Able-Digital-Logic/UnintendedAntennaClub3/Hardware/RFVD_SENSOR_BOARD_Rev6/docs/CRITIQUE_STATUS.md

# Critique status: every P0 and P1 finding (updated 2026-10-04, checkpoint 5 and the placement sign-off)

> Designators in this dated record predate ECO-003 (2026-10-07). Look up the current ones in [`REFERENCE_MAP_ECO-003.md`](REFERENCE_MAP_ECO-003.md).

The critique of 2026-10-03 (19 lenses, every finding independently verified) produced 8 P0 items (critical or high, must be fixed before fab) and 32 P1 items (medium). The goal's first done-criterion: each is **fixed** or **documented** (with a reason and an owner). This table is the single place to check that.

Status words:
- **Done**: fixed and landed on the master, with the checkpoint named.
- **Built**: fixed in a gated scratch package, waiting to land with the named checkpoint.
- **Planned**: assigned to a later package with a defined fix.
- **Documented**: the finding needs no board change, or the decision and its reason are recorded.
- **Lead**: needs a lead action, listed in `LEAD_GUI_STEPS.md` or in the summary.

## P0 (critical / high)

| ID | Finding | Status | Where |
|---|---|---|---|
| P0-1 | JLC BOM/CPL and the DNP flags | **Done** (cp1) | DNP fields cleared; C100/R109 back in the BOM; BOM and CPL regenerated by every `make_outputs.py` run, with JLC rotation corrections |
| P0-2 | Every part in stock for 2 boards | **Done** (cp4a sourcing + cp4b2 consolidation; live check 2026-10-04) + **Lead** (L1 and J8 ordering route) | 100 lines / 309 parts, each with MPN and LCSC. Live stock for 2 boards: 95 lines from JLC assembly stock. J8, OPA2320, AD7380 and the 47R arrays come from LCSC's warehouse via a JLC parts pre-order (5,567 / 1,485 / 78 / 14,550). **L1 XGL4020-472MEC: JLC 1, LCSC 0, not at Mouser**, so only the Global Sourcing route (lead decision 2026-10-04) covers board 2. Evidence: `04_parts/snapshots/jlc_stock_cp5_2026-10-04.json`, `LAYOUT_STATUS.md` cp5 |
| P0-3 | Battery deep-discharge protection | **Done** (docs and firmware) | Mandatory pack spec in J2's Function field and `07_manufacturing/REV_A_PURCHASE_LIST.md`; firmware cut-offs in `05_firmware/FIRMWARE_CONTRACT.md` §5 |
| P0-4 | Overlapping EXP_FAULT_N drills | **Done** (cp1) | |
| P0-5 | Side-aware courtyard exemptions and neck caps | **Done** (rules, cp3; exposed copper, cp4a-cp5) | `dru_sideaware.py` split + `v11_neck_len_*` + `tools/necks.py`. The 115 width + 61 neck errors exposed at cp3 are fixed: DRC 0 errors and 0 neck chains at cp5 |
| P0-6 | EXP_VHP OVLO overlapped VSYS | **Done** (cp2a) | R409 64.9k: trip 9.43–10.28 V, above VSYS 8.77 V (PWM) / 9.05 V (PFM, disabled by firmware) |
| P0-7 | Finish routing; SD skew | **Documented / Lead** (cp5); SD skew **Done** (cp2b) | 524 / 566 routed. The 42 open links have 0 blocked: each has a legal path and a hand-off via in `ROUTING_FINISH_GUIDE.md` §0, for the lead's push-and-shove pass (the footprints are locked) |
| P0-8 | Version control and one master | **Documented / Lead** | Branch `rev-a-layout`, commit `3d8a2bd` (m17). The handoff folder is the master. Each further commit or a remote/push needs the user's OK |

## P1 (medium)

| ID | Finding | Status | Where |
|---|---|---|---|
| P1-1 | Firmware contract rev 2 | **Done** | `05_firmware/FIRMWARE_CONTRACT.md` rev 2; §7 backlight rewritten for the kept CCRs with a VSYS duty cap (2026-10-04). Unused pins: `FIRMWARE_NOTES.md` §2 |
| P1-2 | Return GND vias (R17) | **Done** (cp4a-cp5: failures 45 → 7) + **Documented** | The 7 left are at the dense U8 west row, where no legal GND via site exists (LAYOUT_STATUS cp5) |
| P1-3 | BQ25798 hot loop and GND | **Done** (cp4a, option A / D19) | Hot-loop GND vias at U301; the SYS / PMID 0.1 uF caps sit at the ends of the pin column (`PLACEMENT_DATASHEET_CHECK.md`) |
| P1-4 | Unfused PACK+ run | **Done** (cp4b1, D18) | F1 on its Bourns Style 2 land at J2 ((163.05, 126.80) r90 B); PACK_RAW is a 1.0 mm B-only run with no via. The Style 2 footprint has no 3D model yet |
| P1-5 | BQ29209 Kelvin sense | **Done** (cp2a) | R315 at J2.1; `v10_pack_raw_kelvin` rule; PACK_RAW back in Power_Battery |
| P1-6 | Power copper on In3; VSYS/VBUS necks | **Done** (rules, cp3; copper, cp4a-cp5) | In3 power width rules in v11; battery trunks 0.8 mm on In3; neck chains 46 → 0 |
| P1-7 | Foreign copper under J10; SWD route | **Done** (cp4b4) | The U403 cluster moved to F beside U701 (DRU side-guard patch d9); its nets and SWD left the J10 courtyard: the 32 `items_not_allowed` errors went to 0 |
| P1-8 | MR-kill jumpers short GPIOs | **Done** (cp2b, S-13) | JP401/JP402 and their copper removed; R402/R407 kept |
| P1-9 | Silkscreen labels, board ID, minimums | **Done** (cp1 + cp2b) + **Lead** (GUI row 3) | cp2b: B silk `${ISSUE_DATE}` and a 6 × 4 mm S/N box; all 7 visible texts 1.0 / 0.15. Footprint silk lines stay 0.12 mm (library parity; see P2) |
| P1-10 | Panel, fab spec, fab script | **Done** (2026-10-04) | `tools/make_panel.py`, `tools/make_fab_outputs.py`, `docs/MANUFACTURING_EMC_SPEC.md`, `docs/fab_notes.txt`. JLC panelises only rectangles and round boards, so we supply our own panel. D27: the 72 × 90 mm 1-up frame, because JLC counts the PCBA minimum per panel and the plan is 2 populated boards. Panel DRC 0 new; CPL cross-check 0 mismatches |
| P1-11 | CPL rotations | **Done** (tools) + order-time check | `tools/jlc_rotations.csv` applied by `make_outputs.py` (33 parts corrected); check pin 1 / polarity in JLC's preview with "confirm parts placement" |
| P1-12 | Solder mask 0; J10 pin-in-paste | **Done** (J10 board copy, cp2b; mask 0, cp3) + **Lead** (GUI row 4 mirrors J10 into the library) | |
| P1-13 | Stackup and fab flags | **Done** (fab note on User.Drawings, cp2b; order remarks in `MANUFACTURING_EMC_SPEC.md` §6) + **Lead** (GUI rows 1–2) | |
| P1-14 | Sign-off sentinel | **Done** | H1 assertion sentinel; drcsum flags TRUNCATED at 199 |
| P1-15 | EXP_SYNC class and frequency | **Done** (frequency: FIRMWARE_NOTES §1, R434; class HighSpeed_Clock, cp3; J11-end fix, cp4a) + **Lead** (route: `ROUTING_FINISH_GUIDE.md` §0) | |
| P1-16 | Missing and stale rule areas | **Done** (cp3) | K6, K8, K21, K11 shift, K19a/b, K19c removed |
| P1-17 | AFE shield can | **Documented** (no can on Rev A) + **Done** (D16 GND ring, cp4a) | 1.0 mm F.Cu band under a mask-open strip, 19 fence vias, FL1 on the east wall. The south wall stays open over 5.6 mm (accepted, LAYOUT_STATUS cp5) |
| P1-18 | J1 input limit on record | **Done** (J1 Function field) | The calibration-plan IDs (FW-19b soak, FW-CAL-11 overload) belong to the team's calibration plan, which is not in this repository |
| P1-19 | Edge stitching | **Done** (cp4a) | 31 edge-stitching vias |
| P1-20 | FMC series resistors by pin side | **Done** (cp2b) | RN203 south row, RN201 D0/D1, R213 100R on D/C |
| P1-21 | PSRAM double termination | **Done** (cp2b, S-17) | RN60; SI re-run passes |
| P1-22 | ADC3 re-map, ROM-boot SPI1 | **Done** (cp2a) | R601 10k on PA4; EXP_ANA_MON on PC0 |
| P1-23 | LMR43620 FB detect margin | **Done** (cp2a) | 23.2k/10k |
| P1-24 | Locks before shove routing | **Done** (footprints, cp5) + **Lead** (tracks and vias) | All 341 footprints locked (cp5). Lock the tracks and vias after the hand routing |
| P1-25 | C106/C24 courtyard overlap | **Done** (cp2a) | |
| P1-26 | EXP interrupts without pull-ups | **Done** (cp2b) | R441/R442 10k (Basic) to +3V3_EXP |
| P1-27 | ESD array NC pins block flow-through | **Done** (cp2b), MISO leg documented | 14 NC pins tied, 10 lines straight on B. MISO TVS → R423 0.6 mm and IO0 In3 crossing remain (S-21 optional) |
| P1-28 | Display back-power and C68 | **Done** (cp2a, S-11/S-12) | Firmware sequencing in the contract §7 |
| P1-29 | VSYS divider → BQ ADC; VBAT_RTC | **Done** (cp2a, S-5) + **Lead** (VBAT_RTC route: `ROUTING_FINISH_GUIDE.md` §0) | |
| P1-30 | Runtime target | **Documented** (D26) | The bay limits the pack to 53 × 56 × 9.0 mm, about 27 cm³. A 2S Li-ion pack that size holds roughly 8–12 Wh, so the ≥ 16 Wh option of D26 does not fit. At the 0.96–1.79 W RECORD budget, about 8–9 Wh gives about 5–9 h. **8 h holds only at the low-power end.** Set the formal target after the per-rail measurement on unit 1 (firmware contract: RECORD at 400 MHz VOS1). |
| P1-31 | Display SPI option documented with wrong pins | **Done** (docs, 2026-10-04) | ROUTING_FINISH_GUIDE and LAYOUT_STATUS: SPI marked rejected (D13), correct pins recorded |
| P1-32 | Open routing-guide decisions | **Done** | TP9 deleted (S-10), EXP_ANA_MON on PC0 (S-5), C908 deleted (S-9); pre-defined sizes and the LCD stub rule are in cp3 |

## P2 (low)

The P2 items are polish. Those that come free with the work above are taken there: mask 0, rule housekeeping, silk line width. The rest are listed in the critique synthesis, §2 "P2". Not done, by choice: footprint silk lines stay at the KiCad library's 0.12 mm (JLC's minimum is 0.15 mm). Widening them on the board would break library parity for about 300 footprints. Reference designators are hidden, polarity marks are also on the fab layers, and the CPL is checked in JLC's preview.
