Able-Digital-Logic/UnintendedAntennaClub3/Hardware/RFVD_SENSOR_BOARD_Rev6/docs/DATASHEET_CHECKS.md

# Datasheet checks, Rev A

This file records that every IC and active part on the board has been checked against its manufacturer datasheet. Each row names:
- the document and revision;
- the page, figure or table used;
- what was compared;
- the result.

## How the checks were done
- **Critique, 2026-10-03.** One reviewer per schematic sheet checked each part against the datasheet:
  - every pin against the datasheet pin table;
  - the footprint against the recommended land pattern;
  - every value against the datasheet equations and the application circuit;
  - every rating against the worst case on this board.

  Two more reviews covered the whole board: a pin-map review of U401 against ST's pin database, DS12110 and the IBIS model, and a power-tree review of every rail. Every finding was then re-checked by an independent verifier.
- **Checkpoint 2, 2026-10-04.** Every value the simplifications changed was re-derived from the same datasheet (section 3).
- **Remaining parts.** Connectors J1401/J1101, inductor L1101, fuses F1401/F801, the B3U switches, the RN arrays and the ferrites were checked separately (section 4).
- **What the data is compared against.** Pins and nets come from `kicad-cli sch export netlist`. Pads come from the board file.

"Pass" means the item matches the datasheet. Findings carry their critique ID and say where they went (fixed in a checkpoint, firmware contract, lead decision).

The basis is checkpoint 2b (landed 2026-10-04, board sha256 `f539f0317c`). Rows that changed in 2b say so, and section 5 checks the parts 2b added.

## 1. Summary

| Sheet | Parts checked | Wrong pin maps | Wrong land patterns | Rating problems |
|---|---|---|---|---|
| RF input and detector | U701, U702, FL701, D701, D702, J702, J701 | 0 | 0 | J702 input limit (lead decision D17) |
| Battery and power | U1301, U201, L1301, FB1301 | 0 | 0 | 0 |
| Analog acquisition | U502, U501, U503, D1001 | 0 | 0 | 0 |
| External ADC | U1001 | 0 | 0 | REFIO contention, removed by S-26 |
| STM32H743 controller | U401, Y401, Y402 | 0 | 0 | 0 |
| SD and capture memory | J601, U602, D4–D10 | 0 | 0 | 0 |
| Screen and controls | J801, J802, U801, Q802–Q803, D801–D804, RN801–RN803 | 0 | 0 | 0 |
| Battery, charger and USB-C | U1101–U1102, Q1402–Q1401, D1101, F1401, L1101, J1401, J1101 | 0 | 0 | see section 4 |
| Expansion mezzanine | J1201, U1501–U1201, D1201–D1204 | 0 | 0 | U1502 OVLO, fixed in checkpoint 1 |
| Temperature monitor | U302, U301, U702@pre-ECO003 | 0 | 0 | 0 |
| Programming and service | J901, SW801–SW1101 | 0 | 0 | B3U minimum current (S-16) |

Placement against each datasheet's layout guide is checked separately, on the board itself: `docs/PLACEMENT_DATASHEET_CHECK.md` (generated by `tools/dsgap.py`). It found 269 budgets, 264 within budget and 5 over with measured reasons.

No pin-map error was found on any part. All functional defects found against the datasheets are listed in section 2 with their fix.

## 2. Per-sheet records

### RF input and detector
| Ref | Part | Datasheet | Checked | Result |
|---|---|---|---|---|
| U702 | ADL5511ACPZ-R7 | ADI ADL5511 Rev D: Table 3 p.8 (pins), CP-16-22 p.27 (package), Fig. 49 and Table 5 (decoupling); Rev E Table 3 p.8 (ENBL ramp) | Pins 1–16 + EP: FLT3=1, RFIN=2, FLT1=3, ENBL=4, COMM=5, NC 6/7/8/12/13 open, EREF=9, VENV=10, VRMS=11, FLT4=14, VPOS=15, FLT2=16, EP=GND. RFIN AC-coupled on both paths (C708; C707 behind R701). FLT1 (C703) returns to GND; FLT2/3/4 (C705/C706/C710) return to VPOS. VPOS has 100 pF + 100 nF + 1 µF. VPOS = 4.99 V (LT3045, R203 49.9k) is inside 4.75–5.25 V. | Pass |
| U701 | TLV809EA46DBZR | TI TLV809E §5 (DBZ pinout), §7.5 (VIT-, delay, VOH) | DBZ pinout 1 GND, 2 RESET, 3 VDD matches symbol and SOT-23-3. Push-pull output, 200 ms delay, VIT- 4.63 V. VOH ≥ 0.8·VDD meets ENBL ≥ 3.6 V and ENBL ≤ VPOS. | Pass. U701 stays: ADL5511 Rev E Table 3 p.8 needs a < 20 ms ramp if ENBL is tied to VPOS, and the LT3045 rail takes about 55 ms (S-1 rejected). |
| D701, D702 | PESD5V0H1BSF | Nexperia PESD5V0H1BSF §12, Fig. 14 | Land 0.20 × 0.28 mm at 0.4 mm pitch, 0.256 mm paste | Pass |
| FL701 | NFM18PC104R1C3D | Murata NFM18PC | 16 V / 2 A rating against +5V_RF (about 25 mA) | Pass |
| J702, J701 | U.FL-R-SMT-1(80) | Hirose U.FL | Footprint and signal/ground pads | Pass |
| R703, R704 | 0402 attenuator | — | 50 mW each at +20 dBm CAL input, against a 100 mW rating | Pass |

**Findings**
- RF-01: the input limit is set by R706/R702 dissipation, at about 29.5 Vpk CW. The ADL5511 RFIN absolute maximum is reached at about 38.9 Vpk. **Lead decision D17:** the input limit is 22 Vpk CW at 128 MHz with no 40 Vpk soak, labelled model-derived until bench test X10.
- AIMD/CAL silkscreen labels were added in checkpoint 1.

### Battery and power
| Ref | Part | Datasheet | Checked | Result |
|---|---|---|---|---|
| U1301 | LMR43620MB5RPER | TI SNVSBY5B Rev B: Table 6-1 (pins), RPE0009B land p.51, Eq. 5 and Eq. 9, Table 9-1 | **Pins:** match Table 6-1.<br>**Footprint:** TI_RPE0009B matches the p.51 land (pin-1 L-pad, GND bar offset 0.55 mm, pin centres ±0.9 mm).<br>**Feedback (checkpoint 2a, P1-23 / D24):** R1301/R1302 = 23.2k/10k → 3.320 V. RFBT‖RFBB = 6.99 kΩ, mid-window of the 5–10 kΩ detection window; the old 33.2k/14.3k sat at its 10 kΩ edge. CFF C41 22 pF puts the zero at 312 kHz, which satisfies Eq. 9.<br>**Supporting parts:** CBOOT 100 nF 25 V. CVCC 1 µF. EN tied to VIN and PGOOD open are both allowed by Table 6-1.<br>**Timing and capacitors:** fSYNC 833 kHz is inside 0.2–2.5 MHz, with no spread spectrum on MB5. tON at 8.4 V is about 474 ns, against a 75 ns minimum. Input 2 × 10 µF + 100 nF, against a 4.7 µF minimum. Output 2 × 22 µF. | Pass |
| L1301 | XGL4020-472MEC | Coilcraft Doc 1529-1 | 4.7 µH. Ripple 0.38–0.51 A is 19–26 % of 2 A, above the 10 % floor. Isat 3.0 A (the old note said 4.8 A; corrected). | Pass. JLC does not stock it; bought by Global Sourcing (lead decision 2026-10-04). |
| U201 | LT3045EMSE#PBF | ADI LT3045 Rev B: Pin Functions, p.18 | **Pins:** match the MSE-12 Pin Functions table.<br>**Output and limit:** 100 µA × 49.9k = 4.99 V. ILIM 1k sets 150 mA.<br>**PGFB tied to IN:** allowed.<br>**Capacitors:** output ≥ 10 µF low-ESR. Input meets the 4.7 µF minimum. R201 1 Ω falls in the p.18 0.1–0.5 Ω stabiliser range. The SET capacitor C510 is film, which avoids the piezo effect described on p.18.<br>**Load:** about 25 mA on +5V_A, about 0.1 W dissipation. | Pass |
| FB1301 | BLM18AG601SN1D | Murata BLM18AG | 500 mA, DCR 0.38/0.48 Ω, against the +3V3_A load of about 20 mA | Pass (section 4 repeats it with loads) |

**Findings**
- PWR-01: fitted C1315/R1307 were missing from the JLC BOM. Fixed in checkpoint 1.
- L1301 and U1301 stock: Global Sourcing (lead decision).
- C27 VSYS polymer deleted: S-8, checkpoint 2a.
- Stale sheet notes are still open on the 2a candidate: Power says "1 MHz forced PWM", "L1301 saturation 4.8 A at 20%" and "charger is external". They are fixed in the notes package after 2b (section 6).

### Analog acquisition
| Ref | Part | Datasheet | Checked | Result |
|---|---|---|---|---|
| U502, U501 | OPA2320AIDGKR | TI SBOS513F: p.5 (DGK pinout), §7.3.2 (input current), §7.3.7 (Ro 90 Ω), §7.3.8 (cap load) | **Pins:** 1–8 match DGK on a VSSOP-8 footprint.<br>**Stability:** macro-model (20 MHz GBW, Ro 90 Ω) with the real loads gives 61–67° phase margin. The same model gives 9–17° for a bare 1 nF, matching §7.3.8.<br>**Input current with +3V3_A off:** < 1 mA through 4.52k, against the 10 mA absolute maximum.<br>**Checkpoint 2a (S-27):** U3B drives EREF_BUF; U3A is a follower on EREF_FILT (both +IN on R506 22.6k / C506 10 nF, a 704 Hz pole). The input stays inside the rail-to-rail common-mode range. | Pass |
| U503 | REF5030IDR | TI SBOS410O (Oct 2025): Fig. 5-1, §8.3.6, §8.4.1, §9.4.1.1 | **Pins:** DNC 1/8 and NC 7 open, TEMP open, TRIM/NR to the 1 µF film C510.<br>**Input:** VIN 5 V ≥ VOUT + 0.2 V; C509 1 µF + C508 100 nF.<br>**Output:** C511 4.7 µF via R508 1 Ω (ESR ≤ 1.5 Ω per §8.4.1). The HF capacitors are allowed by §9.4.1.1.<br>**Limit:** VREF+ 3.0 V ≤ VDDA 3.3 V. | Pass. Original kept, bought by Global Sourcing. |
| D1001 | PMEG6030EP | Nexperia PMEG6030EP (Nov 2017), Table 7 | K on +3V3_A, A on +3V0_REF. VF ≤ 330 mV at 0.1 A, so VREF+ − VDDA stays at or below about 0.3 V. | Pass |
| Filter | R501/R502/R503/R504, C501/C503/C502 and VENV chain | — | Unity-gain Sallen-Key, 2.26k/2.26k with 510 pF/470 pF, then 1.33k/1.33k with 1.2 nF/470 pF: f0 143.8 kHz Q 0.521 and 159.3 kHz Q 0.799. −3 dB at 99.4 kHz, −36.0 dB at 416.7 kHz, 0.84 % overshoot. | Pass. C501 stays at 510 pF (lead decision). |
| ADC pins | R507/R505 33 Ω, C507/C505 2.2 nF C0G | STM32 DS12110 | PC4 = ADC12_INP4, PA6 = ADC12_INP3, so ADC1/ADC2 can convert simultaneously. τ = 72.6 ns; all four RC branches identical (S-3, checkpoint 2a). | Pass |

### External ADC
| Ref | Part | Datasheet | Checked | Result |
|---|---|---|---|---|
| U1001 | AD7380BCPZ-RL7 | ADI AD7380/AD7381 Rev A (11/2019): Fig. 8 / Table 7 p.9 (pins), CP-16-45 p.31 (package), Table 7 / Fig. 31 (decoupling), Table 3 (common-mode), Tables 4 and 12 (timing) | **Pins:** 1 GND, 2 VLOGIC, 3 REGCAP, 4 VCC, 5 AINB-, 6 AINB+, 7 AINA-, 8 AINA+, 9 REFCAP, 10 GND, 11 REFIO, 12 CS, 13 SDOA, 14 SDOB/ALERT (open), 15 SDI, 16 SCLK, EP 17 = GND.<br>**Footprint:** custom TQFN-16, counter-clockwise from pin 1. 0.5 mm pitch, 0.25 mm pads, 1.23 mm EP land (EP 1.10 nom / 1.20 max), about 66 % paste.<br>**Decoupling:** REFIO 1 µF, REFCAP 0.1 µF, REGCAP 1 µF; VCC and VLOGIC 1 µF each.<br>**Inputs:** common mode about 0.55 V on channel A and 1.1–2.1 V on channel B, inside 0.2 V to VREF − 0.2 V.<br>**Timing:** 1-wire mode with CRC, 40–44 SCLK at 40 MHz = 1.0–1.1 µs inside the 1.2 µs frame. | Pass |

**Findings**
- EXTADC-01: REFIO contention. The internal 2.5 V buffer fought the REF5030 through 33 Ω until firmware set REFSEL. **Removed by S-26 (lead decision D5), checkpoint 2a:**
  - the AD7380 uses its internal reference: R107 and TP20 deleted, R1006 = 100 Ω;
  - firmware REFSEL = 0 (FIRMWARE_CONTRACT §3);
  - the VENV range becomes ≤ 2.5 V, which still covers 14 Vpk at J702.
- R105 deleted (S-4); firmware sets IOSWP = 1 for the swapped SPI4 pins.
- R1007 placement at SDOA: P2 EXTADC-03, a routing package.

### STM32H743 controller
| Ref | Part | Datasheet | Checked | Result |
|---|---|---|---|---|
| U401 | STM32H743VIT6 | ST DS12110 Rev 10/11: Fig. 5 (LQFP100), Table 9 note 8, Table 23 note 4, Table 25 (VCAP), Fig. 15 (decoupling), Fig. 23 (NRST), Fig. 42 (VDDA/VREF+), Table 42 (HSE bypass), Table 45 (LSE), AF tables; ST pin database XML; IBIS | **Pins:** all 100 match. LQFP100 has no VDDLDO/VDD33USB/PDR_ON pins (tied internally).<br>**Decoupling and reset:** five VDD pins with 100 nF + bulk. VCAP 2 × 2.2 µF. VDDA and VREF+ each 100 nF + 1 µF. NRST 100 nF at 0.92 mm. BOOT0 10k at 0.10 mm.<br>**Peripherals:** every peripheral pin has its alternate function: FMC, SPI4 (IOSWP), SDMMC1, QUADSPI BK1, OTG_FS, I2C1/I2C2.<br>**Timer:** TIM1 at 240 MHz / 288 gives 833.33 kHz for both CS and BUCK_SYNC. | Pass |
| Y401 | ASE-12.000MHZ-LC-T | Abracon ASE | Pad map 1 OE (tied to +3V3_D), 2 GND, 3 OUT, 4 VDD matches the land. Bypass drive to PH0 through 33 Ω; 4–50 MHz allowed by Table 42. | Pass |
| Y402 | SC-16S 32.768 kHz 7 pF | SII SC-16S | CL 7 pF, R706 ≤ 90 kΩ, C0 1.2 pF. gm_crit = 1.03 µA/V needs LSEDRV = 10 (1.7 µA/V, Table 45); set in FIRMWARE_CONTRACT §1. Pads match; no foreign B.Cu copper under it. | Pass |

**Findings**
- PE15/PH1 MR-kill jumpers short GPIOs to GND: S-13, deletes JP401/JP402 **(done in checkpoint 2b)**.
- Firmware assumptions were collected into FIRMWARE_CONTRACT rev 2: clock tree, LSEDRV, IOSWP, REFSEL, USB sequencing.
- EXTI3 clash between RECORD_N and LID_INT: removed by S-24, LID_INT deleted **(done in checkpoint 2b)**.
- EXP_ANA_MON moved from PA4 to PC0, with a PA4 10k pull-up R403 (S-5 / P1-22, checkpoint 2a).

### SD and capture memory
| Ref | Part | Datasheet | Checked | Result |
|---|---|---|---|---|
| J601 | DM3AT-SF-PEJM5 | Hirose DM3AT drawing, item 5 | Pinout and card detect (normally open; DET_B to SD_CD_N with a 10k pull-up, DET_A to GND) | Pass |
| U602 | APS6404L-3SQR-SN | AP Memory APS6404L Rev 2.7 (Jan 2024): §4 (pins), §8 (CE#), §9.3 (drive), §16.4 (decoupling) | **Pins:** 1 CE#, 2 SIO1, 3 SIO2, 4 VSS, 5 SIO0, 6 SCLK, 7 SIO3, 8 VDD.<br>**CE#:** pull-up R604 meets §8.<br>**Decoupling:** 1 µF + 100 nF.<br>**QUADSPI BK1:** PB2/PB6/PD11/PD12/PE2/PD13. | Pass |
| D4–D10 | PESD5V0U1UL | Nexperia PESD5V0U1UA_UB_UL | Pin 1 cathode on SOD-882 pad 1; 5 V VRWM; 2 pF typ / 2.6 pF max | Pass **(2b: S-19 may replace them)** |

**Findings**
- U602 sourcing: the LCSC page showed "Not available now" on 2026-10-03. It goes in the sourcing package.
- PSRAM double series resistors: S-17 **(done in checkpoint 2b)**.
- SD front end: S-19 / D7 **(done in checkpoint 2b)**.
- SD card power switch: deferred to Rev B (D8).

### Screen and controls
| Ref | Part | Datasheet | Checked | Result |
|---|---|---|---|---|
| J801 | XF2M-4015-1A + NHD-2.4-240320AF-CSXP-CTP | NHD spec Rev 4 (04/23/2026): p.4 (pins), p.5 (interface select), p.6 (8080 wiring); Omron XF2M | **Panel pins:** 1 GND; 7/8 VDD/VDDI on +3V3_UI; 10–13 CSX/DCX/WRX/RDX; DB0–DB7 to GND and LCD_D0–D7 on DB8–DB15 (pins 22–29); 30 RESX; IM2..0 = 0/0/1 (8-bit 8080-II); 34–37 LED-K; 38 LED-A; 40 TE.<br>**Land:** A = 19.5 mm, pads 0.25 × 1.1 mm, hold-downs 21.1/24.5 mm. | Pass |
| J802 | 84953-6 (CTP) | NHD CTP table | VDD, VSS, SCL, SDA, /INT, /RESET; 4.7k I2C pull-ups as NHD requires; separate I2C2 bus (an unpowered FT5426 would clamp I2C1) | Pass |
| U801 | TPS2553DDBVR | TI SLVSDL7 | DBV pinout: IN1, GND2, EN3 active-high, FAULT4, ILIM5, OUT6. ILIM 66.5k → 355/397/445 mA. | Pass |
| Q802–Q803 | AO3401A / 2N7002 / AO3400A | AOS, onsemi | SOT-23 G/S/D mapping | Pass. Q803 stays (S-15 not taken, D1001 fallback). |
| D801–D804 | NSI45020AT1G | onsemi NSI45020/D Rev 7 | SOD-123 polarity: pad 1 = cathode to LCD_BL_SW | Pass. Kept (S-15 not taken, D1001 fallback). Thermal check against SC-10 is in section 4. |
| RN801–RN803 | 4D02WGJ0470TCE | UniOhm 4D02 | see section 4 | — |

**Findings**
- LED-01: CS/WR/RD pull-ups back-powered the switched +3V3_UI. Fixed by S-11 (checkpoint 2a): R50 and R203@pre-ECO003 deleted, RDX tied to +3V3_UI, R204/C204@pre-ECO003 deleted. UI-off pin states are in FIRMWARE_CONTRACT §7.
- C68 47 µF deleted: S-12, checkpoint 2a.
- TP_RST pull-down R214 added: SC-05, checkpoint 2a.
- RN stub lengths (RN801/RN803 group pins from different LQFP sides): RN regroup **(done in checkpoint 2b)**.

### Battery, charger and USB-C
| Ref | Part | Datasheet | Checked | Result |
|---|---|---|---|---|
| U1101 | BQ25798RQMR | TI SLUSDV2C (Jun 2026): Table 5-1, §6.3, Table 7-1, §7.3.9.5.1, eq. (1), §8.2.2.2, Fig. 7-15 | **Pins:** VAC1/VAC2 to VBUS and ACDRV1/2 to GND (no ACFETs). QON to SW1101. CE held low (R1111). STAT 10k to REGN. INT 10k to +3V3_D. BATP via 100 Ω (Fig. 7-15).<br>**Capacitors:** BTST 47 nF. REGN 4.7 µF. VBUS 2 × 10 µF + 0.1 µF. PMID 3 × 10 µF + 0.1 µF. SYS 5 × 10 µF + 0.1 µF. BAT 2 × 10 µF. All meet §6.3.<br>**Configuration:** PROG 6.04k selects 2S at 1.5 MHz. TS 5.23k/30.1k. ILIM_HIZ 1.408 V gives a 510 mA clamp (440–581 mA over REGN tolerance). L1101 1 µH per §8.2.2.2.<br>**Footprint:** identical to KiCad RQM0029A. | Pass |
| U1401 | BQ29209DRBR | TI SLUSA52C: DRB pinout, Fig. 9 | **Pins:** 1 VC2, 2 VC1, 3 VC1_CB, 4 CD, 5 GND, 6 CB_EN, 7 VDD, 8 OUT, PAD.<br>**Values:** match Fig. 9 (160 Ω, 261 Ω, 100 Ω, 100 Ω, 0.1 µF, 0.1 µF, 0.33 µF → 3 s delay).<br>**CB_EN:** active low; R1408 470k against 0.2 µA.<br>**Land:** EP 1.65 × 2.4 matches DRB0008B. | Pass |
| U1402 | TPS70933DBVR | TI SBVS186H p.3 | IN1/GND2/EN3/NC4/OUT5. EN may float (300 nA pull-up). C1410 4.7 µF meets the 1.5 µF effective minimum. | Pass |
| U1102 | TPD4E05U06DQAR | TI SLVSBO7O (Aug 2024), Table 4-2 | DQA pinout | Pass |
| D1101 | TPD1E10B06DYAR | TI SLLSEB1G | VBUS TVS at the first VBUS via (checkpoint 1) | Pass |
| Q1402 | AO3400A | AOS AO3400A | Ship FET with source on BAT, so the body diode blocks pack-to-system leakage. Vgs about 5 V, against ±12 V. | Pass |
| Q1401 | AO3401A | AOS AO3401A | Reverse-polarity FET orientation correct. Vgs −8.4 V, against ±12 V. | Pass |
| Q1403 | 2N7002 | onsemi | SOT-23 G/S/D | Pass |
| CC | Rd 5.23k 1 % | USB Type-C spec | Inside the 5.1k ± 10 % Rd window | Pass |

**Findings**
- CHG-01: unfused PACK+ on In3. Checkpoint 1 regrouped F1401/Q1401 (placement B2). P1-4 / D18 moves F1401 to J1401.1, which shortens the unfused run; still open.
- CHG-02: cell 2 reads high while charging. It is part of the battery-sense routing package.
- Battery protection: a 2S pack with an integrated per-cell PCM is mandatory (D701 / P0-3).
- Firmware: VAC_OVP, ship mode, SFET_PRESENT and BC1.2 sequencing are in FIRMWARE_CONTRACT §5–6.
- D3/R19 charge LED deleted: S-7, checkpoint 2a.
- VBUS_DET network deleted: S-6, checkpoint 2a.
- C1101 DNP flag set: checkpoint 1.

### Expansion mezzanine
| Ref | Part | Datasheet | Checked | Result |
|---|---|---|---|---|
| J1201 | LSHM-120-02.5-L-DV-A-N-K-TR | Samtec LSHM spec + footprint print | Symbol-to-footprint map; footprint identical to KiCad's stock part | Pass |
| U1501 | TPS2553DDBVR | TI SLVSDL7 | ILIM R1503 45.3k → 524/577/638 mA | Pass |
| U1502 | TPS259631DDAR | TI SLVSET8A: Eq. 4, Eq. 5, OVLO | ILIM R1513 1.50k → 0.613 A (Eq. 5). dV/dt C1508 47 nF → 0.89 V/ms (Eq. 4). OVLO: R1512 64.9k, above VSYS in PFM. | Pass after checkpoint 1 (P0-6) |
| U1201 | TCA9517ADGKR | TI SCPS245E | Pinout; EN has an internal pull-up | Pass **(2b: S-20 ties EN to VCCB)** |
| D1201–D1204 | TPD4E05U06DQAR | TI SLVSBO7O | DQA pinout. NC pads tie to the line net for flow-through (P1-27). | Pass **(2b: P1-27 / S-21)** |

**Findings**
- EXP-01: the OVLO sat inside the VSYS range. Fixed in checkpoint 1 (R1512 73.2k → 64.9k).
- MR-kill jumpers: S-13 **(done in checkpoint 2b)**.
- EXP_SYNC moves to 2.400 MHz (D21, FIRMWARE_NOTES §1).
- EXP_INT pull-ups: P1-26 **(done in checkpoint 2b)**.
- R405@pre-ECO003/R406@pre-ECO003 source select merged into copper: S-14, checkpoint 2a.
- Resistor arrays: S-22 **(partly done in checkpoint 2b)**: RN1201 replaces R428/R429/R430/R432. The CS0/CS1/RST and 100k arrays would need new vias at the ESD entry, so they were left out (EMC first).

### Temperature monitor
| Ref | Part | Datasheet | Checked | Result |
|---|---|---|---|---|
| U302 | TMP117AIDRVR | TI SNOSD82D: Fig. 5-1 p.4, §8.2.1, §9–10.1 p.35–36 | Pins; EP unsoldered (no paste, no net) per §9/10.1; ALERT may float; ADD0 = GND → 0x48; pull-up 4.7k > 2k minimum | Pass |
| U301 | SHT40-AD1B-R702 | Sensirion SHT4x v6.5: Fig. 17 (land), Fig. 18 p.16 (pins), §5.3 | Land 0.5 × 0.3 mm pads, 1.4 mm span, 0.8 mm pitch. Address 0x44. Pull-up > 390 Ω. | Pass |
| U702@pre-ECO003 | OPT3004DNPR | TI SBOS929A: Fig. 6-1 p.3, Table 6-1; DNP0006A | Land 0.5 × 0.25 mm pads, 1.9 mm span, EP 0.65 × 1.35 mm. ADDR = VDD → 0x45. | Pass **(2b: S-24 removes LID_INT)** **Removed at checkpoint 4b2 (BOM study DIS-1):** the lid-light wake became a button/USB wake in firmware; FIRMWARE_CONTRACT §11. |

**Findings**
- The I2C addresses do not collide: 0x44, 0x45, 0x48, plus BQ25798 at 0x6B.
- SHT40 heater: allowed only in SERVICE mode (FIRMWARE_CONTRACT).
- Copper under the SHT40: clear In3 only (D28), a routing package.

### Programming and service
| Ref | Part | Datasheet | Checked | Result |
|---|---|---|---|---|
| J901 | TC2030-NL pads (DNP) | Tag-Connect TC2030-CTX | 1 VCC, 2 SWDIO, 3 NRST, 4 SWCLK, 5 GND, 6 SWO; maps 1:1 onto the ARM Cortex-10 / STDC14 cables. Footprint is the stock KiCad part (2 × 3 pads at 1.27 mm, 3 NPTH 0.99 mm). | Pass |
| SW3, SW4 | B3U-1000P | Omron B3U; DS12110 Fig. 23; AN2606 Rev 61 Table 113 | NRST 100 nF + 10k pull-up. BOOT0 = 3.0 V when pressed, against VIH min 1.16 V. The DFU path uses HSI48 with CRS, so it does not depend on Y401. | Pass **(2b: S-16 removes SW4 and R801@pre-ECO003)** |

**Findings**
- SVC-01: SWD under J1101. Routing package P1-7.
- SWO dropped: S-18 **(done in checkpoint 2b)**.
- The programming cable is TC2030-CTX for ST-Link, not TC2030-IDC.

## 3. Values changed in checkpoint 2a, re-derived from the datasheets

| Item | Old → new | Datasheet basis |
|---|---|---|
| U1301 feedback R1301/R1302 (P1-23, D24) | 33.2k/14.3k → 23.2k/10k | SNVSBY5B Eq. 5: 1.00 V × (1 + 23.2/10) = 3.320 V. RFBT‖RFBB = 6.99 kΩ inside 5–10 kΩ. CFF 22 pF → zero at 312 kHz (Eq. 9). |
| AD7380 reference (S-26, D5) | REF5030 via R107 33 Ω → internal 2.5 V | AD7380 Rev A Table 7: REFIO 1 µF (C1006) kept. REFSEL = 0 in firmware. VENV full scale 2.5 V. |
| EREF chain (S-27, D6) | 4th-order Sallen-Key → one pole | R506 22.6k, C506 10 nF C0G: 1/(2π·22.6k·10n) = 704 Hz. U3B unity-gain driver; U3A follower on the same node (SBOS513F common-mode range includes it). |
| ADC RC (S-3) | R507/R505 → 33 Ω; C507/C505 → 2.2 nF C0G | τ = 72.6 ns, the same as the AD7380 branches. The 2.2 nF is about 147× the 15 pF sampling capacitor. |
| R803 (S-25) | 66.5k 1 % → 100k 0.1 % | U801 display-branch current limit, SLVSDL7 §9.5.1 Eq. 1 (valid for 15k–232k): I<sub>OS</sub> 234 / 266 / 303 mA min / nom / max. The +3V3_UI load is logic only: panel and touch I<sub>DD</sub> ≤ 38 mA, because the backlight runs from VSYS. |
| U1502 OVLO R1512 (P0-6) | 73.2k → 64.9k | SLVSET8A Eq. 2: V<sub>OV</sub> = 1.20 V × 534.9k / 64.9k = 9.89 V nominal. Worst case 9.43–10.28 V, with V<sub>OVLO(R)</sub> 1.17–1.22 V, 1 % resistors and ±0.1 µA pin leakage; release 8.70–9.53 V. The trip sits above the 8.77 V PWM VSYS maximum (SLUSDV2C) and the 9.05 V PFM level; firmware sets PFM_FWD_DIS. |

**Independent verification of checkpoint 2a (2026-10-04).** A separate reviewer re-ran the netlist, ERC, DRC and copper-island checks and read each datasheet again:

| Change | Datasheet evidence | Result |
|---|---|---|
| AD7380 internal reference | Rev A Table 7 (p.9) and Fig. 31 (p.17): REFIO 1 µF to GND for both reference modes; REFCAP 0.1 µF; REGCAP, VCC and VLOGIC 1 µF each | ADC_REFIO is only U1001.11 + C1006 1 µF 25 V X7R. Pass. |
| R1006 100R on AINB− | Table 5 (p.8): input absolute maximum is V<sub>REF</sub> + 0.3 V = 2.8 V. U501 can reach about 3.29 V, so the current is 4.9 mA (it was 14.8 mA with 33R, against a ±10 mA limit). p.15 asks for matched source impedance. | Pass. The 100R / 33R mismatch leaves about 70 ppm of the sampling kick after 4.6 τ at 833 kS/s (about 2 LSB, deterministic). The CAL_IN bench gate covers it. |
| EREF one pole (U502) | OPA2320 SBOS513 §7.3.7–7.3.8 (pp.18–19): about 90 Ω open-loop output resistance; 10–20 Ω isolation recommended above 1 nF | U3B drives 16.5 Ω (33R ‖ 33R) into 4.4 nF. About 50° phase margin (estimate). No floating input, no shared outputs. Pass. |
| Buck FB 23.2k/10k | LMR43620 SNVSBY5B §9.2.2.2.1 Eq. 5: 5 kΩ < RFBT ‖ RFBB ≤ 10 kΩ | 3.32 V (3.24–3.40 V); 6.99 kΩ, mid-window. The old 9.995 kΩ sat at the limit. Pass. |
| C27 removed | LT3045 Rev B p.18: ≥ 4.7 µF at IN; 0.1–0.5 Ω series resistance stabilises the input | C202 10 µF (about 5 µF effective at 8.4–9.1 V) behind R201 1 Ω. Pass. C202 → 25 V part goes to the sourcing package. |
| Top-cell Kelvin sense | BQ29209 SLUSA52C Fig. 9 (p.13), §11.1 (p.15) | R1404 taps J1401.1 ahead of F1401/Q1401; pack current leaves the same pad at the opposite corner. Pass. The net-class slip found here (PACK_RAW in Default) was fixed before landing. |
| Display straps and RDX | NHD-2.4-240320AF p.5 (8080-II: IM0 = 1, IM1 = IM2 = 0), p.3 pin list; ST7789V p.34 "if not used, fix at VDDI" | J801.31 to +3V3_UI, J801.32/33 to GND, J801.13 RDX to +3V3_UI, DB8–15 = LCD_D0–7. Pass. |
| Touch reset R214 | FT5x26 §3.5: reset held low before power-on | 100k pull-down 1.85 mm from J802.6, with a GND via in its pad. Pass. |

## 4. Parts checked outside the critique

Separate check, 2026-10-04. Datasheets, text extracts and calculations are in the session work folder `rw/dscheck/` (`calcs.py` reproduces every number). Molex, ADI and onsemi block scripted downloads, so those values were read in a browser and transcribed (`browser_viewed_extracts.txt`). **Every pin map passes.**

| Ref | Part | Datasheet | Checked | Result |
|---|---|---|---|---|
| J1101 | HRO TYPE-C-31-M-12 | HRO drawing 2020-12-08 rev A (LCSC C165948) | Pin table vs netlist (GND, VBUS, SBU NC, shell, D+/D− joined across rows, CC1/CC2 each with 5.23k Rd); land; position against the board edge; 5 A / 20 V rating | Pins pass. Land: low deviations (the stock footprint follows HRO's 2018 sheet; inner-tail margin 0.025 mm). **Board edge: MEDIUM.** HRO puts the PCB edge 5.79 mm from the locating-hole line and the receptacle face 6.28 mm from it (0.49 mm overhang). Here the edge is 6.75 mm away, so the board sticks out about 0.47 mm past the receptacle face, and the plug overmould can hit it before full mating. Fix: section 7. |
| J1401 | Molex 2053380004 (Pico-Lock 2.0) | 2053380000-SD rev B; 2053410000-PS | Pin 1 at the triangle (PS p.11) = PACK_RAW, 2 BATT_MID, 3 GND, 4 NTC; land exact (1.1 × 1.45 pads, 2.0 pitch; nails 1.35 × 2.9); 3.0 A/pin at #26 AWG (PS p.4) against a 1.8–2.4 A schematic upper bound | Pass. **Note 4 "no pattern under the housing": medium → resolved.** 19 vias, 9 B tracks and the GND pour sit under the housing, and pads 2 and 3 each hold a via. All vias are IPC-4761 type VII (resin-filled and copper-capped), which is the datasheet-safe option, and the tracks are masked. Specify #22 AWG or heavier pack wire (pack spec). |
| L1101 | Coilcraft XAL4020-102MEC | Doc 806-1/806-4 (02/25/26); TI SLUSDV2C §8.2.2.2 | 1.0 µH, DCR 14.6 mΩ max, Isat 8.7 A (30 % drop), Irms 6.7 A; land exact (0.98 × 3.4 at 2.37 mm); boost peak 1.91 / 2.91 / 4.21 A at 0.51 / 2 / 3.3 A input limit (TI Eq. 4) | Pass (≥ 2.1× to Isat). Low: no start-lead mark (same for L1301). Coilcraft wants the high-dv/dt node (SW802, pad 2) on the marked lead, so add an assembly note. |
| F1401 | Bourns MF-MSMF150/24X | MF-MSMF pp.2, 5, 7, 10 | 24 V / 20 A fault; hold 1.50 A (1.13 A at 50 °C, 1.00 A at 60 °C), trip 3.00 A; land | Ratings pass for the 8.4 V pack. Hold: the charge current (1 A) holds to 60 °C. The realistic discharge (≤ 1.79 W RECORD + ≤ 2.14 W shield + ≤ 0.6 W backlight ≈ 0.75 A at 6 V) holds at 50 °C. **Land: MEDIUM.** The pads are 1.125 × 3.4 mm, while Bourns Style 2 wants 1.68 × 2.95 mm (the gap is fine). Fix: section 7. If the bench pack current exceeds about 1 A, use MF-MSMF200/16X (same body, hold 2.0 A). |
| F801 | BHFUSE BSMD0603-020-16V | Revision 2022 pp.1, 4, 6 | Hold 0.20 A (0.12 A at 60 °C), trip 0.50 A, 16 V, 0.55–3.5 Ω; backlight 72–88 mA | Pass to 70 °C. Low: land 0.875 × 0.95 / 0.70 gap vs 1.00 × 1.00 / 0.80. Datasheet field is "None": notes package. |
| SW801–SW1101 | Omron B3U-1000P | A162-E1-07 pp.1–2 | Two-terminal NO; land at the tolerance limit (0.9 × 1.7 vs 0.8 × 1.7 ± 0.1); rated 1–50 mA, minimum applicable load 10 µA | Pass. Low: every switch runs between 16 µA and 0.44 mA, below the 1 mA rating floor but above the 10 µA minimum load. Accepted. Optional: R44/R49 3.3k with 330 nF. |
| RN801–RN803 | UniOhm 4D02WGJ0470TCE | JLC-01-015 ed.1 pp.4–5 | Element k between pins k and 9−k; terminal widths 0.40/0.30, pitch 0.50, body 2.0 × 1.0 | Pass (pins; the land is unconfirmable because UniOhm publishes none, and it matches the ROHM MNR04 basis) |
| FB1301, FB801 | Murata BLM18AG601SN1D | JENF243A-0003AC-01 p.2 | 500 mA, DCR ≤ 0.38 Ω; +3V3_A load about 14 mA, backlight ≤ 88 mA | Pass (36× and 5.7× margin) |
| D801–D804 | onsemi NSI45020AT1G | NSI45020A/D Rev 7 (p.3 thermal table, Figs 2–6 p.4) | Worst case 6.02 V × 22 mA = 132.5 mW per device; θJA 600 / 360 / 270 °C/W at 100 / 300 / 500 mm²; headroom at low VSYS | **MEDIUM.** The device has bare pads only (no pour), which is below the smallest characterised copper, so Tj cannot be confirmed at 100 % duty. ≤ 125 °C needs θJA ≤ 642 °C/W; otherwise the duty cap is 642 / θJA. Fix: section 7. Low VSYS: at 5.0 V worst case the current reaches about 73 % (dims about a quarter); it regulates from about 5.5 V. Datasheet field → NSI45020A/D (notes package). |

## 5. New parts in checkpoint 2b (landed 2026-10-04, board sha256 `f539f0317c`)

| Ref | Part | Datasheet | Checked | Result |
|---|---|---|---|---|
| U601 | ST EMIF06-MSD02N16 (LCSC C5267594) | ST EMIF06-MSD02N16 Rev 1 | Pinout Fig. 1 = Fig. 9/11 (top view), pin-1 index Table 3; the EasyEDA/LCSC footprint numbering and orientation match. Land Fig. 13 p.7 (ST gives no lands for end tabs 9/18, which are omitted); stencil §5.1 / Fig. 17 p.9. Ratings Tables 1/2 p.2: ESD 2 kV contact on the MCU side, 8 kV elsewhere; −30…+85 °C; 36–54 Ω series; C<sub>line</sub> ≤ 20 pF. Internal 90k pull-ups incl. WP/CD (p.5). Height 0.55 mm max against K9 ≤ 0.55 mm. | Pass. **Correction to the critique:** RDATA_VCC goes to VCC (+3V3_SD) per Fig. 2/9, not to SD_D3; RDAT3_GND is NC. No 3D model (render only). JLC stock 1,719 (DB 2026-09-29), Extended. Firmware: SDMMC1 at medium speed (FIRMWARE_NOTES §3). |
| RN601 | UNI-ROYAL 4D02WGJ0470TCE (C55183) | JLC-01-015 p.4 | Element k between pins k and 9−k; IO0 1/8, IO3 2/7, IO1 3/6, element 4 NC; height 0.45 ± 0.10 | Pass. Same BOM line as RN801–RN803. SI re-run (`tl_model.py`): 24 cases pass, settling 15–25 % faster than the old two-resistor chain. |
| RN1201 | UNI-ROYAL 4D02WGJ0331TCE (C43557) | JLC-01-015 §3.1 p.4, §3.2 p.5, §3.3 | Pairing, dimensions, ratings | Pass. JLC stock 29,273. |
| R1210, R1205 | UNI-ROYAL 0402WGF1002TCE (C25744, JLC Basic) | UNI-ROYAL V.3 pp.4–6 | 1/16 W, 50 V, ±100 ppm | Pass |
| R807, R808 | YAGEO RC0402FR-071KL (C106235) | YAGEO RC_L V.12 pp.4–6 | Height 0.35 mm (K9), 1/16 W, 50 V | Pass. Existing 1k line. A press gives 3.3 V × 1k / 11k ≈ 0.30 V at the pin (V<sub>IL</sub> 0.3 × VDD per the critique's DS12110 check). |
| R804 | YAGEO RC0402FR-07100RL (C106232) | YAGEO RC_L | Generic thick film | Pass. Existing 100R line. |
| U1201 EN tie (S-20) | TI TCA9517A | SCPS245E §5.3 p.5, §5.5 p.7, §7.3.2 p.12, §9 p.16, §5.6 note 1 | EN high ≥ 0.7 × VCCB; current specified with EN = VCCB; internal pull-up; outputs off until VCCB > 2.5 V; EN changes only while the bus is idle | Pass. Firmware rule in FIRMWARE_NOTES §4. |
| D1201–D1204 NC ties (P1-27) | TI TPD4E05U06 | SLVSBO7O Table 4-2, Fig. 4-3 p.4 | NC pins not connected internally and meant for straight-through routing | Pass. All 14 NC pins tied. |

Not built: the CAT4104 (S-15; see above and section 7). No TPD6E05U06 (S-21 stays optional: P1-27 achieved flow-through on 10 lines).

## 6. Stale schematic notes (open)
The datasheet values are right, but several sheet text notes still describe older values. Counts are from the 2a candidate:
- Power: "1 MHz forced PWM", "L1301 saturation 4.8 A at 20%" (the datasheet gives 3.0 A), "charger is external".
- Expansion: the U1502 note still says 1.54k / 22 nF. The fitted parts are R1513 1.50k and C1508 47 nF.
- RF input: the function notes and interface table say +5V_A where the net is +5V_RF.
- Every sheet: the programming note names the TC2030-IDC cable; the right one is TC2030-CTX. The SWO and LID_INT mentions go away with S-18 / S-24.

They are fixed by one Konnect text-edit package after 2b lands. Its gates: ERC 0 and an unchanged netlist.

## 7. Findings of the separate check (section 4) and where they go

| Finding | Severity | Fix | Where |
|---|---|---|---|
| **J1101 sits 0.96 mm too far inboard.** The board edge is 0.47 mm proud of the receptacle face, so the plug overmould can hit the PCB before full mating (latch). | Medium | Move J1101 0.96 mm west to (121.19, 127.46), which `query.py free` confirms as a legal pose; the receptacle then overhangs the notch floor by 0.46 mm, as HRO draws it. Deepening the notch instead is not possible: U1201, C1202, R1502, SWCLK, EXP_TMR1 and five vias sit within 1.6 mm of the edge. Re-draw the J1101 pad connections, and move SWD out from under J1101 at the same time (P1-7). Verify with a real plug in the enclosure. | Checkpoint 4, area R702 (J1101/SWD) **DONE checkpoint 4b3:** J1101 at (121.19, 127.46), every pad re-drawn, K12 keep-outs moved with it. |
| **D801–D804 junction temperature unconfirmed.** Bare pads; worst case 132.5 mW each at VSYS 8.77 V. | Medium | A copper island is not possible: In3 is the band's only signal layer, and the band is full. **Firmware duty cap from VSYS** (BQ25798 ADC): P = (VSYS − 2.75 V) × 22 mA; duty_max = min(1, 85 °C / (θJA × P)) for Ta ≤ 40 °C and Tj ≤ 125 °C. Use θJA = 1200 °C/W until measured, which gives 53 % at 8.77 V, 69 % at 7.4 V and 85 % at 6.5 V. Bench: lead temperature at full duty and VSYS max; Tj ≈ T_lead + 26 °C (196 °C/W × 0.1325 W). | `05_firmware/FIRMWARE_CONTRACT.md` §7; bench list |
| **F1401 land 0.555 mm short** of Bourns Style 2 (1.68 × 2.95 mm pads, 3.1 mm gap). | Medium | A project footprint with the Style 2 land (Konnect `create_footprint`), swapped onto F1401. Do it in the same package as P1-4 / D18, which moves F1401 into the J1401.1 pocket. If the bench pack current exceeds about 1 A at 50 °C, use MF-MSMF200/16X. | Placement pass **DONE checkpoint 4b1:** footprint Fuse_Bourns_MF-MSMF_Style2_4532Metric (1.68 × 2.95 at ±2.39). F1401 moved to B (163.05, 126.80) r90. PACK_RAW is a B-only 1.0 mm, via-free 12.8 mm run (was about 28 mm on In3). The 3D model is still to add. |
| J1401: vias in pads 2/3 and copper under the housing | Medium → resolved | All vias are IPC-4761 type VII (resin-filled and capped), and the tracks are masked | Fab note (already on User.Drawings) |
| L1101 / L1301 start-lead orientation | Low | Assembly note: the start lead (dot) goes to the high-dv/dt node (L1101 pad 2 = SW802; L1301 to U1301 SW) | Fab spec / CPL check |
| Pack harness wire gauge | Low | #22 AWG or heavier in the pack spec | `07_manufacturing/REV_A_PURCHASE_LIST.md` |
| F801 Datasheet field "None"; D801–D804 Datasheet field points to NSI45020/D, not NSI45020A/D | Low | Field edits | Notes package (2c) |
| B3U switch currents (16 µA – 0.44 mA) below the 1 mA rating floor, above the 10 µA minimum load | Low | Accepted. Optional R44/R49 3.3k with 330 nF. | Documented |
