Able-Digital-Logic/UnintendedAntennaClub3/Hardware/RFVD_SENSOR_BOARD_Rev6/docs/PLACEMENT_DATASHEET_CHECK.md

# Placement against the datasheet layout guides

Generated by `tools/dsgap.py` from the board and `docs/sensitivity.json` (each rule quotes its datasheet section and page). Gap = pad-edge distance from the part to the nearest pin of its IC on a shared net, measured on the board. Budgets marked "EMC practice" in a source are our tightening of the datasheet's "close to the pin".

- **269 parts measured, 264 within budget, 5 over** (5 justified in `tools/placeaudit_keep.json`, **0 unjustified**).
- 73 rules belong to parts removed in the BOM simplification (not on the board).

## J1101 TYPE-C-31-M-12 (connector drawing only (no layout guidance))

- No electrical layout guidance in the connector drawing; ESD/filters per TPD1E10B06 7.4.1 p.11 and TPD4E05U06 7.4.1 p.16 (at the connector). *(-)*

| Part | Role | Side / IC side | Nearest pin | Gap mm | Budget mm | Verdict |
|---|---|---|---|---|---|---|
| U1102 | esd_protection (TPD4E05U06 D+/D-/CC1/CC2) | B / F | J1101.A6 | 3.96 | 3.0 (high) | KEEP: TPD4E05U06 USB ESD on B.Cu, 3.69 mm from J1101.A5: J1101's shell region allows no foreign copper (P1-7, rule v11_j10_shell_no_foreign_F and the K12_J10 keep-outs), so U1102 sits at its edge, next to D1101, with flow-through routing (TI 7.4.1) |
| D1101 | esd_protection (TPD1E10B06 VBUS) | B / F | J1101.A4 | 1.19 | 3.0 (high) | OK |
| C1103 | filter_cap (VBUS 1 uF hot-plug) | F / F | J1101.A9 | 2.90 | 5.0 (medium) | OK |
| R1109 | divider_resistor (VBUS_DET top) | B / F | U401.7 | 15.84 | 25.0 (low) | OK (no shared net with U401.7) |
| R1113 | pull_down_resistor (CC Rd 5.1 k) | B / F | J1101.B5 | 0.56 | 10.0 (low) | OK |
| R1112 | pull_down_resistor (CC Rd 5.1 k) | B / F | J1101.A5 | 0.00 | 10.0 (low) | OK |

## J1201 LSHM-120-02.5-L-DV-A-N-K-TR (Samtec LSHM spec (mechanical only))

- No electrical guidance; TVS arrays at the connector per TPD4E05U06 7.4.1 p.16; series/injection resistors after the TVS are EMC practice (rulebook R33/R36). *(-)*

| Part | Role | Side / IC side | Nearest pin | Gap mm | Budget mm | Verdict |
|---|---|---|---|---|---|---|
| R1209 | series_isolation_resistor (330R/1k injection limit) | B / B | J1201.14 | 4.67 | 5.0 (medium) | OK |
| C1503 | decoupling_cap (+3V3_EXP 100 nF at J1201) | B / B | J1201.3 | 1.92 | 3.0 (medium) | OK |
| D1201 | esd_protection (TPD4E05U06) | B / B | J1201.13 | 0.86 | 3.0 (high) | OK |
| D1202 | esd_protection (TPD4E05U06) | B / B | J1201.27 | 0.81 | 3.0 (high) | OK |
| D1206 | esd_protection (TPD4E05U06) | B / B | J1201.28 | 0.81 | 3.0 (high) | OK |
| D1203 | esd_protection (TPD4E05U06) | B / B | J1201.33 | 0.78 | 3.0 (high) | OK |
| D1205 | esd_protection (TPD4E05U06) | B / B | J1201.14 | 0.78 | 3.0 (high) | OK |
| D1204 | esd_protection (TPD4E05U06) | B / B | J1201.34 | 0.78 | 3.0 (high) | OK |
| R1214 | series_isolation_resistor (330R/1k injection limit) | B / B | J1201.15 | 2.64 | 5.0 (medium) | OK |
| R1218 | series_isolation_resistor (330R/1k injection limit) | B / B | J1201.31 | 2.64 | 5.0 (medium) | OK |
| R1204 | series_isolation_resistor (330R/1k injection limit) | B / B | J1201.8 | 2.62 | 5.0 (medium) | OK |
| R1208 | series_isolation_resistor (330R/1k injection limit) | B / B | J1201.13 | 2.58 | 5.0 (medium) | OK |
| R1206 | series_termination_resistor (MISO, shield-driven) | B / B | J1201.9 | 3.58 | 6.0 (medium) | OK |
| C1502 | bulk_cap (+3V3_EXP 10 uF) | F / B | J1201.37 | 10.56 | 15.0 (low) | OK |
| R1504 | bleeder_resistor (+3V3_EXP) | B / B | J1201.3 | 12.41 | 20.0 (low) | OK |
| R1215 | pull resistor (100 k default level) | B / B | J1201.15 | 3.66 | 15.0 (low) | OK |
| R1216 | pull resistor (100 k default level) | B / B | J1201.13 | 3.63 | 15.0 (low) | OK |
| R1221 | pull resistor (100 k default level) | B / B | J1201.31 | 3.63 | 15.0 (low) | OK |
| R1213 | pull resistor (100 k default level) | B / B | J1201.32 | 2.58 | 15.0 (low) | OK |
| R1217 | pull resistor (100 k default level) | B / B | J1201.35 | 2.58 | 15.0 (low) | OK |

## J1401 2053380004 (Molex drawing (mechanical only))

- No electrical guidance; HF shunt caps at the harness entry are EMC practice (rulebook R33: <=5 mm proposed). *(-)*

| Part | Role | Side / IC side | Nearest pin | Gap mm | Budget mm | Verdict |
|---|---|---|---|---|---|---|
| C1403 | filter_cap (VBAT_PACK RF shunt) | B / F | Q1401.2 | 0.00 | 8.0 (medium) | OK |
| R1403 | pull_down_resistor (Q1401 gate) | F / F | Q1401.1 | 0.72 | 10.0 (low) | OK |
| Q1401 | reverse-polarity PFET (AO3401A) | F / B | J1401.1 | 12.30 | 25.0 (low) | OK (no shared net with J1401.1) |
| F1401 | ptc_fuse (pack) | B / B | J1401.1 | 8.39 | 25.0 (low) | OK |

## J601 DM3AT-SF-PEJM5 (Hirose DM3 drawing (mechanical only))

- Mechanical keep-outs only; ESD at the socket per Nexperia 7 p.6; SDMMC routing per AN4938 9.4.1 p.40. *(-)*

| Part | Role | Side / IC side | Nearest pin | Gap mm | Budget mm | Verdict |
|---|---|---|---|---|---|---|
| C601 | decoupling_cap (+3V3_SD 100 nF) | B / F | J601.4 | 0.12 | 3.0 (medium) | OK |
| C602 | bulk_cap (+3V3_SD 47 uF polymer) | B / F | J601.4 | 10.47 | 15.0 (low) | OK |
| R601 | series_isolation_resistor (+3V3_SD 1R) | B / F | J601.4 | 1.69 | 15.0 (low) | OK |

## J801 XF2M-4015-1A (Omron XF2M drawing (mechanical only))

- No electrical guidance; off-board FPC: series R at the source and RF shunts at the connector are EMC practice (rulebook R33/R44). *(-)*

| Part | Role | Side / IC side | Nearest pin | Gap mm | Budget mm | Verdict |
|---|---|---|---|---|---|---|
| C810 | filter_cap (LED_A 100 pF RF shunt) | B / F | J801.38 | 0.00 | 2.0 (high) | OK |
| C801 | filter_cap (47 pF edge-rate) | B / F | J801.10 | 0.61 | 3.0 (medium) | OK |
| C804 | decoupling_cap (panel VDD 100 nF) | B / F | J801.8 | 0.00 | 3.0 (medium) | OK |
| C802 | filter_cap (47 pF edge-rate) | B / F | J801.12 | 0.00 | 3.0 (medium) | OK |
| C809 | decoupling_cap (LED_A 1 uF) | F / F | J801.38 | 1.06 | 5.0 (medium) | OK |
| C803 | decoupling_cap (panel VDD 1 uF) | F / F | J801.7 | 0.56 | 5.0 (medium) | OK |
| D804 | constant_current_regulator (backlight 20 mA) | B / F | J801.37 | 20.38 | 25.0 (low) | OK |
| Q802 | high-side switch (AO3401A) | F / F | J801.38 | 13.42 | 20.0 (low) | OK (no shared net with J801.38) |
| R806 | pull_down_resistor (LCD_RST) | B / F | J801.30 | 8.21 | 15.0 (low) | OK |
| R809 | divider_resistor (Q802 gate) | B / F | Q802.1 | 2.27 | 10.0 (low) | OK |
| Q803 | low-side PWM switch (AO3400A) | F / F | J801.34 | 12.13 | 20.0 (low) | OK (no shared net with J801.34) |
| D803 | constant_current_regulator (backlight 20 mA) | B / F | J801.36 | 16.05 | 25.0 (low) | OK |
| R812 | pull_down_resistor (Q803 gate) | B / F | Q803.1 | 0.72 | 10.0 (low) | OK |
| R810 | pull_up_resistor (Q802 gate) | B / F | Q802.2 | 0.53 | 10.0 (low) | OK |
| F801 | ptc_fuse (backlight) | F / F | Q802.2 | 5.22 | 15.0 (low) | OK |
| R811 | series_termination_resistor (Q803 gate 100R) | B / F | Q803.1 | 0.00 | 10.0 (low) | OK |
| Q801 | level shifter (2N7002) | F / F | Q802.1 | 2.31 | 15.0 (low) | OK (no shared net with Q802.1) |
| FB801 | ferrite_filter (LED anode) | F / F | J801.38 | 2.26 | 15.0 (low) | OK |
| D801 | constant_current_regulator (backlight 20 mA) | B / F | J801.34 | 5.43 | 25.0 (low) | OK |
| D802 | constant_current_regulator (backlight 20 mA) | B / F | J801.35 | 2.68 | 25.0 (low) | OK |

## J802 84953-6 (TE 84953 drawing (mechanical only))

- No electrical guidance; supply decoupling at the connector pin is EMC practice (rulebook R33). *(-)*

| Part | Role | Side / IC side | Nearest pin | Gap mm | Budget mm | Verdict |
|---|---|---|---|---|---|---|
| C811 | decoupling_cap (touch supply 100 nF) | B / F | J802.1 | 0.00 | 3.0 (medium) | OK |
| R814 | pull_up_resistor (touch I2C/INT) | B / F | J802.4 | 0.03 | 15.0 (low) | OK |
| R813 | pull_up_resistor (touch I2C/INT) | B / F | J802.3 | 0.00 | 15.0 (low) | OK |
| R815 | pull_up_resistor (touch I2C/INT) | B / F | J802.5 | 0.00 | 15.0 (low) | OK |

## U701 TLV809EA46DBZR (TI TLV809E SLVSES2J)

- Low-impedance VDD connection; >=0.1 uF ceramic as close to VDD as possible. *(11.1 p.24)*
- Open-drain variants need a pull-up close to the RESET pin (TLV809E is push-pull; it drives U702 ENBL directly). *(11.1 p.24)*

| Part | Role | Side / IC side | Nearest pin | Gap mm | Budget mm | Verdict |
|---|---|---|---|---|---|---|
| C701 | decoupling_cap (supervisor VDD 100 nF) | F / F | U701.3 | 0.55 | 2.0 (high) | OK |

## U801 TPS2553DDBVR (TI TPS2552D/53D SLVSDL7)

- >=0.1 uF ceramic IN-GND as close to the device as possible; electrolytic + 100 nF on OUT when large transients are expected. *(10.2.1.2.4 p.20; 12.1 p.26)*
- RILIM traces as short as possible (current-limit accuracy). *(12.1 p.26)*

| Part | Role | Side / IC side | Nearest pin | Gap mm | Budget mm | Verdict |
|---|---|---|---|---|---|---|
| C805 | decoupling_cap (IN 1 uF) | F / F | U801.1 | 1.36 | 2.0 (high) | OK |
| R803 | setting_resistor (RILIM) | B / F | U801.5 | 0.00 | 2.0 (high) | OK |
| C806 | decoupling_cap (OUT 100 nF) | B / F | U801.6 | 0.00 | 4.0 (medium) | OK |
| R805 | bleeder_resistor (+3V3_UI) | B / F | J801.7 | 24.14 | 30.0 (low) | OK |
| R802 | pull_down_resistor (EN default off) | B / F | U801.3 | 0.00 | 10.0 (low) | OK |
| R801 | pull_up_resistor (FAULT) | F / F | U801.4 | 0.61 | 15.0 (low) | OK |

## U302 TMP117AIDRVR (TI TMP117 SNOSD82D)

- 0.1 uF bypass as close as possible to supply and ground pins. *(9 p.35; 10.1 p.36)*
- Pull-up resistors can be heat sources: keep some distance between them and the sensor; thermal pad unsoldered for best accuracy; isolate from heat sources. *(10.1 p.36-37)*

| Part | Role | Side / IC side | Nearest pin | Gap mm | Budget mm | Verdict |
|---|---|---|---|---|---|---|
| C302 | decoupling_cap (100 nF) | F / F | U302.5 | 0.43 | 3.0 (medium) | OK |
| R301 | pull_up_resistor (I2C 4.7 k, heat source) | B / F | U302.5 | 46.22 | 60.0 (low) | OK |
| R302 | pull_up_resistor (I2C 4.7 k, heat source) | B / F | U302.5 | 39.53 | 60.0 (low) | OK |

## U1001 AD7380BCPZ-RL7 (ADI AD7380/AD7381 Rev A)

- VLOGIC 1 uF, REGCAP 1 uF (1.9 V internal LDO), VCC 1 uF, REFCAP 0.1 uF, REFIO 1 uF (mandatory for internal and external reference); exposed pad must be grounded. *(Table 7 p.9)*
- Decouple VCC and VLOGIC separately (1 uF each); REGCAP 1 uF to GND. *(p.16)*
- Differential RC filter on the analog inputs (typ. R = 33 ohm, C701 = 68 pF, C708 = 330 pF). *(p.16; Fig. 31 p.17)*
- Digital-interface noise couples into conversions: keep the digital lines short or put ~100 ohm in series close to SDOA/SDOB. *(p.16)*

| Part | Role | Side / IC side | Nearest pin | Gap mm | Budget mm | Verdict |
|---|---|---|---|---|---|---|
| C1004 | filter_cap (input RC 2.2 nF C0G, charge bucket) | F / F | U1001.6 | 0.44 | 1.0 (critical) | OK |
| C1005 | filter_cap (input RC 2.2 nF C0G, charge bucket) | F / F | U1001.5 | 0.44 | 1.0 (critical) | OK |
| R1006 | analog_network_resistor (input RC 33R) | F / F | U1001.5 | 1.25 | 2.0 (high) | OK |
| C1006 | decoupling_cap (REFIO 1 uF) | F / F | U1001.11 | 0.54 | 1.5 (critical) | OK |
| C1002 | internal_regulator_cap (REGCAP 1 uF) | F / F | U1001.3 | 0.53 | 1.5 (high) | OK |
| C1003 | decoupling_cap (VLOGIC 1 uF) | F / F | U1001.2 | 1.03 | 2.0 (high) | OK |
| R1002 | analog_network_resistor (input RC 33R) | F / F | U1001.7 | 1.00 | 2.0 (high) | OK |
| C1007 | decoupling_cap (REFCAP 0.1 uF) | F / F | U1001.9 | 0.47 | 1.5 (high) | OK |
| C1001 | decoupling_cap (VCC 1 uF) | F / F | U1001.4 | 0.80 | 2.0 (high) | OK |
| R1007 | series_termination_resistor (SDOA 100R) | B / F | U1001.13 | 0.00 | 3.0 (high) | OK |
| R1001 | zero_ohm_link (VLOGIC 1R) | F / F | U1001.2 | 2.62 | 10.0 (low) | OK |
| D1001 | clamp diode (VREF+ <= VDDA) | F / F | U401.20 | 5.74 | 15.0 (low) | OK |

## U702 ADL5511ACPZ-R7 (ADI ADL5511 Rev E)

- Decouple VPOS with two capacitors (eval: 100 pF 0402 + 0.1 uF 0402) placed as close as possible to the VPOS pin. *(p.19 (Basic Connections, Fig. 49); Table 5 p.24)*
- Exposed pad to thermal and electrical ground; COMM to a low-impedance ground plane. *(Table 3 p.8)*
- RFIN must be externally ac-coupled; nominal 250 ohm input. *(Table 3 p.8)*
- FLT2/FLT3 (and FLT4) capacitors are supply-referenced (return to VPOS); FLT1 capacitor returns to ground. *(Table 3 p.8; p.17; p.19-20)*
- VENV capacitive load must not exceed 10 pF (500 ohm || 10 pF max) for full envelope bandwidth; never dc-couple 50 ohm; EREF may take a capacitor to ground. *(Table 3 p.8; p.17-18)*

| Part | Role | Side / IC side | Nearest pin | Gap mm | Budget mm | Verdict |
|---|---|---|---|---|---|---|
| C709 | decoupling_cap (VPOS 100 nF) | F / F | U702.15 | 2.46 | 2.5 (high) | OK |
| R701 | analog_network_resistor (CAL injection 3.32 k) | F / F | U702.2 | 1.88 | 2.0 (high) | OK |
| C708 | rf_coupling_cap (RFIN ac-coupling 47 pF C0G) | F / F | U702.2 | 1.24 | 1.5 (critical) | OK |
| C704 | decoupling_cap (VPOS 100 pF) | F / F | U702.15 | 0.64 | 1.0 (critical) | OK |
| C703 | filter_cap (FLT1 100 pF to GND) | F / F | U702.3 | 1.36 | 2.0 (high) | OK |
| R705 | analog_network_resistor (DNP J702 option) | F / F | J702.1 | 0.80 | 1.5 (high) | OK |
| R706 | analog_network_resistor (RF series 1.5 k) | F / F | J702.1 | 0.70 | 1.5 (critical) | OK |
| D702 | esd_protection (CAL port first stage) | F / F | J701.1 | 0.69 | 1.5 (high) | OK |
| C706 | filter_cap (FLT2/FLT3 1 nF, VPOS-referenced) | F / F | U702.1 | 1.12 | 2.0 (high) | OK |
| D701 | esd_protection (IC-side secondary on RFIN) | F / F | U702.2 | 0.48 | 1.5 (high) | OK |
| R702 | analog_network_resistor (RF series 1.5 k) | F / F | R706.1 | 0.34 | 1.5 (critical) | OK |
| C702 | decoupling_cap (VPOS 1 uF reservoir) | F / F | U702.15 | 2.74 | 4.0 (medium) | OK |
| R704 | analog_network_resistor (CAL 2x100R termination) | F / F | J701.1 | 4.71 | 6.0 (medium) | OK |
| C705 | filter_cap (FLT2/FLT3 1 nF, VPOS-referenced) | F / F | U702.16 | 0.65 | 2.0 (high) | OK |
| C707 | rf_coupling_cap (CAL DC block 1 nF) | F / F | J701.1 | 5.68 | 8.0 (medium) | OK |
| C710 | filter_cap (FLT4 rms 100 nF, VPOS-referenced) | F / F | U702.14 | 0.65 | 3.0 (medium) | OK |
| R703 | analog_network_resistor (CAL 2x100R termination) | F / F | J701.1 | 2.46 | 6.0 (medium) | OK |

## U502 OPA2320AIDGKR (TI OPAx320 SBOS513F)

- 0.1 uF bypass close to the supply pins; bypass traces designed for minimum inductance (wideband amplifier). *(9 p.28; 10.1 p.28)*
- Place gain/filter components close to the device and to each other; run input traces as far from supply lines as possible. *(Fig. 49 p.28)*
- Inputs are the most EMI-susceptible pins; the internal filter (~580 MHz) does little at 64/128 MHz, so external RC at the input is the protection. *(7.3.6 p.18 (see rulebook R9))*

| Part | Role | Side / IC side | Nearest pin | Gap mm | Budget mm | Verdict |
|---|---|---|---|---|---|---|
| C516 | decoupling_cap (V+ 1 uF reservoir) | F / F | U502.8 | 4.08 | 5.0 (medium) | OK |
| C515 | decoupling_cap (V+ 100 nF) | F / F | U502.8 | 0.43 | 1.5 (high) | OK |
| C506 | filter_cap (SK ground cap at + input, C0G) | F / F | U502.5 | 0.82 | 2.0 (high) | OK |

## U1101 BQ25798RQMR (TI BQ25798 SLUSDV2C)

- Layout order is mandatory (priority list). 1: 0.1 uF 0402/0201 caps on the SAME layer as the IC, on top of the IC, short traces to PMID-GND and SYS-GND; ideally one 10 uF bulk in parallel; remaining bulk must connect with low impedance (same layer wide traces and/or multiple vias). *(8.4.1 p.139, Fig. 8-21 p.140)*
- SW801/SW802 to the inductor may run through multiple vias under the IC to an inner/bottom layer; minimise that copper area (E and H field radiation) and its parasitic capacitance to other traces/planes; BTST caps may be connected with vias on both sides. *(8.4.1 item 2 p.139)*
- REGN cap close to the REGN pin with a short trace, then >=2 vias from its ground to the internal ground plane. *(8.4.1 item 3 p.139)*
- 0.1 uF small cap close to the VBUS pin; the 10 uF VBUS bulk may be placed further away; >=2 ground vias per cap. *(8.4.1 item 4 p.139)*
- BAT capacitors close to BAT and GND. *(8.4.1 item 5 p.139)*
- Via size/count sufficient for each current path. *(8.4.1 item 6 p.139)*
- Route BATP and TS traces away from SW801/SW802. *(8.4.1 item 7 p.139)*
- Values: REGN 4.7 uF 10 V; BTST1/BTST2 47 nF 10 V; BATP 100 ohm series; BAT 2x10 uF; SYS 5x10 uF + 0.1 uF closest; PMID 3x10 uF + 0.1 uF closest; SDRV 1 nF only when no ship FET. *(Table 5-1 p.4-6)*

| Part | Role | Side / IC side | Nearest pin | Gap mm | Budget mm | Verdict |
|---|---|---|---|---|---|---|
| C1113 | decoupling_cap (SYS 0.1 uF) | F / F | U1101.25 | 2.29 | 1.5 (critical) | KEEP: BQ25798 SYS 0.1 uF at the north end of U1101's west pin column (pins 25-29 at x 143.10), on F.Cu with a GND via in the pad and a 0.5 mm feed, as in TI Fig. 8-21. SW801 / SW802 (pins 26 / 28) leave west between C1113 and C1108, so the cap cannot sit beside pin 25. 2.29 mm pad gap; the 0.6 mm courtyard slack left would give 1.69 mm, still over the 1.5 mm, which is EMC practice, not a datasheet number. Known minor deviation: the SYS 10 uF bulk C1114 sits closer (1.88 mm) than this 0.1 uF, against TI Table 5-1 '0.1 uF closest'; optional hand swap in docs/LEAD_GUI_STEPS.md |
| C1108 | decoupling_cap (PMID 0.1 uF) | F / F | U1101.29 | 1.69 | 1.5 (critical) | KEEP: BQ25798 PMID 0.1 uF at the south end of U1101's west pin column, courtyard touching U1101's (closest legal pose), on F.Cu with a GND via in the pad and a 0.5 mm feed, as in TI Fig. 8-21. 1.69 mm pad gap against 1.5 mm EMC practice (datasheet: 'on top of the IC, short traces') |
| C1102 | internal_regulator_cap (REGN 4.7 uF) | F / F | U1101.5 | 1.88 | 2.0 (high) | OK |
| C1112 | bootstrap_cap (BTST 47 nF) | B / F | U1101.26 | 1.93 | 3.0 (high) | OK |
| C1114 | bulk_cap (SYS 10 uF, first) | F / F | U1101.25 | 1.88 | 3.0 (high) | OK |
| C1109 | bulk_cap (PMID 10 uF, first) | F / F | U1101.29 | 1.77 | 3.0 (high) | OK |
| C1107 | bootstrap_cap (BTST 47 nF) | B / F | U1101.28 | 1.68 | 3.0 (high) | OK |
| L1101 | power_inductor (SW801-SW802) | F / F | U1101.26 | 1.21 | 3.0 (high) | OK |
| C1106 | decoupling_cap (VBUS 0.1 uF) | B / F | U1101.2 | 0.00 | 2.0 (high) | OK |
| C1401 | bulk_cap (BAT 10 uF) | F / F | U1101.22 | 0.94 | 3.0 (high) | OK |
| C1111 | bulk_cap (PMID 10 uF) | F / F | U1101.29 | 5.85 | 8.0 (medium) | OK |
| C1402 | bulk_cap (BAT 10 uF) | F / F | U1101.22 | 2.84 | 5.0 (medium) | OK |
| C1404 | filter_cap (BATT_NTC RF shunt at J1401) | B / B | J1401.4 | 0.71 | 3.0 (high) | OK |
| C1115 | bulk_cap (SYS 10 uF) | F / F | U1101.25 | 5.62 | 8.0 (medium) | OK |
| R1401 | series_isolation_resistor (BATP 100 ohm) | B / F | U1101.18 | 2.45 | 5.0 (medium) | OK |
| C1118 | bulk_cap (SYS 10 uF) | F / F | U1101.25 | 3.94 | 8.0 (medium) | OK |
| C1110 | bulk_cap (PMID 10 uF) | F / F | U1101.29 | 2.92 | 8.0 (medium) | OK |
| R1103 | setting_resistor (PROG) | B / F | U1101.20 | 1.95 | 8.0 (low) | OK |
| R1101 | setting_resistor (ILIM_HIZ divider) | B / F | U1101.17 | 1.83 | 8.0 (low) | OK |
| C1117 | bulk_cap (VSYS rail bulk, sits at U1301/U201 feed) | F / F | U1101.25 | 18.70 | 25.0 (low) | OK |
| R1102 | setting_resistor (ILIM_HIZ divider) | B / F | U1101.17 | 1.32 | 8.0 (low) | OK |
| C1116 | bulk_cap (VSYS rail bulk, sits at U1301/U201 feed) | F / F | U1101.25 | 17.14 | 25.0 (low) | OK |
| C1104 | bulk_cap (VBUS 10 uF) | F / F | U1101.9 | 2.05 | 10.0 (low) | OK |
| R1104 | divider_resistor (TS/NTC bias) | B / F | U1101.16 | 1.56 | 10.0 (low) | OK |
| R1106 | divider_resistor (TS/NTC bias) | B / F | U1101.16 | 1.34 | 10.0 (low) | OK |
| C1101 | gate_drive_cap (SDRV 1 nF, DNP) | B / F | U1101.24 | 0.93 | 10.0 (low) | OK |
| R1105 | divider_resistor (TS/NTC bias) | B / F | U1101.16 | 0.78 | 10.0 (low) | OK |
| R1111 | divider_resistor (CE pull-down / OVP divider) | F / F | U1101.13 | 0.47 | 10.0 (low) | OK |
| Q1402 | ship FET (AO3400A) | F / F | U1101.24 | 13.99 | 25.0 (low) | OK |
| R1107 | pull_up_resistor (INT) | B / F | U1101.21 | 18.05 | 30.0 (low) | OK |
| R1108 | pull_up_resistor (STAT) | B / F | U1101.1 | 2.18 | 15.0 (low) | OK |
| C1105 | bulk_cap (VBUS 10 uF at connector) | B / F | J1101.A4 | 7.11 | 20.0 (low) | OK |
| R1110 | divider_resistor (BQ29209 OUT to CE) | F / F | U1401.8 | 1.91 | 15.0 (low) | OK |
| R1402 | zero_ohm_link (DNP Q1402 bypass) | B / F | Q1402.3 | 0.00 | 40.0 (low) | OK |

## U1401 BQ29209DRBR (TI BQ29200/BQ29209 SLUSA52C)

- Input filters to VC1 and VC2 as close to the IC as possible (noise immunity). *(11.1 p.15)*
- VDD input RC filter close to the IC terminal. *(11.1 p.15)*
- If OUT drives a high-current path, keep it away from the sense inputs. *(11.1 p.15)*
- Reference values: 160 ohm/260 ohm/100 ohm with 0.1 uF filters, 0.33 uF CD. *(Fig. 9 p.13)*

| Part | Role | Side / IC side | Nearest pin | Gap mm | Budget mm | Verdict |
|---|---|---|---|---|---|---|
| C1407 | decoupling_cap (VDD RC 0.1 uF) | F / F | U1401.7 | 1.59 | 2.0 (high) | OK |
| C1406 | filter_cap (VC sense filter 0.1 uF) | F / F | U1401.2 | 1.42 | 2.0 (high) | OK |
| C1405 | filter_cap (VC sense filter 0.1 uF) | F / F | U1401.1 | 0.94 | 2.0 (high) | OK |
| R1404 | series_isolation_resistor (VC sense/balance R) | F / F | U1401.1 | 1.61 | 4.0 (medium) | OK |
| R1407 | series_isolation_resistor (VDD RC 100 ohm) | F / F | U1401.7 | 0.86 | 4.0 (medium) | OK |
| R1405 | series_isolation_resistor (VC sense/balance R) | F / F | U1401.2 | 0.44 | 4.0 (medium) | OK |
| C1408 | timing_cap (CD delay 330 nF) | F / F | U1401.4 | 0.97 | 5.0 (medium) | OK |
| R1406 | divider_resistor (VC1_CB balance 100 ohm) | F / F | U1401.3 | 1.42 | 8.0 (low) | OK |
| R1408 | pull_up_resistor (CB_EN 470 k) | F / F | U1401.6 | 1.45 | 15.0 (low) | OK |
| Q1403 | switch (2N7002 CB_EN) | F / F | U1401.6 | 3.43 | 40.0 (low) | OK |

## U1402 TPS70933DBVR (TI TPS709 SBVS186H)

- Input and output capacitors as close as possible to the pins; output-capacitor ground directly to the device GND pin. *(10.1 p.16, Fig. 10-1 p.16)*
- COUT >=1.5 uF effective (Vout >=1.5 V), ESR 0-0.2 ohm; CIN 0.1-2.2 uF optional but recommended. *(8.1.1 p.14)*

| Part | Role | Side / IC side | Nearest pin | Gap mm | Budget mm | Verdict |
|---|---|---|---|---|---|---|
| C1410 | decoupling_cap (LDO COUT 4.7 uF) | F / F | U1402.5 | 0.73 | 2.0 (high) | OK |
| C1409 | decoupling_cap (LDO CIN 1 uF) | F / F | U1402.1 | 2.66 | 4.0 (medium) | OK |

## U501 OPA2320AIDGKR (TI OPAx320 SBOS513F)

- 0.1 uF bypass close to the supply pins; bypass traces designed for minimum inductance (wideband amplifier). *(9 p.28; 10.1 p.28)*
- Place gain/filter components close to the device and to each other; run input traces as far from supply lines as possible. *(Fig. 49 p.28)*
- Inputs are the most EMI-susceptible pins; the internal filter (~580 MHz) does little at 64/128 MHz, so external RC at the input is the protection. *(7.3.6 p.18 (see rulebook R9))*

| Part | Role | Side / IC side | Nearest pin | Gap mm | Budget mm | Verdict |
|---|---|---|---|---|---|---|
| C503 | filter_cap (SK ground cap at + input, C0G) | F / F | U501.3 | 1.48 | 2.0 (high) | OK |
| C513 | decoupling_cap (V+ 100 nF) | F / F | U501.8 | 0.44 | 1.5 (high) | OK |
| R504 | analog_network_resistor (into + input) | F / F | U501.5 | 0.92 | 2.0 (high) | OK |
| C504 | filter_cap (SK ground cap at + input, C0G) | F / F | U501.5 | 0.83 | 2.0 (high) | OK |
| R502 | analog_network_resistor (into + input) | F / F | U501.3 | 0.68 | 2.0 (high) | OK |
| R501 | analog_network_resistor (ADL5511 output into SK junction) | F / F | R502.1 | 0.62 | 2.0 (high) | OK |
| C502 | filter_cap (SK feedback cap) | F / F | U501.7 | 1.59 | 3.0 (medium) | OK |
| C514 | decoupling_cap (V+ 1 uF reservoir) | F / F | U501.8 | 3.03 | 5.0 (medium) | OK |
| R503 | analog_network_resistor (stage-1 out to junction 2) | F / F | U501.1 | 0.94 | 3.0 (medium) | OK |
| C501 | filter_cap (SK feedback cap) | F / F | U501.1 | 0.68 | 3.0 (medium) | OK |

## U1501 TPS2553DDBVR (TI TPS2552D/53D SLVSDL7)

- >=0.1 uF ceramic IN-GND as close to the device as possible. *(10.2.1.2.4 p.20; 12.1 p.26)*
- RILIM traces as short as possible. *(12.1 p.26)*

| Part | Role | Side / IC side | Nearest pin | Gap mm | Budget mm | Verdict |
|---|---|---|---|---|---|---|
| R1503 | setting_resistor (RILIM) | B / B | U1501.5 | 0.43 | 2.0 (high) | OK |
| C1501 | decoupling_cap (IN 100 nF) | B / B | U1501.1 | 0.42 | 2.0 (high) | OK |
| R1502 | pull_down_resistor (EN default off) | B / B | U1501.3 | 0.49 | 10.0 (low) | OK |

## U1502 TPS259631DDAR (TI TPS2596 SLVSET8A)

- >=0.01 uF ceramic between IN and GND, closest to the IN and GND terminals, minimal loop (may be minimised in hot-plug use). *(11.1 p.36)*
- Power path short, sized for >=2x full-load current; GND terminal tied to the plane at the IC. *(11.1 p.36)*
- RILM, CdVdT, EN/UVLO network and OVLO network close to their pins, other end to the device GND by the shortest trace; no coupling to switching signals (current-limit, soft-start and OV response accuracy). *(11.1 p.36)*
- Protection parts (TVS/Schottky) physically close to the pin they protect. *(11.1 p.36; Fig. 63 p.37)*
- Thermal pad to system ground plane. *(Pin Functions p.4)*

| Part | Role | Side / IC side | Nearest pin | Gap mm | Budget mm | Verdict |
|---|---|---|---|---|---|---|
| C1506 | decoupling_cap (IN 100 nF) | B / F | U1502.4 | 0.46 | 2.0 (high) | OK |
| R1513 | setting_resistor (RILM) | B / F | U1502.7 | 0.00 | 2.0 (high) | OK |
| R1509 | divider_resistor (OVLO) | B / F | U1502.8 | 0.36 | 3.0 (high) | OK |
| R1512 | divider_resistor (OVLO) | B / F | U1502.8 | 0.36 | 3.0 (high) | OK |
| C1508 | timing_cap (dVdT 47 nF) | B / F | U1502.2 | 0.00 | 4.0 (medium) | OK |
| C1507 | bulk_cap (EXP_VHP 10 uF at J1201) | F / B | J1201.22 | 7.35 | 15.0 (low) | OK |
| R1511 | pull_down_resistor (EN default off) | B / F | U1502.3 | 0.13 | 10.0 (low) | OK |
| R1510 | bleeder_resistor (EXP_VHP) | B / F | U1502.5 | 1.00 | 20.0 (low) | OK |

## U1201 TCA9517ADGKR (TI TCA9517A SCPS245E)

- No special layout procedures; ~100 nF decoupling as close as possible to VCCA and VCCB. *(9 p.16; 10.1 p.16, Fig. 10-1 p.17)*

| Part | Role | Side / IC side | Nearest pin | Gap mm | Budget mm | Verdict |
|---|---|---|---|---|---|---|
| R1212 | pull_up_resistor (EXP I2C 2.2 k) | B / F | U1201.8 | 27.00 | 15.0 (low) | KEEP: EXP_I2C_SCL 2.2 k pull-up, left at its pre-cp4 spot when the U1201 cluster moved (its twin R1211 sits at U1201). The spot at U1201 is copper-blocked: the SCL / SDA F.Cu pair passes U1201.7 at 0.22 mm pitch with R1211 beside it, so no via fits. Electrically neutral: a 12 mm open-drain stub at <= 400 kHz (rise >= 300 ns). Optional hand clean-up: docs/LEAD_GUI_STEPS.md |
| C1202 | decoupling_cap (VCC 100 nF) | F / F | U1201.1 | 0.81 | 3.0 (medium) | OK |
| C1203 | decoupling_cap (VCC 100 nF) | F / F | U1201.8 | 0.81 | 3.0 (medium) | OK |
| R1211 | pull_up_resistor (EXP I2C 2.2 k) | B / F | U1201.6 | 0.00 | 15.0 (low) | OK |

## U503 REF5030IDR (TI REF50 SBOS410O)

- Supply bypass (1-10 uF for REF50xxI) as close as possible to VIN and GND pins. *(9.3 p.29; 9.4.1.1 p.29)*
- 1 uF noise-filter capacitor between TRIM/NR and ground. *(9.4.1.1 p.29)*
- Output 1-50 uF; series resistor optional; output ESR 1-1.5 ohm recommended; add a high-frequency capacitor in parallel at the output. *(9.4.1.1 p.29-30)*
- Reference layout example. *(Fig. 9-3 p.30)*

| Part | Role | Side / IC side | Nearest pin | Gap mm | Budget mm | Verdict |
|---|---|---|---|---|---|---|
| C508 | decoupling_cap (VIN 100 nF HF) | F / F | U503.2 | 2.10 | 2.0 (high) | KEEP: REF5030 VIN 100 nF: the nearest part to U503 pin 2 (2.10 mm against 2.0 mm, 0.1 mm over); GND pad in the F.Cu GND fill plus a GND via 1.09 mm away (datasheet 9.3: as close as possible) |
| R508 | analog_network_resistor (output ESR 1R) | F / F | U503.6 | 3.13 | 4.0 (medium) | OK |
| C510 | filter_cap (NR 1 uF film) | F / F | U503.5 | 0.09 | 1.5 (high) | OK |
| C509 | decoupling_cap (VIN 1 uF) | F / F | U503.2 | 0.42 | 2.0 (high) | OK |
| C512 | decoupling_cap (VOUT HF 100 nF) | F / F | U503.6 | 0.32 | 2.0 (high) | OK |
| C511 | filter_cap (output 4.7 uF via R508) | F / F | U503.6 | 1.28 | 6.0 (medium) | OK (no shared net with U503.6) |

## U1301 LMR43620MB5RPER (TI LMR43620 SNVSBY5B)

- The input-capacitor/power-ground loop is the most critical feature: traces wide and short, loop area as small as possible. *(9.5.1 p.39-40, Fig. 9-22 p.40)*
- Min 4.7 uF ceramic at VIN (rated >=Vin max, prefer 2x) plus a small-case 100 nF as close as possible to the regulator (EVM: ~0.38 mm away). *(9.2.2.5 p.31-32)*
- Input capacitors as close as possible to VIN and GND terminals. *(9.5.1 p.40)*
- VCC 1 uF close to the VCC pin with short wide traces to VCC and GND; do not load VCC (except PG pull-up). *(9.5.1 p.40; 9.2.2.7 p.32)*
- CBOOT 100 nF >=16 V close to the device, short/wide traces to BOOT and SW. *(9.5.1 p.40; 9.2.2.6 p.32)*
- Feedback divider (RFBT, RFBB, CFF) physically close to FB; FB and GND connections short; VOUT sense may be longer but never near SW. *(9.5.1 p.40)*
- Keep SW copper short and wide but minimal in area (radiated EMI). *(9.5.1 p.40)*
- Solid ground plane on a middle layer; GND pin to planes with vias next to the bypass caps; keep VIN/SW/GND copper on one side of the plane, sensitive routes on the other side. *(9.5.1 p.40; 9.5.1.1 p.40)*
- Electrolytic/tantalum (20-100 uF) in parallel with input ceramics damps long input leads; no snap-back TVS on VIN. *(9.4 p.39)*
- Reference placement: CIN, CINHF, CVCC, CBOOT, L, COUT, RFBT/RFBB/CFF arrangement. *(Fig. 9-23 p.41)*

| Part | Role | Side / IC side | Nearest pin | Gap mm | Budget mm | Verdict |
|---|---|---|---|---|---|---|
| C201 | decoupling_cap (VIN 100 nF 0603) | F / F | U1301.3 | 1.62 | 2.0 (high) | OK |
| R1302 | divider_resistor (RFBB) | F / F | U1301.8 | 2.57 | 3.0 (high) | OK |
| C1307 | filter_cap (SYNC 47 pF) | F / F | U1301.1 | 1.53 | 2.0 (high) | OK |
| C1306 | decoupling_cap (CINHF 100 nF 0402) | F / F | U1301.4 | 0.44 | 1.0 (critical) | OK |
| C41 | filter_cap (CFF 22 pF) | F / F | U1301.8 | 2.43 | 3.0 (high) | OK |
| C37 | decoupling_cap (VCC 1 uF) | F / F | U1301.7 | 0.68 | 1.5 (critical) | OK |
| L1301 | power_inductor (4.7 uH) | F / F | U1301.5 | 2.09 | 3.0 (high) | OK |
| C1305 | bulk_cap (CIN 10 uF, first) | F / F | U1301.4 | 1.98 | 3.0 (high) | OK |
| C35 | bootstrap_cap (CBOOT 100 nF) | F / F | U1301.5 | 0.44 | 1.5 (critical) | OK |
| C1304 | bulk_cap (CIN 10 uF, second) | F / F | U1301.3 | 3.79 | 5.0 (medium) | OK |
| C1302 | bulk_cap (COUT 22 uF) | F / F | L1301.2 | 1.80 | 4.0 (medium) | OK |
| R1301 | divider_resistor (RFBT) | F / F | U1301.8 | 0.44 | 3.0 (high) | OK |
| C1301 | bulk_cap (COUT 22 uF) | F / F | L1301.2 | 1.11 | 4.0 (medium) | OK |
| C1303 | decoupling_cap (+3V3_D HF at buck output) | F / F | L1301.2 | 1.92 | 5.0 (medium) | OK |
| C1314 | decoupling_cap (+3V3_A 100 nF after FB1301) | F / F | FB1301.2 | 0.40 | 5.0 (medium) | OK |
| C1313 | decoupling_cap (+3V3_A 1 uF after FB1301) | F / F | FB1301.2 | 1.50 | 8.0 (low) | OK |
| C1315 | damper (R-C for FB1301 41.5 kHz resonance) | F / F | FB1301.2 | 2.38 | 10.0 (low) | OK (no shared net with FB1301.2) |
| R1307 | damper (R-C for FB1301 41.5 kHz resonance) | F / F | FB1301.2 | 0.56 | 10.0 (low) | OK |
| R1303 | pull_up_resistor (FPWM default) | B / F | U1301.1 | 0.00 | 10.0 (low) | OK |

## U201 LT3045EMSE#PBF (ADI LT3045 Rev B)

- IN needs a bypass capacitor at the IN pin (4.7 uF generally sufficient); stable with >=4.7 uF IN capacitance. *(p.12; p.18)*
- ILIM resistor Kelvin-connected to the LT3045 GND pin. *(p.12)*
- SET resistor ground side Kelvin-connected to the load. *(p.12)*
- OUTS Kelvin-connected directly to the output capacitor and load; tie GND of COUT and CSET directly together (4-terminal connection, Fig. 3). *(p.13; p.16)*
- COUT >=10 uF, ESR <20 mOhm, ESL <2 nH; ~1 MHz loop bandwidth sits near a 10 uF 1206 SRF, so avoid extra ESR/ESL outside the loop. *(p.13; p.16)*
- SET is high impedance: guard ring tied to OUT on both board sides; 100 nA leakage = 0.1 % error; a 10 nF SET bypass suppresses coupled signals. *(p.15-16)*
- Keep GND sides of CIN and COUT reasonably close; demo-board layout recommended. *(p.16)*
- Switching-frequency current flowing near the LT3045 couples magnetically and can cost >30 dB PSRR at 1 MHz; CIN may only be omitted if the switcher output cap is >1 inch away. *(p.18)*
- A ferrite bead or ~0.5 inch PCB trace between switcher output and LT3045 input filters VHF spikes; 0.1-0.5 ohm series R or higher-ESR tantalum damps long input wiring. *(p.18-19)*

| Part | Role | Side / IC side | Nearest pin | Gap mm | Budget mm | Verdict |
|---|---|---|---|---|---|---|
| C204 | filter_cap (CSET 470 nF film) | F / F | U201.8 | 1.18 | 1.5 (critical) | OK |
| C205 | bulk_cap (COUT 22 uF, primary) | F / F | U201.10 | 0.68 | 1.5 (critical) | OK |
| R203 | setting_resistor (RSET 49.9 k) | F / F | U201.8 | 0.57 | 1.5 (critical) | OK |
| C203 | decoupling_cap (IN 100 nF) | F / F | U201.2 | 0.57 | 2.0 (high) | OK |
| C202 | bulk_cap (CIN 10 uF) | F / F | U201.1 | 0.74 | 3.0 (high) | OK |
| C207 | decoupling_cap (+5V_A HF 100 nF) | F / F | U201.12 | 0.73 | 3.0 (medium) | OK |
| R202 | setting_resistor (RILIM 1 k) | F / F | U201.6 | 0.45 | 3.0 (medium) | OK |
| C206 | bulk_cap (extra +5V_A 10 uF) | F / F | U201.12 | 1.89 | 5.0 (medium) | OK |
| R201 | series_isolation_resistor (input 1R) | F / F | U201.4 | 1.40 | 10.0 (low) | OK |

## U301 SHT40-AD1B-R702 (Sensirion SHT4x datasheet v6.4)

- Typical circuit: 100 nF between VDD and GND, SDA/SCL pull-ups (no placement distance given). *(Fig. 1 p.3)*
- No copper under the sensor other than the pin pads; die pad preferably not soldered (heater). *(5.3 p.15-16 (Fig. 17))*

| Part | Role | Side / IC side | Nearest pin | Gap mm | Budget mm | Verdict |
|---|---|---|---|---|---|---|
| C301 | decoupling_cap (100 nF) | B / B | U301.3 | 0.41 | 3.0 (medium) | OK |

## U401 STM32H743VIT6 (ST STM32H743xI DS12110 Rev 5 + ST AN4938 Rev 6 + ST AN2867 Rev 10)

- VDD: one 100 nF per VDD pin + one >=4.7 uF per package; VDDA: 100 nF + 1 uF; VBAT tied to supply: 100 nF; external VREF+: 100 nF + 1 uF on the pin; VCAP1/VCAP2: 2.2 uF low ESR (<100 mOhm), VCAP1 tied to VCAP2. *(AN4938 2.2 p.12)*
- Optional: VDDA through a ferrite bead; VREF+ to VDDA through ~47 ohm. *(AN4938 2.2 p.13)*
- Decoupling caps as close as possible to, or below on the underside of, the pins; wide short trace/via to planes; non-BGA packages: cap on the same side, distance minimised. *(AN4938 7.4 p.32, Fig. 17 p.33, 9.3 p.38-39 (Fig. 21); DS12110 6.1.6 p.97)*
- VCAP: CEXT 2.2 uF +/-20 %, ESR <100 mOhm. *(DS12110 6.3.2 Table 24 p.101)*
- HSE/LSE resonator and load caps as close as possible to the oscillator pins; LSE crystal CL <=7 pF recommended. *(AN4938 4.1 p.21, 4.1.2 p.22, 4.2.2 p.23)*
- 32 kHz oscillator: crystal close to MCU, short tracks, GND guard ring, HF signals away, local ground plane underneath, avoid stray C and leakage. *(AN2867 5.1 p.26-27 (Fig. 10))*
- NRST: internal pull-up + external filter capacitor (reset circuit); BOOT0 pull-down (10 k typical). *(AN4938 Fig. 6 p.17; 5.2 Fig. 14 p.26)*
- Interrupt/handshake lines are EMC-sensitive: short, ground-surrounded, away from noisy traces. *(AN4938 7.5 p.33)*
- SDMMC: 50 ohm +/-10 %, <120 mm, skew <250 ps, <=20 pF line capacitance at 3.3 V, <16 nH, matched within 10 mm, same via count on data lines, pull-ups on CMD/D. *(AN4938 9.4.1 p.40)*
- QUADSPI: 50 ohm, <120 mm, data on one layer, matched +/-10 mm, CLK spaced 3x width, minimum vias, no serpentine on CLK. *(AN4938 9.4.3 p.41-43)*

| Part | Role | Side / IC side | Nearest pin | Gap mm | Budget mm | Verdict |
|---|---|---|---|---|---|---|
| C1505 | filter_cap (EXP_3V3_SNS 100 nF) | B / F | U401.18 | 2.75 | 3.0 (medium) | OK |
| C414 | filter_cap (+5V_A monitor 100 nF) | B / F | U401.16 | 2.11 | 3.0 (medium) | OK |
| C402 | decoupling_cap (oscillator 100 nF) | F / F | Y401.4 | 0.59 | 1.5 (high) | OK |
| C1201 | filter_cap (EXP_ANA_MON 1 nF C0G) | B / F | U401.15 | 1.07 | 2.0 (high) | OK (U401.28 no longer carries its net; nearest pin on it: 15) |
| R402 | series_termination_resistor (OSC_IN 33R) | F / F | Y401.3 | 0.55 | 1.5 (high) | OK |
| C415 | decoupling_cap (VDDA 100 nF) | F / F | U401.21 | 1.50 | 2.5 (high) | OK |
| C422 | timing_cap (LSE load 10 pF C0G) | B / F | U401.8 | 0.93 | 2.0 (critical) | OK |
| C507 | filter_cap (ADC charge reservoir 1.5 nF C0G) | F / F | U401.32 | 0.42 | 1.5 (critical) | OK |
| C505 | filter_cap (ADC charge reservoir 1.5 nF C0G) | F / F | U401.30 | 0.42 | 1.5 (critical) | OK |
| C421 | timing_cap (LSE load 10 pF C0G) | B / F | U401.9 | 0.71 | 2.0 (critical) | OK |
| C404 | filter_cap (NRST 100 nF) | B / F | U401.14 | 0.49 | 2.0 (high) | OK |
| R603 | series_termination_resistor (PSRAM CLK 33R) | B / F | U401.36 | 1.45 | 3.0 (high) | OK |
| C409 | decoupling_cap (VDD 100 nF) | F / F | U401.27 | 0.80 | 2.5 (high) | OK |
| C416 | decoupling_cap (VDDA 1 uF) | F / F | U401.21 | 3.26 | 5.0 (medium) | OK |
| C419 | internal_regulator_cap (VCAP 2.2 uF) | F / F | U401.48 | 0.72 | 2.5 (high) | OK |
| C420 | internal_regulator_cap (VCAP 2.2 uF) | F / F | U401.73 | 0.53 | 2.5 (high) | OK |
| R1222 | analog_network_resistor (EXP_ANA_MON 1 k) | B / F | U401.15 | 2.02 | 4.0 (medium) | OK (U401.28 no longer carries its net; nearest pin on it: 15) |
| C405 | filter_cap (interrupt RF shunt 1 nF) | B / F | U401.22 | 0.00 | 2.0 (high) | OK |
| C408 | decoupling_cap (VDD 100 nF) | F / F | U401.11 | 0.46 | 2.5 (high) | OK |
| C417 | decoupling_cap (VREF+ 100 nF) | F / F | U401.20 | 0.45 | 2.5 (high) | OK |
| C403 | decoupling_cap (VDD 100 nF) | F / F | U401.100 | 0.44 | 2.5 (high) | OK |
| C410 | decoupling_cap (VDD 100 nF) | F / F | U401.50 | 0.44 | 2.5 (high) | OK |
| C411 | decoupling_cap (VDD 100 nF) | F / F | U401.75 | 0.44 | 2.5 (high) | OK |
| C413 | filter_cap (100 pF injection shunt) | B / F | U401.25 | 0.92 | 3.0 (medium) | OK |
| R1004 | series_termination_resistor (SPI4 SCLK 40 MHz) | F / F | U401.42 | 0.90 | 3.0 (high) | OK |
| C1504 | filter_cap (EXP_VHP_SNS 100 nF) | B / F | U401.17 | 0.44 | 3.0 (medium) | OK |
| C401 | decoupling_cap (VBAT 100 nF) | F / F | U401.6 | 0.43 | 3.0 (medium) | OK |
| C406 | filter_cap (100 pF injection shunt) | B / F | U401.24 | 0.36 | 3.0 (medium) | OK |
| R401 | pull_down_resistor (BOOT0 10 k) | B / F | U401.94 | 0.00 | 3.0 (medium) | OK |
| Y402 | crystal (32.768 kHz LSE) | B / F | U401.8 | 0.00 | 3.0 (critical) | OK |
| C807 | filter_cap (button RC 100 nF) | B / F | U401.2 | 1.74 | 5.0 (medium) | OK |
| Y401 | clock_oscillator (12 MHz CMOS, HSE bypass) | F / F | U401.11 | 2.74 | 6.0 (high) | OK (U401.12 no longer carries its net; nearest pin on it: 100,11,27,50,75) |
| C418 | decoupling_cap (VREF+ 1 uF) | F / F | U401.20 | 1.56 | 5.0 (medium) | OK |
| R404 | series_isolation_resistor (BUCK_SYNC 1 k) | B / F | U401.35 | 1.35 | 5.0 (medium) | OK |
| C407 | decoupling_cap (2nd 100 nF at VDD 50) | B / F | U401.50 | 0.09 | 4.0 (medium) | OK |
| R1507 | divider_resistor (EXP_VHP_SNS bottom) | B / F | U401.17 | 0.88 | 5.0 (medium) | OK |
| R1508 | divider_resistor (EXP_3V3_SNS bottom) | B / F | U401.18 | 0.88 | 5.0 (medium) | OK |
| R602 | series_termination_resistor (PSRAM IO 33R, MCU end) | B / F | U401.1 | 0.68 | 5.0 (medium) | OK |
| C808 | filter_cap (button RC 100 nF) | B / F | U401.3 | 0.54 | 5.0 (medium) | OK |
| R406 | series_isolation_resistor (off-board line) | F / F | U401.25 | 0.47 | 5.0 (medium) | OK |
| R405 | series_isolation_resistor (off-board line) | B / F | U401.24 | 0.27 | 5.0 (medium) | OK |
| R408 | series_isolation_resistor (off-board line) | B / F | U401.31 | 0.13 | 5.0 (medium) | OK |
| R1003 | series_termination_resistor (ADC CS/convert) | B / F | U401.41 | 0.00 | 5.0 (medium) | OK |
| R1201 | series_termination_resistor (EXP SPI SCK 33R) | B / F | U401.52 | 0.00 | 6.0 (medium) | OK |
| R507 | analog_network_resistor (47R isolation) | F / F | C507.1 | 8.70 | 15.0 (low) | OK |
| R1505 | divider_resistor (EXP_VHP_SNS top, at rail) | B / F | U401.17 | 43.33 | 50.0 (low) | OK |
| R1506 | divider_resistor (EXP_3V3_SNS top, at rail) | B / F | U401.18 | 43.13 | 50.0 (low) | OK |
| RN803 | series_termination_resistor (FMC 47R x4) | B / F | U401.86 | 0.60 | 8.0 (medium) | OK |
| RN801 | series_termination_resistor (FMC 47R x4) | F / F | U401.62 | 0.55 | 8.0 (medium) | OK |
| RN802 | series_termination_resistor (FMC 47R x4) | B / F | U401.39 | 0.00 | 8.0 (medium) | OK |
| R505 | analog_network_resistor (47R isolation) | F / F | C505.1 | 5.96 | 15.0 (low) | OK |
| R1207 | series_termination_resistor (EXP SPI/timer 33R-100R) | B / F | U401.64 | 0.25 | 10.0 (medium) | OK |
| R1202 | series_termination_resistor (EXP SPI/timer 33R-100R) | B / F | U401.67 | 0.23 | 10.0 (medium) | OK |
| R1220 | series_termination_resistor (EXP SPI/timer 33R-100R) | B / F | U401.93 | 0.13 | 10.0 (medium) | OK |
| R1203 | series_termination_resistor (EXP SPI/timer 33R-100R) | B / F | U401.54 | 0.00 | 10.0 (medium) | OK |
| R409 | divider_resistor (+5V_A monitor 100k/100k) | B / F | U401.16 | 1.85 | 12.0 (low) | OK |
| R407 | divider_resistor (+5V_A monitor 100k/100k) | B / F | U401.16 | 1.80 | 12.0 (low) | OK |
| C412 | bulk_cap (+3V3_D >=4.7 uF per package) | F / F | U401.50 | 1.74 | 15.0 (low) | OK |
| R1005 | pull_up_resistor (EXTADC_CS_N) | B / F | U401.41 | 0.72 | 15.0 (low) | OK |
| R1501 | pull_up_resistor (EXP_FAULT_N) | B / F | U401.87 | 0.48 | 15.0 (low) | OK |
| R1219 | series_termination_resistor (EXP_GATE 1 kHz) | B / F | U401.29 | 0.13 | 15.0 (low) | OK |

## U602 APS6404L-3SQR-SN (AP Memory APS6404L-3SQR Rev 2.7)

- Decoupling required on VDD: low-ESR 1 uF as close to VDD as possible; optional 0.1 uF improves HF transients. *(16.4 p.25)*
- System load capacitance per pin <=15 pF. *(Table 7 p.24)*

| Part | Role | Side / IC side | Nearest pin | Gap mm | Budget mm | Verdict |
|---|---|---|---|---|---|---|
| C604 | decoupling_cap (VDD 1 uF, primary) | F / F | U602.8 | 0.55 | 2.0 (high) | OK |
| C603 | decoupling_cap (VDD 100 nF, optional HF) | F / F | U602.8 | 0.49 | 2.0 (high) | OK |
| R604 | pull_up_resistor (CE# 10 k) | B / F | U602.1 | 0.00 | 15.0 (low) | OK |
