Able-Digital-Logic/UnintendedAntennaClub3/Hardware/RFVD_SENSOR_BOARD_Rev6/docs/REFERENCE_MAP_ECO-003.md

# Reference map: ECO-003 (2026-10-07)

ECO-003 renumbered every designator by sheet: page × 100 + index in reading order (R1301 is the first resistor on page 13).
Documents dated before 2026-10-07 use the old designators. Look them up here.

## Designators by sheet

### Battery and power

| Old | New | Value |
|---|---|---|
| C33 | C201 | 100nF 50V X7R |
| C31 | C202 | 22uF 25V X5R |
| C29 | C203 | 100nF 50V X7R |
| C34 | C204 | 470nF film |
| C36 | C205 | 22uF 25V X5R |
| C38 | C206 | 10uF 16V X7R |
| C40 | C207 | 100nF 50V X7R |
| R902 | R201 | 1R 5% 1/16W |
| R15 | R202 | 1k 1% 1/16W |
| R14 | R203 | 49.9k 0.1% |
| TP10 | TP201 | +5V_A |
| TP13 | TP202 | GND_POWER |
| U7 | U201 | LT3045EMSE#PBF (+5V_A) |

### Temperature monitor

| Old | New | Value |
|---|---|---|
| C701 | C301 | 100nF 50V X7R |
| C71 | C302 | 100nF 50V X7R |
| R54 | R301 | 2.2k 1% 1/16W |
| R53 | R302 | 2.2k 1% 1/16W |
| U701 | U301 | SHT40-AD1B-R2 |
| U11 | U302 | TMP117AIDRVR |

### STM32H743 controller

| Old | New | Value |
|---|---|---|
| C603 | C401 | 100nF 50V X7R |
| C93 | C402 | 100nF 50V X7R |
| C54 | C403 | 100nF 50V X7R |
| C46 | C404 | 100nF 50V X7R |
| C907 | C405 | 1nF 50V C0G |
| C909 | C406 | 100pF 50V C0G |
| C47 | C407 | 100nF 50V X7R |
| C50 | C408 | 100nF 50V X7R |
| C53 | C409 | 100nF 50V X7R |
| C55 | C410 | 100nF 50V X7R |
| C58 | C411 | 100nF 50V X7R |
| C60 | C412 | 10uF 16V X7R |
| C910 | C413 | 100pF 50V C0G |
| C61 | C414 | 100nF 50V X7R |
| C48 | C415 | 100nF 50V X7R |
| C51 | C416 | 1uF 25V X7R |
| C56 | C417 | 100nF 50V X7R |
| C59 | C418 | 1uF 25V X7R |
| C49 | C419 | 2.2uF 16V X5R |
| C52 | C420 | 2.2uF 16V X5R |
| C602 | C421 | 10pF 50V C0G |
| C601 | C422 | 10pF 50V C0G |
| R20 | R401 | 10k 1% 1/16W |
| R26 | R402 | 33R 1% 1/16W |
| R601 | R403 | 10k 1% 1/16W |
| R901 | R404 | 1k 1% 1/16W |
| R904 | R405 | 330R 1% 1/16W |
| R905 | R406 | 330R 1% 1/16W |
| R25 | R407 | 100k 0.1% 1/10W |
| R906 | R408 | 330R 1% 1/16W |
| R24 | R409 | 100k 0.1% 1/10W |
| U8 | U401 | STM32H743VIT6 |
| Y1 | Y401 | 12MHz 3.3V CMOS |
| Y2 | Y402 | 32.768kHz 7pF |

### Analog acquisition

| Old | New | Value |
|---|---|---|
| C11 | C501 | 510pF 50V C0G 1% |
| C18 | C502 | 1.2nF 50V C0G 1% |
| C12 | C503 | 470pF 50V C0G 1% |
| C19 | C504 | 470pF 50V C0G 1% |
| C22 | C505 | 2.2nF 50V C0G |
| C17 | C506 | 10nF 50V C0G |
| C21 | C507 | 2.2nF 50V C0G |
| C902 | C508 | 100nF 50V X7R |
| C23 | C509 | 1uF 25V X7R |
| C24 | C510 | 1uF 25V film |
| C25 | C511 | 4.7uF 25V X7R |
| C26 | C512 | 100nF 50V X7R |
| C13 | C513 | 100nF 50V X7R |
| C14 | C514 | 1uF 25V X7R |
| C15 | C515 | 100nF 50V X7R |
| C20 | C516 | 1uF 25V X7R |
| R4 | R501 | 2.26k 0.1% 1/10W |
| R6 | R502 | 2.26k 0.1% 1/10W |
| R8 | R503 | 1.33k 0.1% 1/10W |
| R10 | R504 | 1.33k 0.1% 1/10W |
| R12 | R505 | 33R 1% 1/10W |
| R3 | R506 | 22.6k 0.1% 1/10W |
| R11 | R507 | 33R 1% 1/10W |
| R13 | R508 | 1R 5% 1/16W |
| TP3 | TP501 | VENV_RAW |
| TP5 | TP502 | VENV_BUF |
| TP2 | TP503 | EREF_RAW |
| TP8 | TP504 | +3V0_REF |
| TP4 | TP505 | GND_ANALOG |
| U4 | U501 | OPA2320 |
| U3 | U502 | OPA2320 |
| U5 | U503 | REF5030IDR |

### SD and capture memory

| Old | New | Value |
|---|---|---|
| C62 | C601 | 100nF 50V X7R |
| C63 | C602 | 47uF 10V POLY |
| C64 | C603 | 100nF 50V X7R |
| C65 | C604 | 1uF 25V X7R |
| J3 | J601 | DM3AT-SF-PEJM5 |
| R907 | R601 | 1R 5% 1/16W |
| R64 | R602 | 33R 1% 1/10W |
| R39 | R603 | 33R 1% 1/10W |
| R40 | R604 | 4.7k 1% 1/10W |
| RN60 | RN601 | 47R x4 |
| U901 | U601 | EMIF06-MSD02N16 |
| U9 | U602 | APS6404L-3SQR-SN |

### RF input and detector

| Old | New | Value |
|---|---|---|
| C1 | C701 | 100nF 50V X7R |
| C5 | C702 | 1uF 25V X7R |
| C4 | C703 | 100pF 50V C0G |
| C3 | C704 | 100pF 50V C0G |
| C6 | C705 | 1nF 50V C0G |
| C8 | C706 | 1nF 50V C0G |
| C300 | C707 | 1nF 50V C0G |
| C2 | C708 | 47pF 100V C0G 1% |
| C901 | C709 | 100nF 50V X7R |
| C7 | C710 | 100nF 50V X7R |
| D1 | D701 | PESD5V0H1BSF |
| D300 | D702 | PESD5V0H1BSF |
| FL1 | FL701 | NFM18PC104R1C3D |
| J300 | J701 | CAL_IN |
| J1 | J702 | AIMD_IN |
| R302 | R701 | 3.32k 0.1% 1/16W |
| R2 | R702 | 1.50k 0.1% 1/16W |
| R300 | R703 | 100R 0.1% 1/10W |
| R301 | R704 | 100R 0.1% 1/10W |
| R903 | R705 | DNP |
| R1 | R706 | 1.50k 0.1% 1/16W |
| TP1 | TP701 | VRMS_DIAG |
| U1 | U701 | TLV809EA46DBZR |
| U2 | U702 | ADL5511ACPZ-R7 |

### Screen and controls

| Old | New | Value |
|---|---|---|
| C203 | C801 | 47pF 50V C0G |
| C202 | C802 | 47pF 50V C0G |
| C200 | C803 | 1uF 25V X7R |
| C201 | C804 | 100nF 50V X7R |
| C66 | C805 | 1uF 25V X7R |
| C69 | C806 | 100nF 50V X7R |
| C67 | C807 | 100nF 50V X7R |
| C70 | C808 | 100nF 50V X7R |
| C206 | C809 | 1uF 25V X7R |
| C207 | C810 | 100pF 50V C0G |
| C205 | C811 | 100nF 50V X7R |
| D201 | D801 | NSI45020A |
| D202 | D802 | NSI45020A |
| D203 | D803 | NSI45020A |
| D204 | D804 | NSI45020A |
| F201 | F801 | 200mA PTC |
| FB201 | FB801 | 600R@100MHz |
| J4 | J801 | XF2M-4015-1A |
| J8 | J802 | 84953-6 |
| Q202 | Q801 | 2N7002 |
| Q201 | Q802 | AO3401A |
| Q203 | Q803 | AO3400A |
| R48 | R801 | 4.7k 1% 1/10W |
| R41 | R802 | 100k 0.1% 1/10W |
| R43 | R803 | 100k 0.1% 1/10W |
| R213 | R804 | 100R 1% 1/16W |
| R205 | R805 | 10k 1% 1/16W |
| R51 | R806 | 100k 0.1% 1/10W |
| R46 | R807 | 1k 1% 1/16W |
| R47 | R808 | 1k 1% 1/16W |
| R210 | R809 | 10k 1% 1/16W |
| R209 | R810 | 100k 1% 1/16W |
| R211 | R811 | 100R 1% 1/16W |
| R52 | R812 | 100k 0.1% 1/10W |
| R45 | R813 | 4.7k 1% 1/10W |
| R42 | R814 | 4.7k 1% 1/10W |
| R208 | R815 | 10k 1% 1/16W |
| RN201 | RN801 | 47R x4 |
| RN202 | RN802 | 47R x4 |
| RN203 | RN803 | 47R x4 |
| SW1 | SW801 | RECORD / STOP |
| SW2 | SW802 | MARK |
| TP902 | TP801 | DISP_GND |
| TP903 | TP802 | DISP_GND |
| TP901 | TP803 | DISP_GND |
| U10 | U801 | TPS2553DDBVR |

### Programming and service

| Old | New | Value |
|---|---|---|
| J6 | J901 | TC2030-NL SWD POGO DNP |
| TP16 | TP901 | GND_SERVICE |

### External ADC

| Old | New | Value |
|---|---|---|
| C105 | C1001 | 1uF 25V X7R |
| C106 | C1002 | 1uF 25V X7R |
| C107 | C1003 | 1uF 25V X7R |
| C101 | C1004 | 2.2nF 50V C0G |
| C102 | C1005 | 2.2nF 50V C0G |
| C103 | C1006 | 1uF 25V X7R |
| C104 | C1007 | 100nF 50V X7R |
| D12 | D1001 | PMEG6030EP |
| R102 | R1001 | 1R 5% 1/16W |
| R101 | R1002 | 33R 1% 1/16W |
| R106 | R1003 | 33R 1% 1/16W |
| R104 | R1004 | 33R 1% 1/16W |
| R108 | R1005 | 10k 1% 1/16W |
| R100 | R1006 | 100R 1% 1/16W |
| R103 | R1007 | 100R 1% 1/16W |
| U13 | U1001 | AD7380BCPZ-RL7 |

### Battery, charger and USB-C

| Old | New | Value |
|---|---|---|
| C321 | C1101 | 1nF |
| C312 | C1102 | 4.7uF 16V X5R |
| C301 | C1103 | 1uF 25V X7R |
| C303 | C1104 | 10uF 16V X7R |
| C304 | C1105 | 10uF 16V X7R |
| C305 | C1106 | 100nF 50V X7R |
| C310 | C1107 | 47nF 25V X7R |
| C309 | C1108 | 100nF 50V X7R |
| C306 | C1109 | 10uF 16V X7R |
| C307 | C1110 | 10uF 16V X7R |
| C308 | C1111 | 10uF 16V X7R |
| C311 | C1112 | 47nF 25V X7R |
| C318 | C1113 | 100nF 50V X7R |
| C313 | C1114 | 10uF 16V X7R |
| C314 | C1115 | 10uF 16V X7R |
| C315 | C1116 | 10uF 16V X7R |
| C316 | C1117 | 10uF 16V X7R |
| C317 | C1118 | 10uF 16V X7R |
| D301 | D1101 | TPD1E10B06DYAR |
| J10 | J1101 | TYPE-C-31-M-12 |
| L301 | L1101 | 1uH |
| R306 | R1101 | 51k 1% 1/16W |
| R307 | R1102 | 20k 1% 1/16W |
| R305 | R1103 | 6.04k 1% 1/16W |
| R308 | R1104 | 5.23k 1% 1/16W |
| R309 | R1105 | 30.1k 1% 1/16W |
| R310 | R1106 | 10k |
| R311 | R1107 | 10k 1% 1/16W |
| R312 | R1108 | 10k 1% 1/16W |
| R303 | R1109 | 100k 1% 1/16W |
| R324 | R1110 | 100k 1% 1/16W |
| R323 | R1111 | 100k 1% 1/16W |
| R320 | R1112 | 5.23k 1% 1/16W |
| R321 | R1113 | 5.23k 1% 1/16W |
| SW5 | SW1101 | B3U-1000P |
| TP305 | TP1101 | POGO_D+ |
| TP306 | TP1102 | POGO_D- |
| TP307 | TP1103 | POGO_GND |
| TP301 | TP1104 | CHG_STAT |
| TP304 | TP1105 | POGO_VBUS |
| U301 | U1101 | BQ25798RQMR |
| U304 | U1102 | TPD4E05U06DQAR |

### Expansion mezzanine

| Old | New | Value |
|---|---|---|
| C412 | C1201 | 1nF 50V C0G |
| C409 | C1202 | 100nF 50V X7R |
| C410 | C1203 | 100nF 50V X7R |
| D401 | D1201 | TPD4E05U06DQAR |
| D402 | D1202 | TPD4E05U06DQAR |
| D403 | D1203 | TPD4E05U06DQAR |
| D406 | D1204 | TPD4E05U06DQAR |
| D404 | D1205 | TPD4E05U06DQAR |
| D405 | D1206 | TPD4E05U06DQAR |
| H5 | H1201 | BSMTSOM250BTR |
| H6 | H1202 | BSMTSOM250BTR |
| J11 | J1201 | LSHM-120-02.5-L-DV-A-N-K-TR |
| R419 | R1201 | 33R 1% 1/16W |
| R420 | R1202 | 33R 1% 1/16W |
| R421 | R1203 | 33R 1% 1/16W |
| R422 | R1204 | 1k 1% 1/16W |
| R442 | R1205 | 10k 1% 1/16W |
| R423 | R1206 | 33R 1% 1/16W |
| R424 | R1207 | 33R 1% 1/16W |
| R425 | R1208 | 330R 1% 1/16W |
| R426 | R1209 | 330R 1% 1/16W |
| R441 | R1210 | 10k 1% 1/16W |
| R418 | R1211 | 2.2k 1% 1/16W |
| R417 | R1212 | 2.2k 1% 1/16W |
| R439 | R1213 | 100k 1% 1/16W |
| R427 | R1214 | 330R 1% 1/16W |
| R437 | R1215 | 100k 1% 1/16W |
| R436 | R1216 | 100k 1% 1/16W |
| R440 | R1217 | 100k 1% 1/16W |
| R431 | R1218 | 330R 1% 1/16W |
| R433 | R1219 | 33R 1% 1/16W |
| R434 | R1220 | 100R 1% 1/16W |
| R438 | R1221 | 100k 1% 1/16W |
| R435 | R1222 | 1k 1% 1/16W |
| RN401 | RN1201 | 330R x4 |
| U403 | U1201 | TCA9517ADGKR |

### 3.3 V supplies

| Old | New | Value |
|---|---|---|
| C39 | C1301 | 22uF 10V X5R |
| C42 | C1302 | 22uF 10V X5R |
| C903 | C1303 | 100nF 50V X7R |
| C28 | C1304 | 10uF 16V X7R |
| C30 | C1305 | 10uF 16V X7R |
| C32 | C1306 | 100nF 50V X7R |
| C900 | C1307 | 47pF 50V C0G |
| C911 | C1308 | 1uF 25V X7R |
| C912 | C1309 | 10uF 16V X7R |
| C913 | C1310 | 100nF 50V X7R |
| C914 | C1311 | 22uF 25V X5R |
| C915 | C1312 | 1uF 25V X7R |
| C44 | C1313 | 1uF 25V X7R |
| C45 | C1314 | 100nF 50V X7R |
| C100 | C1315 | 22uF 10V X5R |
| FB1 | FB1301 | 600R@100MHz 500mA |
| FL2 | FL1301 | NFM18PC104R1C3D |
| L1 | L1301 | 2.2uH |
| R16 | R1301 | 15.4k 1% 1/16W |
| R17 | R1302 | 4.87k 1% 1/16W |
| R900 | R1303 | 100k 1% 1/16W |
| R908 | R1304 | 4.87k 1% 1/16W |
| R909 | R1305 | 100k 1% 1/16W |
| R910 | R1306 | 64.9k 1% 1/16W |
| R109 | R1307 | 1R 5% 1/16W |
| TP11 | TP1301 | +3V3_D |
| TP900 | TP1302 | BUCK_SYNC |
| TP12 | TP1303 | +3V3_A |
| U6 | U1301 | TPS62913RPUR |
| U14 | U1302 | TPS7A4701RGWR |

### Battery pack and protection

| Old | New | Value |
|---|---|---|
| C319 | C1401 | 10uF 16V X7R |
| C320 | C1402 | 10uF 16V X7R |
| C904 | C1403 | 100nF 50V X7R |
| C905 | C1404 | 1nF 50V C0G |
| C322 | C1405 | 100nF 50V X7R |
| C323 | C1406 | 100nF 50V X7R |
| C324 | C1407 | 100nF 50V X7R |
| C325 | C1408 | 330nF 25V X7R |
| C326 | C1409 | 1uF 25V X7R |
| C327 | C1410 | 4.7uF 16V X5R |
| F1 | F1401 | MF-MSMF150/24X-2 |
| J2 | J1401 | 2053380004 |
| Q303 | Q1401 | AO3401A |
| Q301 | Q1402 | AO3400A |
| Q302 | Q1403 | 2N7002 |
| R313 | R1401 | 100R 1% 1/16W |
| R314 | R1402 | 0R |
| R322 | R1403 | 100k 1% 1/16W |
| R315 | R1404 | 160R 1% 1/16W |
| R316 | R1405 | 261R 1% 1/16W |
| R317 | R1406 | 100R 1% 1/16W |
| R318 | R1407 | 100R 1% 1/16W |
| R319 | R1408 | 470k 1% 1/16W |
| TP308 | TP1401 | B_VC1 |
| TP303 | TP1402 | VBAT_PACK |
| TP302 | TP1403 | BAL_OVP |
| U302 | U1401 | BQ29209DRBR |
| U303 | U1402 | TPS70933DBVR |

### Expansion power

| Old | New | Value |
|---|---|---|
| C401 | C1501 | 100nF 50V X7R |
| C402 | C1502 | 10uF 16V X7R |
| C403 | C1503 | 100nF 50V X7R |
| C407 | C1504 | 100nF 50V X7R |
| C408 | C1505 | 100nF 50V X7R |
| C404 | C1506 | 100nF 50V X7R |
| C406 | C1507 | 10uF 16V X7R |
| C405 | C1508 | 47nF 25V X7R |
| R403 | R1501 | 10k 1% 1/16W |
| R402 | R1502 | 100k 1% 1/16W |
| R401 | R1503 | 45.3k 1% 1/16W |
| R404 | R1504 | 2.2k 1% 1/16W |
| R412 | R1505 | 100k 1% 1/16W |
| R414 | R1506 | 100k 1% 1/16W |
| R413 | R1507 | 20k 1% 1/16W |
| R415 | R1508 | 100k 1% 1/16W |
| R408 | R1509 | 470k 1% 1/16W |
| R411 | R1510 | 1.5k 1% 1/10W |
| R407 | R1511 | 100k 1% 1/16W |
| R409 | R1512 | 64.9k 1% 1/16W |
| R410 | R1513 | 1.50k 0.1% 1/16W |
| U401 | U1501 | TPS2553DDBVR |
| U402 | U1502 | TPS259631DDAR |

## Renamed nets (named signals)

Cross-sheet signals now carry the hierarchical name `/Sheet name/SIGNAL`. Rails keep their names.

| Old | New |
|---|---|
| /Battery and power/A3V3_DAMP | /3.3 V supplies/A3V3_DAMP |
| /Battery, charger and USB-C/BAL_OVP | /Battery pack and protection/BAL_OVP |
| /Battery, charger and USB-C/BATP | /Battery pack and protection/BATP |
| /Battery, charger and USB-C/BATT_MID | /Battery pack and protection/BATT_MID |
| /Battery, charger and USB-C/BATT_NTC | /Battery pack and protection/BATT_NTC |
| /Battery, charger and USB-C/B_VC1 | /Battery pack and protection/B_VC1 |
| /Battery, charger and USB-C/B_VC2 | /Battery pack and protection/B_VC2 |
| /Battery, charger and USB-C/B_VCB | /Battery pack and protection/B_VCB |
| /Battery, charger and USB-C/B_VDD | /Battery pack and protection/B_VDD |
| /Battery, charger and USB-C/CHG_BAT | /Battery pack and protection/CHG_BAT |
| /Battery, charger and USB-C/PACK_FUSED | /Battery pack and protection/PACK_FUSED |
| /Battery, charger and USB-C/PACK_RAW | /Battery pack and protection/PACK_RAW |
| /Battery, charger and USB-C/SDRV | /Battery pack and protection/SDRV |
| /Expansion mezzanine/EXP_VHP_OVLO | /Expansion power/EXP_VHP_OVLO |
| ADC_EREF | /Analog acquisition/ADC_EREF |
| ADC_VENV | /Analog acquisition/ADC_VENV |
| BOOT0 | /STM32H743 controller/BOOT0 |
| BUCK_SYNC | /3.3 V supplies/BUCK_SYNC |
| CHG_CE | /Battery, charger and USB-C/CHG_CE |
| CHG_INT_N | /Battery, charger and USB-C/CHG_INT_N |
| EREF_BUF | /Analog acquisition/EREF_BUF |
| EREF_RAW | /Analog acquisition/EREF_RAW |
| EXP_3V3_EN | /Expansion power/EXP_3V3_EN |
| EXP_3V3_SNS | /Expansion power/EXP_3V3_SNS |
| EXP_ANA_MON_MCU | /Expansion mezzanine/EXP_ANA_MON_MCU |
| EXP_CS0_N_MCU | /Expansion mezzanine/EXP_CS0_N_MCU |
| EXP_CS1_N_MCU | /Expansion mezzanine/EXP_CS1_N_MCU |
| EXP_DETECT_N_MCU | /Expansion mezzanine/EXP_DETECT_N_MCU |
| EXP_FAULT_N | /Expansion power/EXP_FAULT_N |
| EXP_GATE_MCU | /Expansion mezzanine/EXP_GATE_MCU |
| EXP_INT0_N_MCU | /Expansion mezzanine/EXP_INT0_N_MCU |
| EXP_INT1_N_MCU | /Expansion mezzanine/EXP_INT1_N_MCU |
| EXP_IO0_MCU | /Expansion mezzanine/EXP_IO0_MCU |
| EXP_IO1_MCU | /Expansion mezzanine/EXP_IO1_MCU |
| EXP_MISO_MCU | /Expansion mezzanine/EXP_MISO_MCU |
| EXP_MOSI_MCU | /Expansion mezzanine/EXP_MOSI_MCU |
| EXP_RST_N_MCU | /Expansion mezzanine/EXP_RST_N_MCU |
| EXP_SCK_MCU | /Expansion mezzanine/EXP_SCK_MCU |
| EXP_SYNC_MCU | /Expansion mezzanine/EXP_SYNC_MCU |
| EXP_TMR0_MCU | /Expansion mezzanine/EXP_TMR0_MCU |
| EXP_TMR1_MCU | /Expansion mezzanine/EXP_TMR1_MCU |
| EXP_TMR_IN_MCU | /Expansion mezzanine/EXP_TMR_IN_MCU |
| EXP_VHP_EN | /Expansion power/EXP_VHP_EN |
| EXP_VHP_SNS | /Expansion power/EXP_VHP_SNS |
| EXTADC_CS_N | /External ADC/EXTADC_CS_N |
| EXTADC_SCLK | /External ADC/EXTADC_SCLK |
| EXTADC_SDI | /External ADC/EXTADC_SDI |
| EXTADC_SDOA | /External ADC/EXTADC_SDOA |
| I2C_SCL | /I2C_SCL |
| I2C_SDA | /I2C_SDA |
| LCD_BL | /STM32H743 controller/LCD_BL |
| LCD_CS_N_MCU | /STM32H743 controller/LCD_CS_N_MCU |
| LCD_D0_MCU | /STM32H743 controller/LCD_D0_MCU |
| LCD_D1_MCU | /STM32H743 controller/LCD_D1_MCU |
| LCD_D2_MCU | /STM32H743 controller/LCD_D2_MCU |
| LCD_D3_MCU | /STM32H743 controller/LCD_D3_MCU |
| LCD_D4_MCU | /STM32H743 controller/LCD_D4_MCU |
| LCD_D5_MCU | /STM32H743 controller/LCD_D5_MCU |
| LCD_D6_MCU | /STM32H743 controller/LCD_D6_MCU |
| LCD_D7_MCU | /STM32H743 controller/LCD_D7_MCU |
| LCD_DC_MCU | /STM32H743 controller/LCD_DC_MCU |
| LCD_RST | /STM32H743 controller/LCD_RST |
| LCD_WR_N_MCU | /STM32H743 controller/LCD_WR_N_MCU |
| MARK_N | /Screen and controls/MARK_N |
| MARK_N_MCU | /STM32H743 controller/MARK_N_MCU |
| NRST | /Programming and service/NRST |
| PSRAM_CLK_MCU | /SD and capture memory/PSRAM_CLK_MCU |
| PSRAM_CS_N | /SD and capture memory/PSRAM_CS_N |
| PSRAM_IO0_MCU | /SD and capture memory/PSRAM_IO0_MCU |
| PSRAM_IO1_MCU | /SD and capture memory/PSRAM_IO1_MCU |
| PSRAM_IO2_MCU | /SD and capture memory/PSRAM_IO2_MCU |
| PSRAM_IO3_MCU | /SD and capture memory/PSRAM_IO3_MCU |
| RECORD_N | /Screen and controls/RECORD_N |
| RECORD_N_MCU | /STM32H743 controller/RECORD_N_MCU |
| SD_CD_N | /SD and capture memory/SD_CD_N |
| SD_CLK_MCU | /SD and capture memory/SD_CLK_MCU |
| SD_CMD_MCU | /SD and capture memory/SD_CMD_MCU |
| SD_D0_MCU | /SD and capture memory/SD_D0_MCU |
| SD_D1_MCU | /SD and capture memory/SD_D1_MCU |
| SD_D2_MCU | /SD and capture memory/SD_D2_MCU |
| SD_D3_MCU | /SD and capture memory/SD_D3_MCU |
| SWCLK | /Programming and service/SWCLK |
| SWDIO | /Programming and service/SWDIO |
| TP_INT | /STM32H743 controller/TP_INT |
| TP_RST | /STM32H743 controller/TP_RST |
| TP_SCL | /STM32H743 controller/TP_SCL |
| TP_SDA | /STM32H743 controller/TP_SDA |
| UI_EN | /STM32H743 controller/UI_EN |
| UI_FAULT_N | /STM32H743 controller/UI_FAULT_N |
| USB_DM | /Battery, charger and USB-C/USB_DM |
| USB_DP | /Battery, charger and USB-C/USB_DP |
| VENV_BUF | /Analog acquisition/VENV_BUF |
| VENV_RAW | /Analog acquisition/VENV_RAW |
