Able-Digital-Logic/UnintendedAntennaClub3/Hardware/RFVD_SENSOR_BOARD_Rev6/docs/WORKPLAN_2026-10-03.md

# Work plan: "modify until perfect" (merged critique + placement revision), 2026-10-03

> Designators in this dated record predate ECO-003 (2026-10-07). Look up the current ones in [`REFERENCE_MAP_ECO-003.md`](REFERENCE_MAP_ECO-003.md).

**Sources**
- Critique workflow wf_4fba49dd-dc3: 19 lenses, 229 agents, every finding adversarially verified.
- Placement revision wf_5310b9f1-82d: 11 modules, a challenge per module, the track analyst and a merged move plan.
- Full texts: session scratch `goal17/critique_synthesis.md` and `goal17/placement_plan.md`.

**Master:** m17 (`f536efcf8e`). Both workflows ran on m16; every board item below was re-applied and re-verified on m17.

**Progress (2026-10-04)**

| Checkpoint | State |
|---|---|
| 1 | Landed. Board `5c22d06d54`. |
| 2a | Landed. Board `c4383fe7ab`. Groups G1b, G2, G3, G4a and the PACK_RAW class fix. See LAYOUT_STATUS. |
| 2b | **Landed.** Board `f539f0317c`, DRC 0 errors. G4a2 (P1-20 FMC regroup, R213) passed. **S-15 (CAT4104) is not possible:** no legal SOIC-8 site near J4 (searched on both sides). D12 therefore takes its fallback: keep the CCRs. D203 stays in K8 as a documented shield-spec exception: a SOD-123, taller than the 0.6 mm K8 limit, so the shield needs a keep-out over it. G4b (S-17, S-19 EMIF06), G5a (S-20, S-22 part, P1-26, P1-27, S-13) and G5b (S-16, S-18, S-24, SC-11) landed with the silkscreen/fab-note and J10 packages. |
| 3 | **Landed.** Board `527e801c62`: rules v11 + stale notes. DRC 278 errors exposed (the checkpoint-4 work list). |
| 4 | Routing. Brief written. |

## Where the board stands (m17 baseline, measured)
| | m17 |
|---|---|
| Routed | 583 / 633 (50 open; feasible.py: 22 legal, 28 blocked) |
| DRC | 3 errors (C106/C24 courtyard, 2x skew_sdmmc), 116 warnings, sign-off PASS |
| ERC | 1 error (U8 VCAP pin_to_pin), 23 warnings (19 KiCad bug #21116 + 4 wire stubs) |
| BOM | JLC BOM missing fitted C100/R109; L1 out of stock; U5/U6 marginal |
| Ratsnest | 4018 mm; excess copper on complete nets 557 mm (recoverable about 363 mm by re-routing) |

## Conflicts between the two reviews, and how they were resolved
| Topic | Critique | Placement | Decision |
|---|---|---|---|
| U1 TLV809 supervisor | S-1: delete U1, tie ENBL to VPOS | Move U1 next to U2 (ENBL on F, no vias) | **Keep U1 and move it.** ADL5511 Rev E Table 3 p.8: "If ENBL is tied directly to VPOS, the maximum supply voltage ramp time must be less than 20 ms". The LT3045 here starts in about 55 ms (CSET 470 nF). Checked in the PDF. S-1 is rejected. |
| C106/C24 courtyard | P1-25: move C106, keep 0603, re-route REGCAP and VLOGIC | B3: C106 changed to 0402 | **P1-25** (no BOM change); verify on m17 |
| F1 / PACK+ | P1-4: F1 at J2.1 (needs S-11/S-14 to free the pocket) | B2: F1 rot 180, Q303 regroup | **B2 now** (verified); P1-4 later if the pocket gets freed |
| R60/R62/R66 PSRAM source R | S-17: RN60 array, delete R61/R63/R65/R67 | B3: R60 changed to 0402 | **S-17** if simplifications are accepted, else B3 |
| R19 / TP9 | S-7 deletes D3+R19; S-10 deletes TP9 | B4 moves them | Follows the S-7 / S-10 decisions |
| R103 (AD7380 SDOA 100R at source) | P2 EXTADC-03 | B3 | One move; rewrite `skew_adc_read` per-net caps |

## Checkpoint 1: needs no decision (built and gated on scratch)
1. **Schematic hygiene (Konnect):**
   - delete the 4 MCU wire stubs;
   - C321 `dnp yes`;
   - clear the custom DNP fields;
   - ERC exclusion for U8 VCAP (C49/C52 2.2 uF, ST AN4938);
   - R409 73.2k → 64.9k (EXP_VHP OVLO above PFM VSYS; P0-6).
2. **Placement B1 + B2 on m17:**
   - Q302-D antenna stub deleted;
   - C4/U1 at U2;
   - R3/C9/TP2 Sallen-Key node;
   - C405 at the U402 dV/dT pin;
   - D301 at the first VBUS via;
   - R323, C39;
   - 5 GND vias in pad;
   - battery regroup Q302/F1/Q303/R322/C904/TP303.
3. **Copper:**
   - EXP_FAULT_N overlapping drills fixed (P0-4);
   - silkscreen labels AIMD/CAL/BAT 2S and the board ID on the board;
   - JLC order-number spot;
   - J6 library mismatch fixed.
4. **Outputs:**
   - JLC BOM regenerated (369 placed parts incl. C100/R109, no ranges, CPL = BOM);
   - EXP_SYNC firmware note.
5. **Gates on scratch:**
   - no net worse;
   - DRC 3 errors / 106 warnings (from 116);
   - ERC 0 errors;
   - sign-off PASS.

## Sourcing and manufacturing (decided 2026-10-04)

**Decisions**
- **Keep the original parts:** U6 LMR43620MB5RPER, U5 REF5030IDR, L1 XGL4020-472MEC 4.7 uH, C9/C11 510 pF.
  - Parts that JLC does not stock (U6, U5, L1, AD7380, OPA2320) are bought by **JLC Global Sourcing** from DigiKey/Mouser.
  - This reverses the stock-substitution answer.
  - Live data: U6's substitute had only 4 in stock at JLC; the originals have 4,495 (U6) and 1,571 (U5) at Mouser; C9/C11 are back to 960 at JLC.
- **Prices are compared per line:** JLC/LCSC, Mouser and DigiKey (`04_parts/tools/sourcing_compare.py`).
- **Generic passives move to JLC Basic parts** where the specification is equal or better (`04_parts/tools/basic_swap.py`).
  - The rule: never at EMC's expense; low impact means take it.

**JLC Standard PCBA facts (jlcpcb.com help, 2026-09-09)**
- Standard PCBA is required: double-sided, 0201.
- Fees:
  - setup $51.12 (double-sided);
  - stencil $16.42;
  - $0.0016 per joint;
  - $1.53 per unique part, basic or extended alike.
- Fewer unique lines saves $1.53 each.
- Minimum 70 x 70 mm with rails, so **the panel (P1-10) is mandatory**.
- Assembling 2 boards out of 5 PCBs is allowed.
- Resin-filled, capped via-in-pad is free on 6-20 layers. Use 0.2 mm drill / 0.45 mm pad to avoid the small-via surcharge.
- US import is DDP, about 35% duty plus the Section 301 surcharge since 2026-07-24; no de-minimis.

## Checkpoint 2: part and schematic decisions (lead answers below)
- **Stock substitutions:** superseded on 2026-10-04 by "keep originals + Global Sourcing" (see above); only the R16/R17 FB-divider fix stays.
- **FB divider** R16/R17 = 23.2k/10k (P1-23).
- **Simplifications**, as chosen, then the board sync of removed or added parts.
- **Mandatory, not optional:**
  - INT pull-ups (P1-26);
  - PA4 pull-up (P1-22);
  - ESD NC ties (P1-27);
  - TP_RST pull-down (SC-05);
  - button series 1k (SC-11);
  - Function-field corrections.

## Checkpoint 3: rules
- P0-5: side-aware courtyard exemptions, which expose about 204 hidden spacing/width errors, plus neck-length caps.
- In3 power width rules.
- hole_to_hole as error.
- Missing rule areas: K6, K8, K11_H6, K21.
- J10 rule.
- Pre-defined track/via sizes.
- skew_sdmmc 17 mm (D20).
- Mask expansion 0.
- Stackup loss tangent and via filling/capping flags.

## Checkpoint 4 onwards: routing (pen.py hand edits, gate after every package)
1. Power necks and widths.
2. Clean-ups.
3. Battery sense.
4. U301 SW nodes.
5. Re-routes forced by the schematic changes.
6. SWD out from under J10.
7. Repairs of the exposed errors.
8. WP1–WP7 for the remaining open links, including SD skew and the USB_DP islands.
9. The west-edge bundle re-route (about −150 mm, SWO/SWCLK from 13/10 vias down to 2).
10. Return vias (R17).
11. Edge fence.

**Final gate:**
- 0 errors and 0 unconnected, or every link legal and guided;
- sign-off PASS;
- track_angle 0.

## Parallel: docs and firmware
- **Firmware contract rev 2 (P1-1):** clock tree, AD7380 REFSEL init, BQ25798 init (PFM_FWD_DIS, SFET_PRESENT, ship), UI power sequencing, EXP sequencing, EXP_SYNC 2.4 MHz.
- **Battery pack spec:** mandatory per-cell PCM (P0-3).
- **J1 input limit:** 22 Vpk CW at 128 MHz (P1-18).
- **Runtime target** (P1-30).
- **Panel / CPL rotation tooling** (P1-10/11).
- **Version control** (P0-8).

## Default answers for the remaining lead decisions (the critique recommendation unless overridden)
- **Mechanical:**
  - D7 Q302 to F and a J2 plug keep-out: yes.
  - D16 AFE GND ring: yes (docs fixed now).
  - D18 F1 at J2.1: later.
  - D19 U301 SW option A.
  - D27 panel rails on the 90 mm edges.
- **Electrical limits and rules:**
  - D17 J1 limit 22 Vpk.
  - D20 skew 17 mm.
  - D21 EXP_SYNC 2.400 MHz.
  - D22 keep R314/C321 as DNP.
  - D24 FB divider 23.2k/10k.
- **Inner planes:**
  - D28 clear In3 only under the SHT40.
  - D29 U.FL In4 stays solid.
- **Fab options:**
  - D30 green mask.
  - D31 local mask 0 on fine-pitch via-in-pad.
