Able-Digital-Logic/UnintendedAntennaClub3/Hardware/RFVD_SENSOR_BOARD_Rev6/tools/jlc_rotations.csv

# JLC CPL rotation corrections by footprint-name regex (re.match; the LAST matching row wins | as in the source tool).
# Source: github.com/matthewlai/JLCKicadTools jlc_kicad_tools/cpl_rotations_db.csv (read 2026-10-04); the same table
# seeds Bouni's kicad-jlcpcb-tools. Arithmetic (cpl_fix_rotations.py): top rot = (rot + corr) % 360; bottom
# rot = (rot - corr) % 360 | then rot = (180 - rot) % 360 (JLC bottom convention since ~July 2022). Community data:
# always confirm pin 1 / polarity in JLC's placement preview before paying.
pattern | rotation | offset_x | offset_y
^R_Array_Convex_ | 90 | 0 | 0
^R_Array_Concave_ | 90 | 0 | 0
^SOT-223 | 180 | 0 | 0
^SOT-23 | -90 | 0 | 0
^SOT-89 | 180 | 0 | 0
^TSOT-23 | 180 | 0 | 0
^SOT-353 | 180 | 0 | 0
^SOT-363 | 180 | 0 | 0
^LQFP- | 270 | 0 | 0
^TQFP- | 270 | 0 | 0
^SOP-4_ | 0 | 0 | 0
^SOP-(?!18_) | 270 | 0 | 0
^TSSOP- | 270 | 0 | 0
^SSOP- | 270 | 0 | 0
^DFN- | 270 | 0 | 0
^SOIC- | 270 | 0 | 0
^SOP-18_ | 0 | 0 | 0
^VSSOP-8_3.0x3.0mm_P0.65mm | 270 | 0 | 0
^VSSOP-8_ | 180 | 0 | 0
^VSSOP-10_ | 270 | 0 | 0
^VSON-8_ | 270 | 0 | 0
^TSOP-6 | 270 | 0 | 0
^UDFN-10 | 270 | 0 | 0
^USON-10 | 270 | 0 | 0
^TDSON-8-1 | 270 | 0 | 0
^CP_EIA- | 180 | 0 | 0
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
