Able-Digital-Logic/UnintendedAntennaClub3/Hardware/RFVD_SENSOR_BOARD_Rev6/docs/reference/Power_USB.png

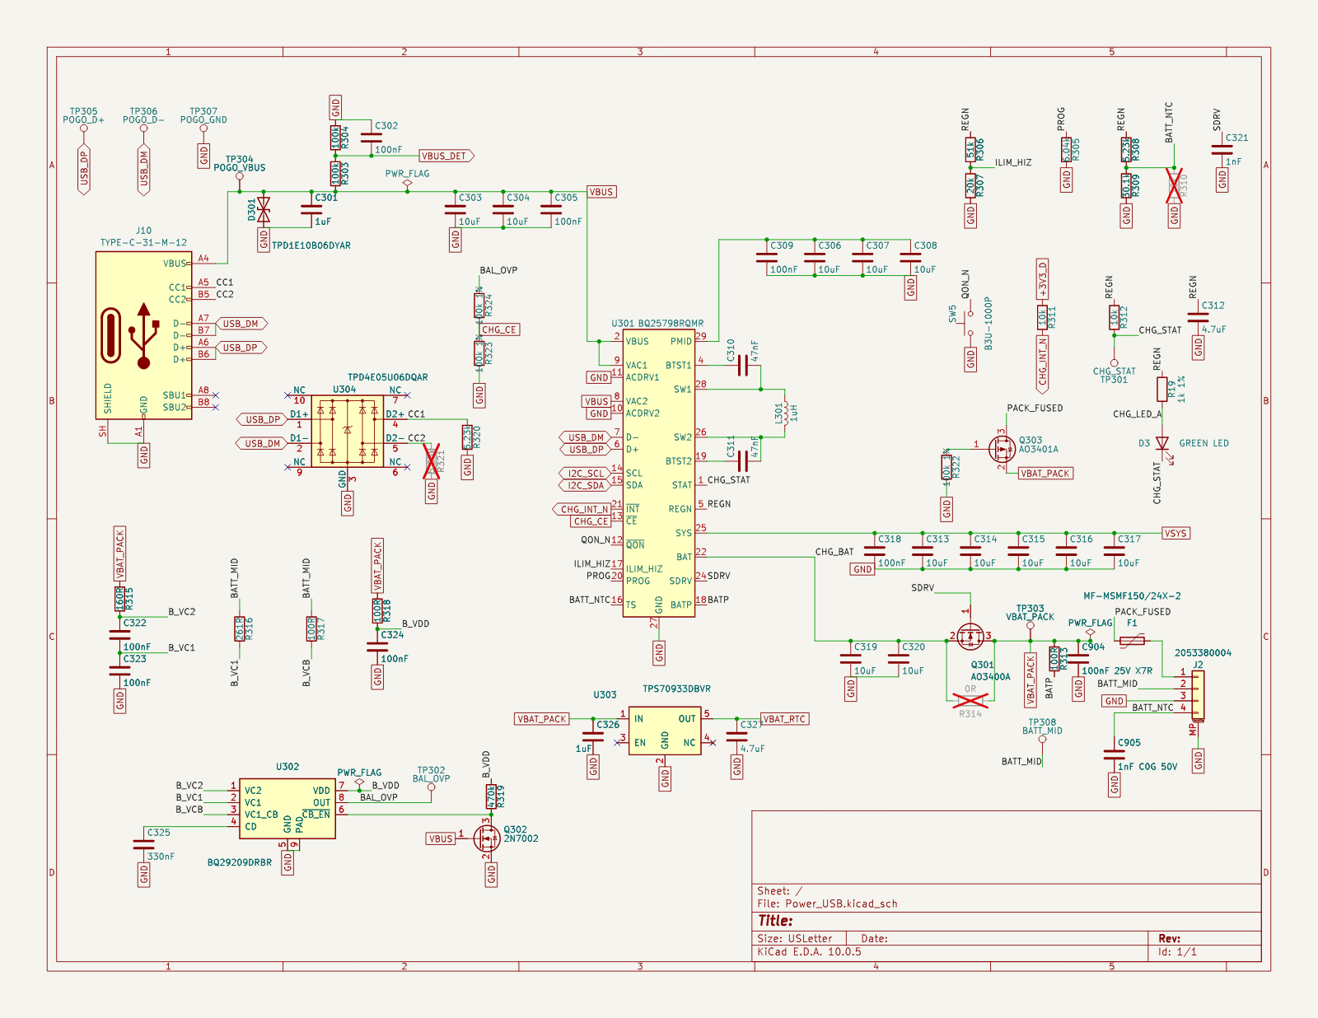
Hardware/RFVD_SENSOR_BOARD_Rev6/docs/reference/Power_USB.png
