Able-Digital-Logic/UnintendedAntennaClub3/Hardware/RFVD_SENSOR_BOARD_Rev6/docs/reference/RF_Input.png

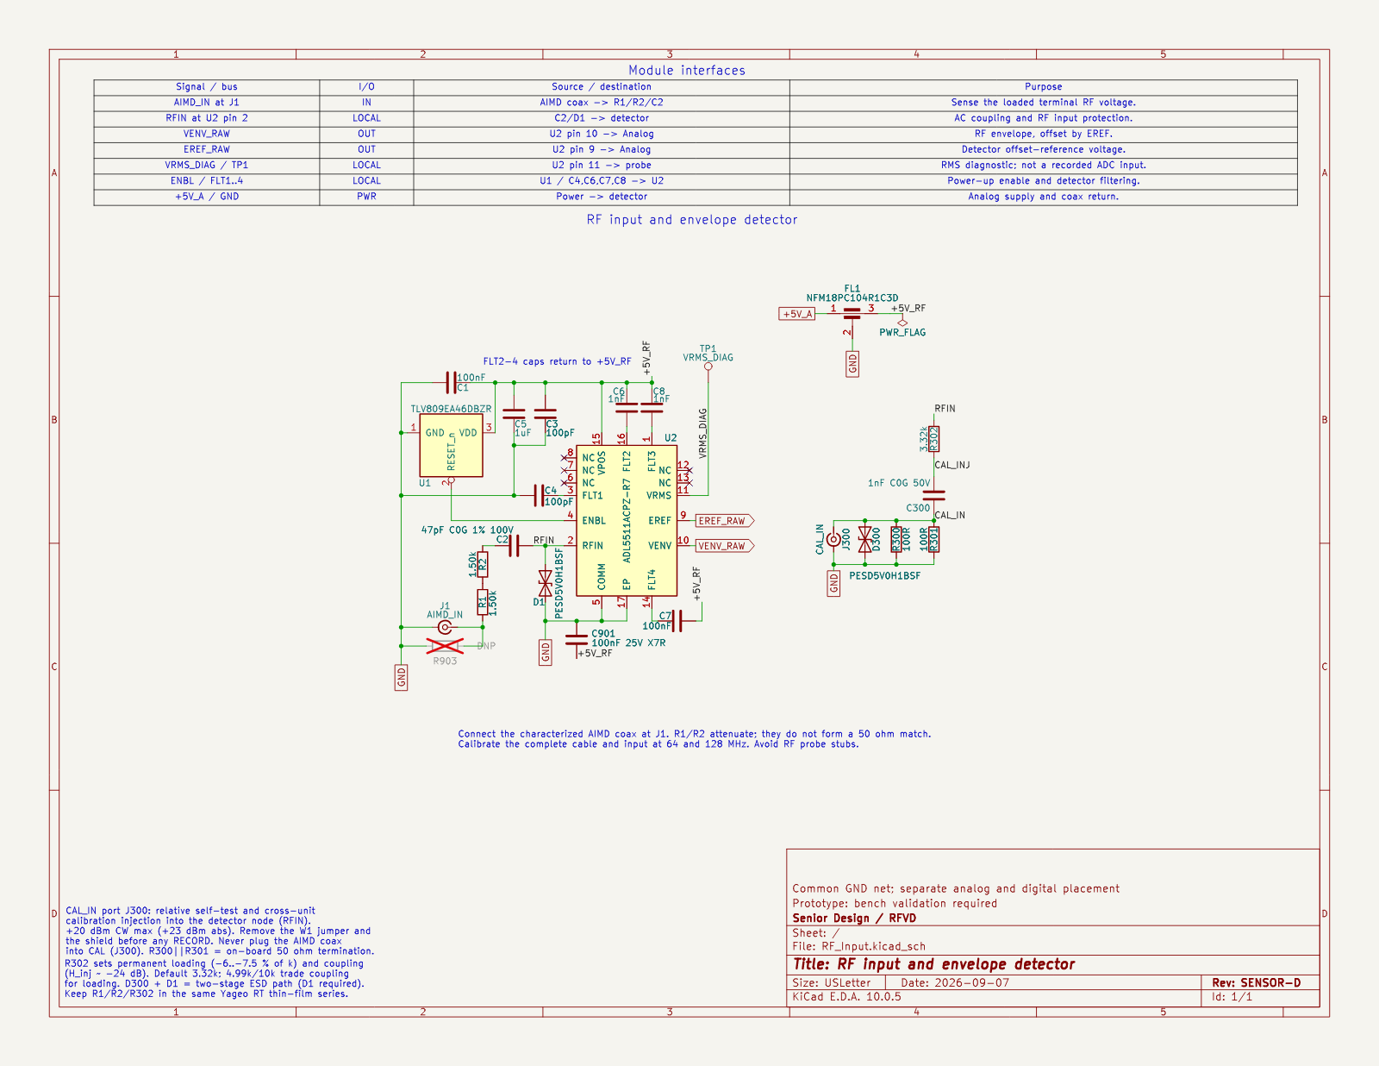
Hardware/RFVD_SENSOR_BOARD_Rev6/docs/reference/RF_Input.png
