Able-Digital-Logic/UnintendedAntennaClub3/Hardware/RFVD_SENSOR_BOARD_Rev6/outputs/RFVD_placement_audit_map.png

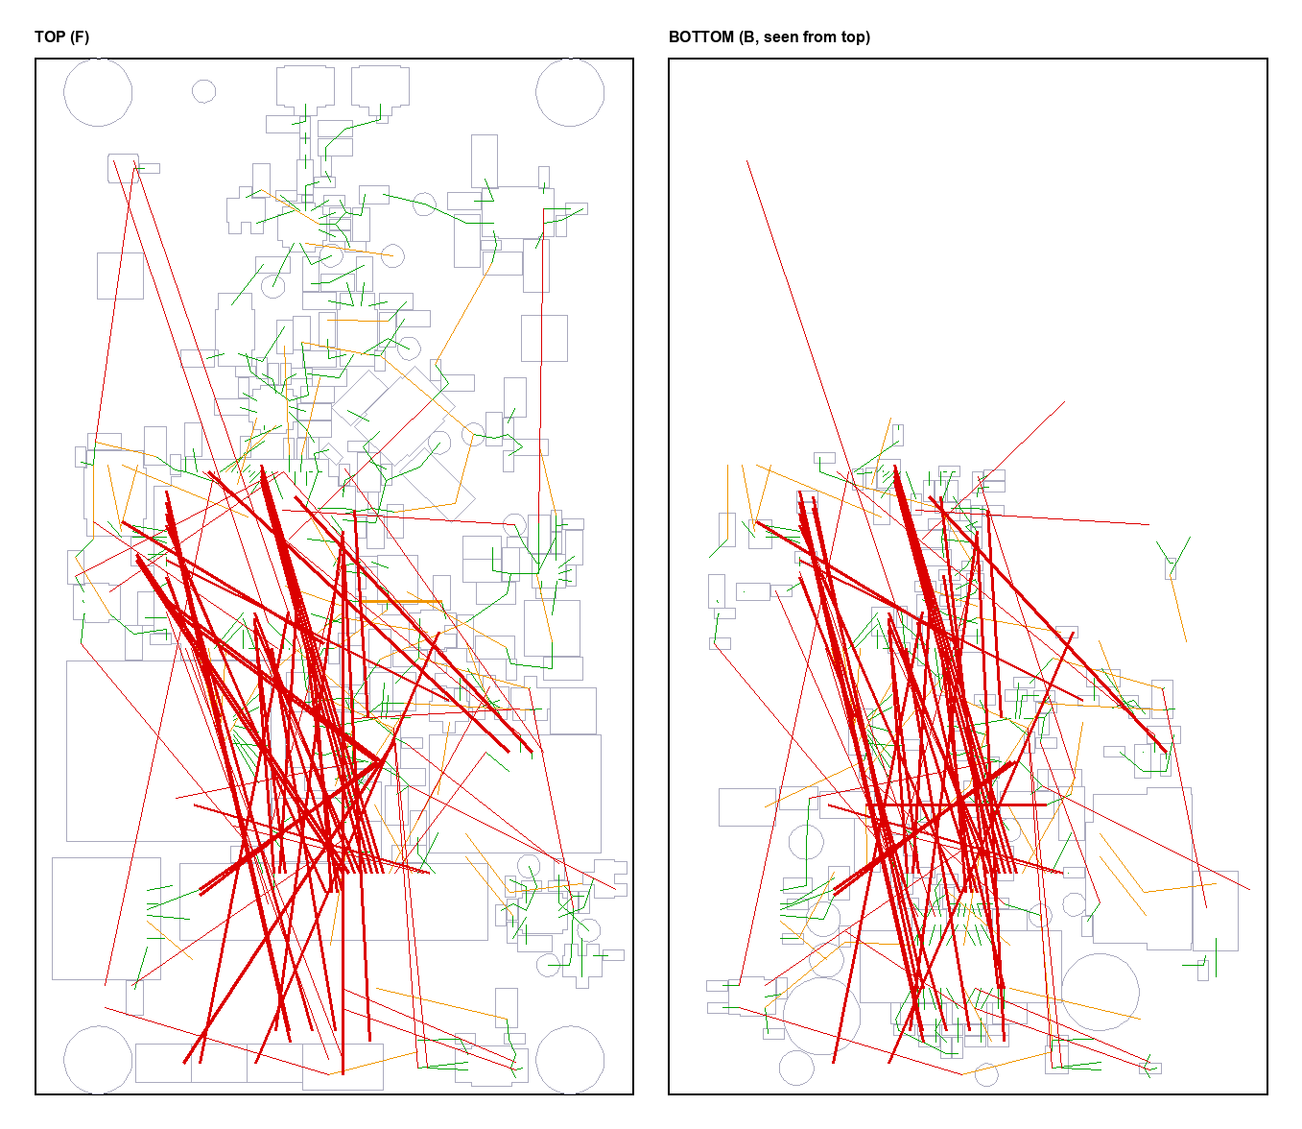
Hardware/RFVD_SENSOR_BOARD_Rev6/outputs/RFVD_placement_audit_map.png
