Able-Digital-Logic/UnintendedAntennaClub3/Hardware/RFVD_SENSOR_BOARD_Rev6/outputs/RFVD_unrouted.png

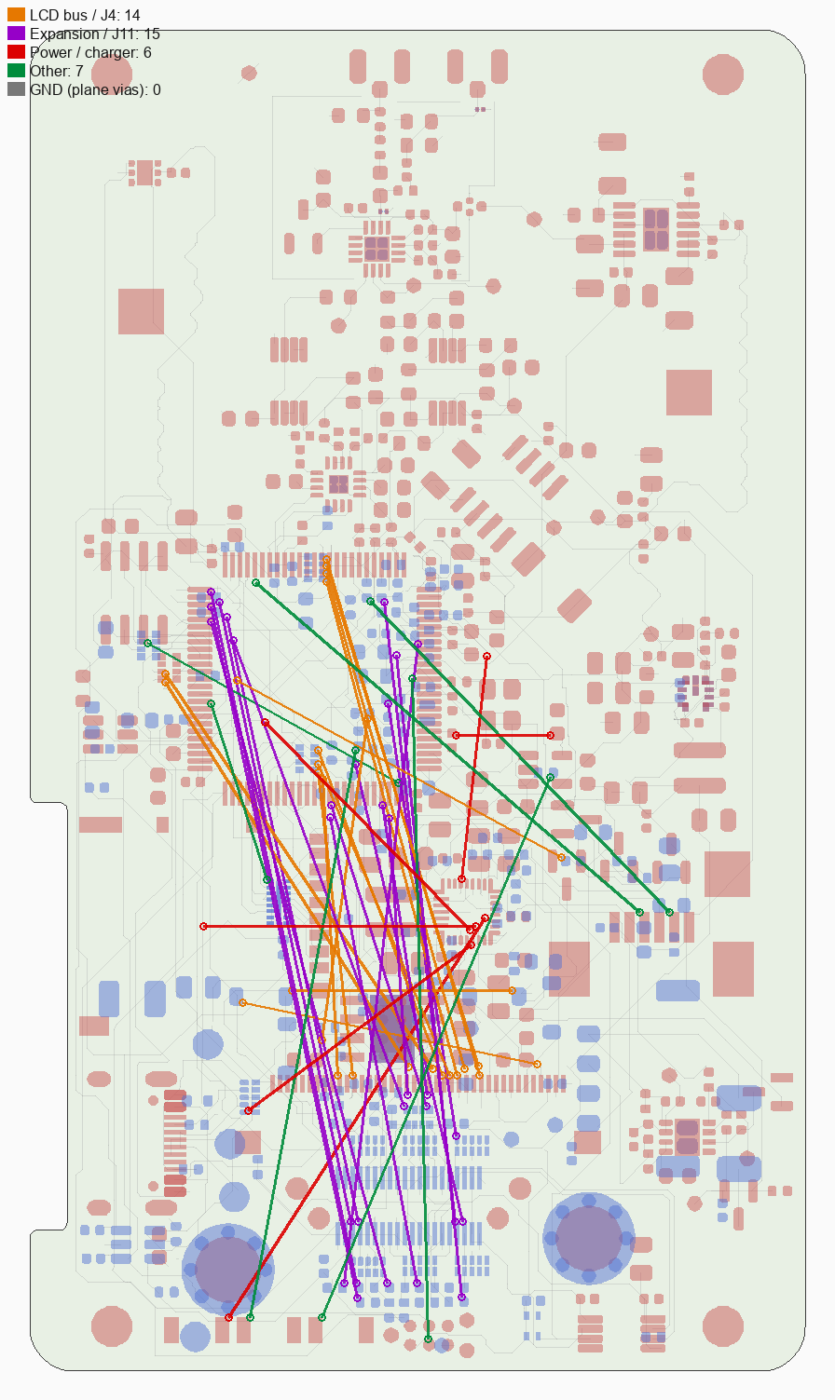
Hardware/RFVD_SENSOR_BOARD_Rev6/outputs/RFVD_unrouted.png
