Able-Digital-Logic/UnintendedAntennaClub3/Hardware/RFVD_SENSOR_BOARD_Rev6/renders/layer_2_In1_Cu.png

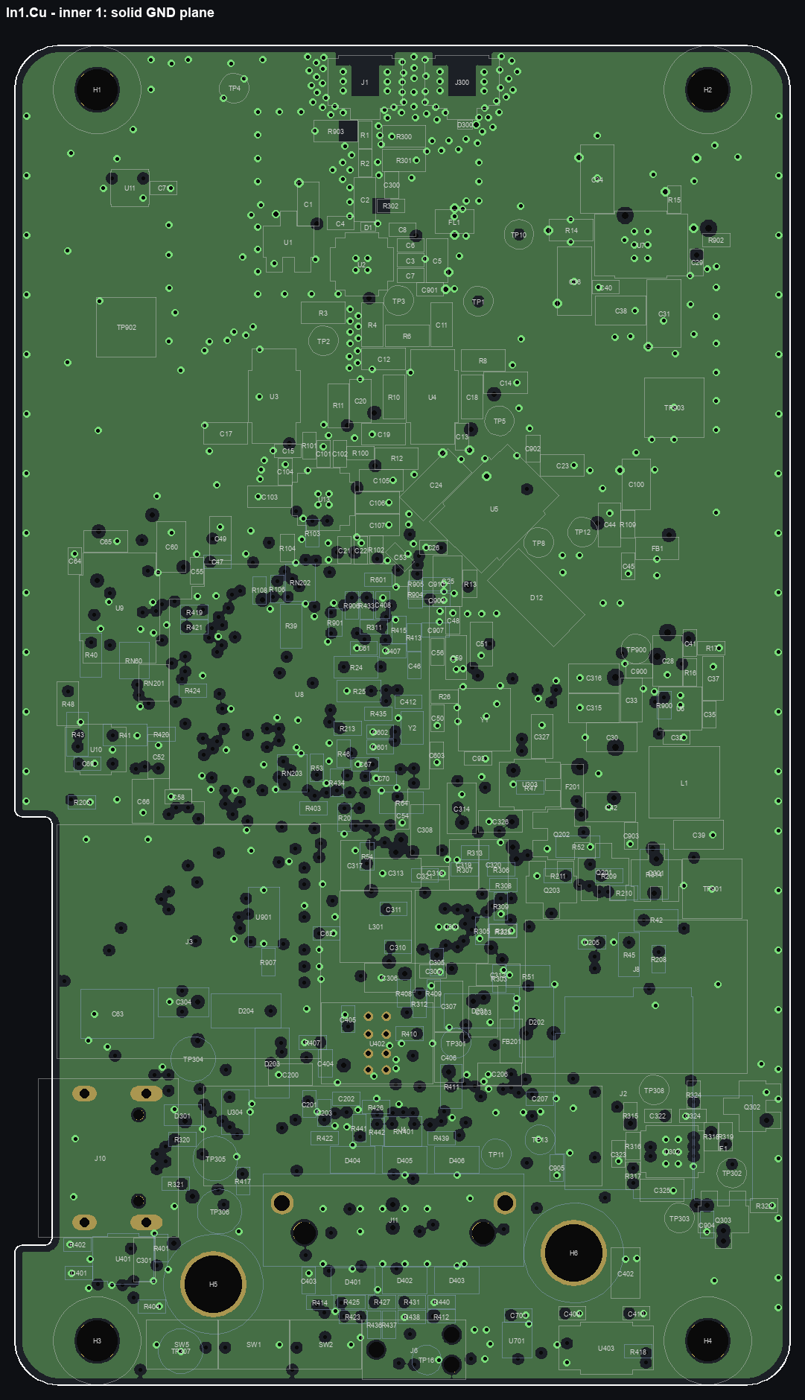
Hardware/RFVD_SENSOR_BOARD_Rev6/renders/layer_2_In1_Cu.png
