Able-Digital-Logic/UnintendedAntennaClub3/Hardware/RFVD_SENSOR_BOARD_Rev6/renders/layer_5_In4_Cu.png

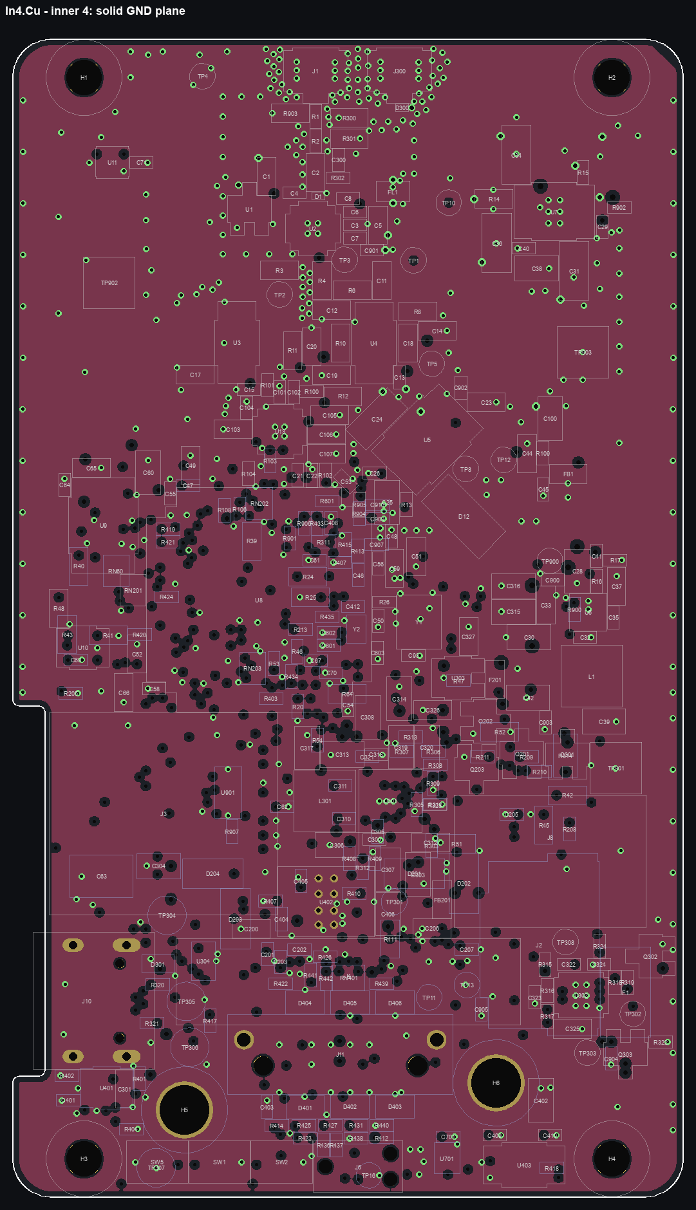
Hardware/RFVD_SENSOR_BOARD_Rev6/renders/layer_5_In4_Cu.png
