Able-Digital-Logic/UnintendedAntennaClub3/Hardware/RFVD_SENSOR_BOARD_Rev6/renders/layer_6_B_Cu.png

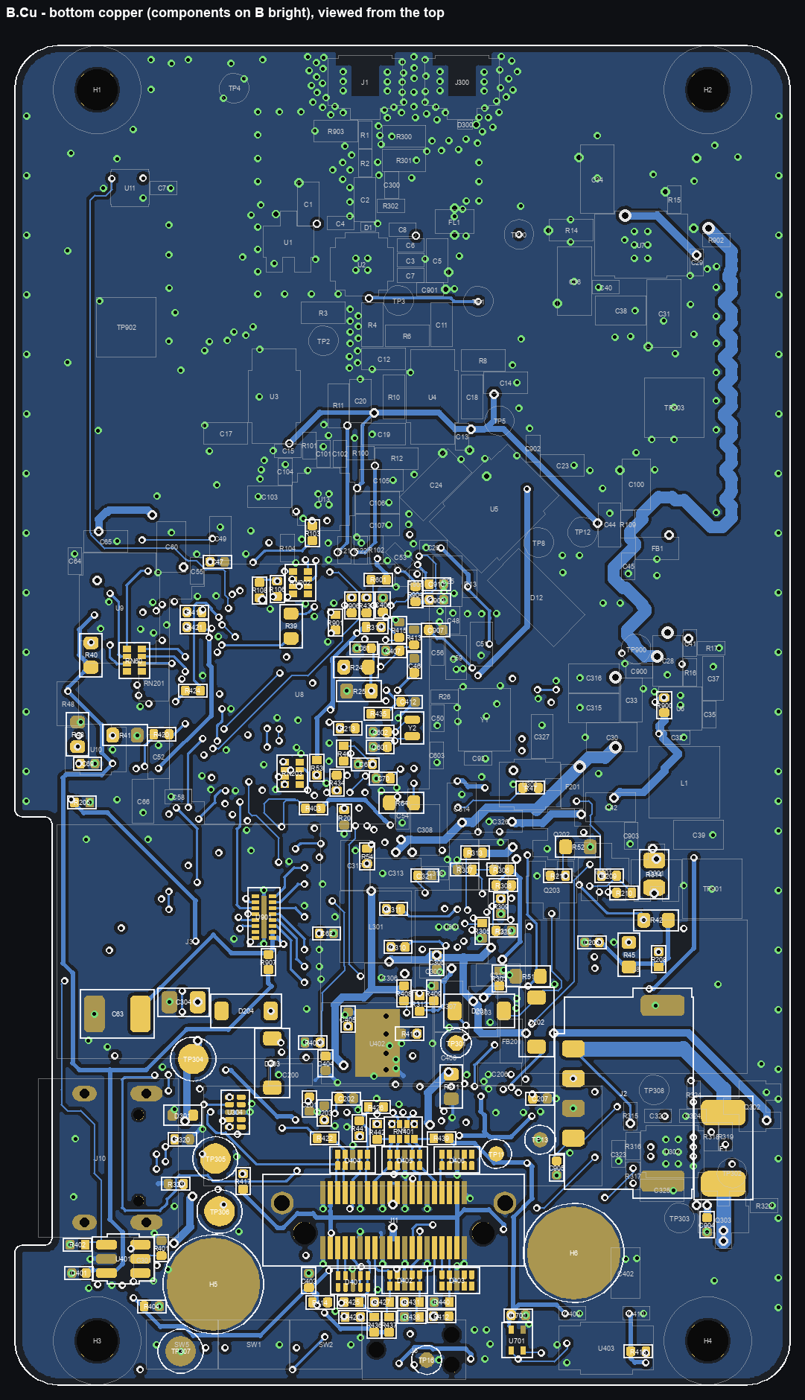
Hardware/RFVD_SENSOR_BOARD_Rev6/renders/layer_6_B_Cu.png
