Able-Digital-Logic/UnintendedAntennaClub3/Hardware/RFVD_SENSOR_BOARD_Rev6/renders/RFVD_3D_bottom.png

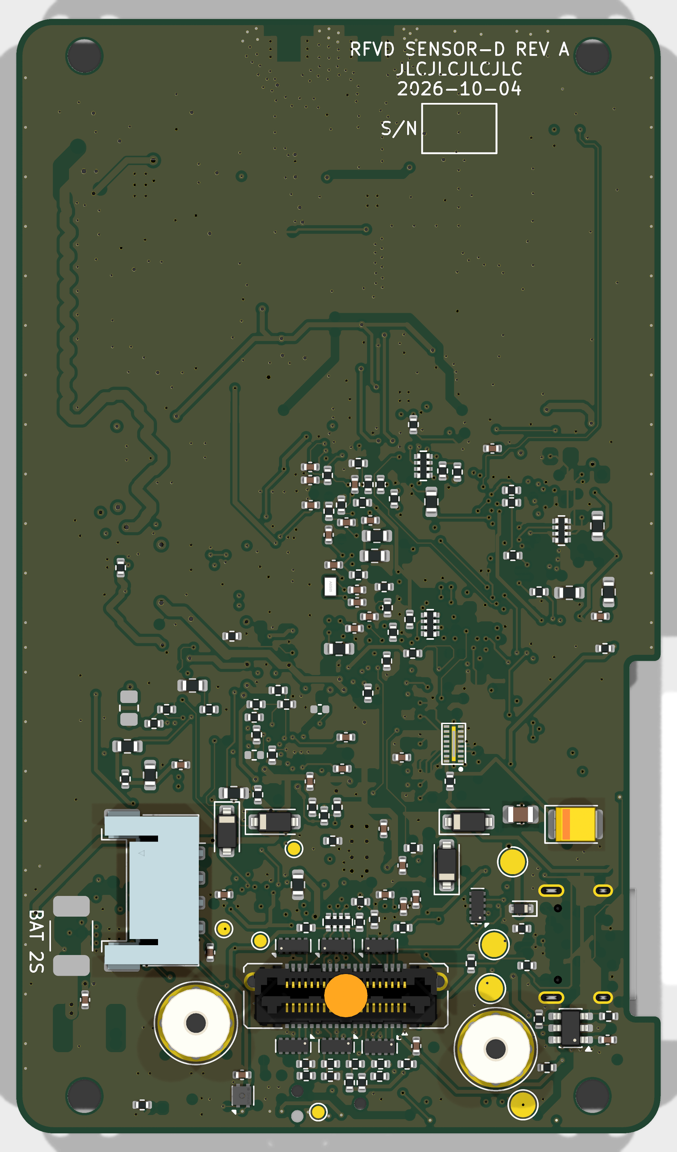
Hardware/RFVD_SENSOR_BOARD_Rev6/renders/RFVD_3D_bottom.png
