Able-Digital-Logic/UnintendedAntennaClub3/Hardware/RFVD_SENSOR_BOARD_Rev6/renders/RFVD_3D_top.png

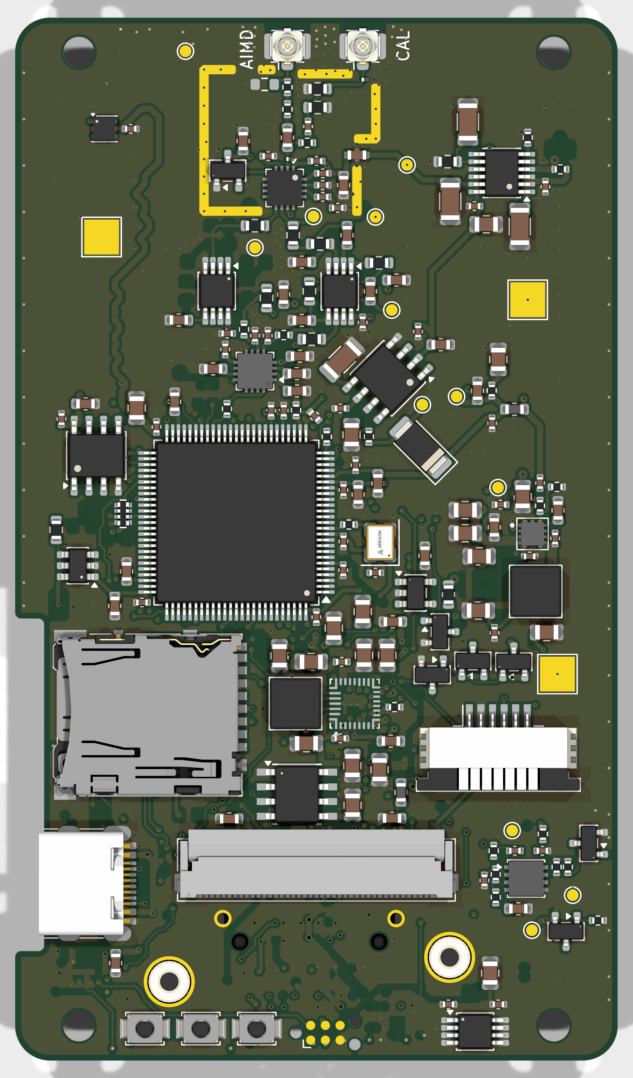
Hardware/RFVD_SENSOR_BOARD_Rev6/renders/RFVD_3D_top.png
