Able-Digital-Logic/UnintendedAntennaClub3/Hardware/RFVD_SENSOR_BOARD_Rev6/docs/changes_part_moves.csv

Ref | Side_project | X_project | Y_project | Rot_project | Side_handoff | X_handoff | Y_handoff | Rot_handoff | Moved_mm | Sensitivity
C200 | F | 133.3686 | 121.8864 | 0.0 | F | 133.9786 | 121.8864 | 0.0 | 0.61 | medium
C201 | B | 134.7736 | 123.4734 | 0.0 | B | 135.2536 | 123.8534 | 90.0 | 0.612 | medium
C203 | B | 136.2536 | 122.9934 | 90.0 | B | 136.195 | 123.996 | 270.0 | 1.004 | medium
C204 | B | 137.8806 | 124.8694 | 270.0 | B | 137.7536 | 124.9034 | 270.0 | 0.131 | medium
C205 | B | 154.2236 | 112.9934 | 0.0 | B | 154.2236 | 112.9934 | 180.0 | 0.0 | medium
C206 | F | 148.2286 | 121.8434 | 180.0 | F | 148.0286 | 121.8434 | 180.0 | 0.2 | medium
C302 | B | 142.3966 | 100.7074 | 270.0 | B | 147.297 | 101.886 | 0.0 | 5.04 | low
C305 | F | 145.4836 | 114.9434 | 0.0 | B | 143.804 | 114.323 | 270.0 | 1.791 | high
C308 | F | 143.0036 | 105.4434 | 90.0 | F | 143.004 | 105.443 | 90.0 | 0.001 | medium
C309 | F | 143.4836 | 114.9434 | 0.0 | F | 143.5586 | 114.9434 | 0.0 | 0.075 | critical
C310 | B | 144.8836 | 113.8434 | 0.0 | B | 141.2 | 113.3 | 180.0 | 3.723 | high
C311 | B | 145.6836 | 110.0814 | 0.0 | B | 140.9 | 110.76 | 180.0 | 4.831 | high
C314 | F | 148.4036 | 111.9934 | 270.0 | F | 145.5 | 104.0 | 90.0 | 8.504 | medium
C318 | F | 143.6836 | 108.9434 | 0.0 | F | 143.6836 | 108.3434 | 0.0 | 0.6 | critical
C319 | F | 145.6086 | 107.4684 | 90.0 | F | 145.6086 | 107.7724 | 90.0 | 0.304 | high
C321 | B | 143.2036 | 110.0814 | 90.0 | B | 143.0 | 108.5 | 0.0 | 1.594 | low
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
TP302 | F | 162.8036 | 128.0434 | 0.0 | F | 163.623 | 128.475 | 0.0 | 0.926 | low
TP304 | B | 127.8396 | 124.0564 | 0.0 | B | 127.446 | 120.823 | 0.0 | 3.257 | low
TP306 | B | 128.8576 | 130.5664 | 0.0 | B | 129.223 | 131.053 | 0.0 | 0.609 | medium
