Able-Digital-Logic/UnintendedAntennaClub3/Hardware/Archive/RFVD_SENSOR_BOARD_Rev1/models/approximate/F1_MF_MSMF110_16_DIMENSIONAL_ENVELOPE.step

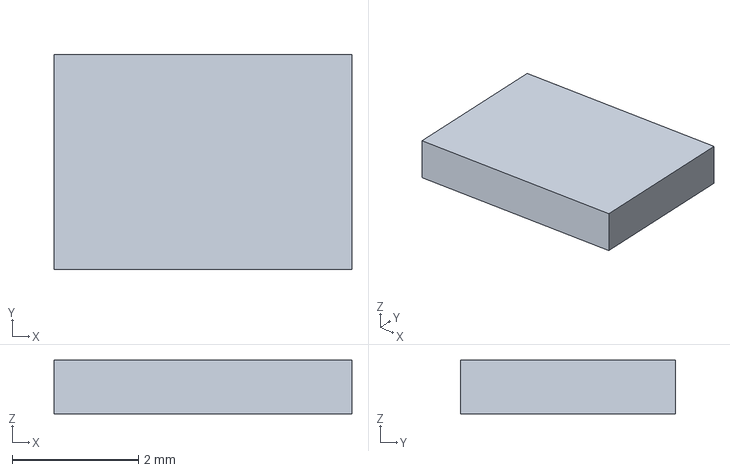
[picture p22: CAD file, 2026-09-06, an earlier design]
Hardware/Archive/RFVD_SENSOR_BOARD_Rev1/models/approximate/F1_MF_MSMF110_16_DIMENSIONAL_ENVELOPE.step
4.73 x 3.41 x 0.85 mm
