Able-Digital-Logic/UnintendedAntennaClub3/Hardware/Archive/RFVD_SENSOR_BOARD_Rev1/models/kicad/BNC_AMPHENOL/031-5539.igs

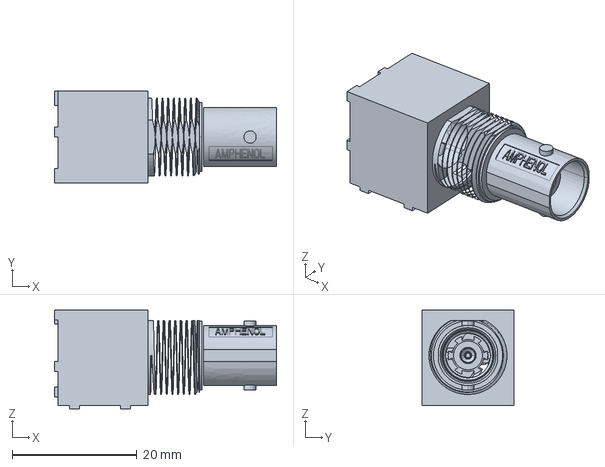
[picture p23: CAD file, 2026-09-06, an earlier design]
Hardware/Archive/RFVD_SENSOR_BOARD_Rev1/models/kicad/BNC_AMPHENOL/031-5539.igs
35.6 x 14.7 x 15.9 mm
