Able-Digital-Logic/UnintendedAntennaClub3/Hardware/RFVD_SENSOR_BOARD_Rev1/models/approximate/U5_RPE0009B_DIMENSIONAL_ENVELOPE.step

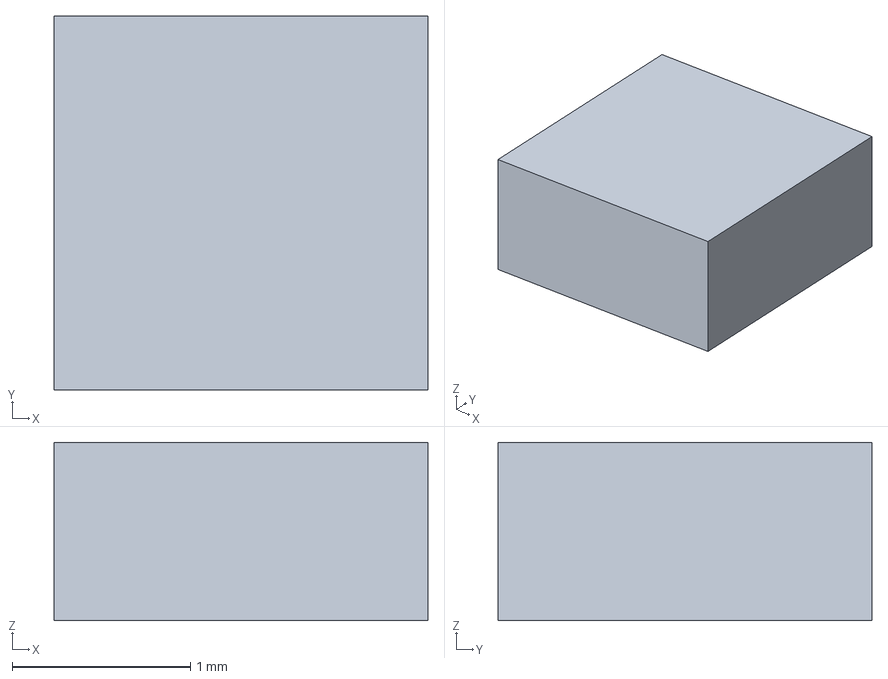
[picture p24: CAD file, 2026-09-06, an earlier design]
Hardware/RFVD_SENSOR_BOARD_Rev1/models/approximate/U5_RPE0009B_DIMENSIONAL_ENVELOPE.step
2.10 x 2.10 x 1.00 mm
