Able-Digital-Logic/UnintendedAntennaClub3/Hardware/Archive/RFVD_SENSOR_BOARD_Rev1/models/approximate/Y1_ASE3225_DIMENSIONAL_ENVELOPE.step

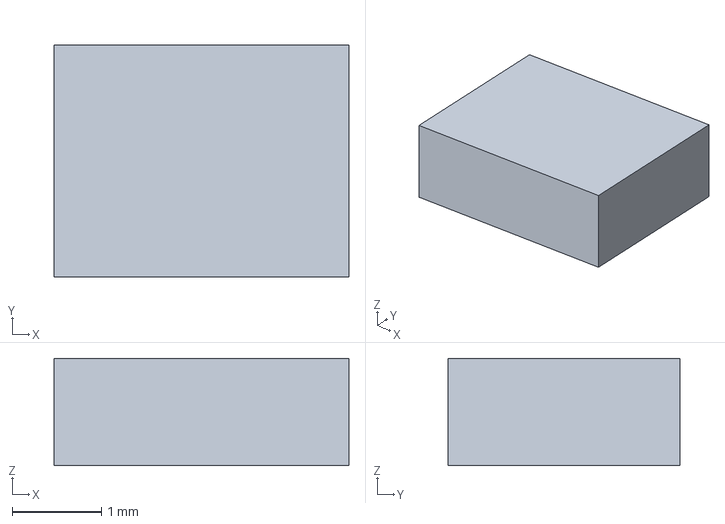
[picture p25: CAD file, 2026-09-06, an earlier design]
Hardware/Archive/RFVD_SENSOR_BOARD_Rev1/models/approximate/Y1_ASE3225_DIMENSIONAL_ENVELOPE.step
3.30 x 2.60 x 1.20 mm
