Able-Digital-Logic/UnintendedAntennaClub3/Hardware/Archive/RFVD_SENSOR_BOARD_Rev1/models/approximate/D1_SOD962_DIMENSIONAL_ENVELOPE.step

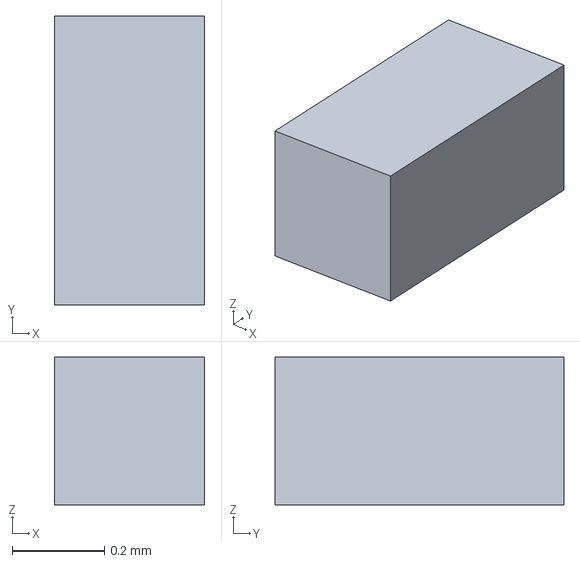
[picture p26: CAD file, 2026-09-06, an earlier design]
Hardware/Archive/RFVD_SENSOR_BOARD_Rev1/models/approximate/D1_SOD962_DIMENSIONAL_ENVELOPE.step
0.325 x 0.625 x 0.32 mm
