Able-Digital-Logic/UnintendedAntennaClub3/Hardware/Archive/RFVD_SENSOR_BOARD_Rev1/models/approximate/J7_031_5539_CONSERVATIVE_ENVELOPE.step

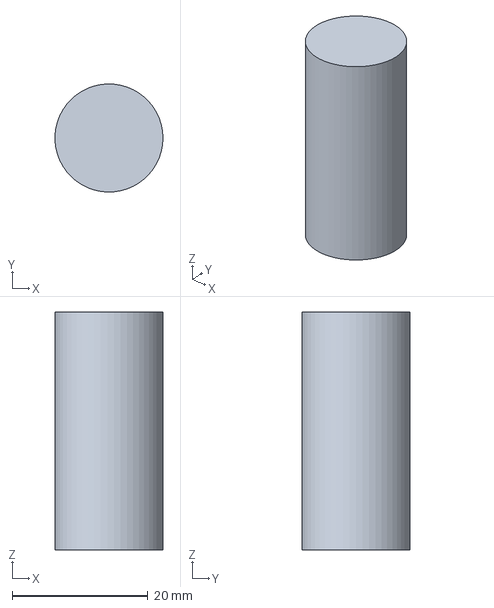
[picture p27: CAD file, 2026-09-06, an earlier design]
Hardware/Archive/RFVD_SENSOR_BOARD_Rev1/models/approximate/J7_031_5539_CONSERVATIVE_ENVELOPE.step
15.9 x 15.9 x 35.0 mm
