Able-Digital-Logic/UnintendedAntennaClub3/Hardware/RFVD_SENSOR_BOARD_Rev6/outputs/RFVD_board_layers.pdf

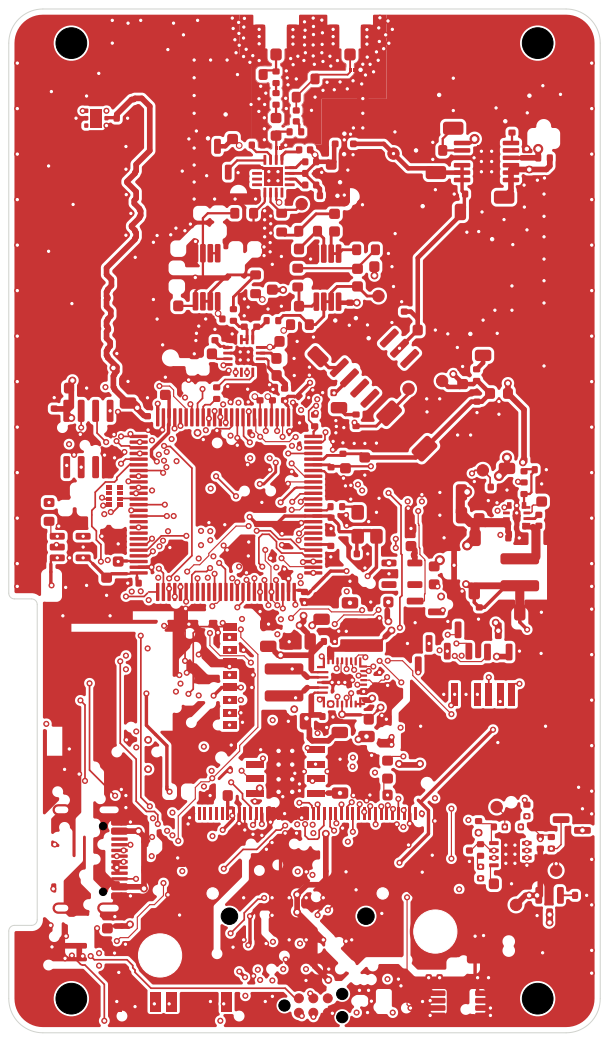
[picture p46: page 1]

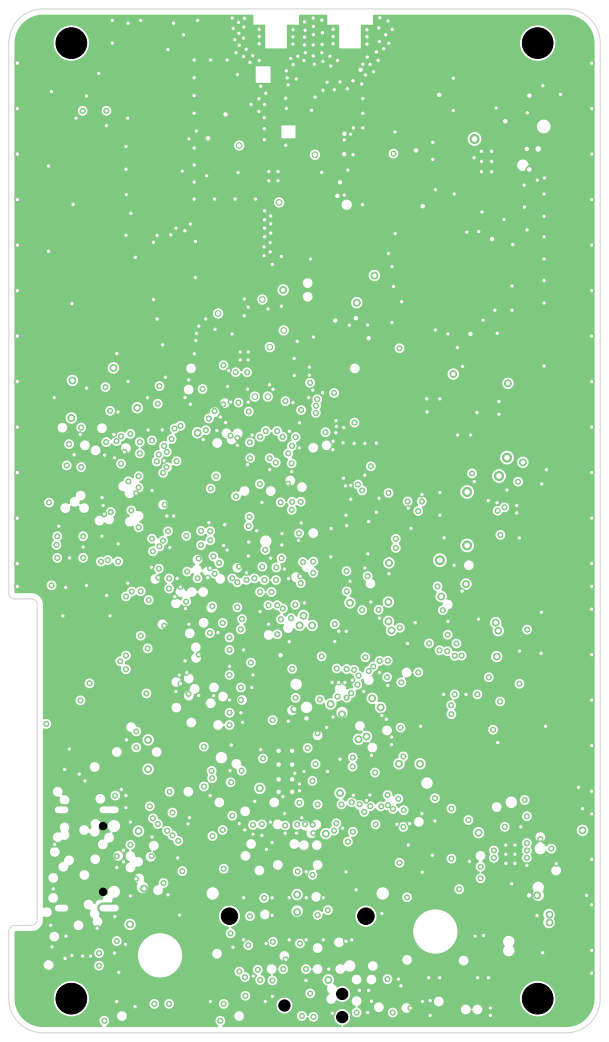
[picture p47: page 2]

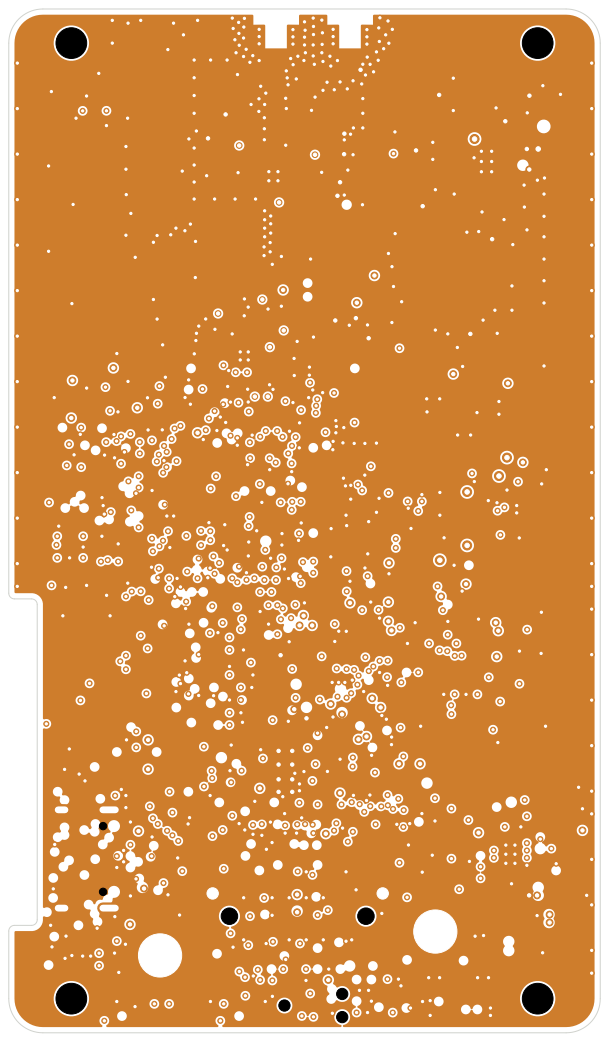
[picture p48: page 3]

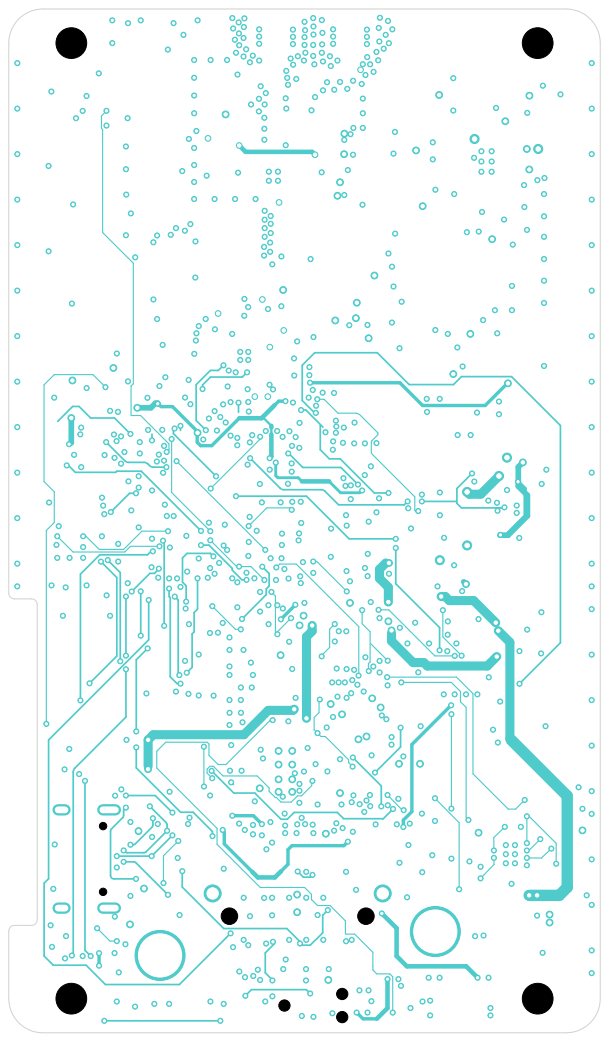
[picture p49: page 4]

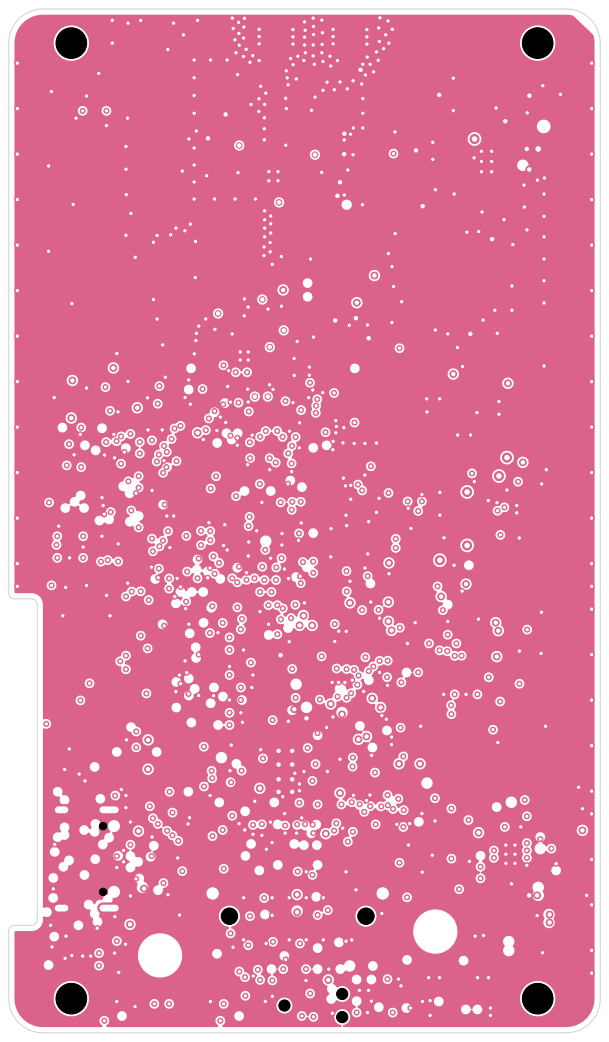
[picture p50: page 5]

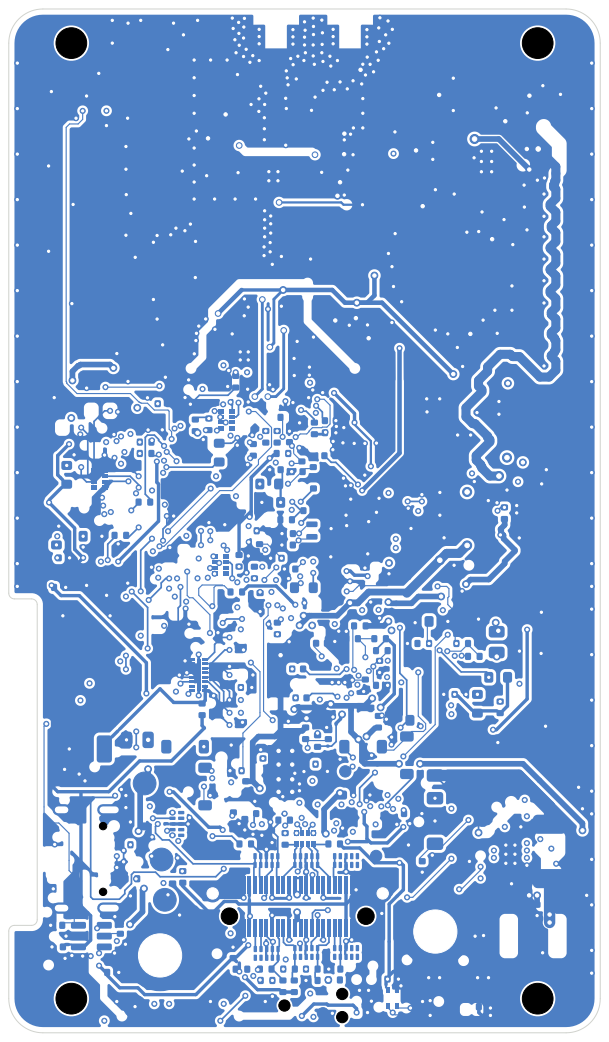
[picture p51: page 6]

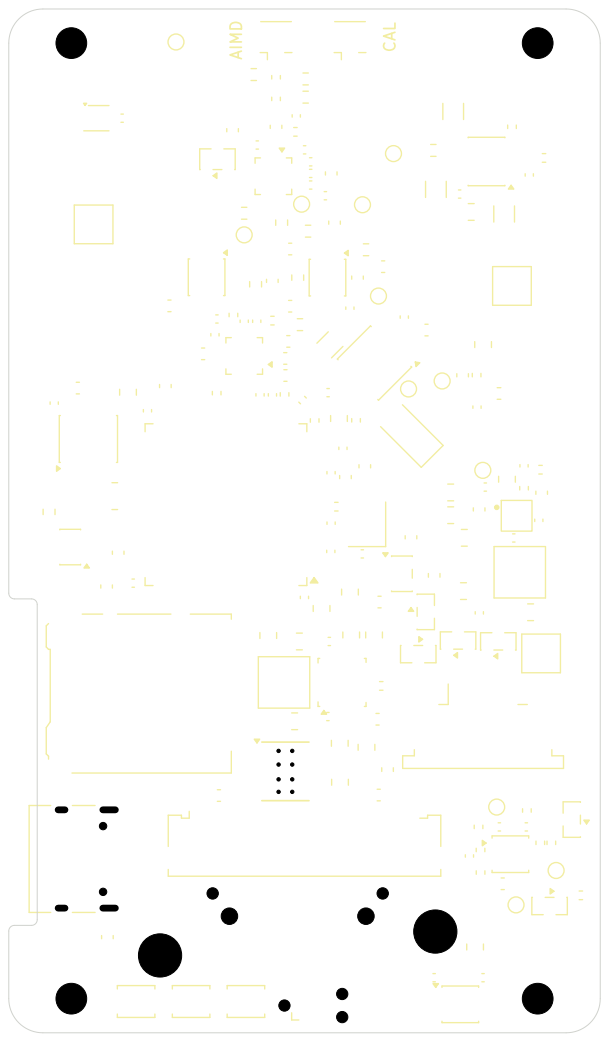
[picture p52: page 7]

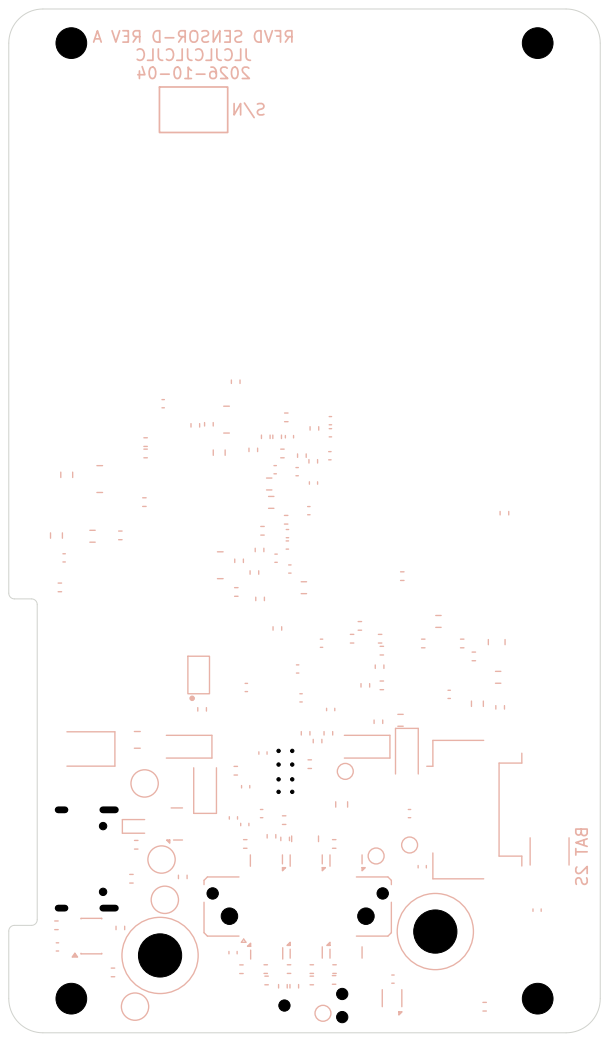
[picture p53: page 8]

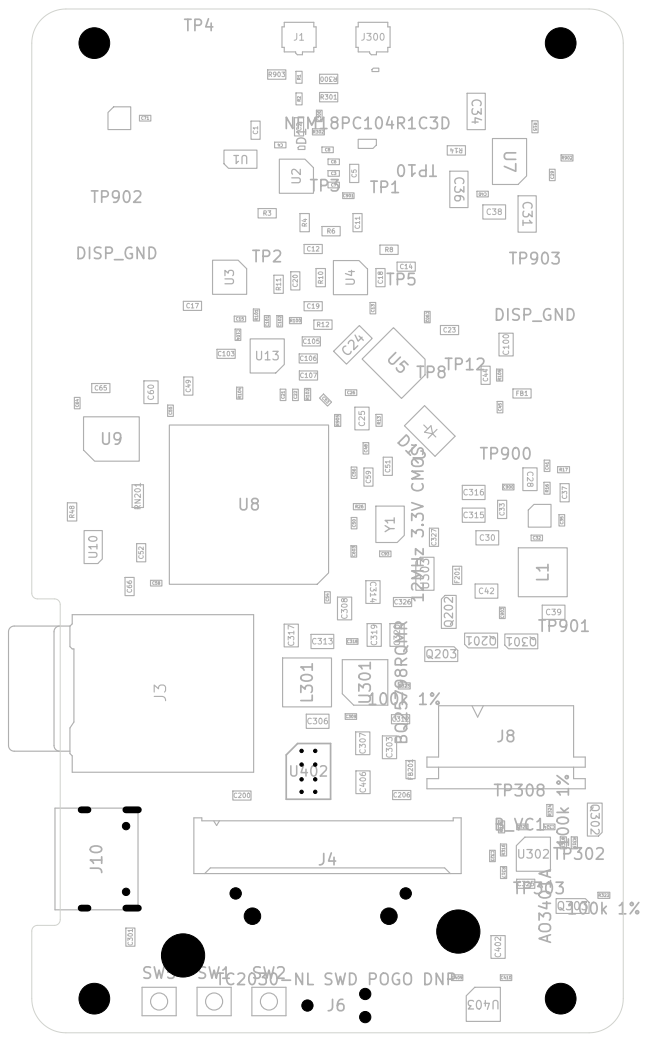
[picture p54: page 9]

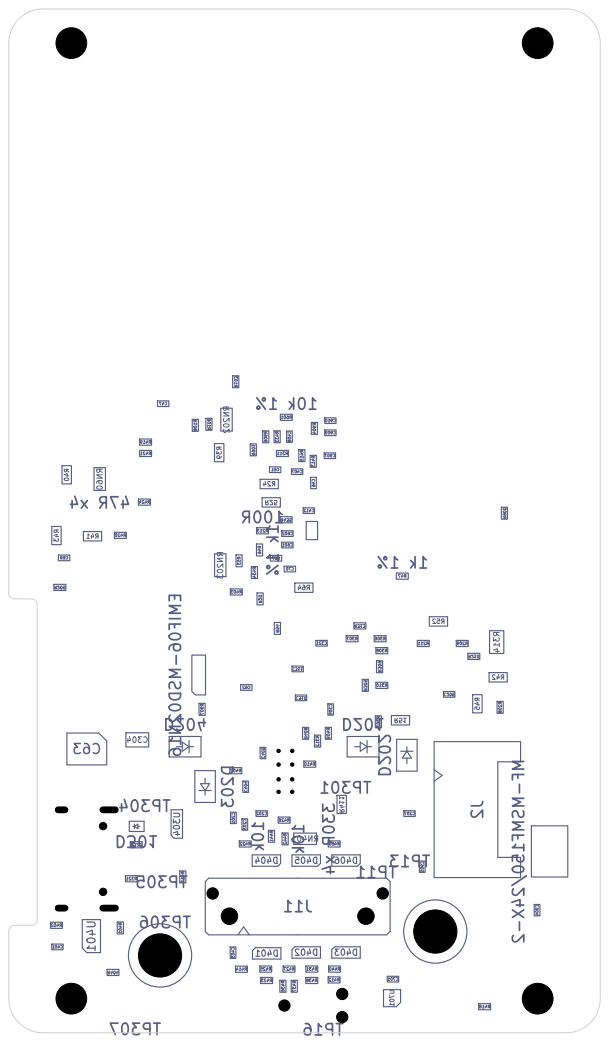
[picture p55: page 10]

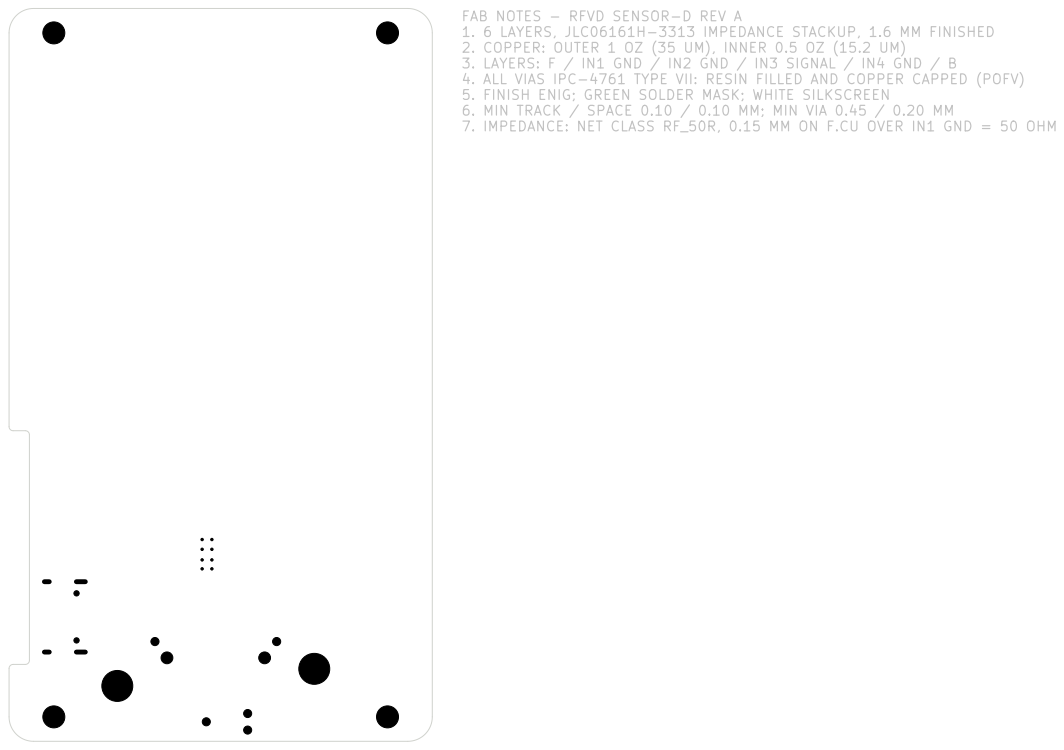
[picture p56: page 11]

FAB NOTES - RFVD SENSOR-D REV A 1. 6 LAYERS, JLC06161H-3313 IMPEDANCE STACKUP, 1.6 MM FINISHED

2. COPPER: OUTER 1 OZ (35 UM), INNER 0.5 OZ (15.2 UM) 3. LAYERS: F / IN1 GND / IN2 GND / IN3 SIGNAL / IN4 GND / B

4. ALL VIAS IPC-4761 TYPE VII: RESIN FILLED AND COPPER CAPPED (POFV) 5. FINISH ENIG; GREEN SOLDER MASK; WHITE SILKSCREEN

6. MIN TRACK / SPACE 0.10 / 0.10 MM; MIN VIA 0.45 / 0.20 MM
7. IMPEDANCE: NET CLASS RF_50R, 0.15 MM ON F.CU OVER IN1 GND = 50 OHM
