Able-Digital-Logic/UnintendedAntennaClub3/Hardware/RFVD_SENSOR_BOARD_Rev6/outputs/RFVD_schematic.pdf

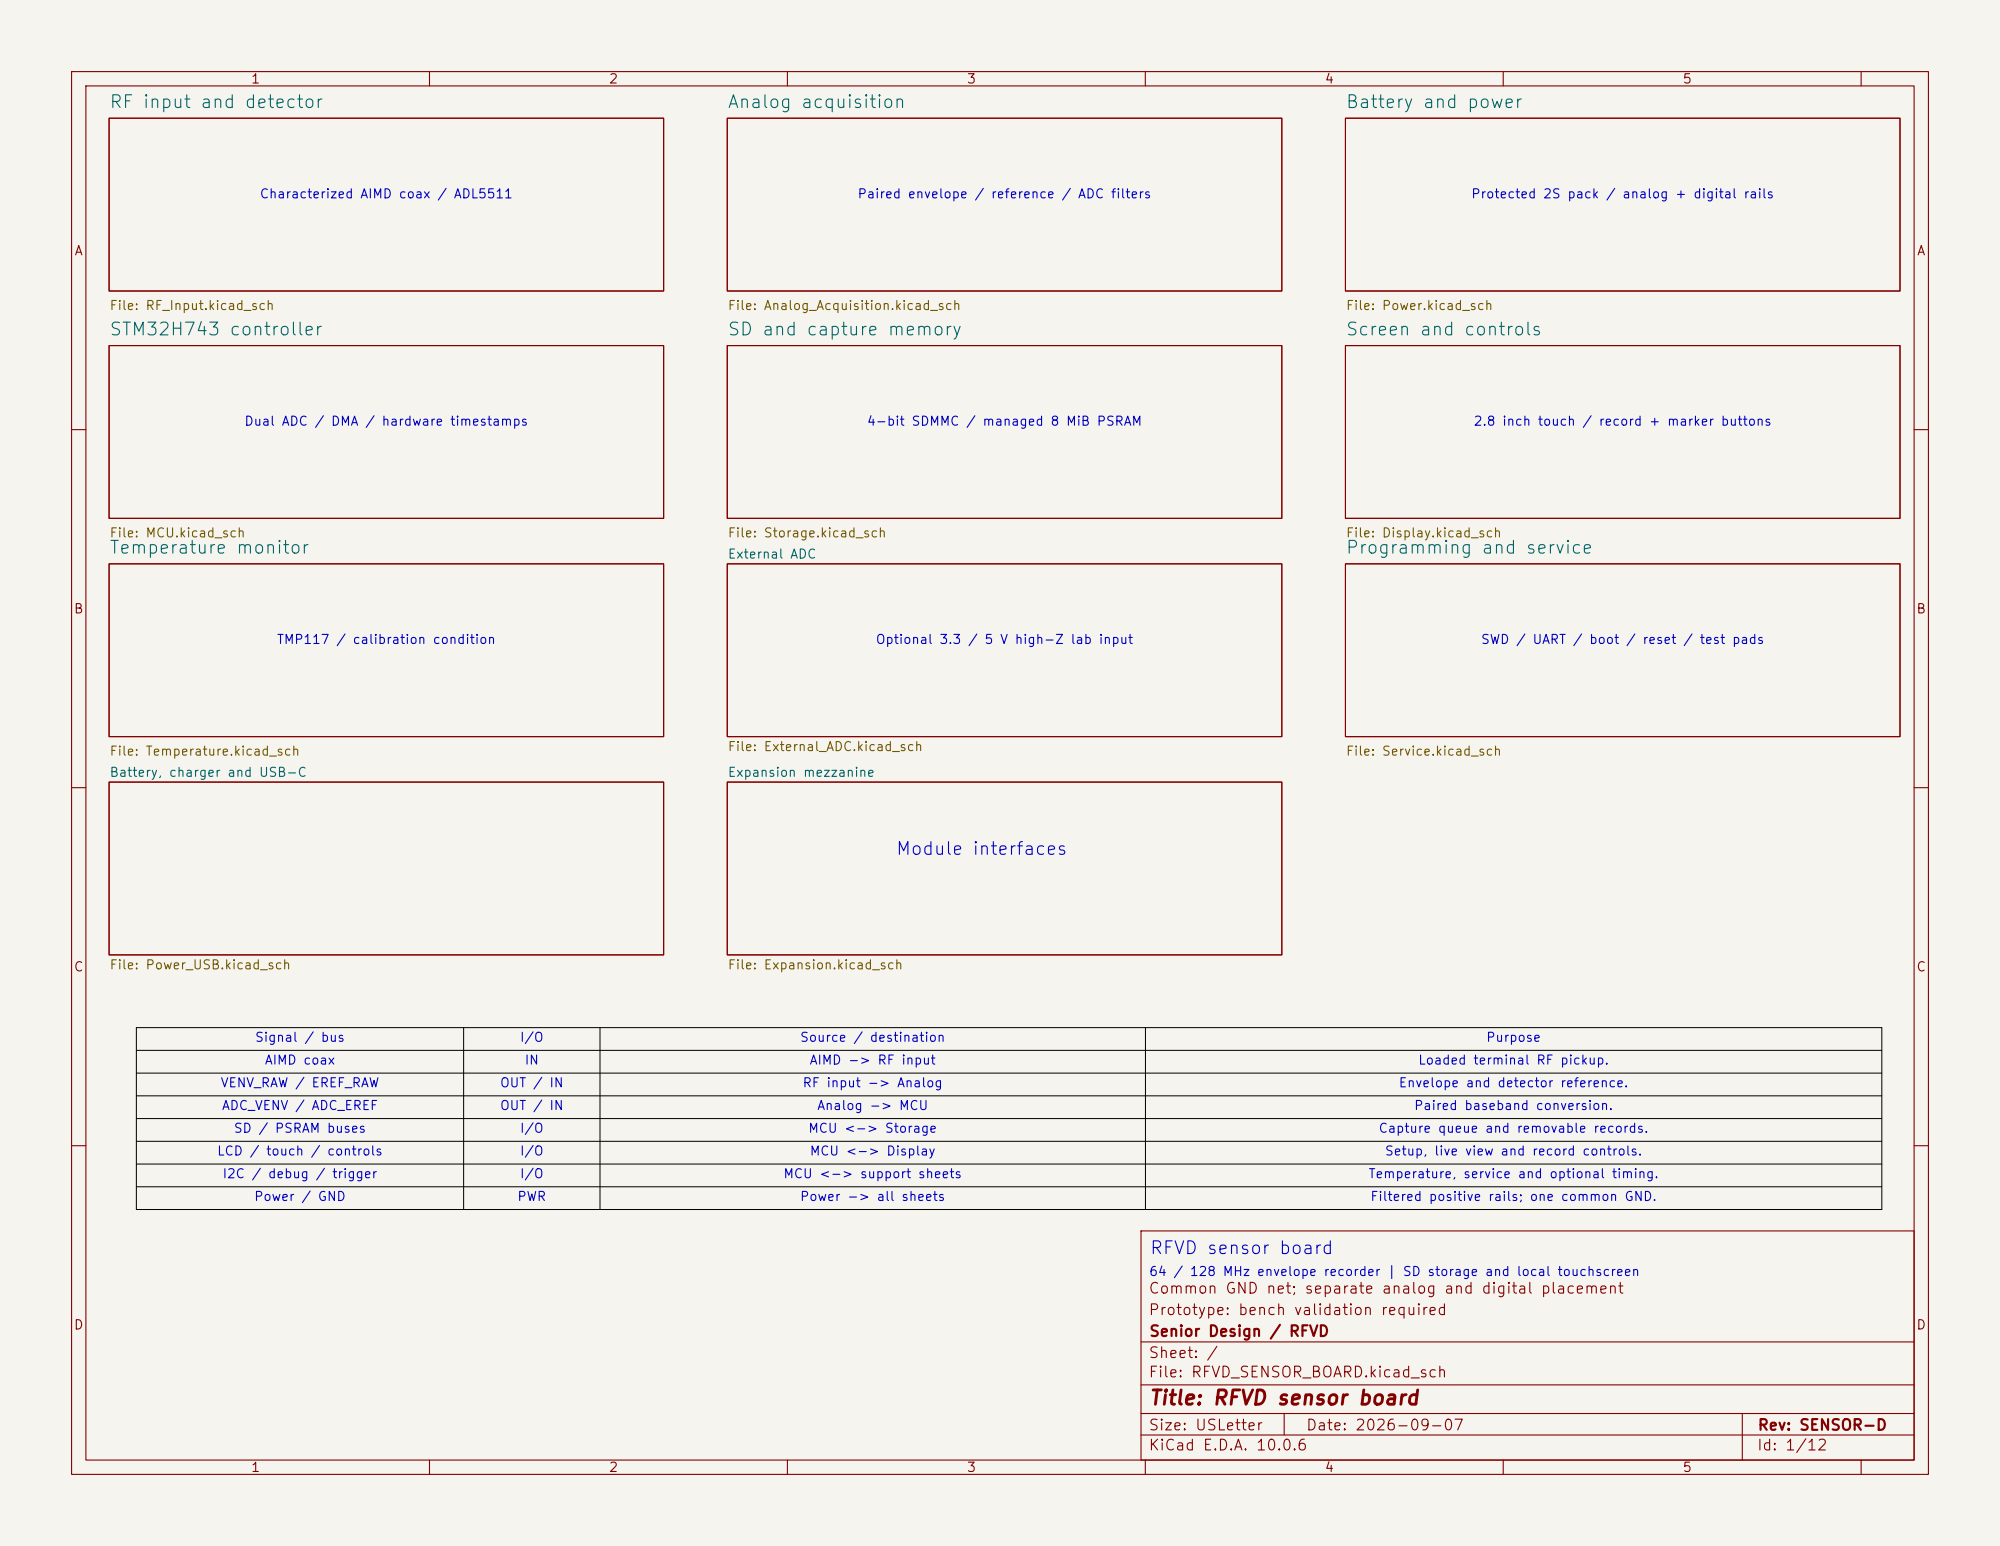
[picture p57: page 1]

Optional 3.3 / 5 V high-Z lab input Paired envelope / reference / ADC filters Module interfaces MCU <-> Display

RF input and detector

File: Service.kicad_sch Analog acquisition
Protected 2S pack / analog + digital rails Purpose SWD / UART / boot / reset / test pads

TMP117 / calibration condition Characterized AIMD coax / ADL5511

File: Analog_Acquisition.kicad_sch
File: External_ADC.kicad_sch SD and capture memory

File: Power.kicad_sch Screen and controls

Dual ADC / DMA / hardware timestamps

4-bit SDMMC / managed 8 MiB PSRAM

2.8 inch touch / record + marker buttons

File: Storage.kicad_sch Temperature monitor

Battery, charger and USB-C

Signal / bus | I/O
I2C / debug / trigger ADC_VENV / ADC_EREF LCD / touch / controls | I/O | MCU <-> Storage | 64 / 128 MHz envelope recorder | SD storage and local touchscreen Paired baseband conversion. Loaded terminal RF pickup.

OUT / IN | RF input -> Analog | Filtered positive rails; one common GND. AIMD -> RF input Source / destination MCU <-> support sheets Envelope and detector reference. Capture queue and removable records. Setup, live view and record controls.
IN

OUT / IN | Power -> all sheets AIMD coax VENV_RAW / EREF_RAW Analog -> MCU

SD / PSRAM buses Power / GND | I/O

I/O | | Temperature, service and optional timing.
PWR

Common GND net; separate analog and digital placement
Prototype: bench validation required
Senior Design / RFVD
Sheet: /
File: RFVD_SENSOR_BOARD.kicad_sch
Title: RFVD sensor board

Size: USLetter | Rev: SENSOR-D
KiCad E.D.A. 10.0.6 | Id: 1/12

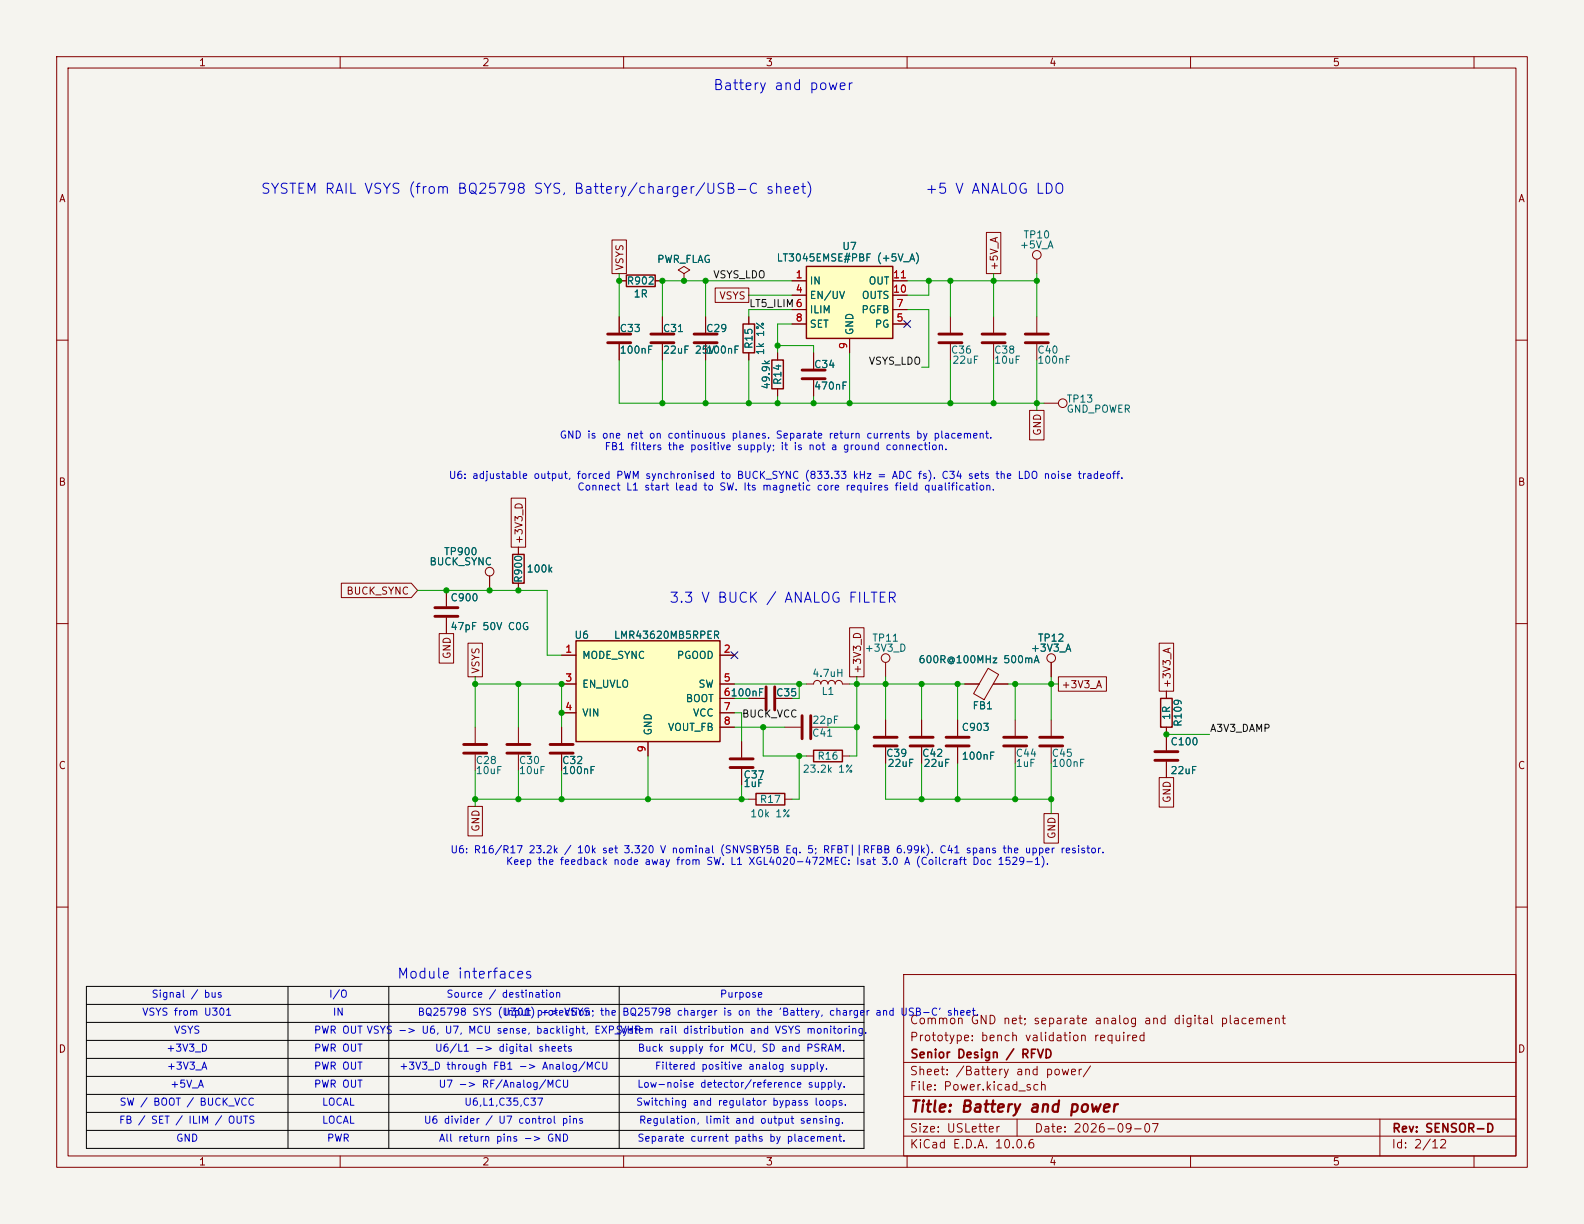
[picture p58: page 2]

Battery and power GND is one net on continuous planes. Separate return currents by placement. FB1 filters the positive supply; it is not a ground connection. U6/L1 -> digital sheets Source / destination U6: adjustable output, forced PWM synchronised to BUCK_SYNC (833.33 kHz = ADC fs). C34 sets the LDO noise tradeoff. Connect L1 start lead to SW. Its magnetic core requires field qualification. Buck supply for MCU, SD and PSRAM. SW / BOOT / BUCK_VCC
VSYS_LDO +3V3_D through FB1 -> Analog/MCU

SYSTEM RAIL VSYS (from BQ25798 SYS, Battery/charger/USB-C sheet)

PWR OUT I/O | Module interfaces | Purpose

PWR OUT Signal / bus +3V3_D IN

Common GND net; separate analog and digital placement
Prototype: bench validation required
Senior Design / RFVD
Sheet: /Battery and power/
File: Power.kicad_sch
Title: Battery and power

Filtered positive analog supply. VSYS

Separate current paths by placement. VSYS -> U6, U7, MCU sense, backlight, EXP_VHP

LOCAL | | Regulation, limit and output sensing. PWR

Switching and regulator bypass loops.

All return pins -> GND

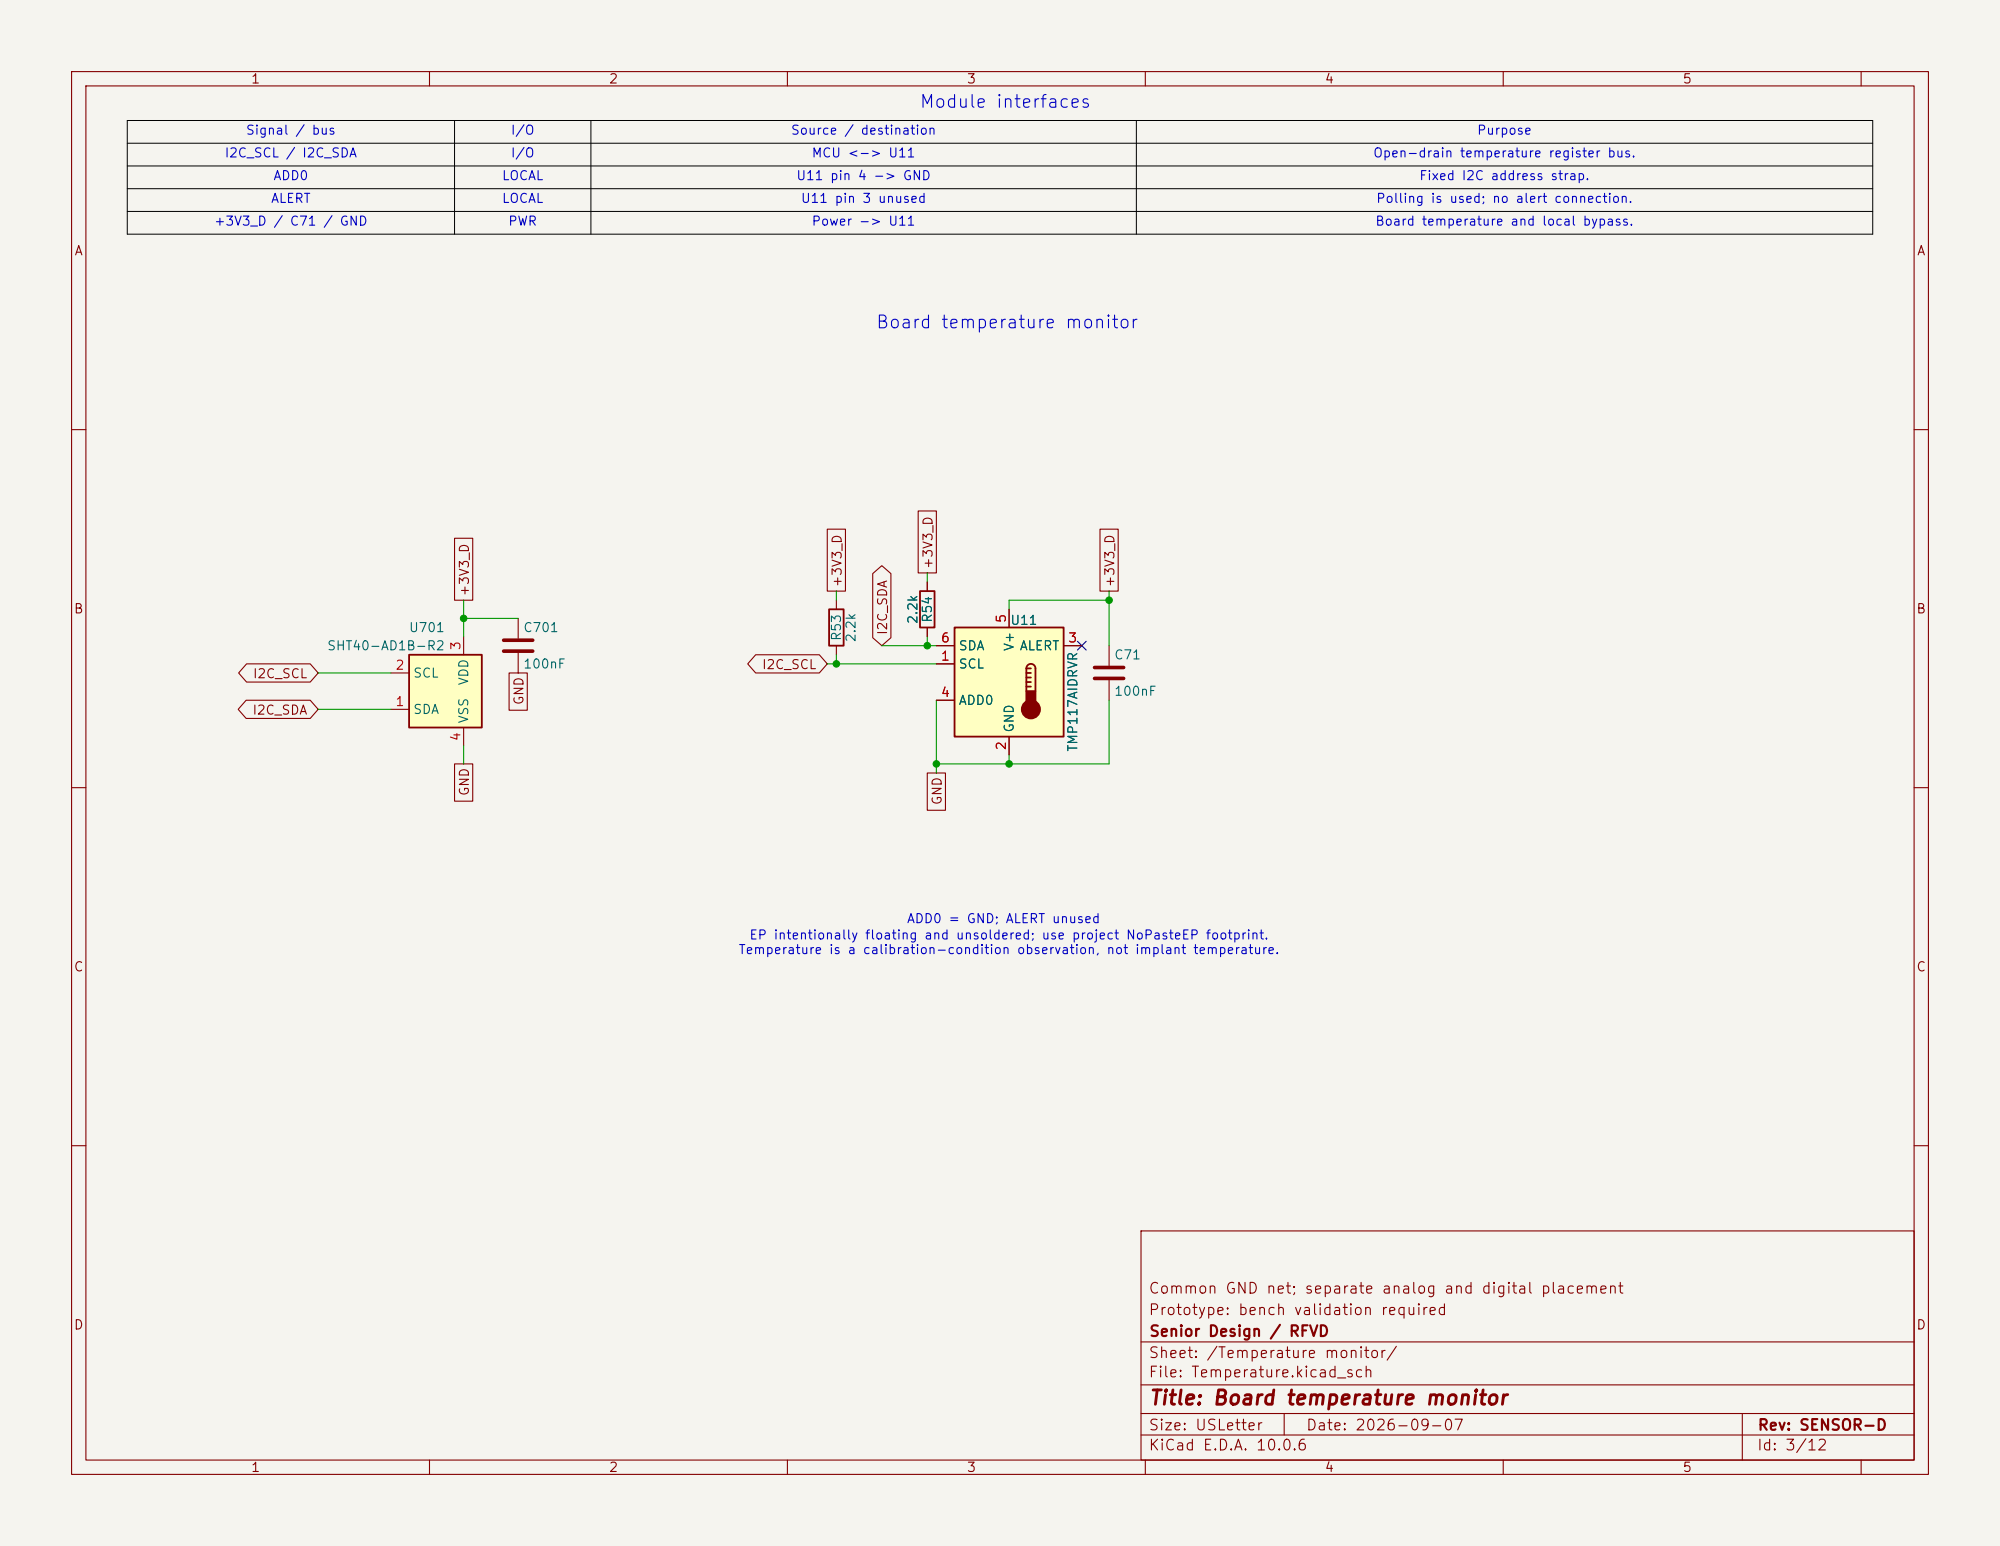
[picture p59: page 3]

I2C_SCL / I2C_SDA | I/O | Source / destination U11 pin 3 unused MCU <-> U11 | Open-drain temperature register bus. Polling is used; no alert connection. Signal / bus

I/O | | Purpose

ALERT | | Power -> U11 U11 pin 4 -> GND | Fixed I2C address strap. Board temperature and local bypass.

LOCAL

Common GND net; separate analog and digital placement SDA 1

Temperature is a calibration-condition observation, not implant temperature. ADD0 = GND; ALERT unused
EP intentionally floating and unsoldered; use project NoPasteEP footprint.

Prototype: bench validation required
Senior Design / RFVD
Sheet: /Temperature monitor/
File: Temperature.kicad_sch
Title: Board temperature monitor

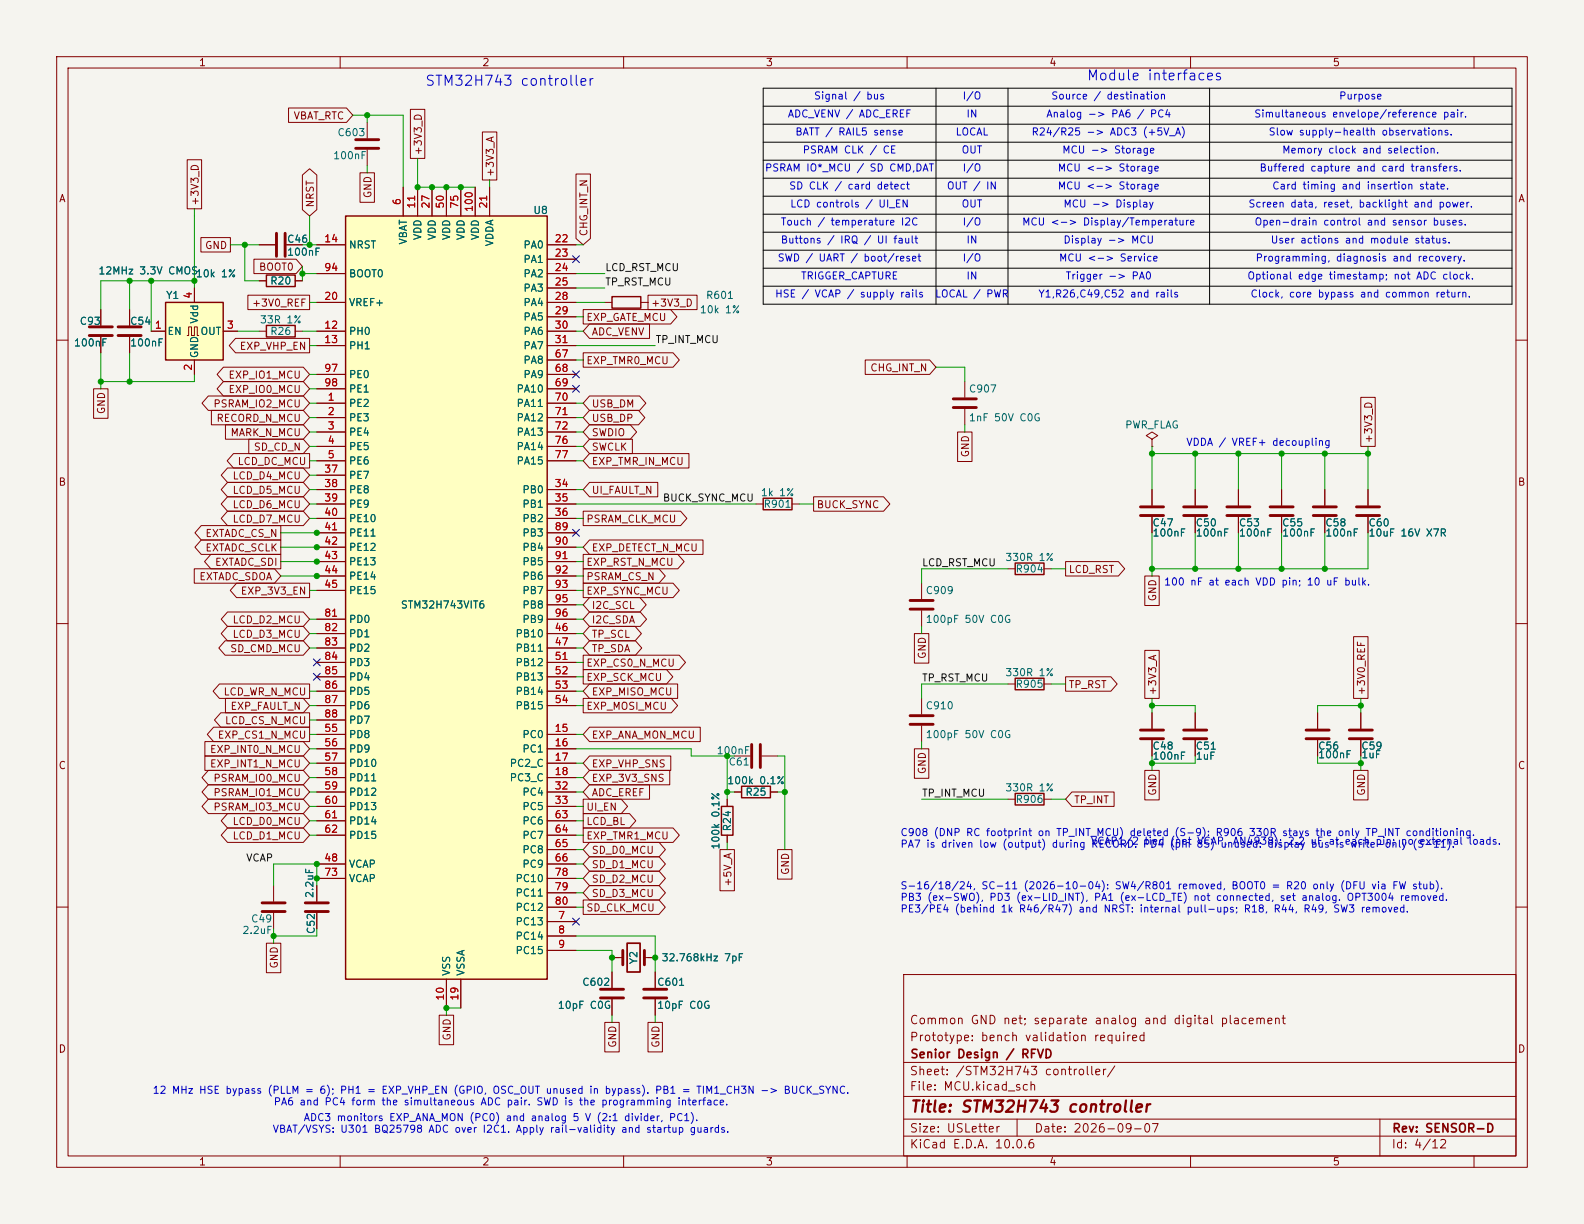
[picture p60: page 4]

Y1,R26,C49,C52 and rails PSRAM CLK / CE BATT / RAIL5 sense MCU <-> Service | Simultaneous envelope/reference pair. Card timing and insertion state. Buffered capture and card transfers. STM32H743 controller

Signal / bus ADC_VENV / ADC_EREF

MCU -> Storage MCU <-> Storage Source / destination100 nF at each VDD pin; 10 uF bulk. MCU <-> Storage OUT

IN | Analog -> PA6 / PC4

LOCAL PSRAM IO*_MCU / SD CMD,DAT I/O | MCU <-> Display/Temperature | Open-drain control and sensor buses. Slow supply-health observations.

R24/R25 -> ADC3 (+5V_A)

OUT | | Memory clock and selection. Clock, core bypass and common return. SWD / UART / boot/reset

SD CLK / card detect | OUT / IN

HSE / VCAP / supply rails | IN | | Screen data, reset, backlight and power. Programming, diagnosis and recovery. Buttons / IRQ / UI fault LCD controls / UI_EN
Touch / temperature I2C | I/O | Display -> MCU MCU -> Display

I/O | Trigger -> PA0 | User actions and module status. Optional edge timestamp; not ADC clock. LOCAL / PWR

TRIGGER_CAPTURE | IN

C908 (DNP RC footprint on TP_INT_MCU) deleted (S-9): R906 330R stays the only TP_INT conditioning. PA7 is driven low (output) during VCAP1/2 RECORD. PD4 (pin 85) unused: display bus is write-only (S-11). tied (net VCAP, AN4938); 2.2 uF at each pin; no external loads. VDDA / VREF+ decoupling

S-16/18/24, SC-11 (2026-10-04): SW4/R801 removed, BOOT0 = R20 only (DFU via FW stub). PB3 (ex-SWO), PD3 (ex-LID_INT), PA1 (ex-LCD_TE) not connected, set analog. OPT3004 removed. PE3/PE4 (behind 1k R46/R47) and NRST: internal pull-ups; R18, R44, R49, SW3 removed.

Prototype: bench validation required
Senior Design / RFVD
Sheet: /STM32H743 controller/
File: MCU.kicad_sch
Title: STM32H743 controller

12 MHz HSE bypass (PLLM = 6); PH1 = EXP_VHP_EN (GPIO, OSC_OUT unused in bypass). PB1 = TIM1_CH3N -> BUCK_SYNC. PA6 and PC4 form the simultaneous ADC pair. SWD is the programming interface.

ADC3 monitors EXP_ANA_MON (PC0) and analog 5 V (2:1 divider, PC1).
VBAT/VSYS: U301 BQ25798 ADC over I2C1. Apply rail-validity and startup guards.

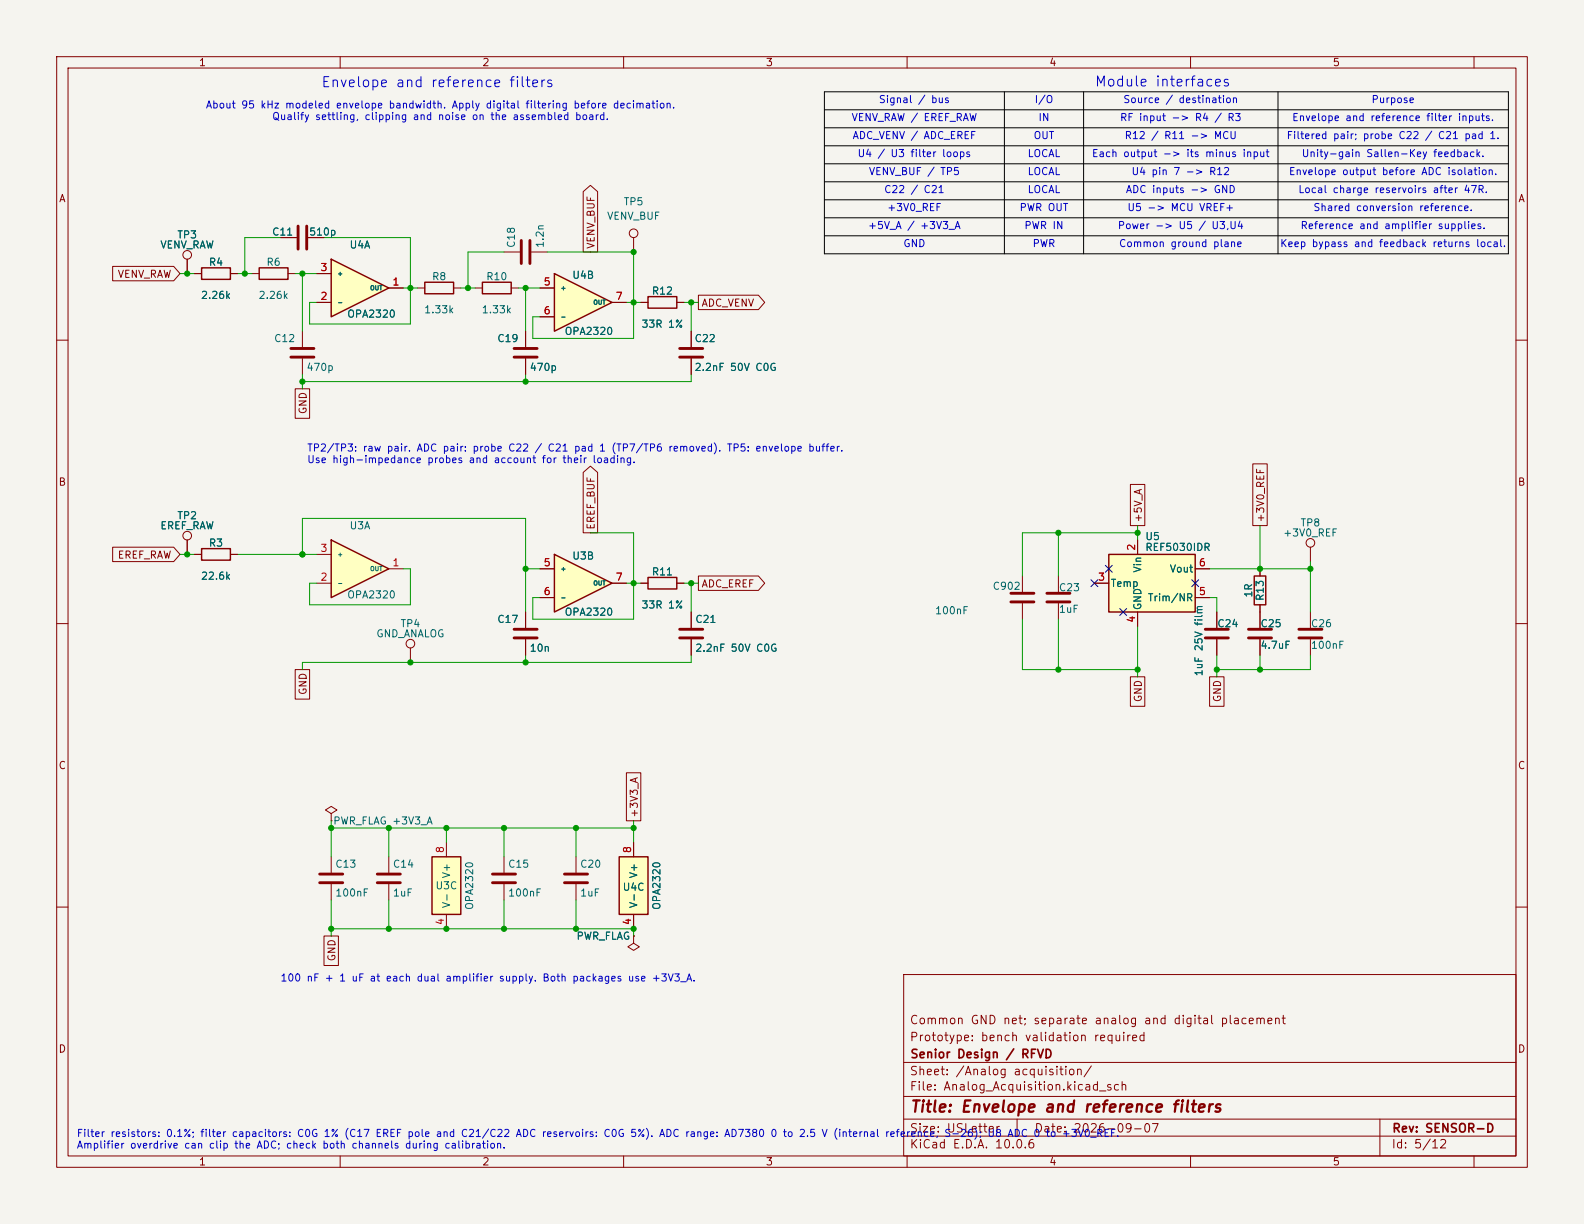
[picture p61: page 5]

Module interfaces R12 / R11 -> MCU Envelope and reference filters

PWR OUT OUT VENV_RAW / EREF_RAW +5V_A / +3V3_A GND U4 / U3 filter loops +3V0_REF PWR LOCAL | | Purpose About 95 kHz modeled envelope bandwidth. Apply digital filtering before decimation. Qualify settling, clipping and noise on the assembled board.

IN | Each output -> its minus input Source / destination RF input -> R4 / R3

ADC_VENV / ADC_EREF | | | Local charge reservoirs after 47R. Envelope and reference filter inputs.

LOCAL | | Envelope output before ADC isolation. Filtered pair; probe C22 / C21 pad 1. Unity-gain Sallen-Key feedback. Keep bypass and feedback returns local. U5 -> MCU VREF+

C22 / C21 | LOCAL | ADC inputs -> GND | Reference and amplifier supplies. Shared conversion reference. VENV_BUF / TP5

100 nF + 1 uF at each dual amplifier supply. Both packages use +3V3_A. Filter resistors: 0.1%; filter capacitors: C0G 1% (C17 EREF pole and C21/C22 ADC reservoirs: C0G 5%). ADC range: AD7380 0 to 2.5 V (internal reference, S-26); U8 ADC 0 to +3V0_REF. Amplifier overdrive can clip the ADC; check both channels during calibration.

Common GND net; separate analog and digital placement
Prototype: bench validation required
Senior Design / RFVD
Sheet: /Analog acquisition/
File: Analog_Acquisition.kicad_sch
Title: Envelope and reference filters

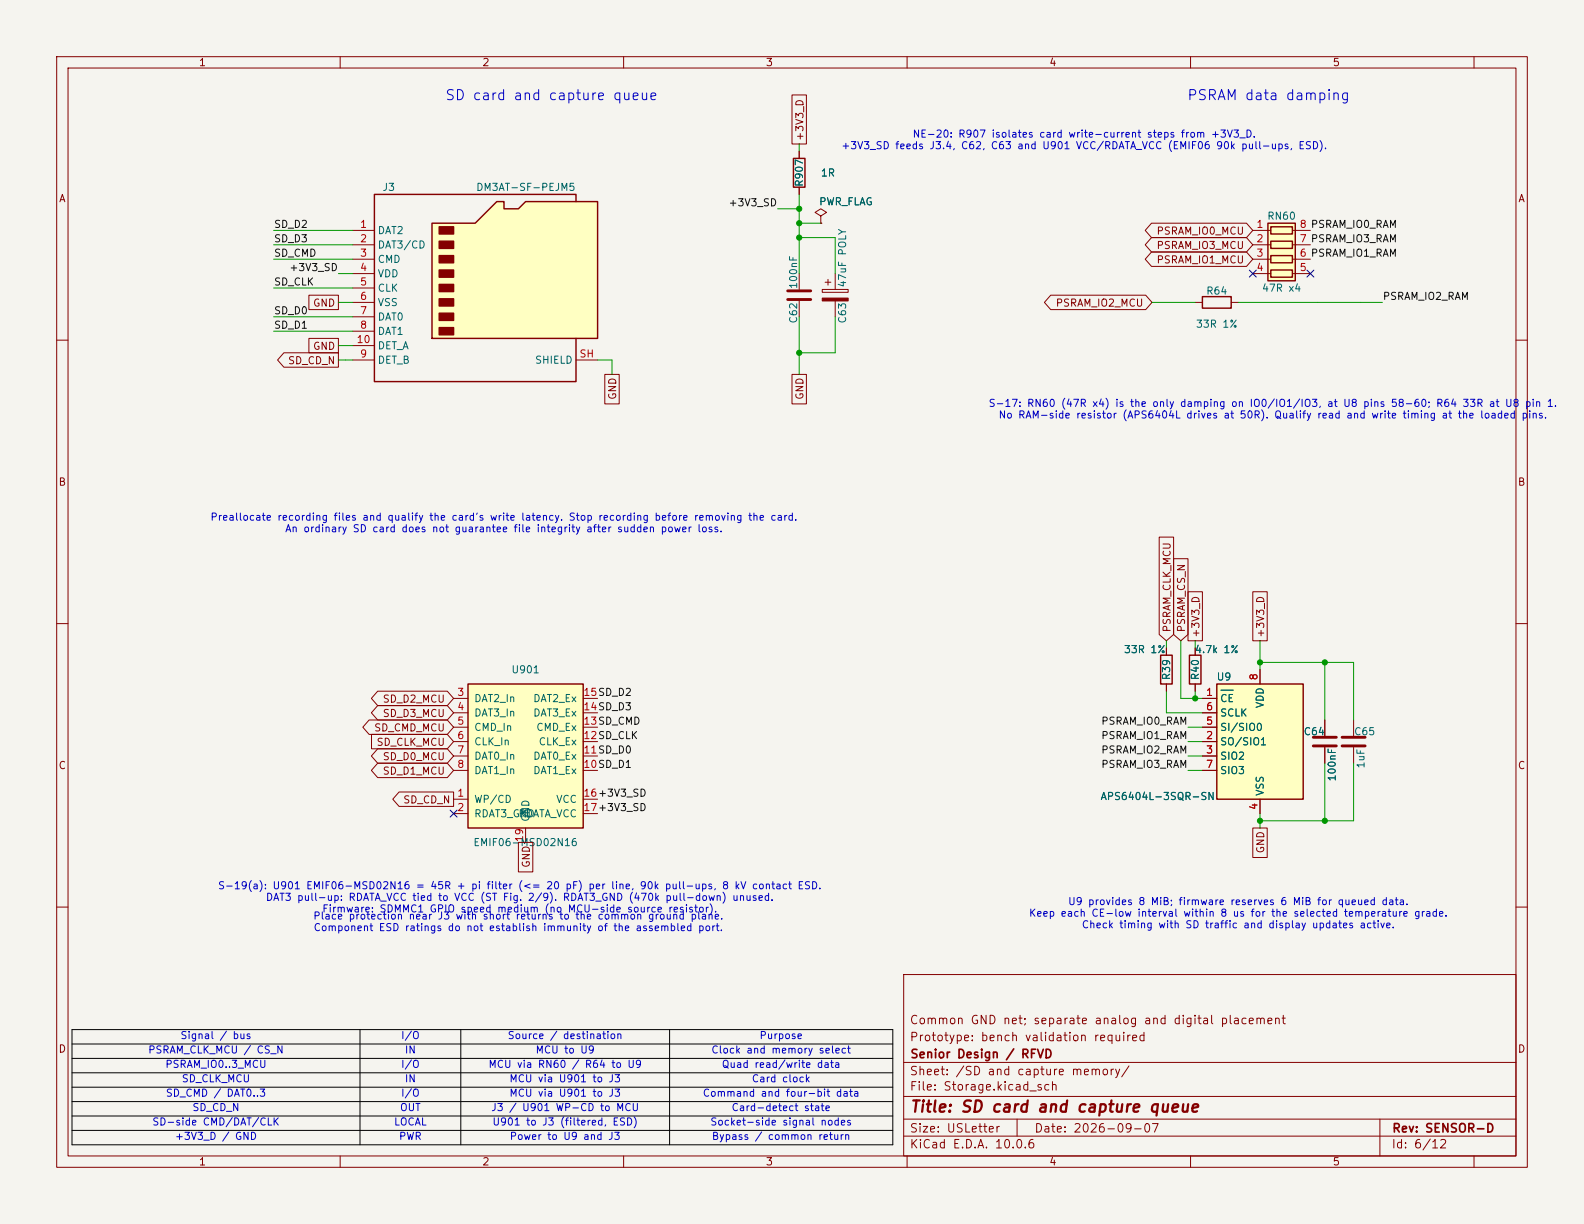
[picture p62: page 6]

S-17: RN60 (47R x4) is the only damping on IO0/IO1/IO3, at U8 pins 58-60; R64 33R at U8 pin 1. No RAM-side resistor (APS6404L drives at 50R). Qualify read and write timing at the loaded pins. NE-20: R907 isolates card write-current steps from +3V3_D. +3V3_SD feeds J3.4, C62, C63 and U901 VCC/RDATA_VCC (EMIF06 90k pull-ups, ESD).

Preallocate recording files and qualify the card's write latency. Stop recording before removing the card. An ordinary SD card does not guarantee file integrity after sudden power loss.

Common GND net; separate analog and digital placement R39

Place protection near J3 with short returns to the common ground plane.

I/O | Source / destination | Clock and memory select

Purpose MCU to U9 MCU via U901 to J3 Power to U9 and J3 MCU via RN60 / R64 to U9 MCU via U901 to J3

Prototype: bench validation required
Senior Design / RFVD
Sheet: /SD and capture memory/
File: Storage.kicad_sch
Title: SD card and capture queue

PSRAM_CLK_MCU / CS_N | IN

SD_CLK_MCU | IN
SD_CMD / DAT0..3 +3V3_D / GND | | J3 / U901 WP-CD to MCU

SD-side CMD/DAT/CLK | LOCAL | U901 to J3 (filtered, ESD)

PWR

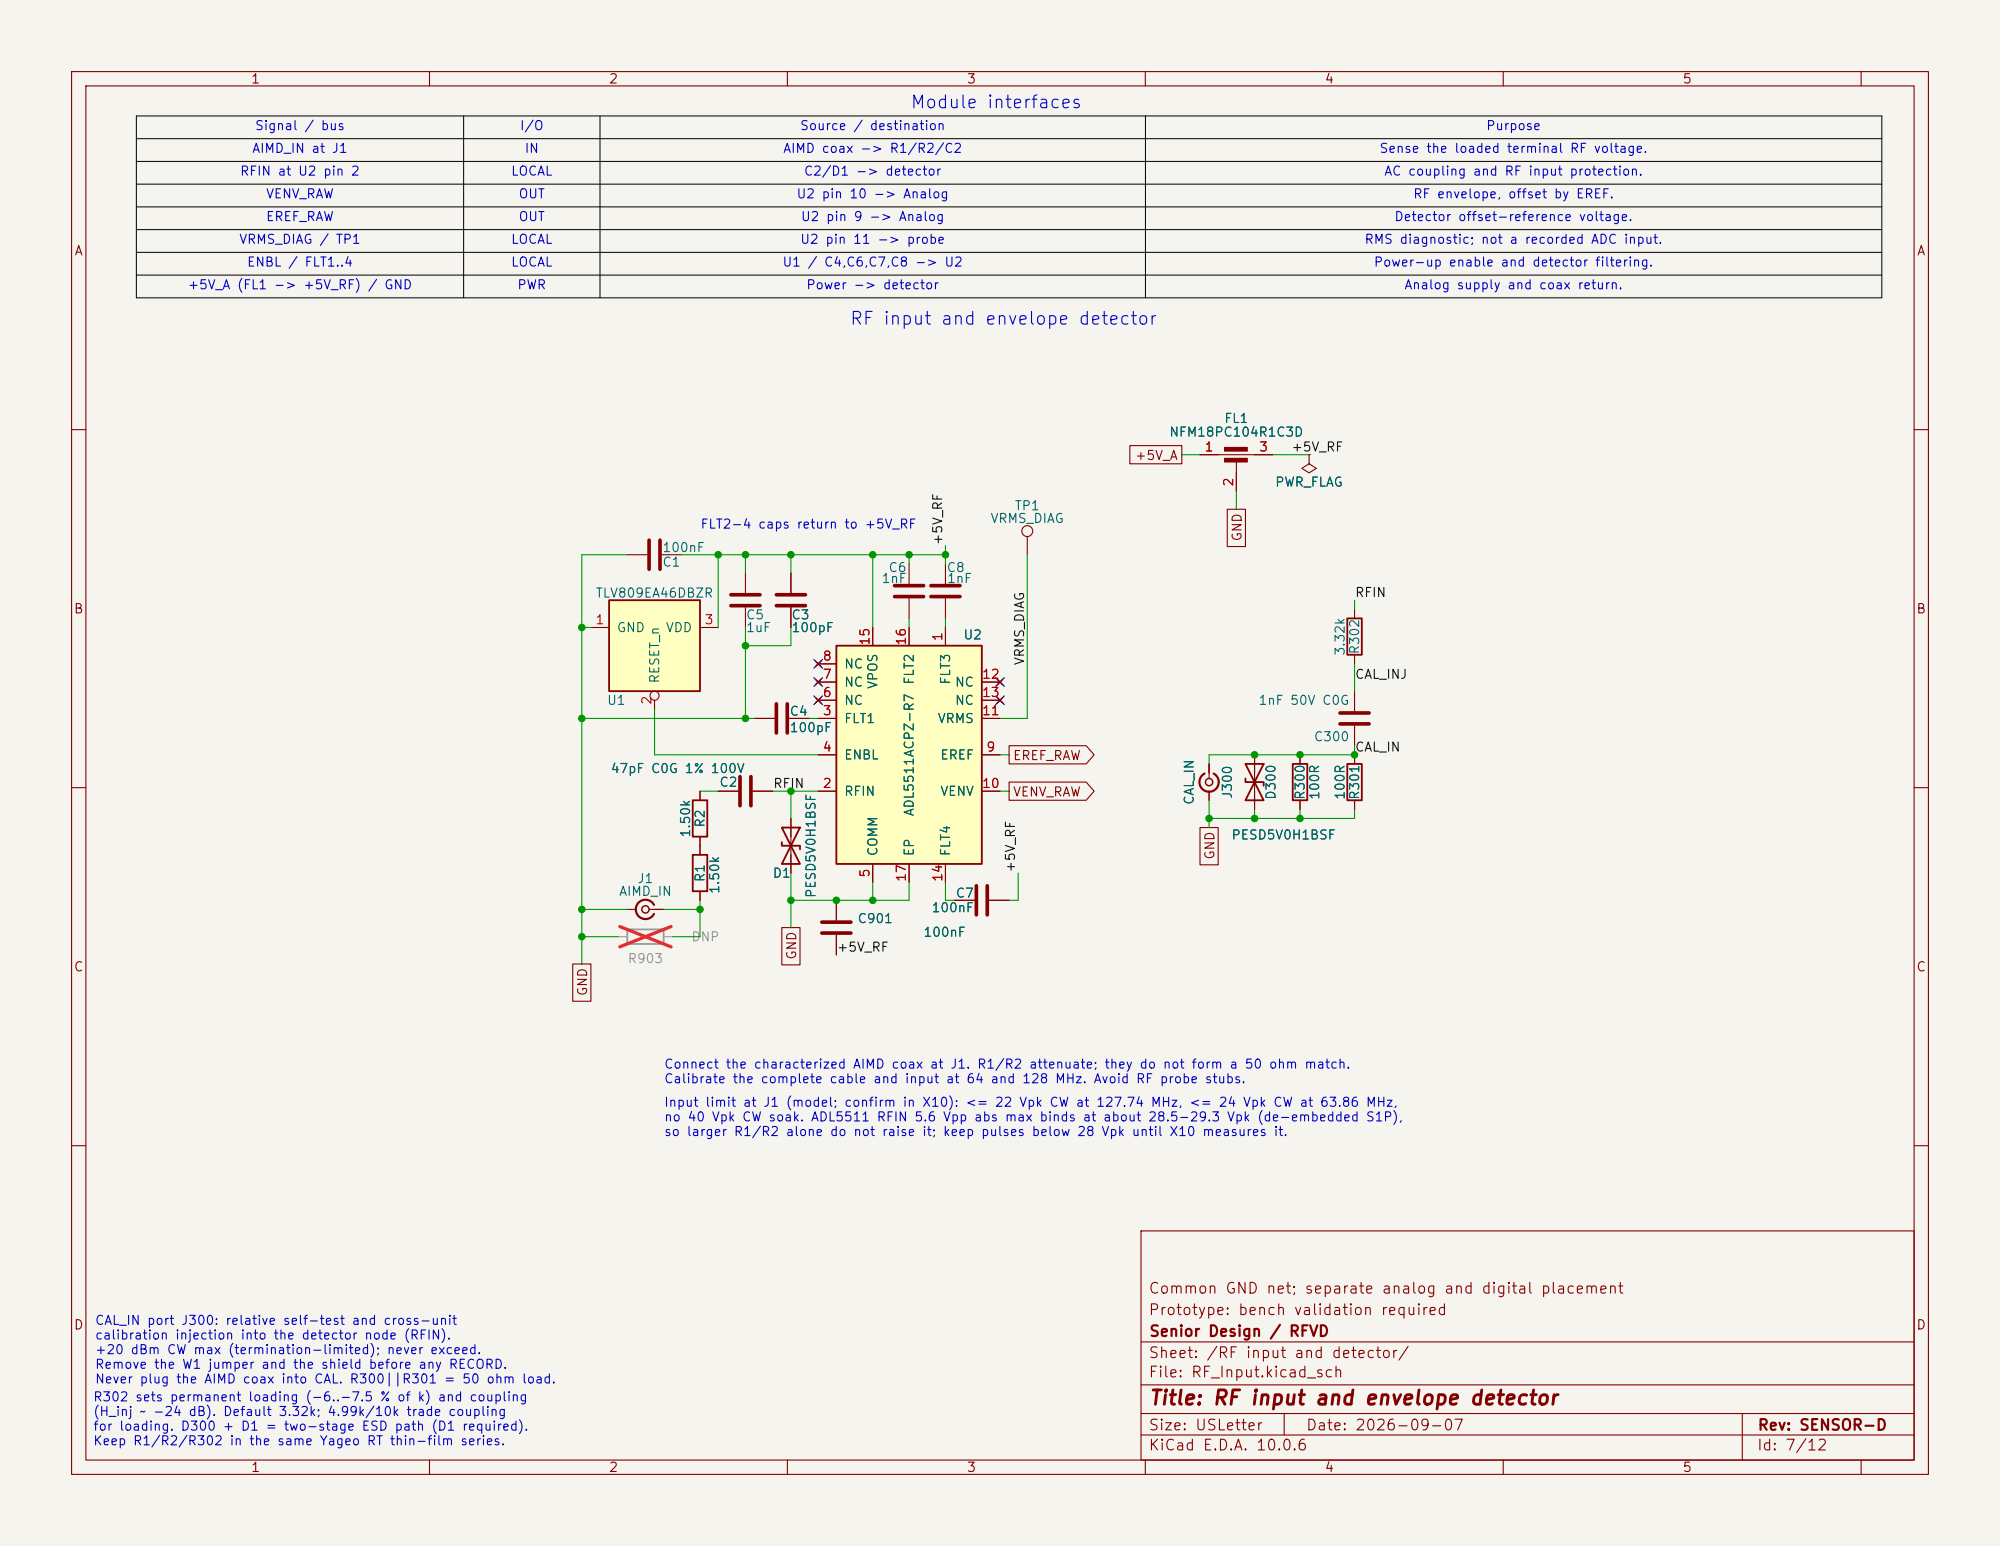
[picture p63: page 7]

Signal / bus EREF_RAW +5V_A (FL1 -> +5V_RF) / GND

AIMD_IN at J1 | IN | Source / destination U2 pin 9 -> Analog U2 pin 10 -> Analog AIMD coax -> R1/R2/C2 | Purpose RFIN at U2 pin 2

LOCAL | Power -> detector | Sense the loaded terminal RF voltage. AC coupling and RF input protection. Power-up enable and detector filtering. RF envelope, offset by EREF. Detector offset-reference voltage.

LOCAL PWR | C2/D1 -> detector RF input and envelope detector ENBL / FLT1..4 | Analog supply and coax return. LOCAL OUT

VRMS_DIAG / TP1 | U2 pin 11 -> probe

RMS diagnostic; not a recorded ADC input. Connect the characterized AIMD coax at J1. R1/R2 attenuate; they do not form a 50 ohm match. Calibrate the complete cable and input at 64 and 128 MHz. Avoid RF probe stubs.

FLT2-4 caps return to +5V_RF R302 sets permanent loading (-6..-7.5 % of k) and coupling

Input limit at J1 (model; confirm in X10): <= 22 Vpk CW at 127.74 MHz, <= 24 Vpk CW at 63.86 MHz, no 40 Vpk CW soak. ADL5511 RFIN 5.6 Vpp abs max binds at about 28.5-29.3 Vpk (de-embedded S1P), so larger R1/R2 alone do not raise it; keep pulses below 28 Vpk until X10 measures it. CAL_IN port J300: relative self-test and cross-unit calibration injection into the detector node (RFIN). +20 dBm CW max (termination-limited); never exceed. Remove the W1 jumper and the shield before any RECORD. Never plug the AIMD coax into CAL. R300||R301 = 50 ohm load.

Common GND net; separate analog and digital placement
Prototype: bench validation required
Senior Design / RFVD
Sheet: /RF input and detector/
File: RF_Input.kicad_sch
Title: RF input and envelope detector

(H_inj ~ -24 dB). Default 3.32k; 4.99k/10k trade coupling
for loading. D300 + D1 = two-stage ESD path (D1 required).
Keep R1/R2/R302 in the same Yageo RT thin-film series.

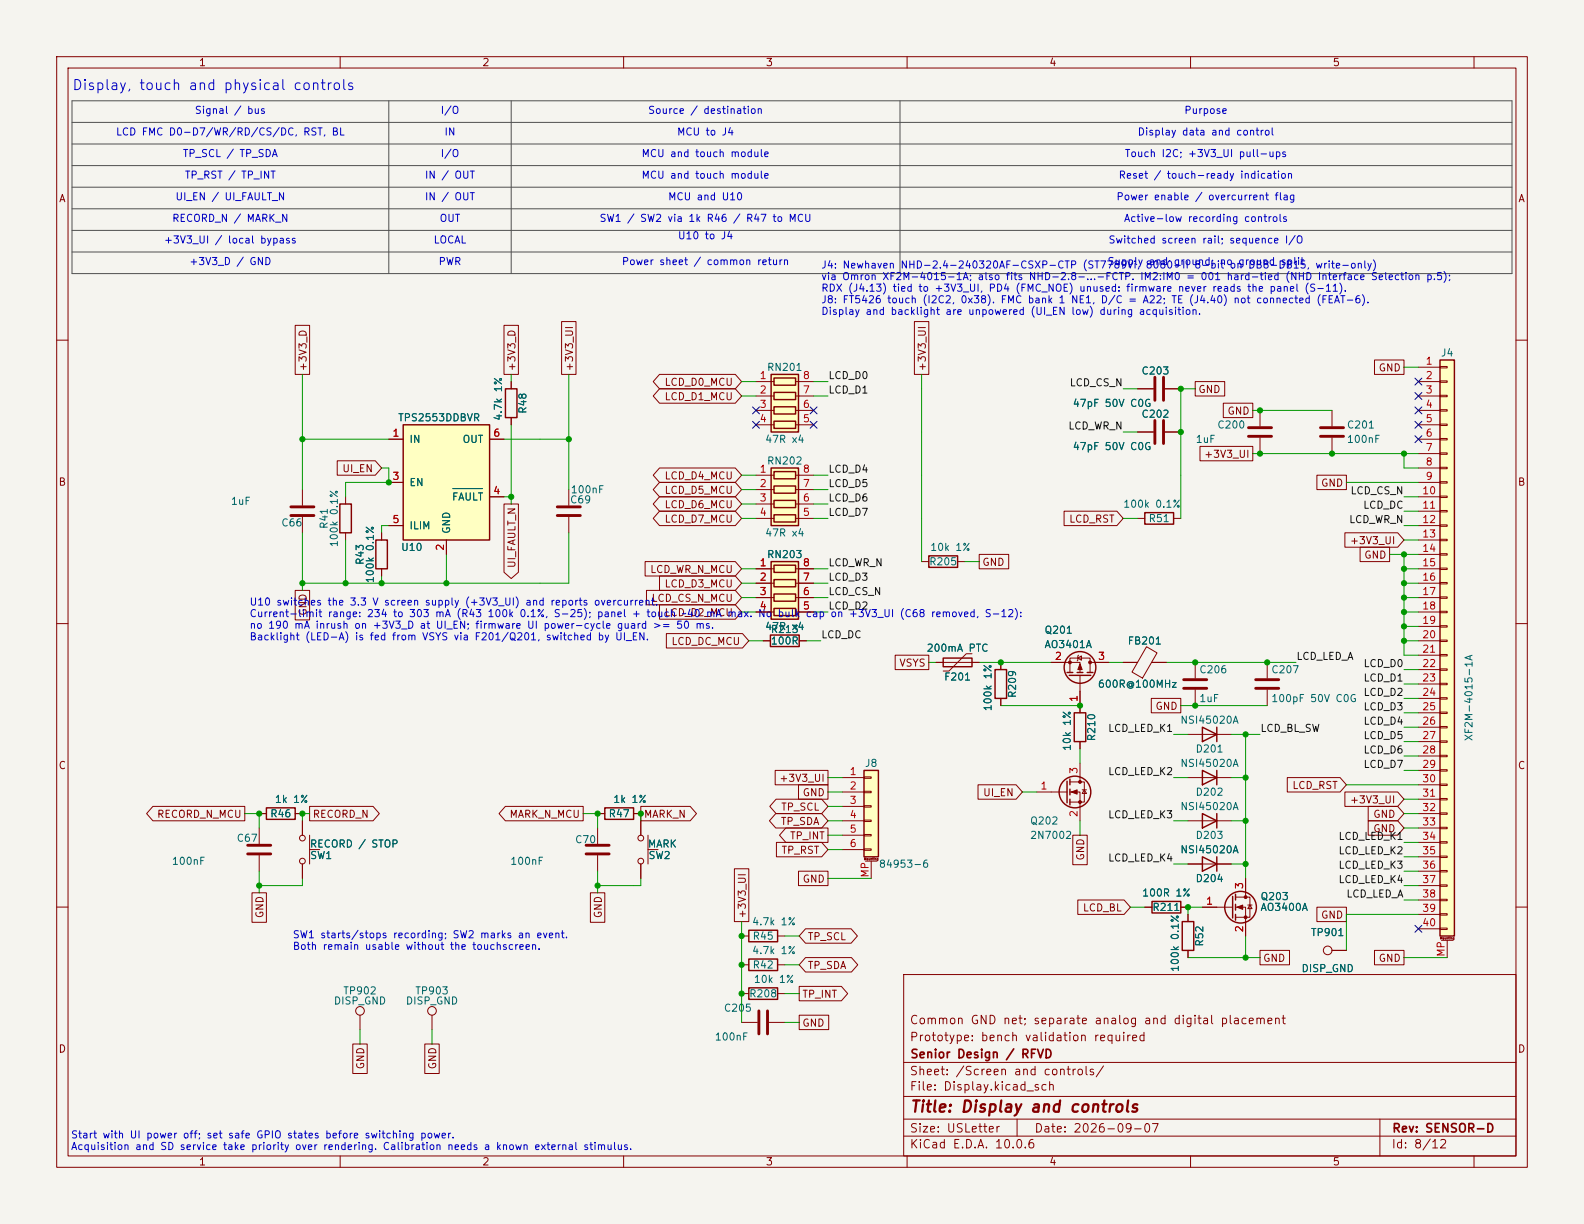
[picture p64: page 8]

IN | | Purpose RECORD_N / MARK_N Display, touch and physical controls

TP_SCL / TP_SDA | IN / OUT I/O | Power sheet / common return Signal / bus MCU and U10 +3V3_D / GND MCU and touch module OUT LCD FMC D0-D7/WR/RD/CS/DC, RST, BL MCU to J4 MCU and touch module U10 to J4 | Display data and control Active-low recording controls Reset / touch-ready indication

I/O | Source / destination

TP_RST / TP_INT UI_EN / UI_FAULT_N | | Touch I2C; +3V3_UI pull-ups Switched screen rail; sequence I/O

IN / OUT +3V3_UI / local bypass

SW1 / SW2 via 1k R46 / R47 to MCU

Supply and ground; no ground split
LCD_CS_N

SW1 starts/stops recording; SW2 marks an event. Both remain usable without the touchscreen. Start with UI power off; set safe GPIO states before switching power. Acquisition and SD service take priority over rendering. Calibration needs a known external stimulus.

Common GND net; separate analog and digital placement TP902 DISP_GND

Prototype: bench validation required
Senior Design / RFVD
Sheet: /Screen and controls/
File: Display.kicad_sch
Title: Display and controls

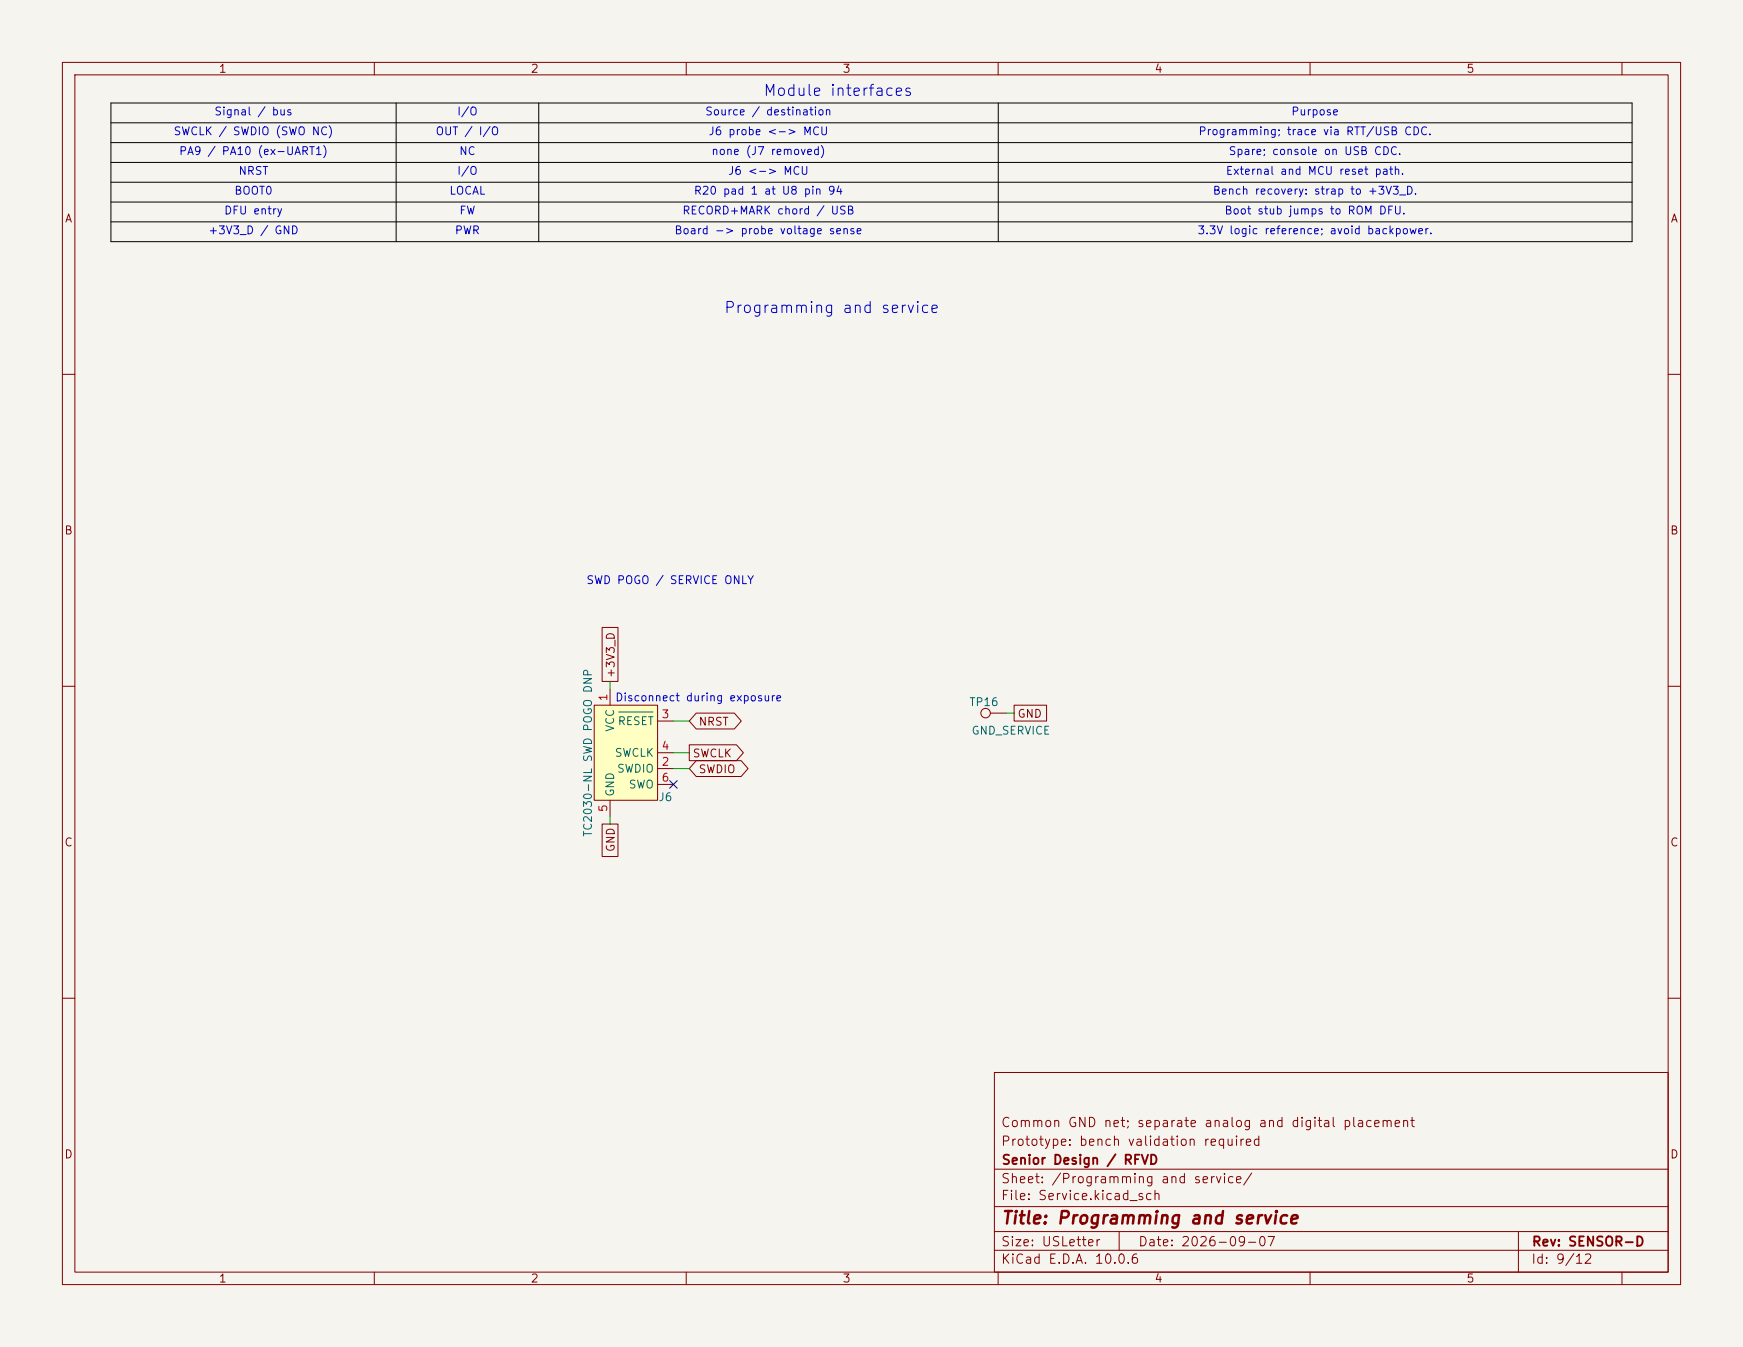
[picture p65: page 9]

Signal / bus BOOT0 | | Board -> probe voltage sense Module interfaces J6 probe <-> MCU

Source / destination

SWCLK / SWDIO (SWO NC) DFU entry PA9 / PA10 (ex-UART1) | | none (J7 removed) R20 pad 1 at U8 pin 94 RECORD+MARK chord / USB OUT / I/O | Spare; console on USB CDC. External and MCU reset path. NC
LOCAL I/O | J6 <-> MCU | Programming; trace via RTT/USB CDC. NRST +3V3_D / GND

3.3V logic reference; avoid backpower.

J6 TC2030-NL SWD POGO DNP

TP16 GND_SERVICE GND
Common GND net; separate analog and digital placement VCC

Prototype: bench validation required
Senior Design / RFVD
Sheet: /Programming and service/
File: Service.kicad_sch
Title: Programming and service

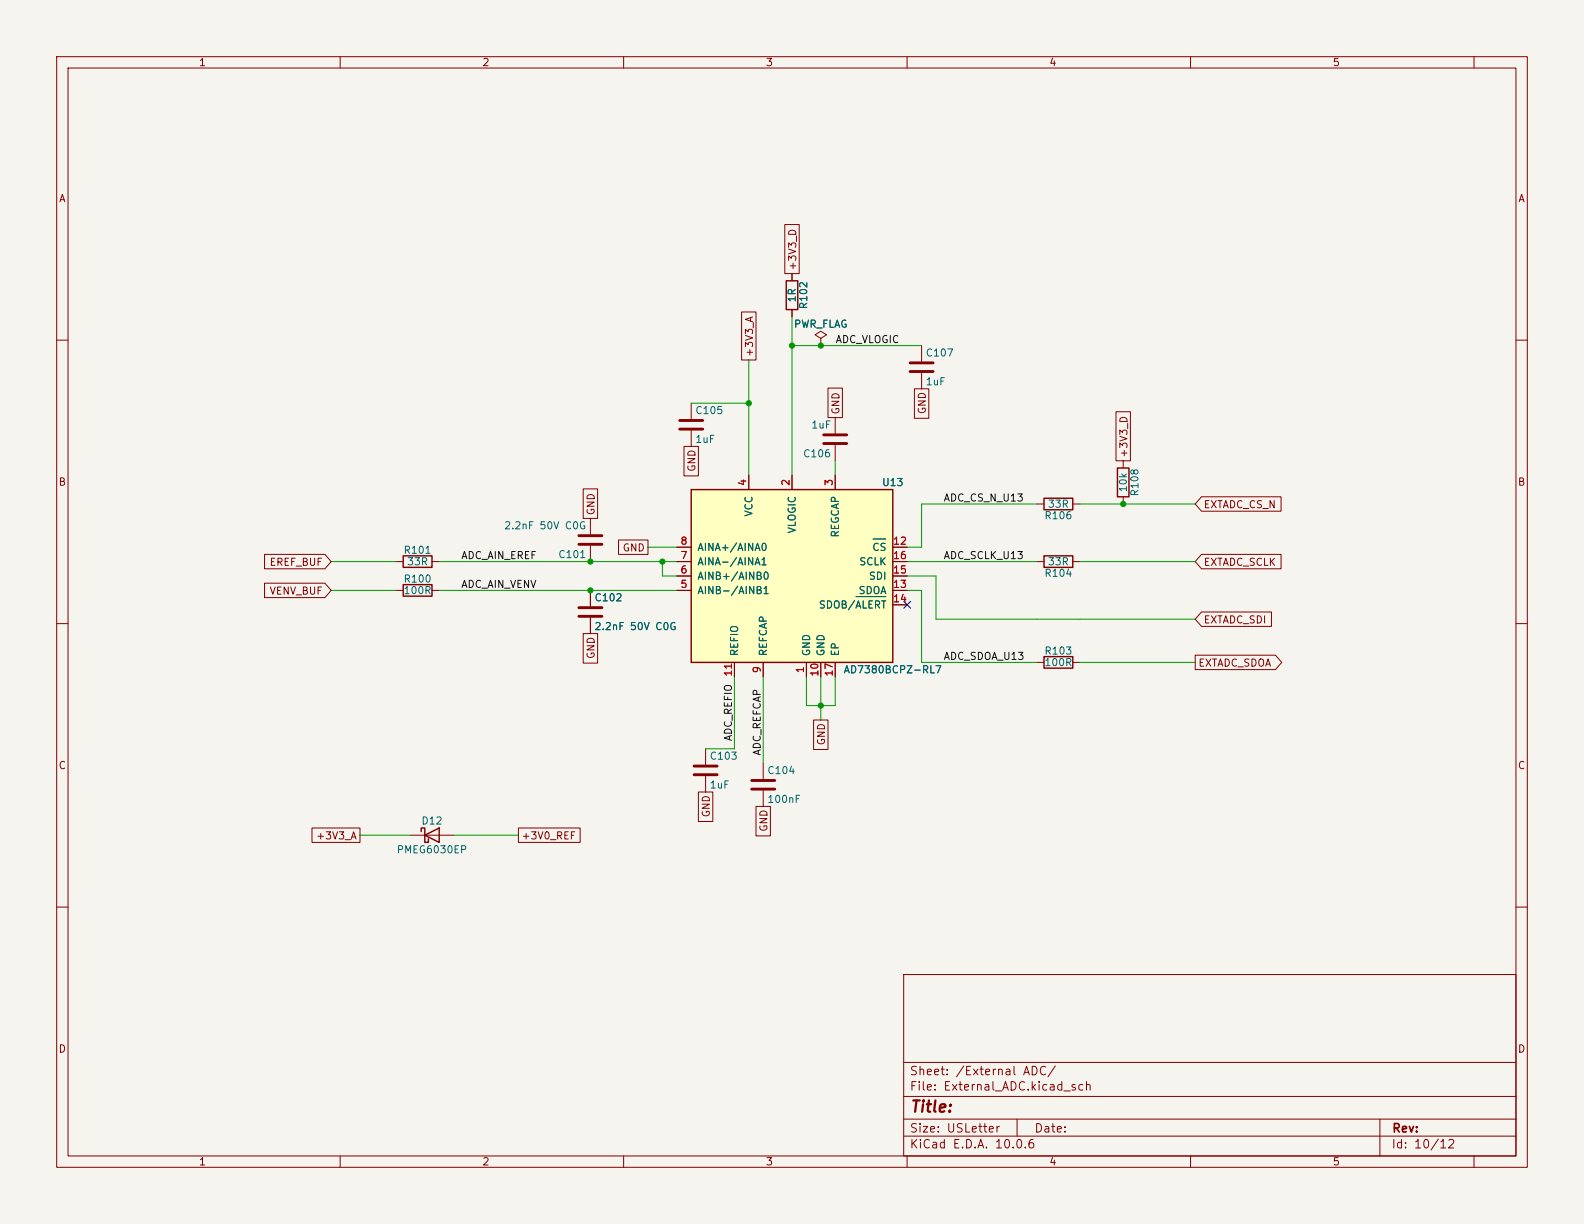
[picture p66: page 10]

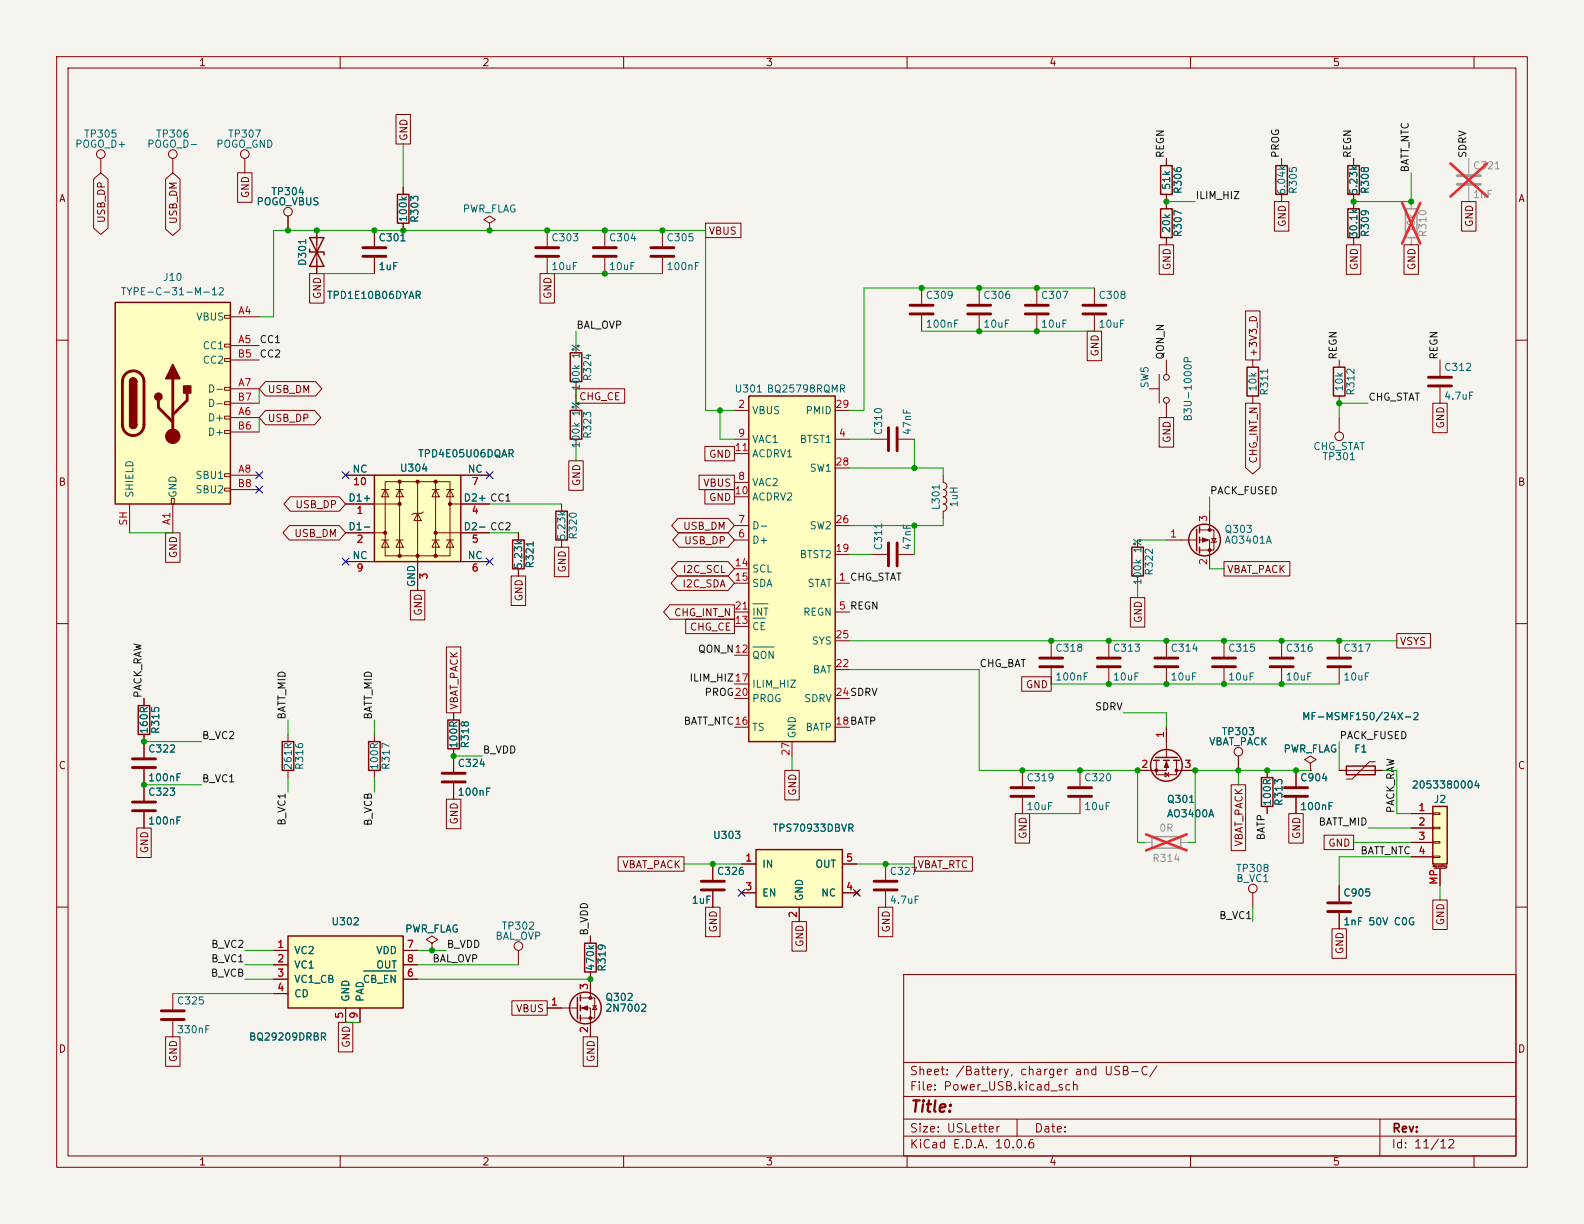
[picture p67: page 11]

Sheet: /Battery, charger and USB-C/
File: Power_USB.kicad_sch
Title:

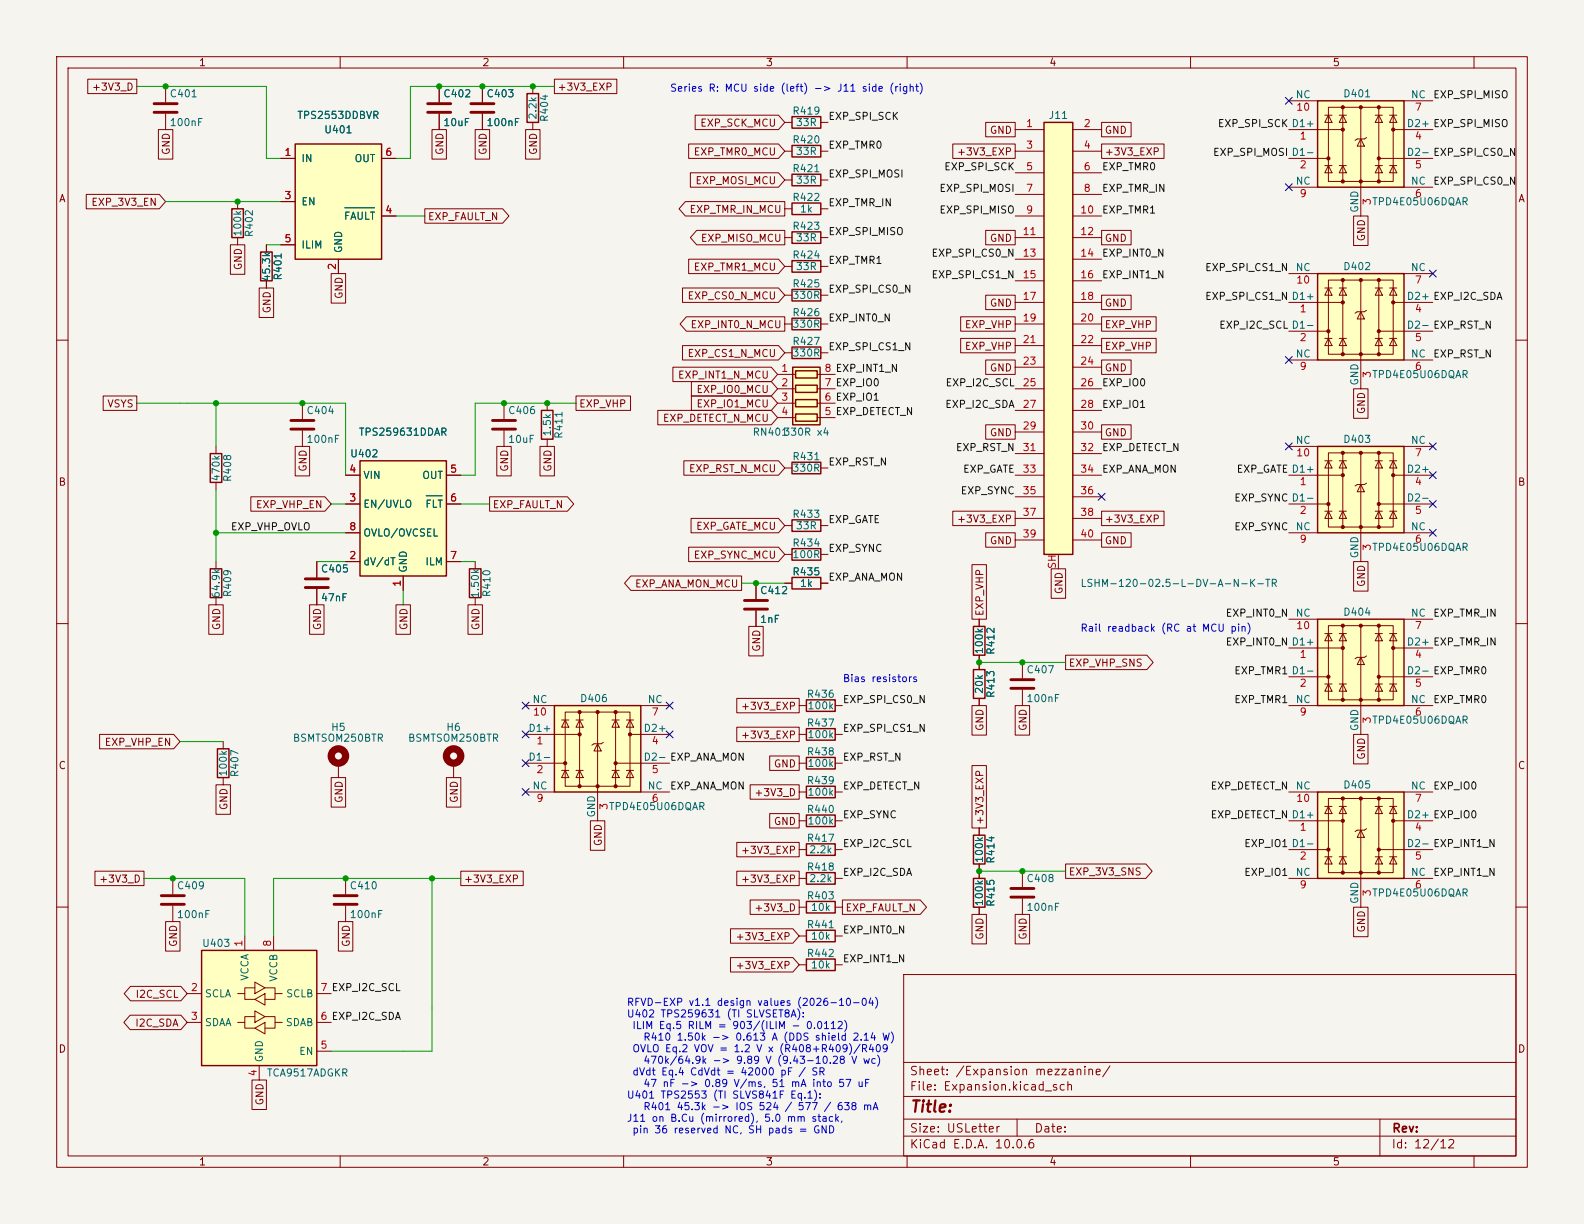
[picture p68: page 12]

Sheet: /Expansion mezzanine/ 100k R407 VCCA 1

ILIM Eq.5 RILM = 903/(ILIM - 0.0112) R410 1.50k -> 0.613 A (DDS shield 2.14 W) OVLO Eq.2 VOV = 1.2 V x (R408+R409)/R409

470k/64.9k -> 9.89 V (9.43-10.28 V wc) dVdt Eq.4 CdVdt = 42000 pF / SR

47 nF -> 0.89 V/ms, 51 mA into 57 uF U401 TPS2553 (TI SLVS841F Eq.1): R401 45.3k -> IOS 524 / 577 / 638 mA

J11 on B.Cu (mirrored), 5.0 mm stack,
pin 36 reserved NC, SH pads = GND
