Able-Digital-Logic/UnintendedAntennaClub3/Hardware/RFVD_SENSOR_BOARD_Rev6/RFVD_SENSOR_BOARD.kicad_pcb

## KiCad design Hardware/RFVD_SENSOR_BOARD_Rev6/RFVD_SENSOR_BOARD.kicad_pcb (2026-10-08)

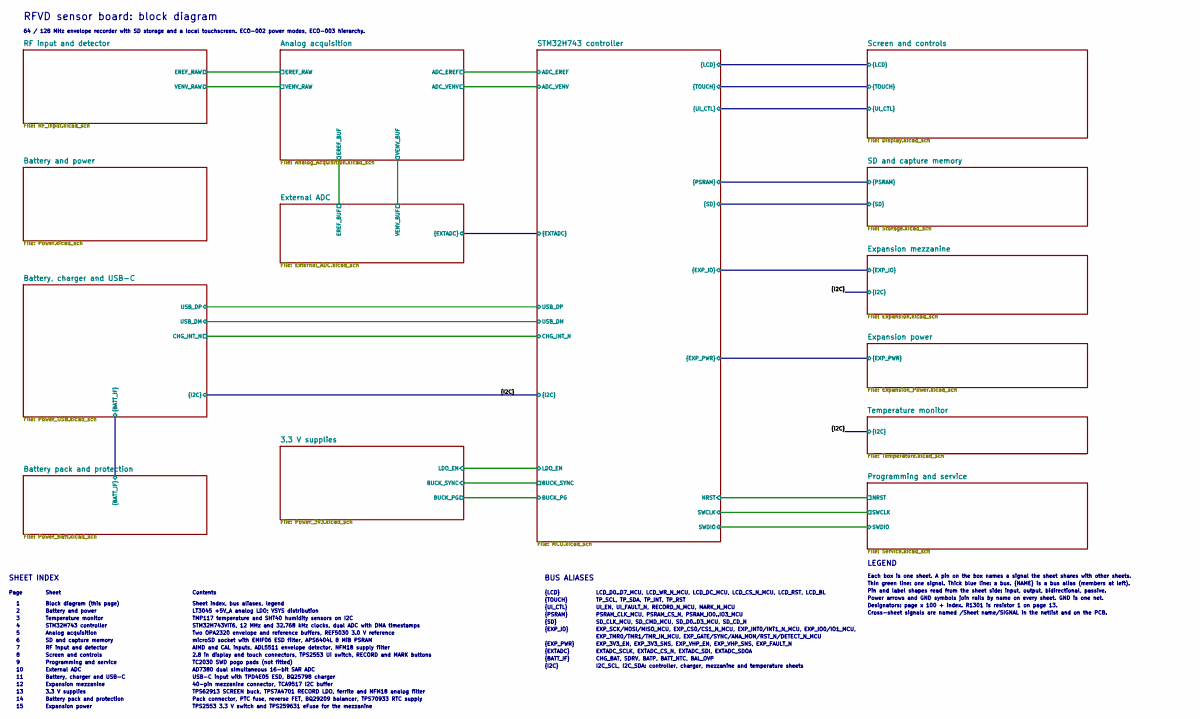
[picture p69: schematic RFVD_SENSOR_BOARD.kicad_sch, RFVD sensor board: block diagram]

Notes on the sheet:
TMP117 temperature and SHT40 humidity sensors on I2C
Thin green line: one signal. Thick blue line: a bus. {NAME} is a bus alias (members at left).
Designators: page x 100 + index. R1301 is resistor 1 on page 13.
Sheet index, bus aliases, legend
STM32H743 controller
Programming and service
Pin and label shapes read from the sheet side: input, output, bidirectional, passive.
Power arrows and GND symbols join rails by name on every sheet. GND is one net.
{I2C}
Each box is one sheet. A pin on the box names a signal the sheet shares with other sheets.
Sheet
USB-C input with TPD4E05 ESD, BQ25798 charger
Analog acquisition
LEGEND
TPS62913 SCREEN buck, TPS7A4701 RECORD LDO, ferrite and NFM18 analog filter
SD_CLK_MCU, SD_CMD_MCU, SD_D0..D3_MCU, SD_CD_N
EXP_TMR0/TMR1/TMR_IN_MCU, EXP_GATE/SYNC/ANA_MON/RST_N/DETECT_N_MCU
Pack connector, PTC fuse, reverse FET, BQ29209 balancer, TPS70933 RTC supply
LT3045 +5V_A analog LDO; VSYS distribution
{BATT_IF}
PSRAM_CLK_MCU, PSRAM_CS_N, PSRAM_IO0..IO3_MCU
EXP_SCK/MOSI/MISO_MCU, EXP_CS0/CS1_N_MCU, EXP_INT0/INT1_N_MCU, EXP_IO0/IO1_MCU,
I2C_SCL, I2C_SDA: controller, charger, mezzanine and temperature sheets
Battery and power
Cross-sheet signals are named /Sheet name/SIGNAL in the netlist and on the PCB.
STM32H743VIT6, 12 MHz and 32.768 kHz clocks, dual ADC with DMA timestamps
{EXP_PWR}
Page
{EXP_IO}
Temperature monitor
Battery, charger and USB-C
Contents
AD7380 dual simultaneous 16-bit SAR ADC
{UI_CTL}
CHG_BAT, SDRV, BATP, BATT_NTC, BAL_OVP
UI_EN, UI_FAULT_N, RECORD_N_MCU, MARK_N_MCU
BUS ALIASES
{PSRAM}
RF input and detector
Two OPA2320 envelope and reference buffers, REF5030 3.0 V reference
Battery pack and protection
Expansion power
Screen and controls
TPS2553 3.3 V switch and TPS259631 eFuse for the mezzanine
{LCD}
Block diagram (this page)
3.3 V supplies
SD and capture memory
External ADC
microSD socket with EMIF06 ESD filter, APS6404L 8 MiB PSRAM
EXTADC_SCLK, EXTADC_CS_N, EXTADC_SDI, EXTADC_SDOA
64 / 128 MHz envelope recorder with SD storage and a local touchscreen. ECO-002 power modes, ECO-003 hierarchy.
2.8 in display and touch connectors, TPS2553 UI switch, RECORD and MARK buttons
40-pin mezzanine connector, TCA9517 I2C buffer
Expansion mezzanine
AIMD and CAL inputs, ADL5511 envelope detector, NFM18 supply filter
TP_SCL, TP_SDA, TP_INT, TP_RST
{SD}
RFVD sensor board: block diagram
LCD_D0..D7_MCU, LCD_WR_N_MCU, LCD_DC_MCU, LCD_CS_N_MCU, LCD_RST, LCD_BL
TC2030 SWD pogo pads (not fitted)
{EXTADC}
EXP_3V3_EN, EXP_3V3_SNS, EXP_VHP_EN, EXP_VHP_SNS, EXP_FAULT_N
SHEET INDEX
{TOUCH}

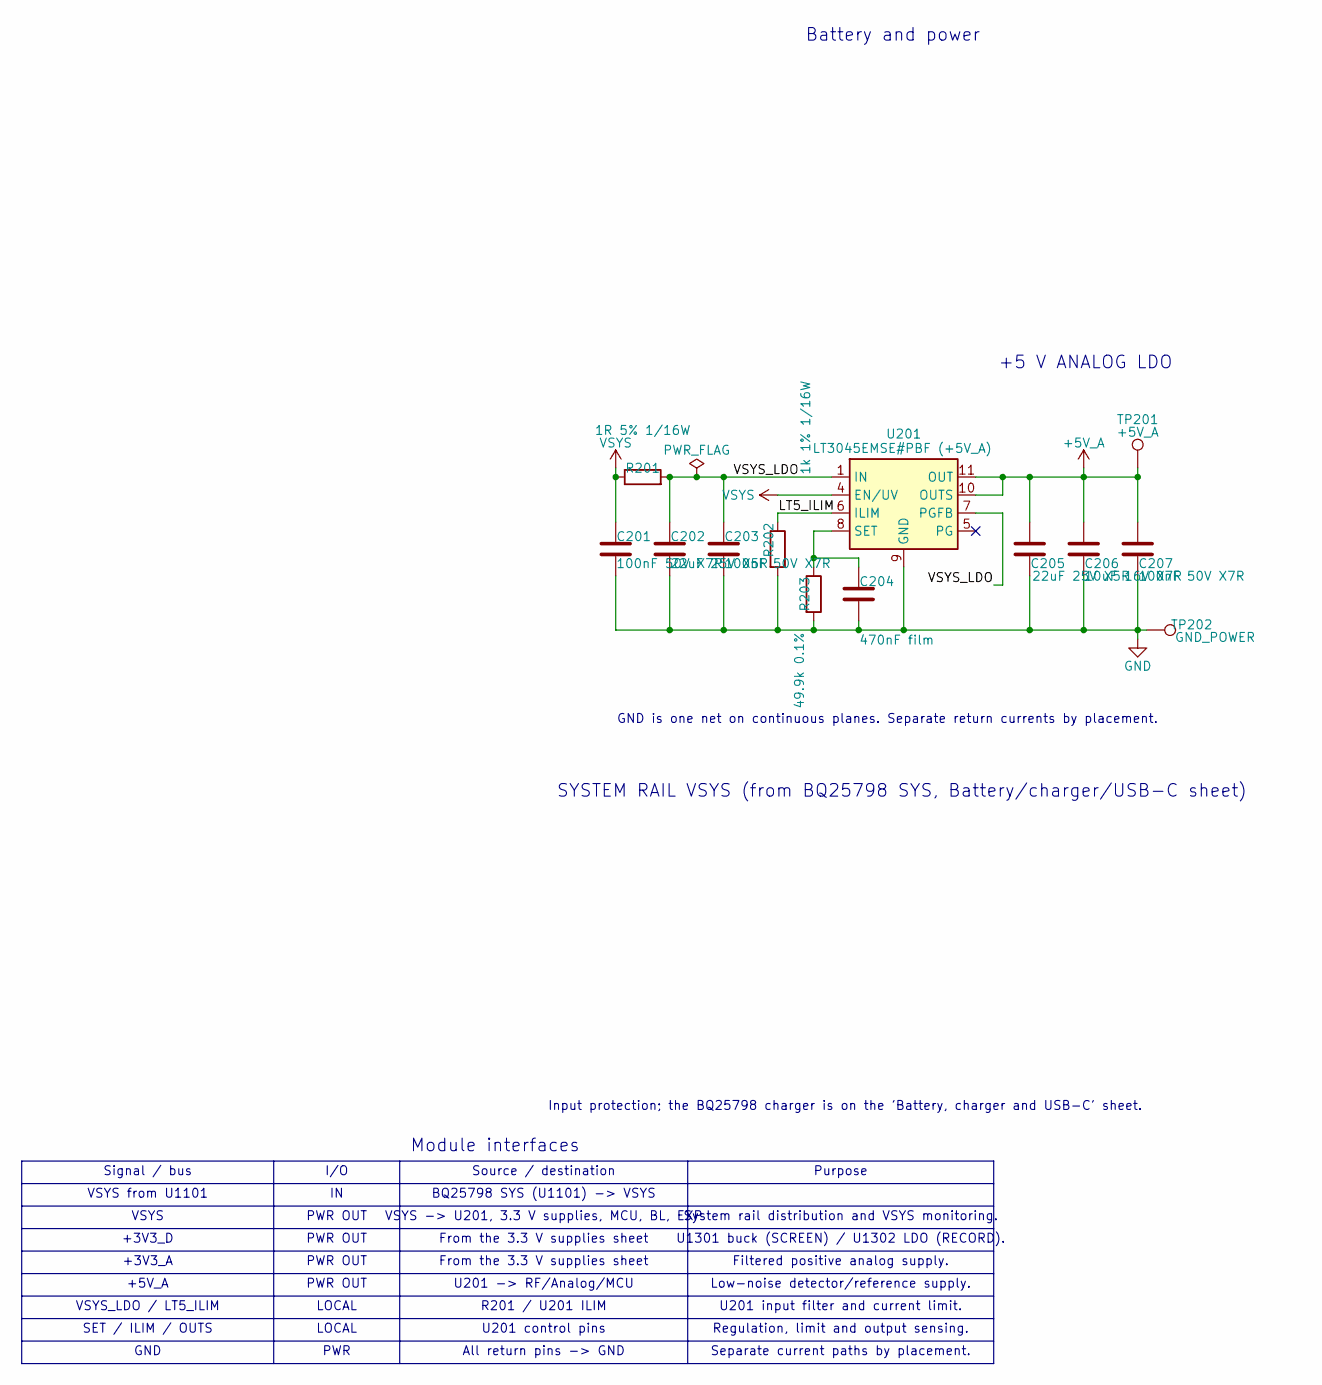
[picture p70: schematic Power.kicad_sch, Battery and power]

Parts:
C201: 100nF 50V X7R; C_0603_1608Metric; MPN CC0603KRX7R9BB104; LCSC C14663
C202, C205: 22uF 25V X5R; C_1206_3216Metric; MPN CL31A226KAHNNNE; LCSC C12891
C203, C207: 100nF 50V X7R; C_0402_1005Metric; MPN CL05B104KB54PNC; LCSC C307331
C204: 470nF film; C_1206_3216Metric; MPN 35MU474KA13216; LCSC C3773390
C206: 10uF 16V X7R; C_0805_2012Metric; MPN CL21B106KOQNNNE; LCSC C95841
R201: 1R 5% 1/16W; R_0402_1005Metric; MPN FRC0402J1R0 TS; JLCPCB_PN C2906901
R202: 1k 1% 1/16W; R_0402_1005Metric; MPN 0402WGF1001TCE; LCSC C11702
R203: 49.9k 0.1%; R_0603_1608Metric; MPN ERA3AEB4992V; LCSC C491136
TP201: +5V_A; TestPoint_Pad_D1.0mm; MPN DNP-NO-COMPONENT; LCSC N/A
TP202: GND_POWER; TestPoint_Pad_D1.0mm; MPN PCB_PAD
U201: LT3045EMSE#PBF (+5V_A); MSOP-12-1EP_3x4.039mm_P0.65mm_EP1.651x2.845mm; MPN LT3045EMSE#PBF; JLCPCB_PN C580012

Connections:
+5V_A: C205.1, C206.1, C207.1, TP201.1 (1_1), U201.10 (OUTS), U201.11 (OUT), U201.12 (OUT); also elsewhere on the board
/Battery and power/LT5_ILIM: R202.1, U201.6 (ILIM)
/Battery and power/VSYS_LDO: C202.1, C203.1, R201.2, U201.1 (IN), U201.2 (IN), U201.3 (IN), U201.7 (PGFB)
GND: C201.2, C202.2, C203.2, C204.2, C205.2, C206.2, C207.2, R202.2, R203.2, TP202.1 (1_1), U201.9 (GND), U201.13 (GND); also elsewhere on the board
unnamed: C204.1, R203.1, U201.8 (SET)
VSYS: C201.1, R201.1, U201.4 (EN/UV); also elsewhere on the board

Notes on the sheet:
+3V3_A
VSYS
+3V3_D
GND
I/O
VSYS -> U201, 3.3 V supplies, MCU, BL, EXP
From the 3.3 V supplies sheet
Battery and power
LOCAL
SYSTEM RAIL VSYS (from BQ25798 SYS, Battery/charger/USB-C sheet)
SET / ILIM / OUTS
VSYS_LDO / LT5_ILIM
BQ25798 SYS (U1101) -> VSYS
Input protection; the BQ25798 charger is on the 'Battery, charger and USB-C' sheet.
U201 -> RF/Analog/MCU
Signal / bus
Module interfaces
All return pins -> GND
U1301 buck (SCREEN) / U1302 LDO (RECORD).
R201 / U201 ILIM
VSYS from U1101
+5V_A
U201 input filter and current limit.
Separate current paths by placement.
PWR OUT
+5 V ANALOG LDO
GND is one net on continuous planes. Separate return currents by placement.
Source / destination
Low-noise detector/reference supply.
U201 control pins
Regulation, limit and output sensing.
Filtered positive analog supply.
System rail distribution and VSYS monitoring.
PWR
Purpose

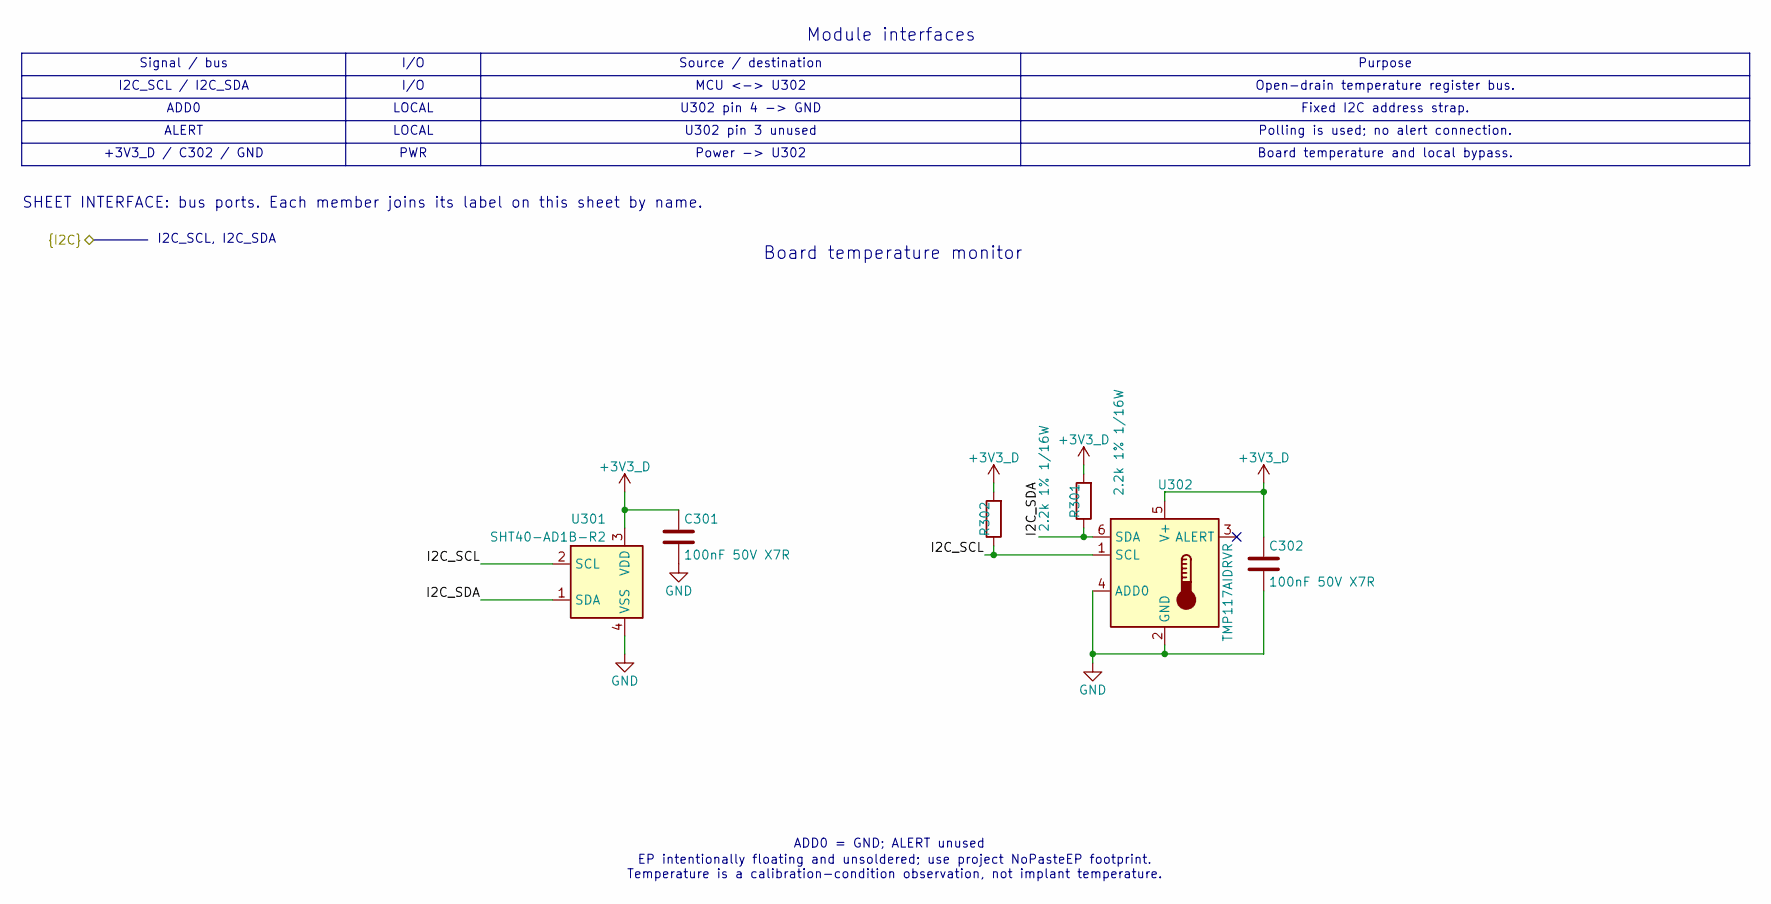
[picture p71: schematic Temperature.kicad_sch, Temperature monitor]

Parts:
C301: 100nF 50V X7R; C_0402_1005Metric; MPN CL05B104KB54PNC; JLCPCB_PN C307331
C302: 100nF 50V X7R; C_0402_1005Metric; MPN CL05B104KB54PNC; LCSC C307331
R301, R302: 2.2k 1% 1/16W; R_0402_1005Metric; MPN 0402WGF2201TCE; LCSC C25879
U301: SHT40-AD1B-R2; Sensirion_DFN-4_1.5x1.5mm_P0.8mm_SHT4x_NoCentralPad; MPN SHT40-AD1B-R702; JLCPCB_PN C2909890
U302: TMP117AIDRVR; TMP117_DRV_WSON6_NoPasteEP; MPN TMP117AIDRVR; JLCPCB_PN C699536

Connections:
+3V3_D: C301.1, C302.1, R301.2, R302.2, U301.3 (VDD), U302.5 (V+); also elsewhere on the board
/I2C_SCL: R302.1, U301.2 (SCL), U302.1 (SCL); also elsewhere on the board
/I2C_SDA: R301.1, U301.1 (SDA), U302.6 (SDA); also elsewhere on the board
GND: C301.2, C302.2, U301.4 (VSS), U302.2 (GND), U302.4 (ADD0); also elsewhere on the board

Notes on the sheet:
I2C_SCL / I2C_SDA
Fixed I2C address strap.
Board temperature and local bypass.
+3V3_D / C302 / GND
LOCAL
U302 pin 3 unused
Board temperature monitor
ADD0 = GND; ALERT unused
Source / destination
ALERT
PWR
Open-drain temperature register bus.
ADD0
U302 pin 4 -> GND
I2C_SCL, I2C_SDA
EP intentionally floating and unsoldered; use project NoPasteEP footprint. Temperature is a calibration-condition observation, not implant temperature.
Module interfaces
Purpose
Signal / bus
Polling is used; no alert connection.
Power -> U302
I/O
SHEET INTERFACE: bus ports. Each member joins its label on this sheet by name.
MCU <-> U302

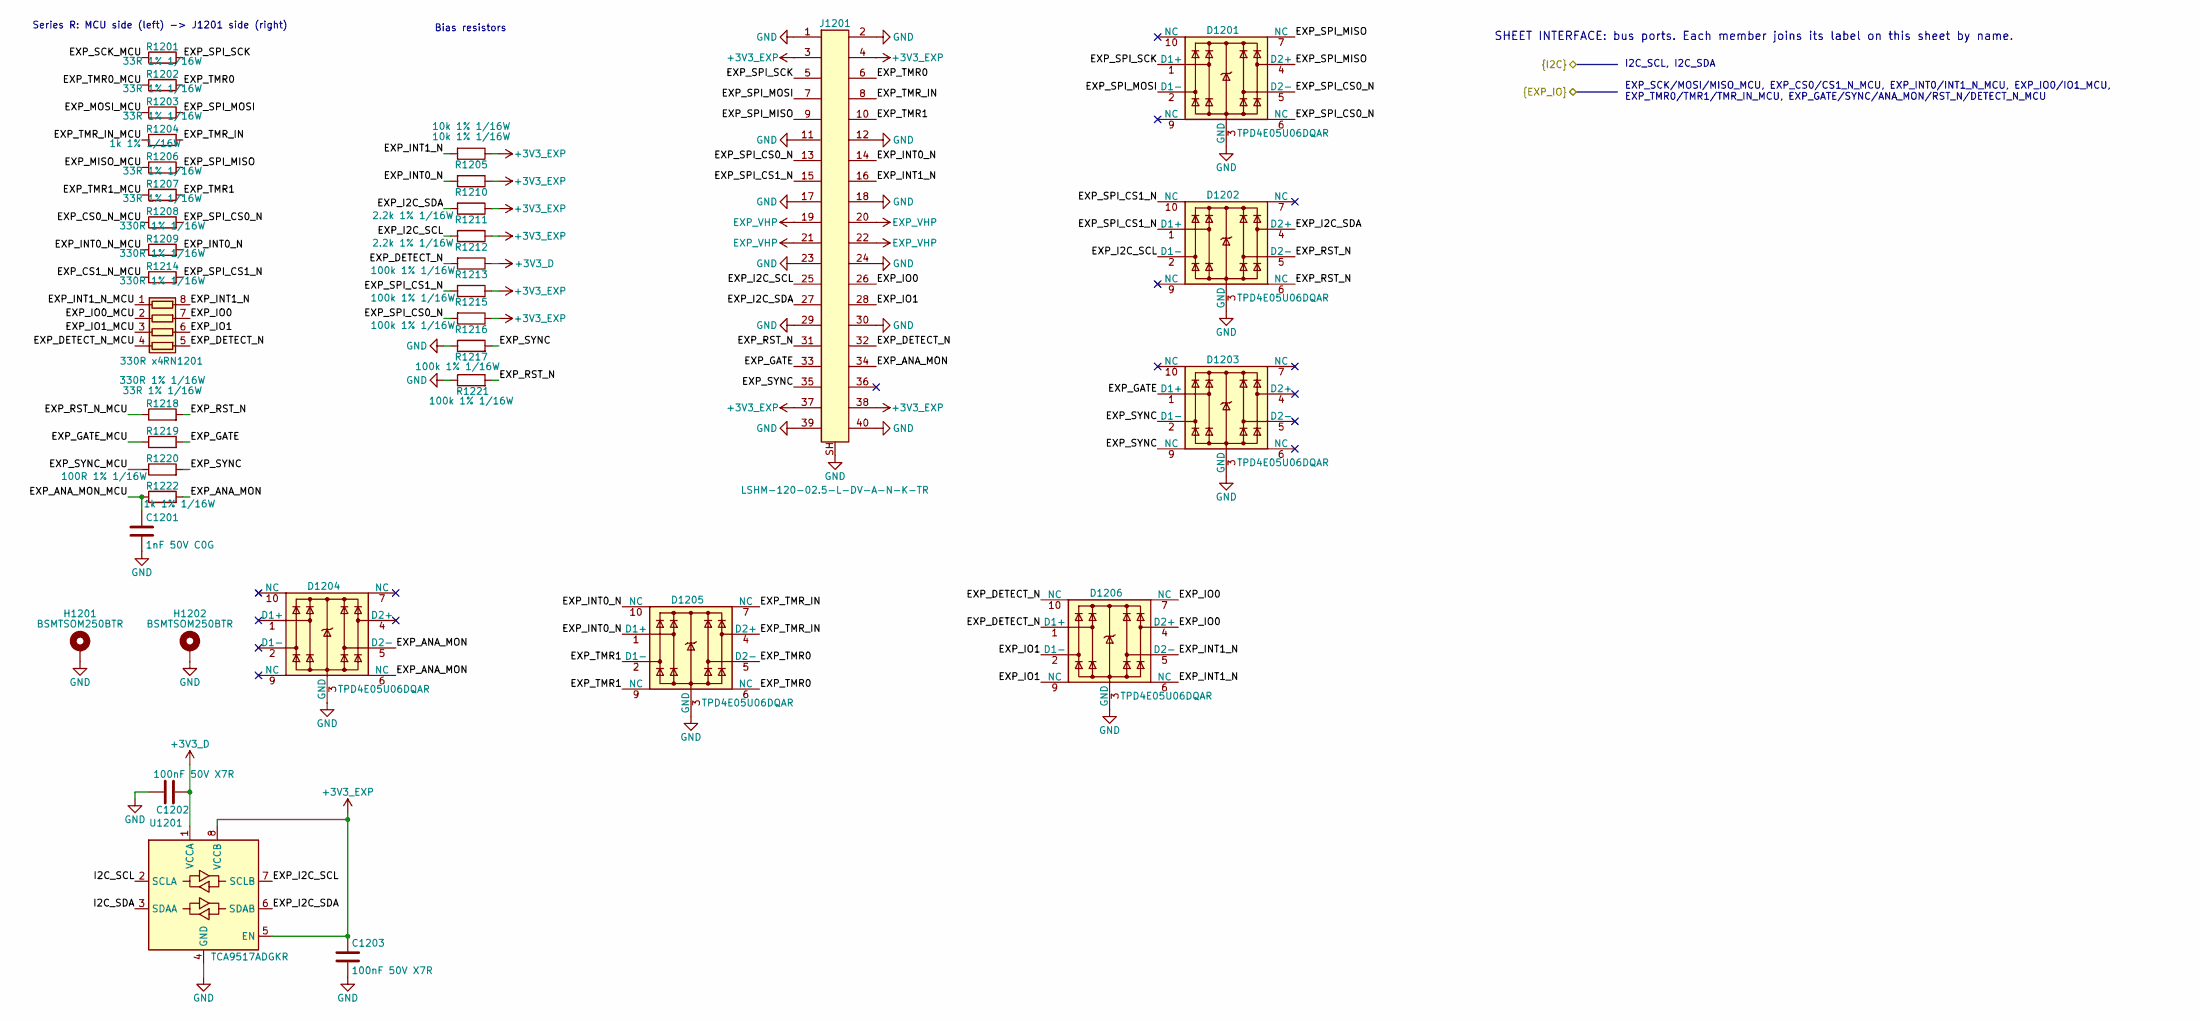
[picture p72: schematic Expansion.kicad_sch, Expansion mezzanine]

Parts:
C1201: 1nF 50V C0G; C_0402_1005Metric; MPN GRM1555C1H102JA01D; JLCPCB_PN C76947
C1202, C1203: 100nF 50V X7R; C_0402_1005Metric; MPN CL05B104KB54PNC; JLCPCB_PN C307331
D1201, D1202, D1203, D1204, D1205, D1206: TPD4E05U06DQAR; USON-10_2.5x1.0mm_P0.5mm; MPN TPD4E05U06DQAR; JLCPCB_PN C138714
H1201, H1202: BSMTSOM250BTR; Standoff_SMT_M2_BZXC_BSMTSOM2_Hole3.8mm_Pad6.2mm; MPN BSMTSOM250BTR; JLCPCB_PN C20617226
J1201: LSHM-120-02.5-L-DV-A-N-K-TR; Samtec_LSHM-120-xx.x-x-DV-S_2x20-1SH_P0.50mm_Vertical; MPN LSHM-120-02.5-L-DV-A-N-K-TR; JLCPCB_PN C6287797
R1201, R1202, R1203, R1206, R1207, R1219: 33R 1% 1/16W; R_0402_1005Metric; MPN 0402WGF330JTCE; JLCPCB_PN C25105
R1204, R1222: 1k 1% 1/16W; R_0402_1005Metric; MPN 0402WGF1001TCE; JLCPCB_PN C11702
R1205, R1210: 10k 1% 1/16W; R_0402_1005Metric; MPN 0402WGF1002TCE; JLCPCB_PN C25744
R1208, R1209, R1214, R1218: 330R 1% 1/16W; R_0402_1005Metric; MPN 0402WGF3300TCE; JLCPCB_PN C25104
R1211, R1212: 2.2k 1% 1/16W; R_0402_1005Metric; MPN 0402WGF2201TCE; JLCPCB_PN C25879
R1213, R1215, R1216, R1217, R1221: 100k 1% 1/16W; R_0402_1005Metric; MPN 0402WGF1003TCE; JLCPCB_PN C25741
R1220: 100R 1% 1/16W; R_0402_1005Metric; MPN 0402WGF1000TCE; JLCPCB_PN C25076
RN1201: 330R x4; R_Array_Convex_4x0402; MPN 4D02WGJ0331TCE; JLCPCB_PN C43557
U1201: TCA9517ADGKR; VSSOP-8_3x3mm_P0.65mm; MPN TCA9517ADGKR; JLCPCB_PN C201698

Connections:
+3V3_D: C1202.1, R1213.1, U1201.1 (VCCA); also elsewhere on the board
+3V3_EXP: C1203.1, J1201.3, J1201.4, J1201.37, J1201.38, R1205.1, R1210.1, R1211.1, R1212.1, R1215.1, R1216.1, U1201.5 (EN), U1201.8 (VCCB); also elsewhere on the board
/Expansion mezzanine/EXP_ANA_MON: D1204.5 (D2-), D1204.6 (NC), J1201.34, R1222.2
/Expansion mezzanine/EXP_ANA_MON_MCU: C1201.1, R1222.1; also elsewhere on the board
/Expansion mezzanine/EXP_CS0_N_MCU: R1208.1; also elsewhere on the board
/Expansion mezzanine/EXP_CS1_N_MCU: R1214.1; also elsewhere on the board
/Expansion mezzanine/EXP_DETECT_N: D1206.1 (D1+), D1206.10 (NC), J1201.32, R1213.2, RN1201.5 (R4.2)
/Expansion mezzanine/EXP_DETECT_N_MCU: RN1201.4 (R4.1); also elsewhere on the board
/Expansion mezzanine/EXP_GATE: D1203.1 (D1+), J1201.33, R1219.2
/Expansion mezzanine/EXP_GATE_MCU: R1219.1; also elsewhere on the board
/Expansion mezzanine/EXP_I2C_SCL: D1202.2 (D1-), J1201.25, R1212.2, U1201.7 (SCLB)
/Expansion mezzanine/EXP_I2C_SDA: D1202.4 (D2+), J1201.27, R1211.2, U1201.6 (SDAB)
/Expansion mezzanine/EXP_INT0_N: D1205.1 (D1+), D1205.10 (NC), J1201.14, R1209.2, R1210.2
/Expansion mezzanine/EXP_INT0_N_MCU: R1209.1; also elsewhere on the board
/Expansion mezzanine/EXP_INT1_N: D1206.5 (D2-), D1206.6 (NC), J1201.16, R1205.2, RN1201.8 (R1.2)
/Expansion mezzanine/EXP_INT1_N_MCU: RN1201.1 (R1.1); also elsewhere on the board
/Expansion mezzanine/EXP_IO0: D1206.4 (D2+), D1206.7 (NC), J1201.26, RN1201.7 (R2.2)
/Expansion mezzanine/EXP_IO0_MCU: RN1201.2 (R2.1); also elsewhere on the board
/Expansion mezzanine/EXP_IO1: D1206.2 (D1-), D1206.9 (NC), J1201.28, RN1201.6 (R3.2)
/Expansion mezzanine/EXP_IO1_MCU: RN1201.3 (R3.1); also elsewhere on the board
/Expansion mezzanine/EXP_MISO_MCU: R1206.1; also elsewhere on the board
/Expansion mezzanine/EXP_MOSI_MCU: R1203.1; also elsewhere on the board
/Expansion mezzanine/EXP_RST_N: D1202.5 (D2-), D1202.6 (NC), J1201.31, R1218.2, R1221.2
/Expansion mezzanine/EXP_RST_N_MCU: R1218.1; also elsewhere on the board
/Expansion mezzanine/EXP_SCK_MCU: R1201.1; also elsewhere on the board
/Expansion mezzanine/EXP_SPI_CS0_N: D1201.5 (D2-), D1201.6 (NC), J1201.13, R1208.2, R1216.2
/Expansion mezzanine/EXP_SPI_CS1_N: D1202.1 (D1+), D1202.10 (NC), J1201.15, R1214.2, R1215.2
/Expansion mezzanine/EXP_SPI_MISO: D1201.4 (D2+), D1201.7 (NC), J1201.9, R1206.2
/Expansion mezzanine/EXP_SPI_MOSI: D1201.2 (D1-), J1201.7, R1203.2
/Expansion mezzanine/EXP_SPI_SCK: D1201.1 (D1+), J1201.5, R1201.2
/Expansion mezzanine/EXP_SYNC: D1203.2 (D1-), D1203.9 (NC), J1201.35, R1217.2, R1220.2
/Expansion mezzanine/EXP_SYNC_MCU: R1220.1; also elsewhere on the board
/Expansion mezzanine/EXP_TMR0: D1205.5 (D2-), D1205.6 (NC), J1201.6, R1202.2
/Expansion mezzanine/EXP_TMR0_MCU: R1202.1; also elsewhere on the board
/Expansion mezzanine/EXP_TMR1: D1205.2 (D1-), D1205.9 (NC), J1201.10, R1207.2
/Expansion mezzanine/EXP_TMR1_MCU: R1207.1; also elsewhere on the board
/Expansion mezzanine/EXP_TMR_IN: D1205.4 (D2+), D1205.7 (NC), J1201.8, R1204.2
/Expansion mezzanine/EXP_TMR_IN_MCU: R1204.1; also elsewhere on the board
/I2C_SCL: U1201.2 (SCLA); also elsewhere on the board
/I2C_SDA: U1201.3 (SDAA); also elsewhere on the board
EXP_VHP: J1201.19, J1201.20, J1201.21, J1201.22; also elsewhere on the board
GND: C1201.2, C1202.2, C1203.2, D1201.3 (GND), D1201.8 (GND), D1202.3 (GND), D1202.8 (GND), D1203.3 (GND), D1203.8 (GND), D1204.3 (GND), D1204.8 (GND), D1205.3 (GND), D1205.8 (GND), D1206.3 (GND), D1206.8 (GND), H1201.1 (1_1), H1202.1 (1_1), J1201.1, J1201.2, J1201.11, J1201.12, J1201.17, J1201.18, J1201.23, J1201.24, J1201.29, J1201.30, J1201.39, J1201.40, J1201.SH (Shield), R1217.1, R1221.1, U1201.4 (GND); also elsewhere on the board

Notes on the sheet:
Bias resistors
I2C_SCL, I2C_SDA
Series R: MCU side (left) -> J1201 side (right)
EXP_SCK/MOSI/MISO_MCU, EXP_CS0/CS1_N_MCU, EXP_INT0/INT1_N_MCU, EXP_IO0/IO1_MCU, EXP_TMR0/TMR1/TMR_IN_MCU, EXP_GATE/SYNC/ANA_MON/RST_N/DETECT_N_MCU
SHEET INTERFACE: bus ports. Each member joins its label on this sheet by name.

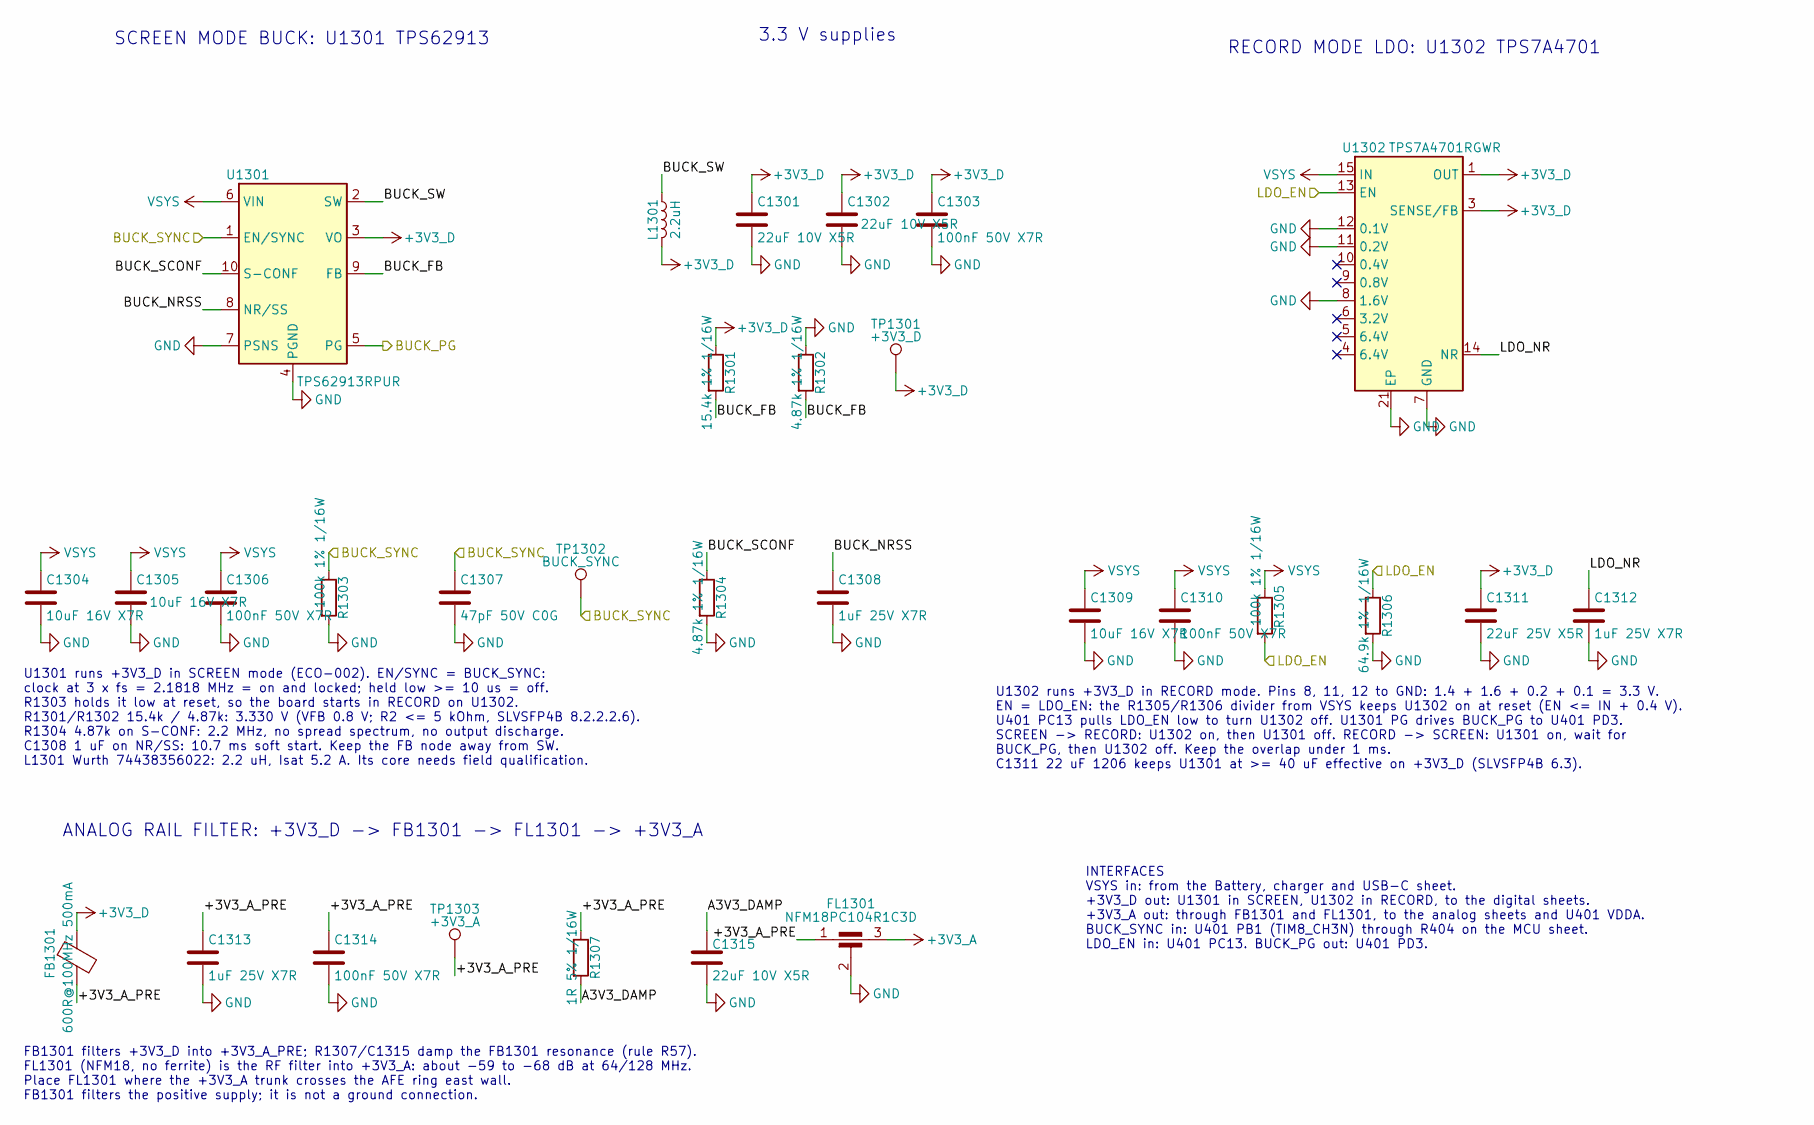
[picture p73: schematic Power_3V3.kicad_sch, 3.3 V supplies]

Parts:
C1301, C1302, C1315: 22uF 10V X5R; C_0805_2012Metric; MPN CL21A226MPQNNNE; JLCPCB_PN C29277
C1303, C1306, C1310, C1314: 100nF 50V X7R; C_0402_1005Metric; MPN CL05B104KB54PNC; JLCPCB_PN C307331
C1304, C1305, C1309: 10uF 16V X7R; C_0805_2012Metric; MPN CL21B106KOQNNNE; JLCPCB_PN C95841
C1307: 47pF 50V C0G; C_0402_1005Metric; MPN 0402CG470J500NT; JLCPCB_PN C1567
C1308, C1312, C1313: 1uF 25V X7R; C_0603_1608Metric; MPN CL10B105KA8NNNC; JLCPCB_PN C29936
C1311: 22uF 25V X5R; C_1206_3216Metric; MPN CL31A226KAHNNNE; JLCPCB_PN C12891
FB1301: 600R@100MHz 500mA; L_0603_1608Metric; MPN BLM18AG601SN1D; JLCPCB_PN C19330
FL1301: NFM18PC104R1C3D; Murata_NFM18PC_0603_3T; MPN NFM18PC104R1C3D; JLCPCB_PN C111493
L1301: 2.2uH; L_Wuerth_MAPI-4020; MPN 74438356022
R1301: 15.4k 1% 1/16W; R_0402_1005Metric; MPN 0402WGF1542TCE; JLCPCB_PN C62740
R1302, R1304: 4.87k 1% 1/16W; R_0402_1005Metric; MPN FRC0402F4871TS; JLCPCB_PN C5203997
R1303, R1305: 100k 1% 1/16W; R_0402_1005Metric; MPN 0402WGF1003TCE; JLCPCB_PN C25741
R1306: 64.9k 1% 1/16W; R_0402_1005Metric; MPN FRC0402F6492TS; JLCPCB_PN C5713275
R1307: 1R 5% 1/16W; R_0402_1005Metric; MPN FRC0402J1R0 TS; JLCPCB_PN C2906901
TP1301: +3V3_D; TestPoint_Pad_D1.0mm; MPN DNP-NO-COMPONENT; LCSC N/A
TP1302: BUCK_SYNC; TestPoint_Pad_D1.0mm; MPN PCB pad (no part)
TP1303: +3V3_A; TestPoint_Pad_D1.0mm; MPN DNP-NO-COMPONENT; LCSC N/A
U1301: TPS62913RPUR; Texas_RPU0010A_VQFN-HR-10_2x2mm_P0.5mm; MPN TPS62913RPUR; JLCPCB_PN C5189914
U1302: TPS7A4701RGWR; Texas_RGW0020A_VQFN-20-1EP_5x5mm_P0.65mm_EP3.15x3.15mm_Ther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; MPN TPS7A4701RGWR; JLCPCB_PN C90084

Connections:
+3V3_A: FL1301.3; also elsewhere on the board
+3V3_D: C1301.1, C1302.1, C1303.1, C1311.1, FB1301.1, L1301.2, R1301.1, TP1301.1 (1_1), U1301.3 (VO), U1302.1 (OUT), U1302.3 (SENSE/FB), U1302.20 (OUT); also elsewhere on the board
/3.3 V supplies/+3V3_A_PRE: C1313.1, C1314.1, FB1301.2, FL1301.1, R1307.1, TP1303.1 (1_1)
/3.3 V supplies/A3V3_DAMP: C1315.1, R1307.2
/3.3 V supplies/BUCK_FB: R1301.2, R1302.2, U1301.9 (FB)
/3.3 V supplies/BUCK_NRSS: C1308.1, U1301.8 (NR/SS)
/3.3 V supplies/BUCK_PG: U1301.5 (PG); also elsewhere on the board
/3.3 V supplies/BUCK_SCONF: R1304.1, U1301.10 (S-CONF)
/3.3 V supplies/BUCK_SW: L1301.1, U1301.2 (SW)
/3.3 V supplies/BUCK_SYNC: C1307.1, R1303.1, TP1302.1 (1_1), U1301.1 (EN/SYNC); also elsewhere on the board
/3.3 V supplies/LDO_EN: R1305.2, R1306.1, U1302.13 (EN); also elsewhere on the board
/3.3 V supplies/LDO_NR: C1312.1, U1302.14 (NR)
GND: C1301.2, C1302.2, C1303.2, C1304.2, C1305.2, C1306.2, C1307.2, C1308.2, C1309.2, C1310.2, C1311.2, C1312.2, C1313.2, C1314.2, C1315.2, FL1301.2, R1302.1, R1303.2, R1304.2, R1306.2, U1301.4 (PGND), U1301.7 (PSNS), U1302.7 (GND), U1302.8 (1.6V), U1302.11 (0.2V), U1302.12 (0.1V), U1302.21 (EP); also elsewhere on the board
VSYS: C1304.1, C1305.1, C1306.1, C1309.1, C1310.1, R1305.1, U1301.6 (VIN), U1302.15 (IN), U1302.16 (IN); also elsewhere on the board

Notes on the sheet:
U1302 runs +3V3_D in RECORD mode. Pins 8, 11, 12 to GND: 1.4 + 1.6 + 0.2 + 0.1 = 3.3 V. EN = LDO_EN: the R1305/R1306 divider from VSYS keeps U1302 on at reset (EN <= IN + 0.4 V). U401 PC13 pulls LDO_EN low to turn U1302 off. U1301 PG drives BUCK_PG to U401 PD3. SCREEN -> RECORD: U1302 on, then U130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
ANALOG RAIL FILTER: +3V3_D -> FB1301 -> FL1301 -> +3V3_A
SCREEN MODE BUCK: U1301 TPS62913
RECORD MODE LDO: U1302 TPS7A4701
U1301 runs +3V3_D in SCREEN mode (ECO-002). EN/SYNC = BUCK_SYNC: clock at 3 x fs = 2.1818 MHz = on and locked; held low >= 10 us = off. R1303 holds it low at reset, so the board starts in RECORD on U1302. R1301/R1302 15.4k / 4.87k: 3.330 V (VFB 0.8 V; R2 <= 5 kOhm, SLVSFP4B 8.2.2.2.6). R1304 4.87k 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
INTERFACES VSYS in: from the Battery, charger and USB-C sheet. +3V3_D out: U1301 in SCREEN, U1302 in RECORD, to the digital sheets. +3V3_A out: through FB1301 and FL1301, to the analog sheets and U401 VDDA. BUCK_SYNC in: U401 PB1 (TIM8_CH3N) through R404 on the MCU sheet. LDO_EN in: U401 PC13. BUCK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
FB1301 filters +3V3_D into +3V3_A_PRE; R1307/C1315 damp the FB1301 resonance (rule R57). FL1301 (NFM18, no ferrite) is the RF filter into +3V3_A: about -59 to -68 dB at 64/128 MHz. Place FL1301 where the +3V3_A trunk crosses the AFE ring east wall. FB1301 filters the positive supply; it is not a gr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
3.3 V supplies

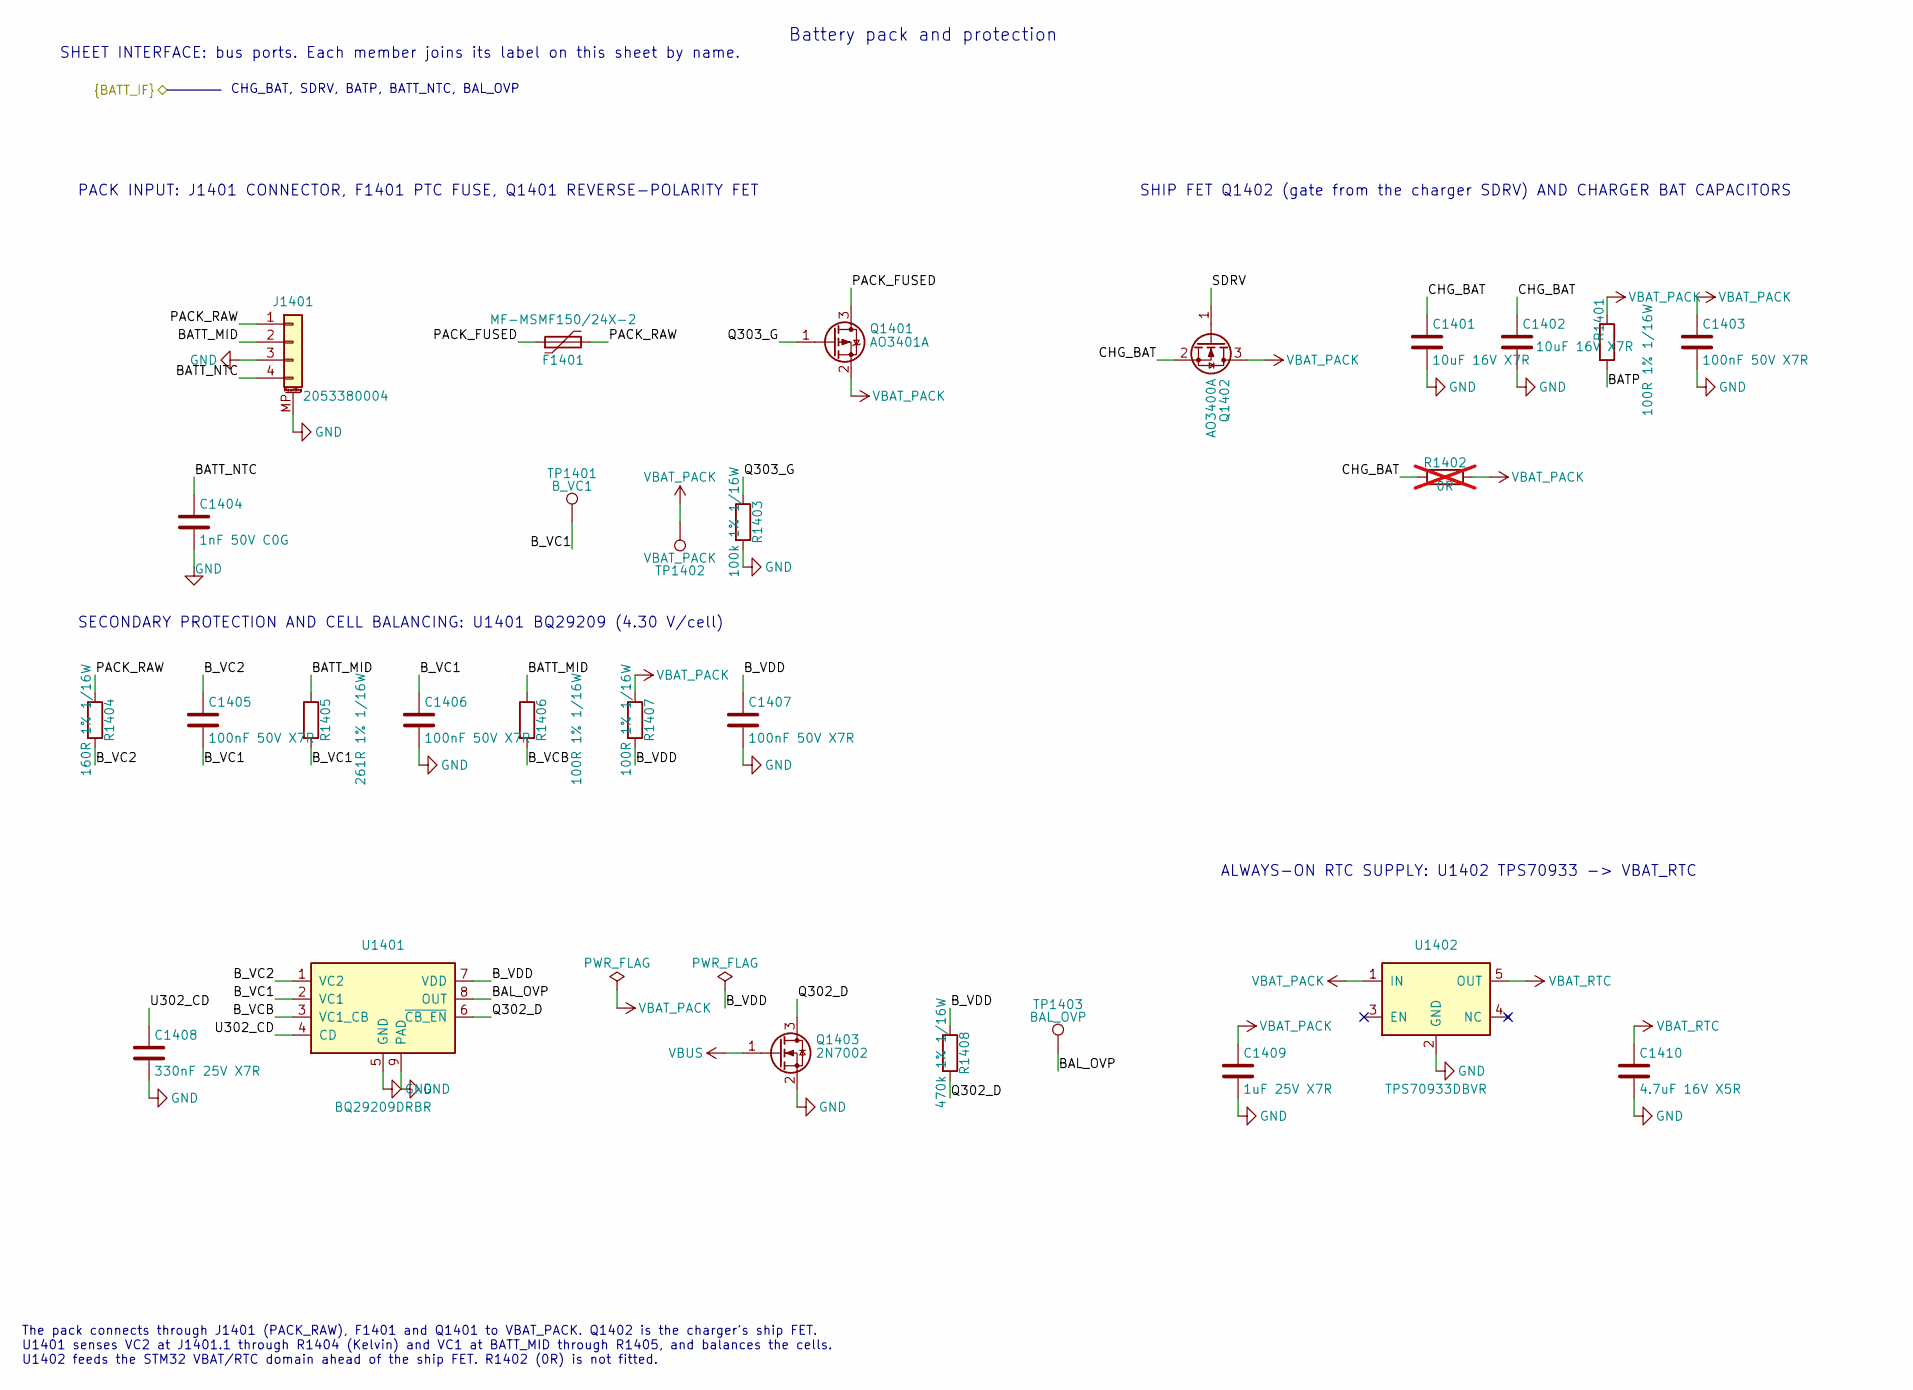
[picture p74: schematic Power_Batt.kicad_sch, Battery pack and protection]

Parts:
C1401, C1402: 10uF 16V X7R; C_0805_2012Metric; MPN CL21B106KOQNNNE; JLCPCB_PN C95841
C1403, C1405, C1406, C1407: 100nF 50V X7R; C_0402_1005Metric; MPN CL05B104KB54PNC; JLCPCB_PN C307331
C1404: 1nF 50V C0G; C_0402_1005Metric; MPN GRM1555C1H102JA01D; JLCPCB_PN C76947
C1408: 330nF 25V X7R; C_0603_1608Metric; MPN CC0603KRX7R8BB334; JLCPCB_PN C107070
C1409: 1uF 25V X7R; C_0603_1608Metric; MPN CL10B105KA8NNNC; JLCPCB_PN C29936
C1410: 4.7uF 16V X5R; C_0603_1608Metric; MPN CL10A475KO8NNNC; JLCPCB_PN C19666
F1401: MF-MSMF150/24X-2; Fuse_Bourns_MF-MSMF_Style2_4532Metric; MPN MF-MSMF150/24X-2; JLCPCB_PN C78695
J1401: 2053380004; Molex_Pico-Lock_205338-0004_1x04-1MP_P2.00mm_Horizontal; MPN 2053380004; JLCPCB_PN C916325
Q1401: AO3401A; SOT-23; MPN AO3401A; JLCPCB_PN C15127
Q1402: AO3400A; SOT-23; MPN AO3400A; JLCPCB_PN C20917
Q1403: 2N7002; SOT-23; MPN 2N7002; JLCPCB_PN C8545
R1401, R1406, R1407: 100R 1% 1/16W; R_0402_1005Metric; MPN 0402WGF1000TCE; JLCPCB_PN C25076
R1402: 0R; R_0805_2012Metric; not fitted
R1403: 100k 1% 1/16W; R_0402_1005Metric; MPN 0402WGF1003TCE; JLCPCB_PN C25741
R1404: 160R 1% 1/16W; R_0402_1005Metric; MPN RC0402FR-07160RL; JLCPCB_PN C327369
R1405: 261R 1% 1/16W; R_0402_1005Metric; MPN RC0402FR-07261RL; JLCPCB_PN C273335
R1408: 470k 1% 1/16W; R_0402_1005Metric; MPN RC0402FR-07470KL; JLCPCB_PN C137976
TP1401: B_VC1; TestPoint_Pad_D1.0mm; MPN PCB pad (no part)
TP1402: VBAT_PACK; TestPoint_Pad_D1.0mm; MPN PCB pad (no part)
TP1403: BAL_OVP; TestPoint_Pad_D1.0mm; MPN PCB pad (no part)
U1401: BQ29209DRBR; VSON-8-1EP_3x3mm_P0.65mm_EP1.65x2.4mm; MPN BQ29209DRBR; JLCPCB_PN C139352
U1402: TPS70933DBVR; SOT-23-5; MPN TPS70933DBVR; JLCPCB_PN C89347

Connections:
/Battery pack and protection/BAL_OVP: TP1403.1 (1_1), U1401.8 (OUT); also elsewhere on the board
/Battery pack and protection/BATP: R1401.2; also elsewhere on the board
/Battery pack and protection/BATT_MID: J1401.2, R1405.1, R1406.1
/Battery pack and protection/BATT_NTC: C1404.1, J1401.4; also elsewhere on the board
/Battery pack and protection/B_VC1: C1405.2, C1406.1, R1405.2, TP1401.1 (1_1), U1401.2 (VC1)
/Battery pack and protection/B_VC2: C1405.1, R1404.2, U1401.1 (VC2)
/Battery pack and protection/B_VCB: R1406.2, U1401.3 (VC1_CB)
/Battery pack and protection/B_VDD: C1407.1, R1407.2, R1408.1, U1401.7 (VDD)
/Battery pack and protection/CHG_BAT: C1401.1, C1402.1, Q1402.2 (S), R1402.1; also elsewhere on the board
/Battery pack and protection/PACK_FUSED: F1401.1, Q1401.3 (D)
/Battery pack and protection/PACK_RAW: F1401.2, J1401.1, R1404.1
/Battery pack and protection/Q302_D: Q1403.3 (D), R1408.2, U1401.6 (~CB_EN)
/Battery pack and protection/Q303_G: Q1401.1 (G), R1403.1
/Battery pack and protection/SDRV: Q1402.1 (G); also elsewhere on the board
/Battery pack and protection/U302_CD: C1408.1, U1401.4 (CD)
GND: C1401.2, C1402.2, C1403.2, C1404.2, C1406.2, C1407.2, C1408.2, C1409.2, C1410.2, J1401.3, J1401.MP (MountPin), Q1403.2 (S), R1403.2, U1401.5 (GND), U1401.9 (PAD), U1402.2 (GND); also elsewhere on the board
VBAT_PACK: C1403.1, C1409.1, Q1401.2 (S), Q1402.3 (D), R1401.1, R1402.2, R1407.1, TP1402.1 (1_1), U1402.1 (IN)
VBAT_RTC: C1410.1, U1402.5 (OUT); also elsewhere on the board
VBUS: Q1403.1 (G); also elsewhere on the board

Notes on the sheet:
CHG_BAT, SDRV, BATP, BATT_NTC, BAL_OVP
SHEET INTERFACE: bus ports. Each member joins its label on this sheet by name.
The pack connects through J1401 (PACK_RAW), F1401 and Q1401 to VBAT_PACK. Q1402 is the charger's ship FET. U1401 senses VC2 at J1401.1 through R1404 (Kelvin) and VC1 at BATT_MID through R1405, and balances the cells. U1402 feeds the STM32 VBAT/RTC domain ahead of the ship FET. R1402 (0R) is not fit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
ALWAYS-ON RTC SUPPLY: U1402 TPS70933 -> VBAT_RTC
SECONDARY PROTECTION AND CELL BALANCING: U1401 BQ29209 (4.30 V/cell)
SHIP FET Q1402 (gate from the charger SDRV) AND CHARGER BAT CAPACITORS
PACK INPUT: J1401 CONNECTOR, F1401 PTC FUSE, Q1401 REVERSE-POLARITY FET
Battery pack and protection
