Able-Digital-Logic/UnintendedAntennaClub3/Hardware/RFVD_SENSOR_BOARD_Rev6/RFVD_SENSOR_BOARD.kicad_pcb

## KiCad design Hardware/RFVD_SENSOR_BOARD_Rev6/RFVD_SENSOR_BOARD.kicad_pcb (continued)

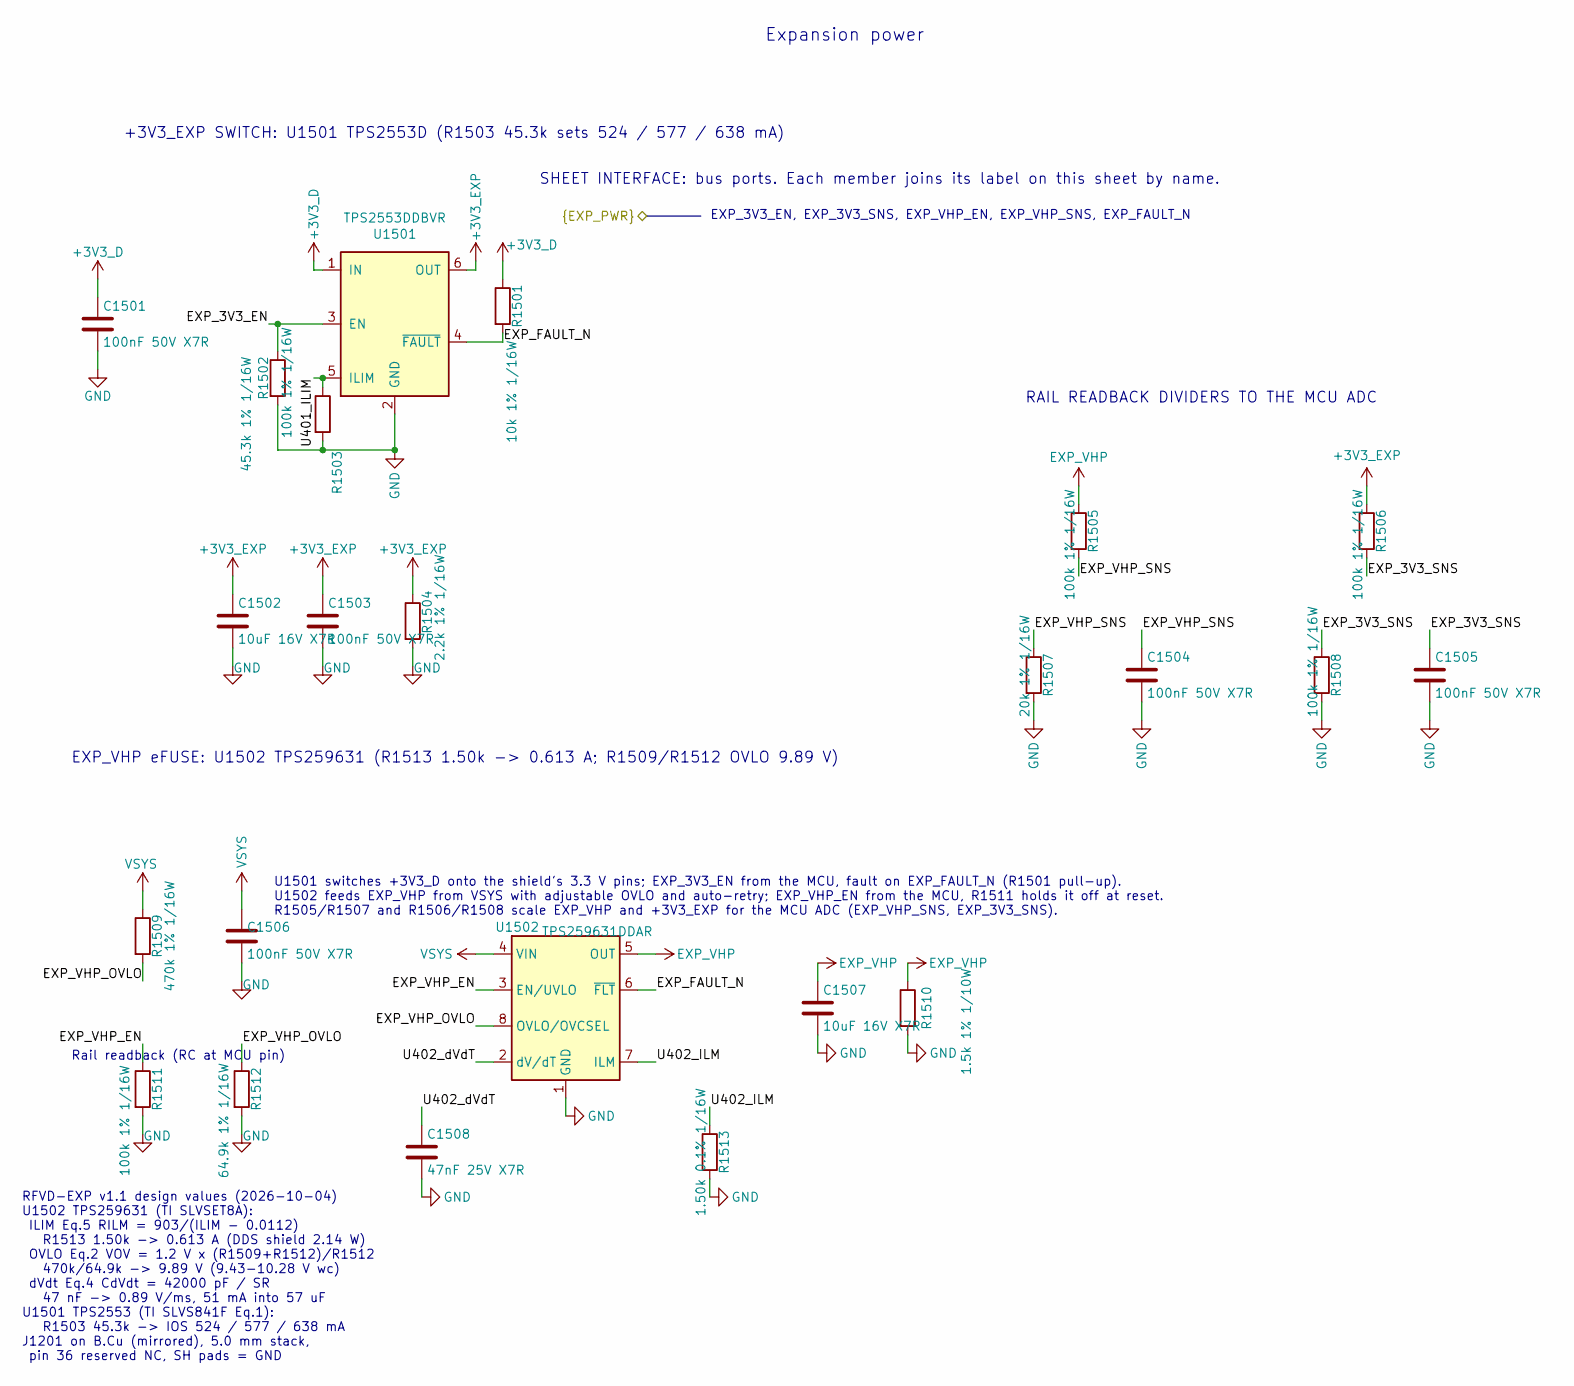
[picture p75: schematic Expansion_Power.kicad_sch, Expansion power]

Parts:
C1501, C1503, C1504, C1505, C1506: 100nF 50V X7R; C_0402_1005Metric; MPN CL05B104KB54PNC; JLCPCB_PN C307331
C1502, C1507: 10uF 16V X7R; C_0805_2012Metric; MPN CL21B106KOQNNNE; JLCPCB_PN C95841
C1508: 47nF 25V X7R; C_0402_1005Metric; MPN GRM155R71E473KA88D; JLCPCB_PN C77017
R1501: 10k 1% 1/16W; R_0402_1005Metric; MPN 0402WGF1002TCE; JLCPCB_PN C25744
R1502, R1505, R1506, R1508, R1511: 100k 1% 1/16W; R_0402_1005Metric; MPN 0402WGF1003TCE; JLCPCB_PN C25741
R1503: 45.3k 1% 1/16W; R_0402_1005Metric; MPN FRC0402F4532TS; JLCPCB_PN C2933099
R1504: 2.2k 1% 1/16W; R_0402_1005Metric; MPN 0402WGF2201TCE; JLCPCB_PN C25879
R1507: 20k 1% 1/16W; R_0402_1005Metric; MPN 0402WGF2002TCE; JLCPCB_PN C25765
R1509: 470k 1% 1/16W; R_0402_1005Metric; MPN RC0402FR-07470KL; JLCPCB_PN C137976
R1510: 1.5k 1% 1/10W; R_0603_1608Metric; MPN 0603WAF1501T5E; JLCPCB_PN C22843
R1512: 64.9k 1% 1/16W; R_0402_1005Metric; MPN FRC0402F6492TS; JLCPCB_PN C5713275
R1513: 1.50k 0.1% 1/16W; R_0402_1005Metric; MPN RT0402BRD071K5L; JLCPCB_PN C281775
U1501: TPS2553DDBVR; SOT-23-6; MPN TPS2553DDBVR; JLCPCB_PN C521201
U1502: TPS259631DDAR; TI_SO-PowerPAD-8_ThermalVias; MPN TPS259631DDAR; JLCPCB_PN C2155778

Connections:
+3V3_D: C1501.1, R1501.1, U1501.1 (IN); also elsewhere on the board
+3V3_EXP: C1502.1, C1503.1, R1504.1, R1506.1, U1501.6 (OUT); also elsewhere on the board
/Expansion power/EXP_3V3_EN: R1502.1, U1501.3 (EN); also elsewhere on the board
/Expansion power/EXP_3V3_SNS: C1505.1, R1506.2, R1508.1; also elsewhere on the board
/Expansion power/EXP_FAULT_N: R1501.2, U1501.4 (~FAULT), U1502.6 (~FLT); also elsewhere on the board
/Expansion power/EXP_VHP_EN: R1511.1, U1502.3 (EN/UVLO); also elsewhere on the board
/Expansion power/EXP_VHP_OVLO: R1509.2, R1512.1, U1502.8 (OVLO/OVCSEL)
/Expansion power/EXP_VHP_SNS: C1504.1, R1505.2, R1507.1; also elsewhere on the board
/Expansion power/U401_ILIM: R1503.1, U1501.5 (ILIM)
/Expansion power/U402_ILM: R1513.1, U1502.7 (ILM)
/Expansion power/U402_dVdT: C1508.1, U1502.2 (dV/dT)
EXP_VHP: C1507.1, R1505.1, R1510.1, U1502.5 (OUT); also elsewhere on the board
GND: C1501.2, C1502.2, C1503.2, C1504.2, C1505.2, C1506.2, C1507.2, C1508.2, R1502.2, R1503.2, R1504.2, R1507.2, R1508.2, R1510.2, R1511.2, R1512.2, R1513.2, U1501.2 (GND), U1502.1 (GND), U1502.9 (GND); also elsewhere on the board
VSYS: C1506.1, R1509.1, U1502.4 (VIN); also elsewhere on the board

Notes on the sheet:
RFVD-EXP v1.1 design values (2026-10-04) U1502 TPS259631 (TI SLVSET8A): ILIM Eq.5 RILM = 903/(ILIM - 0.0112) R1513 1.50k -> 0.613 A (DDS shield 2.14 W) OVLO Eq.2 VOV = 1.2 V x (R1509+R1512)/R1512 470k/64.9k -> 9.89 V (9.43-10.28 V wc) dVdt Eq.4 CdVdt = 42000 pF / SR 47 nF -> 0.89 V/ms, 51 mA into 5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
U1501 switches +3V3_D onto the shield's 3.3 V pins; EXP_3V3_EN from the MCU, fault on EXP_FAULT_N (R1501 pull-up). U1502 feeds EXP_VHP from VSYS with adjustable OVLO and auto-retry; EXP_VHP_EN from the MCU, R1511 holds it off at reset. R1505/R1507 and R1506/R1508 scale EXP_VHP and +3V3_EXP for the 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
+3V3_EXP SWITCH: U1501 TPS2553D (R1503 45.3k sets 524 / 577 / 638 mA)
RAIL READBACK DIVIDERS TO THE MCU ADC
Rail readback (RC at MCU pin)
Expansion power
EXP_3V3_EN, EXP_3V3_SNS, EXP_VHP_EN, EXP_VHP_SNS, EXP_FAULT_N
SHEET INTERFACE: bus ports. Each member joins its label on this sheet by name.
EXP_VHP eFUSE: U1502 TPS259631 (R1513 1.50k -> 0.613 A; R1509/R1512 OVLO 9.89 V)

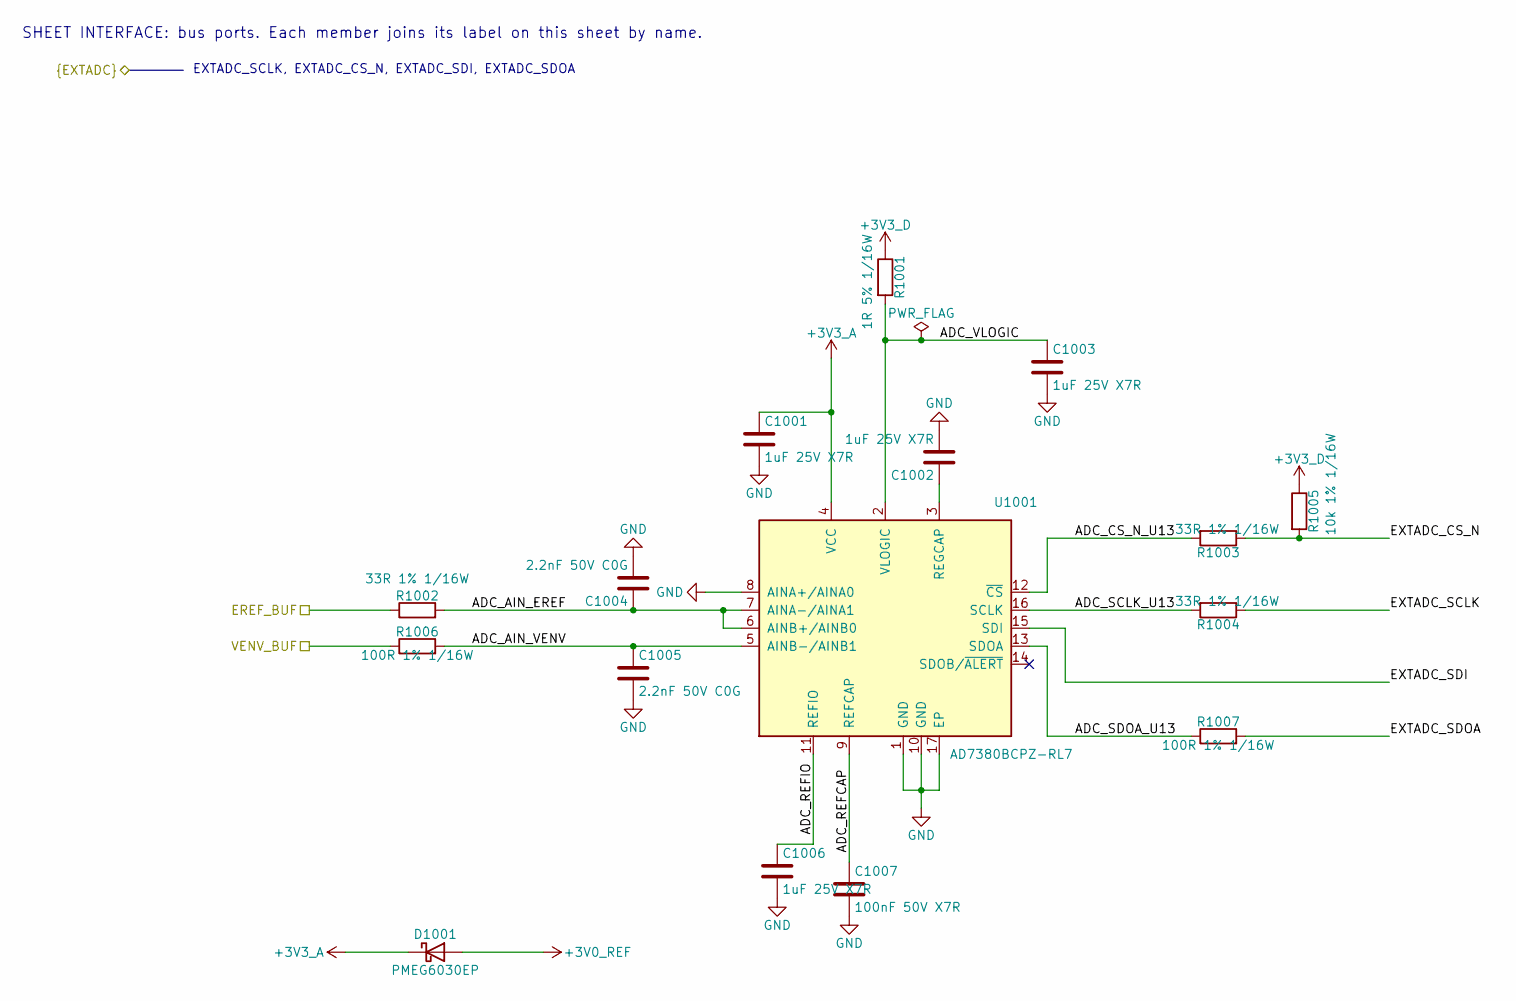
[picture p76: schematic External_ADC.kicad_sch, External ADC]

Parts:
C1001, C1002, C1003, C1006: 1uF 25V X7R; C_0603_1608Metric; MPN CL10B105KA8NNNC; JLCPCB_PN C29936
C1004, C1005: 2.2nF 50V C0G; C_0402_1005Metric; MPN GRM1555C1H222JA01D; JLCPCB_PN C385029
C1007: 100nF 50V X7R; C_0402_1005Metric; MPN CL05B104KB54PNC; JLCPCB_PN C307331
D1001: PMEG6030EP; D_SOD-128; MPN PMEG6030EP,115; JLCPCB_PN C456127
R1001: 1R 5% 1/16W; R_0402_1005Metric; MPN FRC0402J1R0 TS; JLCPCB_PN C2906901
R1002, R1003, R1004: 33R 1% 1/16W; R_0402_1005Metric; MPN 0402WGF330JTCE; JLCPCB_PN C25105
R1005: 10k 1% 1/16W; R_0402_1005Metric; MPN 0402WGF1002TCE; JLCPCB_PN C25744
R1006, R1007: 100R 1% 1/16W; R_0402_1005Metric; MPN 0402WGF1000TCE; JLCPCB_PN C25076
U1001: AD7380BCPZ-RL7; TQFN-16-1EP_3x3mm_P0.5mm_EP1.23x1.23mm; MPN AD7380BCPZ-RL7; JLCPCB_PN C578426

Connections:
+3V0_REF: D1001.2 (A); also elsewhere on the board
+3V3_A: C1001.1, D1001.1 (K), U1001.4 (VCC); also elsewhere on the board
+3V3_D: R1001.1, R1005.1; also elsewhere on the board
/Analog acquisition/EREF_BUF: R1002.1; also elsewhere on the board
/Analog acquisition/VENV_BUF: R1006.1; also elsewhere on the board
/External ADC/ADC_AIN_EREF: C1004.1, R1002.2, U1001.6 (AINB+/AINB0), U1001.7 (AINA-/AINA1)
/External ADC/ADC_AIN_VENV: C1005.1, R1006.2, U1001.5 (AINB-/AINB1)
/External ADC/ADC_CS_N_U13: R1003.2, U1001.12 (~CS)
/External ADC/ADC_REFCAP: C1007.1, U1001.9 (REFCAP)
/External ADC/ADC_REFIO: C1006.1, U1001.11 (REFIO)
/External ADC/ADC_SCLK_U13: R1004.2, U1001.16 (SCLK)
/External ADC/ADC_SDOA_U13: R1007.1, U1001.13 (SDOA)
/External ADC/ADC_VLOGIC: C1003.1, R1001.2, U1001.2 (VLOGIC)
/External ADC/EXTADC_CS_N: R1003.1, R1005.2; also elsewhere on the board
/External ADC/EXTADC_SCLK: R1004.1; also elsewhere on the board
/External ADC/EXTADC_SDI: U1001.15 (SDI); also elsewhere on the board
/External ADC/EXTADC_SDOA: R1007.2; also elsewhere on the board
GND: C1001.2, C1002.2, C1003.2, C1004.2, C1005.2, C1006.2, C1007.2, U1001.1 (GND), U1001.8 (AINA+/AINA0), U1001.10 (GND), U1001.17 (EP); also elsewhere on the board
unnamed: C1002.1, U1001.3 (REGCAP)

Notes on the sheet:
SHEET INTERFACE: bus ports. Each member joins its label on this sheet by name.
EXTADC_SCLK, EXTADC_CS_N, EXTADC_SDI, EXTADC_SDOA

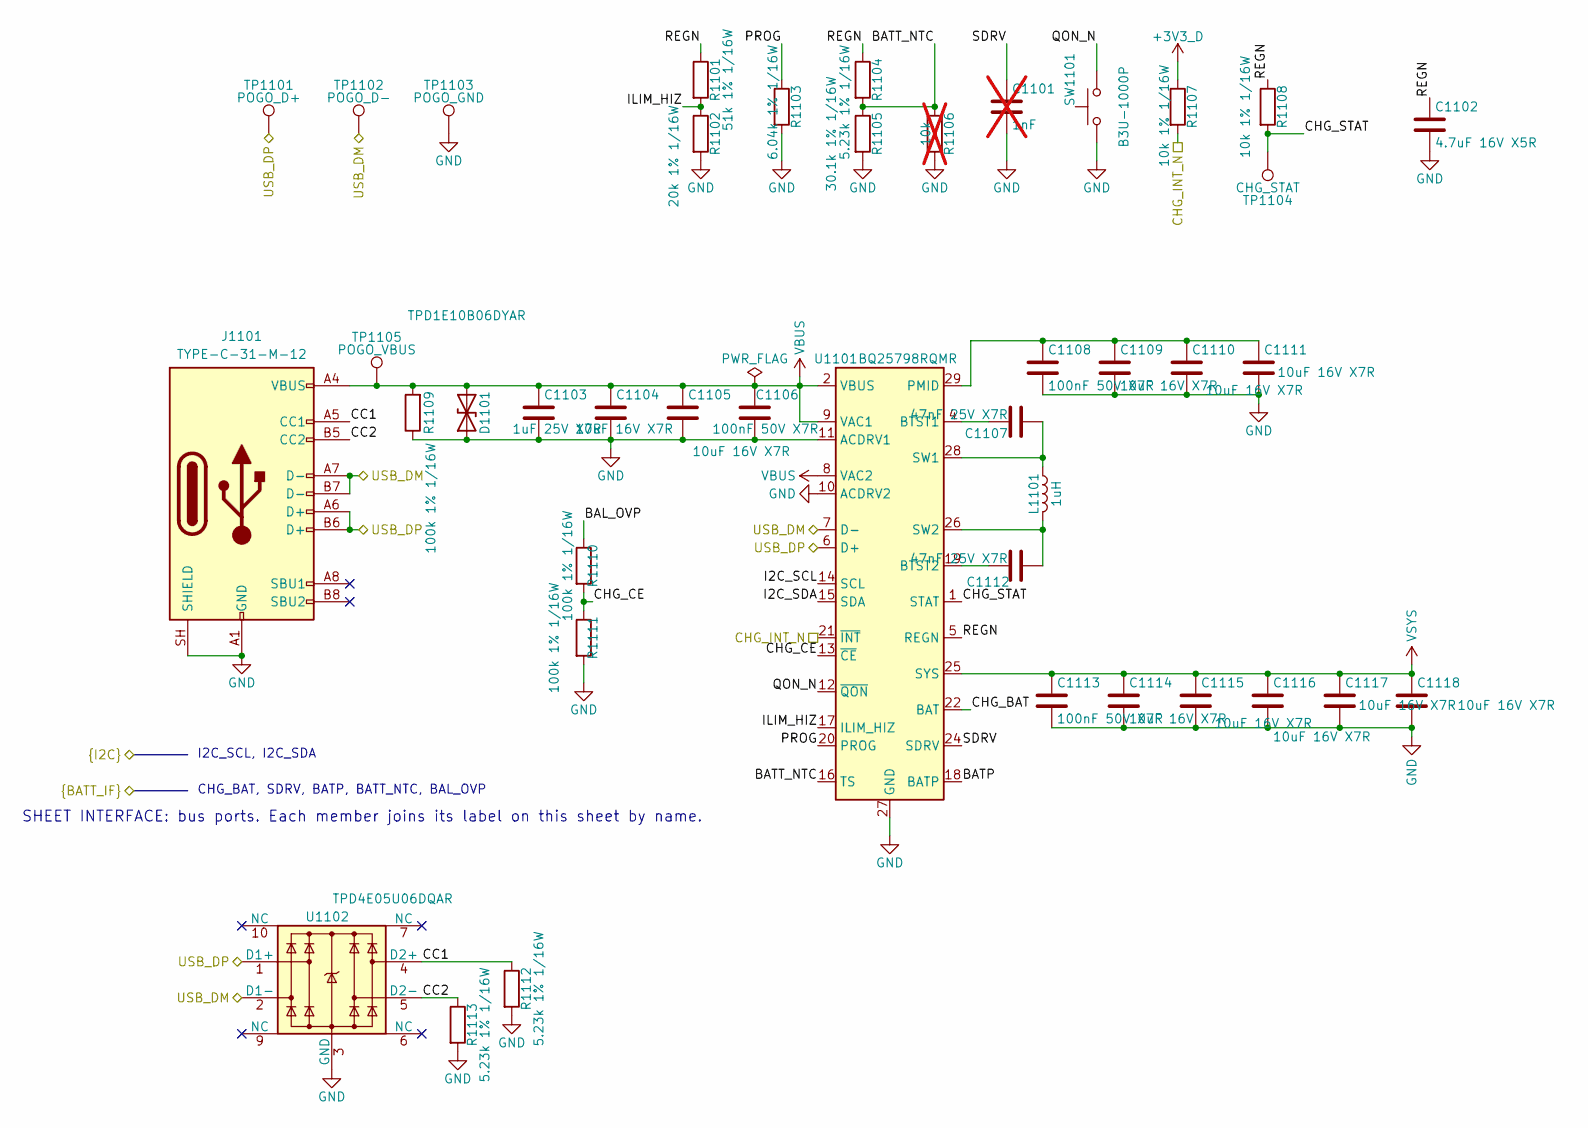
[picture p77: schematic Power_USB.kicad_sch, Battery, charger and USB-C]

Parts:
C1101: 1nF; C_0402_1005Metric; not fitted
C1102: 4.7uF 16V X5R; C_0603_1608Metric; MPN CL10A475KO8NNNC; JLCPCB_PN C19666
C1103: 1uF 25V X7R; C_0603_1608Metric; MPN CL10B105KA8NNNC; JLCPCB_PN C29936
C1104, C1105, C1109, C1110, C1111, C1114, C1115, C1116, C1117, C1118: 10uF 16V X7R; C_0805_2012Metric; MPN CL21B106KOQNNNE; JLCPCB_PN C95841
C1106, C1108, C1113: 100nF 50V X7R; C_0402_1005Metric; MPN CL05B104KB54PNC; JLCPCB_PN C307331
C1107, C1112: 47nF 25V X7R; C_0402_1005Metric; MPN GRM155R71E473KA88D; JLCPCB_PN C77017
D1101: TPD1E10B06DYAR; D_SOD-523; MPN TPD1E10B06DYAR; JLCPCB_PN C3712135
J1101: TYPE-C-31-M-12; USB_C_Receptacle_HRO_TYPE-C-31-M-12; MPN TYPE-C-31-M-12; JLCPCB_PN C165948
L1101: 1uH; L_Coilcraft_XAL4020-XXX; MPN XAL4020-102MEC; JLCPCB_PN C4555951
R1101: 51k 1% 1/16W; R_0402_1005Metric; MPN 0402WGF5102TCE; JLCPCB_PN C25794
R1102: 20k 1% 1/16W; R_0402_1005Metric; MPN 0402WGF2002TCE; JLCPCB_PN C25765
R1103: 6.04k 1% 1/16W; R_0402_1005Metric; MPN RC0402FR-076K04L; JLCPCB_PN C97819
R1104, R1112, R1113: 5.23k 1% 1/16W; R_0402_1005Metric; MPN 0402WGF5231TCE; JLCPCB_PN C25907
R1105: 30.1k 1% 1/16W; R_0402_1005Metric; MPN RC0402FR-0730K1L; JLCPCB_PN C138009
R1106: 10k; R_0402_1005Metric; not fitted
R1107, R1108: 10k 1% 1/16W; R_0402_1005Metric; MPN 0402WGF1002TCE; JLCPCB_PN C25744
R1109, R1110, R1111: 100k 1% 1/16W; R_0402_1005Metric; MPN 0402WGF1003TCE; JLCPCB_PN C25741
SW1101: B3U-1000P; SW_SPST_B3U-1000P; MPN B3U-1000P; JLCPCB_PN C231329
TP1101: POGO_D+; TestPoint_Pad_D2.0mm; MPN PCB pad (no part)
TP1102: POGO_D-; TestPoint_Pad_D2.0mm; MPN PCB pad (no part)
TP1103: POGO_GND; TestPoint_Pad_D2.0mm; MPN PCB pad (no part)
TP1104: CHG_STAT; TestPoint_Pad_D1.0mm; MPN PCB pad (no part)
TP1105: POGO_VBUS; TestPoint_Pad_D2.0mm; MPN PCB pad (no part)
U1101: BQ25798RQMR; Texas_RQM0029A_VQFN-29_4x4mm_P0.4mm; MPN BQ25798RQMR; JLCPCB_PN C2876593
U1102: TPD4E05U06DQAR; USON-10_2.5x1.0mm_P0.5mm; MPN TPD4E05U06DQAR; JLCPCB_PN C138714

Connections:
+3V3_D: R1107.1; also elsewhere on the board
/Battery pack and protection/BAL_OVP: R1110.1; also elsewhere on the board
/Battery pack and protection/BATP: U1101.18 (BATP); also elsewhere on the board
/Battery pack and protection/BATT_NTC: R1104.2, R1105.1, R1106.1, U1101.16 (TS); also elsewhere on the board
/Battery pack and protection/CHG_BAT: U1101.22 (BAT), U1101.23 (BAT); also elsewhere on the board
/Battery pack and protection/SDRV: C1101.1, U1101.24 (SDRV); also elsewhere on the board
/Battery, charger and USB-C/CC1: J1101.A5 (CC1), R1112.1, U1102.4 (D2+)
/Battery, charger and USB-C/CC2: J1101.B5 (CC2), R1113.1, U1102.5 (D2-)
/Battery, charger and USB-C/CHG_CE: R1110.2, R1111.1, U1101.13 (~CE)
/Battery, charger and USB-C/CHG_INT_N: R1107.2, U1101.21 (~INT); also elsewhere on the board
/Battery, charger and USB-C/CHG_STAT: R1108.2, TP1104.1 (1_1), U1101.1 (STAT)
/Battery, charger and USB-C/ILIM_HIZ: R1101.2, R1102.1, U1101.17 (ILIM_HIZ)
/Battery, charger and USB-C/PROG: R1103.1, U1101.20 (PROG)
/Battery, charger and USB-C/QON_N: SW1101.2, U1101.12 (~QON)
/Battery, charger and USB-C/REGN: C1102.1, R1101.1, R1104.1, R1108.1, U1101.5 (REGN)
/Battery, charger and USB-C/USB_DM: J1101.A7 (D-), J1101.B7 (D-), TP1102.1 (1_1), U1101.7 (D-), U1102.2 (D1-); also elsewhere on the board
/Battery, charger and USB-C/USB_DP: J1101.A6 (D+), J1101.B6 (D+), TP1101.1 (1_1), U1101.6 (D+), U1102.1 (D1+); also elsewhere on the board
/I2C_SCL: U1101.14 (SCL); also elsewhere on the board
/I2C_SDA: U1101.15 (SDA); also elsewhere on the board
GND: C1101.2, C1102.2, C1103.2, C1104.2, C1105.2, C1106.2, C1108.2, C1109.2, C1110.2, C1111.2, C1113.2, C1114.2, C1115.2, C1116.2, C1117.2, C1118.2, D1101.1 (A1), J1101.A1 (GND), J1101.A12 (GND), J1101.B1 (GND), J1101.B12 (GND), J1101.SH (SHIELD), R1102.2, R1103.2, R1105.2, R1106.2, R1109.1, R1111.2, R1112.2, R1113.2, SW1101.1, TP1103.1 (1_1), U1101.10 (ACDRV2), U1101.11 (ACDRV1), U1101.27 (GND), U1102.3 (GND), U1102.8 (GND); also elsewhere on the board
unnamed: C1107.1, U1101.4 (BTST1)
unnamed: C1112.1, U1101.19 (BTST2)
unnamed: C1108.1, C1109.1, C1110.1, C1111.1, U1101.29 (PMID)
unnamed: C1107.2, L1101.1, U1101.28 (SW1)
unnamed: C1112.2, L1101.2, U1101.26 (SW2)
VBUS: C1103.1, C1104.1, C1105.1, C1106.1, D1101.2 (A2), J1101.A4 (VBUS), J1101.A9 (VBUS), J1101.B4 (VBUS), J1101.B9 (VBUS), R1109.2, TP1105.1 (1_1), U1101.2 (VBUS), U1101.3 (VBUS), U1101.8 (VAC2), U1101.9 (VAC1); also elsewhere on the board
VSYS: C1113.1, C1114.1, C1115.1, C1116.1, C1117.1, C1118.1, U1101.25 (SYS); also elsewhere on the board

Notes on the sheet:
I2C_SCL, I2C_SDA
SHEET INTERFACE: bus ports. Each member joins its label on this sheet by name.
CHG_BAT, SDRV, BATP, BATT_NTC, BAL_OVP

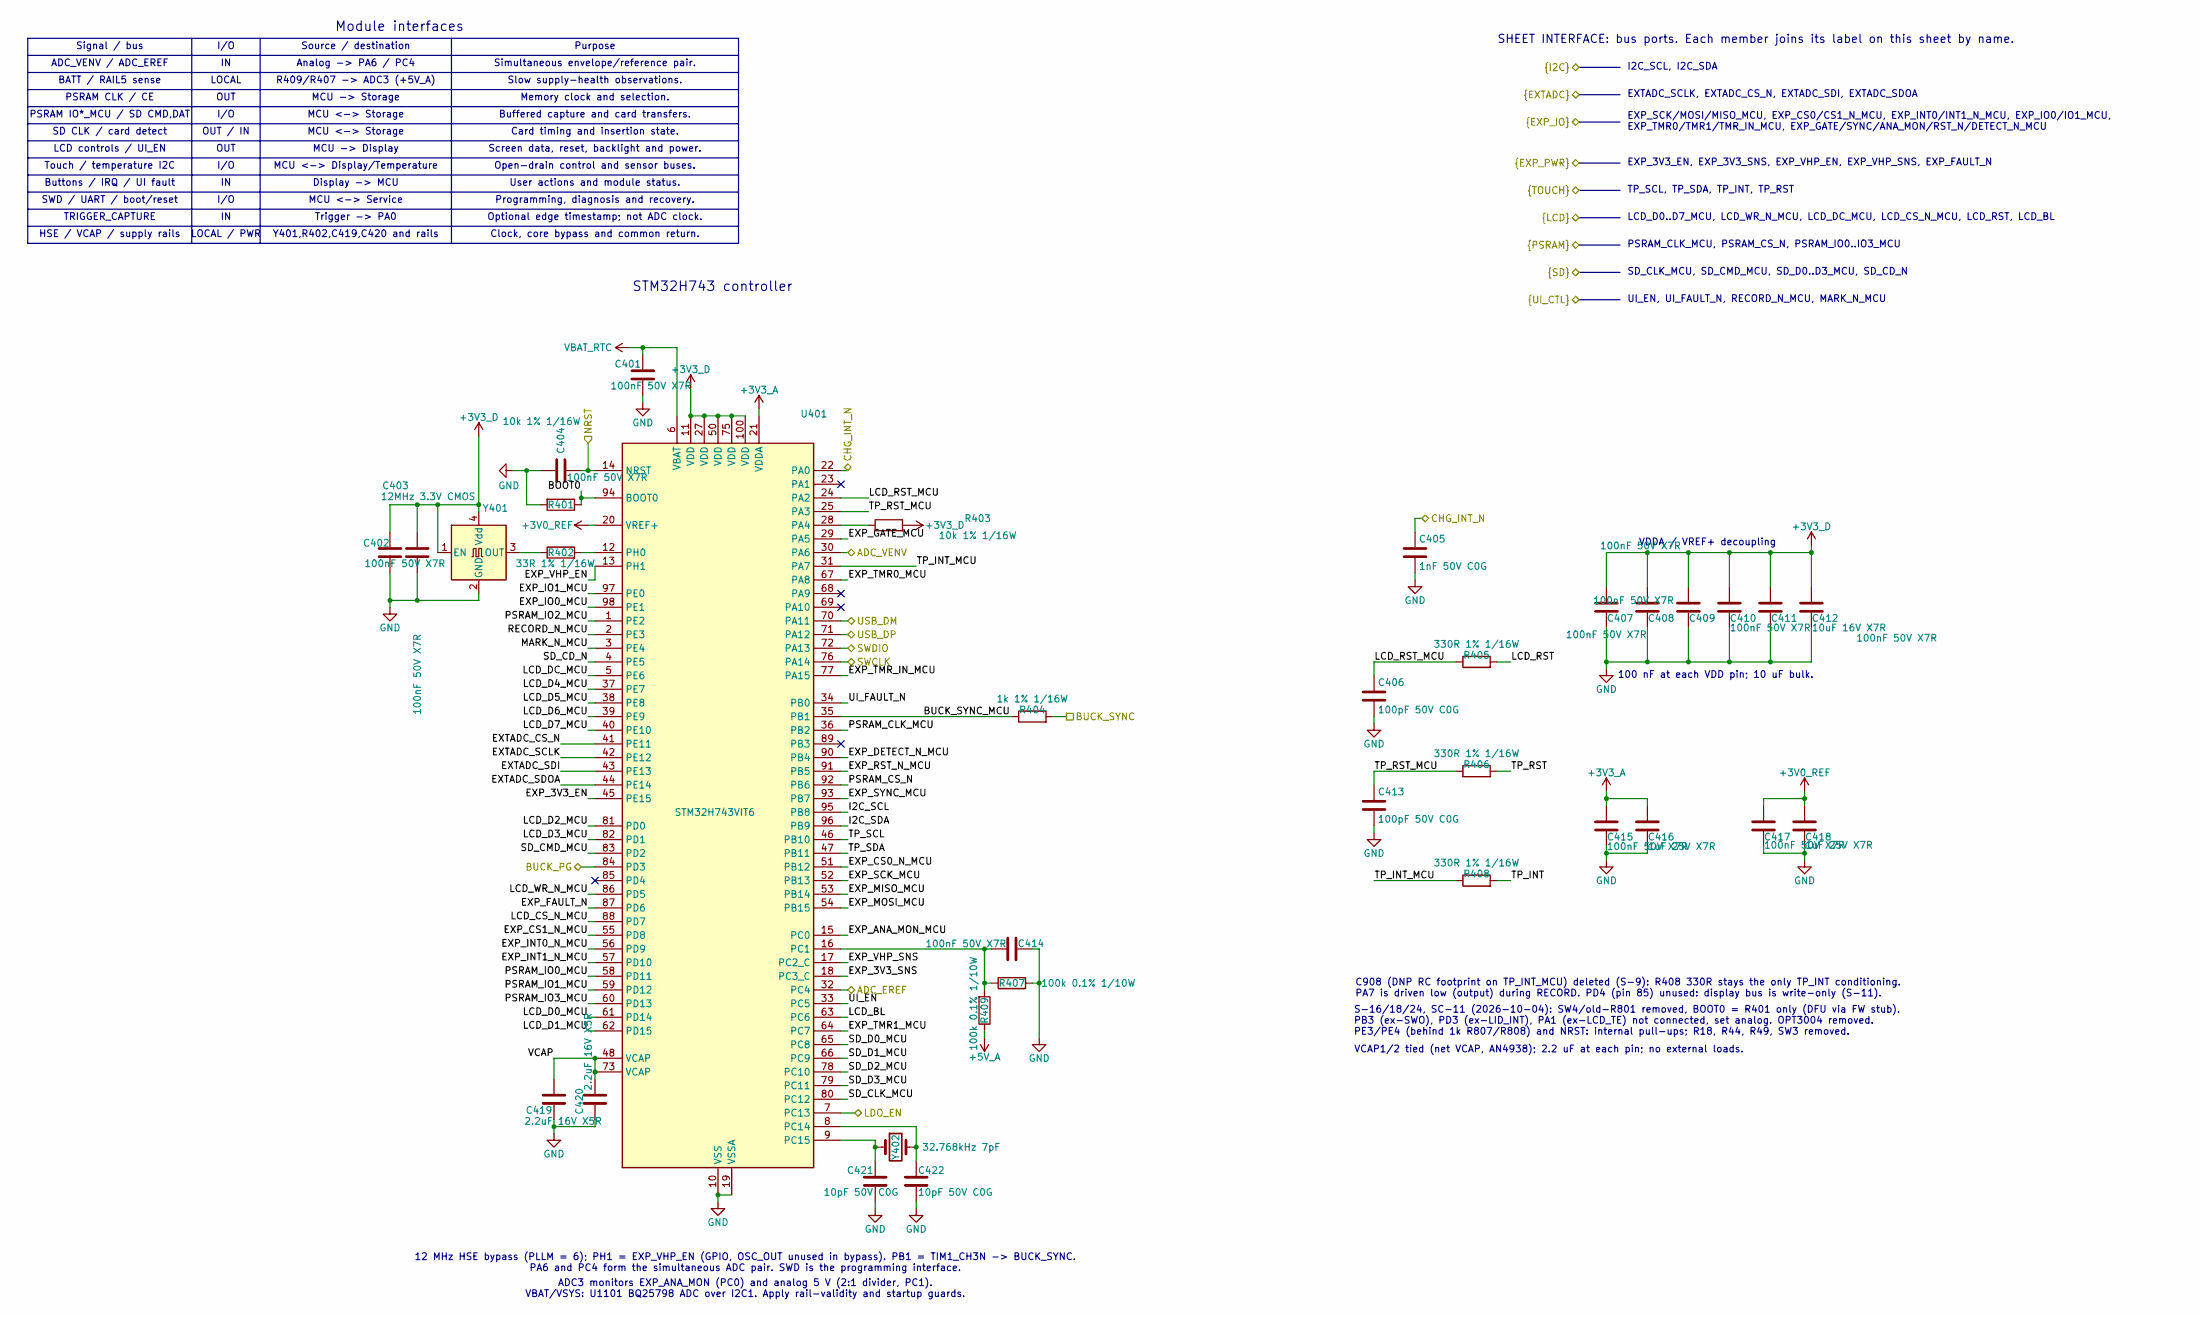
[picture p78: schematic MCU.kicad_sch, STM32H743 controller]

Parts:
C401, C402, C403, C411, C414: 100nF 50V X7R; C_0402_1005Metric; MPN CL05B104KB54PNC; JLCPCB_PN C307331
C404, C407, C408, C409, C410, C415, C417: 100nF 50V X7R; C_0402_1005Metric; MPN CL05B104KB54PNC; LCSC C307331
C405: 1nF 50V C0G; C_0402_1005Metric; MPN GRM1555C1H102JA01D; JLCPCB_PN C76947
C406, C413: 100pF 50V C0G; C_0402_1005Metric; MPN GRM1555C1H101JA01D; JLCPCB_PN C77177
C412: 10uF 16V X7R; C_0805_2012Metric; MPN CL21B106KOQNNNE; LCSC C95841
C416, C418: 1uF 25V X7R; C_0603_1608Metric; MPN CL10B105KA8NNNC; LCSC C29936
C419, C420: 2.2uF 16V X5R; C_0603_1608Metric; MPN CL10A225KO8NNNC; JLCPCB_PN C23630
C421, C422: 10pF 50V C0G; C_0402_1005Metric; MPN CL05C100JB5NNNC; JLCPCB_PN C32949
R401: 10k 1% 1/16W; R_0402_1005Metric; MPN 0402WGF1002TCE; LCSC C25744
R402: 33R 1% 1/16W; R_0402_1005Metric; MPN 0402WGF330JTCE; JLCPCB_PN C25105
R403: 10k 1% 1/16W; R_0402_1005Metric; MPN 0402WGF1002TCE; JLCPCB_PN C25744
R404: 1k 1% 1/16W; R_0402_1005Metric; MPN 0402WGF1001TCE; JLCPCB_PN C11702
R405, R406, R408: 330R 1% 1/16W; R_0402_1005Metric; MPN 0402WGF3300TCE; JLCPCB_PN C25104
R407, R409: 100k 0.1% 1/10W; R_0603_1608Metric; MPN RT0603BRD07100KL; JLCPCB_PN C122538
U401: STM32H743VIT6; LQFP-100_14x14mm_P0.5mm; MPN STM32H743VIT6; JLCPCB_PN C114409
Y401: 12MHz 3.3V CMOS; Oscillator_SMD_Abracon_ASE-4Pin_3.2x2.5mm; MPN ASE-12.000MHZ-LC-T; JLCPCB_PN C596950
Y402: 32.768kHz 7pF; Crystal_SMD_Abracon_ABS05-2Pin_1.6x1.0mm; MPN Q-SC16S0322070AAAN; JLCPCB_PN C5221452

Connections:
+3V0_REF: C417.1, C418.1, U401.20 (VREF+); also elsewhere on the board
+3V3_A: C415.1, C416.1, U401.21 (VDDA); also elsewhere on the board
+3V3_D: C402.1, C403.1, C407.1, C408.1, C409.1, C410.1, C411.1, C412.1, R403.2, U401.11 (VDD), U401.27 (VDD), U401.50 (VDD), U401.75 (VDD), U401.100 (VDD), Y401.1 (EN), Y401.4 (Vdd); also elsewhere on the board
+5V_A: R409.1; also elsewhere on the board
/3.3 V supplies/BUCK_PG: U401.84 (PD3); also elsewhere on the board
/3.3 V supplies/BUCK_SYNC: R404.2; also elsewhere on the board
/3.3 V supplies/LDO_EN: U401.7 (PC13); also elsewhere on the board
/Analog acquisition/ADC_EREF: U401.32 (PC4); also elsewhere on the board
/Analog acquisition/ADC_VENV: U401.30 (PA6); also elsewhere on the board
/Battery, charger and USB-C/CHG_INT_N: C405.1, U401.22 (PA0); also elsewhere on the board
/Battery, charger and USB-C/USB_DM: U401.70 (PA11); also elsewhere on the board
/Battery, charger and USB-C/USB_DP: U401.71 (PA12); also elsewhere on the board
/Expansion mezzanine/EXP_ANA_MON_MCU: U401.15 (PC0); also elsewhere on the board
/Expansion mezzanine/EXP_CS0_N_MCU: U401.51 (PB12); also elsewhere on the board
/Expansion mezzanine/EXP_CS1_N_MCU: U401.55 (PD8); also elsewhere on the board
/Expansion mezzanine/EXP_DETECT_N_MCU: U401.90 (PB4); also elsewhere on the board
/Expansion mezzanine/EXP_GATE_MCU: U401.29 (PA5); also elsewhere on the board
/Expansion mezzanine/EXP_INT0_N_MCU: U401.56 (PD9); also elsewhere on the board
/Expansion mezzanine/EXP_INT1_N_MCU: U401.57 (PD10); also elsewhere on the board
/Expansion mezzanine/EXP_IO0_MCU: U401.98 (PE1); also elsewhere on the board
/Expansion mezzanine/EXP_IO1_MCU: U401.97 (PE0); also elsewhere on the board
/Expansion mezzanine/EXP_MISO_MCU: U401.53 (PB14); also elsewhere on the board
/Expansion mezzanine/EXP_MOSI_MCU: U401.54 (PB15); also elsewhere on the board
/Expansion mezzanine/EXP_RST_N_MCU: U401.91 (PB5); also elsewhere on the board
/Expansion mezzanine/EXP_SCK_MCU: U401.52 (PB13); also elsewhere on the board
/Expansion mezzanine/EXP_SYNC_MCU: U401.93 (PB7); also elsewhere on the board
/Expansion mezzanine/EXP_TMR0_MCU: U401.67 (PA8); also elsewhere on the board
/Expansion mezzanine/EXP_TMR1_MCU: U401.64 (PC7); also elsewhere on the board
/Expansion mezzanine/EXP_TMR_IN_MCU: U401.77 (PA15); also elsewhere on the board
/Expansion power/EXP_3V3_EN: U401.45 (PE15); also elsewhere on the board
/Expansion power/EXP_3V3_SNS: U401.18 (PC3_C); also elsewhere on the board
/Expansion power/EXP_FAULT_N: U401.87 (PD6); also elsewhere on the board
/Expansion power/EXP_VHP_EN: U401.13 (PH1); also elsewhere on the board
/Expansion power/EXP_VHP_SNS: U401.17 (PC2_C); also elsewhere on the board
/External ADC/EXTADC_CS_N: U401.41 (PE11); also elsewhere on the board
/External ADC/EXTADC_SCLK: U401.42 (PE12); also elsewhere on the board
/External ADC/EXTADC_SDI: U401.43 (PE13); also elsewhere on the board
/External ADC/EXTADC_SDOA: U401.44 (PE14); also elsewhere on the board
/I2C_SCL: U401.95 (PB8); also elsewhere on the board
/I2C_SDA: U401.96 (PB9); also elsewhere on the board
/Programming and service/NRST: C404.1, U401.14 (NRST); also elsewhere on the board
/Programming and service/SWCLK: U401.76 (PA14); also elsewhere on the board
/Programming and service/SWDIO: U401.72 (PA13); also elsewhere on the board
/SD and capture memory/PSRAM_CLK_MCU: U401.36 (PB2); also elsewhere on the board
/SD and capture memory/PSRAM_CS_N: U401.92 (PB6); also elsewhere on the board
/SD and capture memory/PSRAM_IO0_MCU: U401.58 (PD11); also elsewhere on the board
/SD and capture memory/PSRAM_IO1_MCU: U401.59 (PD12); also elsewhere on the board
/SD and capture memory/PSRAM_IO2_MCU: U401.1 (PE2); also elsewhere on the board
/SD and capture memory/PSRAM_IO3_MCU: U401.60 (PD13); also elsewhere on the board
/SD and capture memory/SD_CD_N: U401.4 (PE5); also elsewhere on the board
/SD and capture memory/SD_CLK_MCU: U401.80 (PC12); also elsewhere on the board
/SD and capture memory/SD_CMD_MCU: U401.83 (PD2); also elsewhere on the board
/SD and capture memory/SD_D0_MCU: U401.65 (PC8); also elsewhere on the board
/SD and capture memory/SD_D1_MCU: U401.66 (PC9); also elsewhere on the board
/SD and capture memory/SD_D2_MCU: U401.78 (PC10); also elsewhere on the board
/SD and capture memory/SD_D3_MCU: U401.79 (PC11); also elsewhere on the board
/STM32H743 controller/BOOT0: R401.1, U401.94 (BOOT0)
/STM32H743 controller/BUCK_SYNC_MCU: R404.1, U401.35 (PB1)
/STM32H743 controller/LCD_BL: U401.63 (PC6); also elsewhere on the board
/STM32H743 controller/LCD_CS_N_MCU: U401.88 (PD7); also elsewhere on the board
/STM32H743 controller/LCD_D0_MCU: U401.61 (PD14); also elsewhere on the board
/STM32H743 controller/LCD_D1_MCU: U401.62 (PD15); also elsewhere on the board
/STM32H743 controller/LCD_D2_MCU: U401.81 (PD0); also elsewhere on the board
/STM32H743 controller/LCD_D3_MCU: U401.82 (PD1); also elsewhere on the board
/STM32H743 controller/LCD_D4_MCU: U401.37 (PE7); also elsewhere on the board
/STM32H743 controller/LCD_D5_MCU: U401.38 (PE8); also elsewhere on the board
/STM32H743 controller/LCD_D6_MCU: U401.39 (PE9); also elsewhere on the board
/STM32H743 controller/LCD_D7_MCU: U401.40 (PE10); also elsewhere on the board
/STM32H743 controller/LCD_DC_MCU: U401.5 (PE6); also elsewhere on the board
/STM32H743 controller/LCD_RST: R405.2; also elsewhere on the board
/STM32H743 controller/LCD_RST_MCU: C406.1, R405.1, U401.24 (PA2)
/STM32H743 controller/LCD_WR_N_MCU: U401.86 (PD5); also elsewhere on the board
/STM32H743 controller/MARK_N_MCU: U401.3 (PE4); also elsewhere on the board
/STM32H743 controller/RECORD_N_MCU: U401.2 (PE3); also elsewhere on the board
/STM32H743 controller/TP_INT: R408.2; also elsewhere on the board
/STM32H743 controller/TP_INT_MCU: R408.1, U401.31 (PA7)
/STM32H743 controller/TP_RST: R406.2; also elsewhere on the board
/STM32H743 controller/TP_RST_MCU: C413.1, R406.1, U401.25 (PA3)
/STM32H743 controller/TP_SCL: U401.46 (PB10); also elsewhere on the board
/STM32H743 controller/TP_SDA: U401.47 (PB11); also elsewhere on the board
/STM32H743 controller/UI_EN: U401.33 (PC5); also elsewhere on the board
/STM32H743 controller/UI_FAULT_N: U401.34 (PB0); also elsewhere on the board
/STM32H743 controller/VCAP: C419.1, C420.1, U401.48 (VCAP), U401.73 (VCAP)
GND: C401.2, C402.2, C403.2, C404.2, C405.2, C406.2, C407.2, C408.2, C409.2, C410.2, C411.2, C412.2, C413.2, C414.2, C415.2, C416.2, C417.2, C418.2, C419.2, C420.2, C421.2, C422.2, R401.2, R407.2, U401.10 (VSS), U401.19 (VSSA), U401.26 (VSS), U401.49 (VSS), U401.74 (VSS), U401.99 (VSS), Y401.2 (GND); also elsewhere on the board
unnamed: R403.1, U401.28 (PA4)
unnamed: C414.1, R407.1, R409.2, U401.16 (PC1)
unnamed: C422.1, U401.8 (PC14), Y402.2
unnamed: C421.1, U401.9 (PC15), Y402.1
unnamed: R402.2, U401.12 (PH0)
unnamed: R402.1, Y401.3 (OUT)
VBAT_RTC: C401.1, U401.6 (VBAT); also elsewhere on the board

Notes on the sheet:
MCU <-> Service
Y401,R402,C419,C420 and rails
I/O
UI_EN, UI_FAULT_N, RECORD_N_MCU, MARK_N_MCU
Signal / bus
Memory clock and selection.
Optional edge timestamp; not ADC clock.
100 nF at each VDD pin; 10 uF bulk.
SHEET INTERFACE: bus ports. Each member joins its label on this sheet by name.
SWD / UART / boot/reset
MCU <-> Storage
Purpose
Source / destination
EXP_SCK/MOSI/MISO_MCU, EXP_CS0/CS1_N_MCU, EXP_INT0/INT1_N_MCU, EXP_IO0/IO1_MCU, EXP_TMR0/TMR1/TMR_IN_MCU, EXP_GATE/SYNC/ANA_MON/RST_N/DETECT_N_MCU
ADC_VENV / ADC_EREF
MCU -> Storage
Analog -> PA6 / PC4
OUT
C908 (DNP RC footprint on TP_INT_MCU) deleted (S-9): R408 330R stays the only TP_INT conditioning. PA7 is driven low (output) during RECORD. PD4 (pin 85) unused: display bus is write-only (S-11).
EXTADC_SCLK, EXTADC_CS_N, EXTADC_SDI, EXTADC_SDOA
Module interfaces
User actions and module status.
VDDA / VREF+ decoupling
VCAP1/2 tied (net VCAP, AN4938); 2.2 uF at each pin; no external loads.
LOCAL / PWR
PSRAM IO*_MCU / SD CMD,DAT
ADC3 monitors EXP_ANA_MON (PC0) and analog 5 V (2:1 divider, PC1). VBAT/VSYS: U1101 BQ25798 ADC over I2C1. Apply rail-validity and startup guards.
Open-drain control and sensor buses.
Programming, diagnosis and recovery.
TRIGGER_CAPTURE
Screen data, reset, backlight and power.
SD CLK / card detect
LCD_D0..D7_MCU, LCD_WR_N_MCU, LCD_DC_MCU, LCD_CS_N_MCU, LCD_RST, LCD_BL
LCD controls / UI_EN
Buffered capture and card transfers.
OUT / IN
R409/R407 -> ADC3 (+5V_A)
PSRAM_CLK_MCU, PSRAM_CS_N, PSRAM_IO0..IO3_MCU
PSRAM CLK / CE
Buttons / IRQ / UI fault
12 MHz HSE bypass (PLLM = 6); PH1 = EXP_VHP_EN (GPIO, OSC_OUT unused in bypass). PB1 = TIM1_CH3N -> BUCK_SYNC. PA6 and PC4 form the simultaneous ADC pair. SWD is the programming interface.
BATT / RAIL5 sense
Slow supply-health observations.
HSE / VCAP / supply rails
I2C_SCL, I2C_SDA
Clock, core bypass and common return.
EXP_3V3_EN, EXP_3V3_SNS, EXP_VHP_EN, EXP_VHP_SNS, EXP_FAULT_N
LOCAL
MCU <-> Display/Temperature
MCU -> Display
Trigger -> PA0
Touch / temperature I2C
Card timing and insertion state.
SD_CLK_MCU, SD_CMD_MCU, SD_D0..D3_MCU, SD_CD_N
TP_SCL, TP_SDA, TP_INT, TP_RST
Display -> MCU
STM32H743 controller
S-16/18/24, SC-11 (2026-10-04): SW4/old-R801 removed, BOOT0 = R401 only (DFU via FW stub). PB3 (ex-SWO), PD3 (ex-LID_INT), PA1 (ex-LCD_TE) not connected, set analog. OPT3004 removed. PE3/PE4 (behind 1k R807/R808) and NRST: internal pull-ups; R18, R44, R49, SW3 removed.
Simultaneous envelope/reference pair.
