Able-Digital-Logic/UnintendedAntennaClub3/Hardware/RFVD_SENSOR_BOARD_Rev6/RFVD_SENSOR_BOARD.kicad_pcb

## KiCad design Hardware/RFVD_SENSOR_BOARD_Rev6/RFVD_SENSOR_BOARD.kicad_pcb (continued)

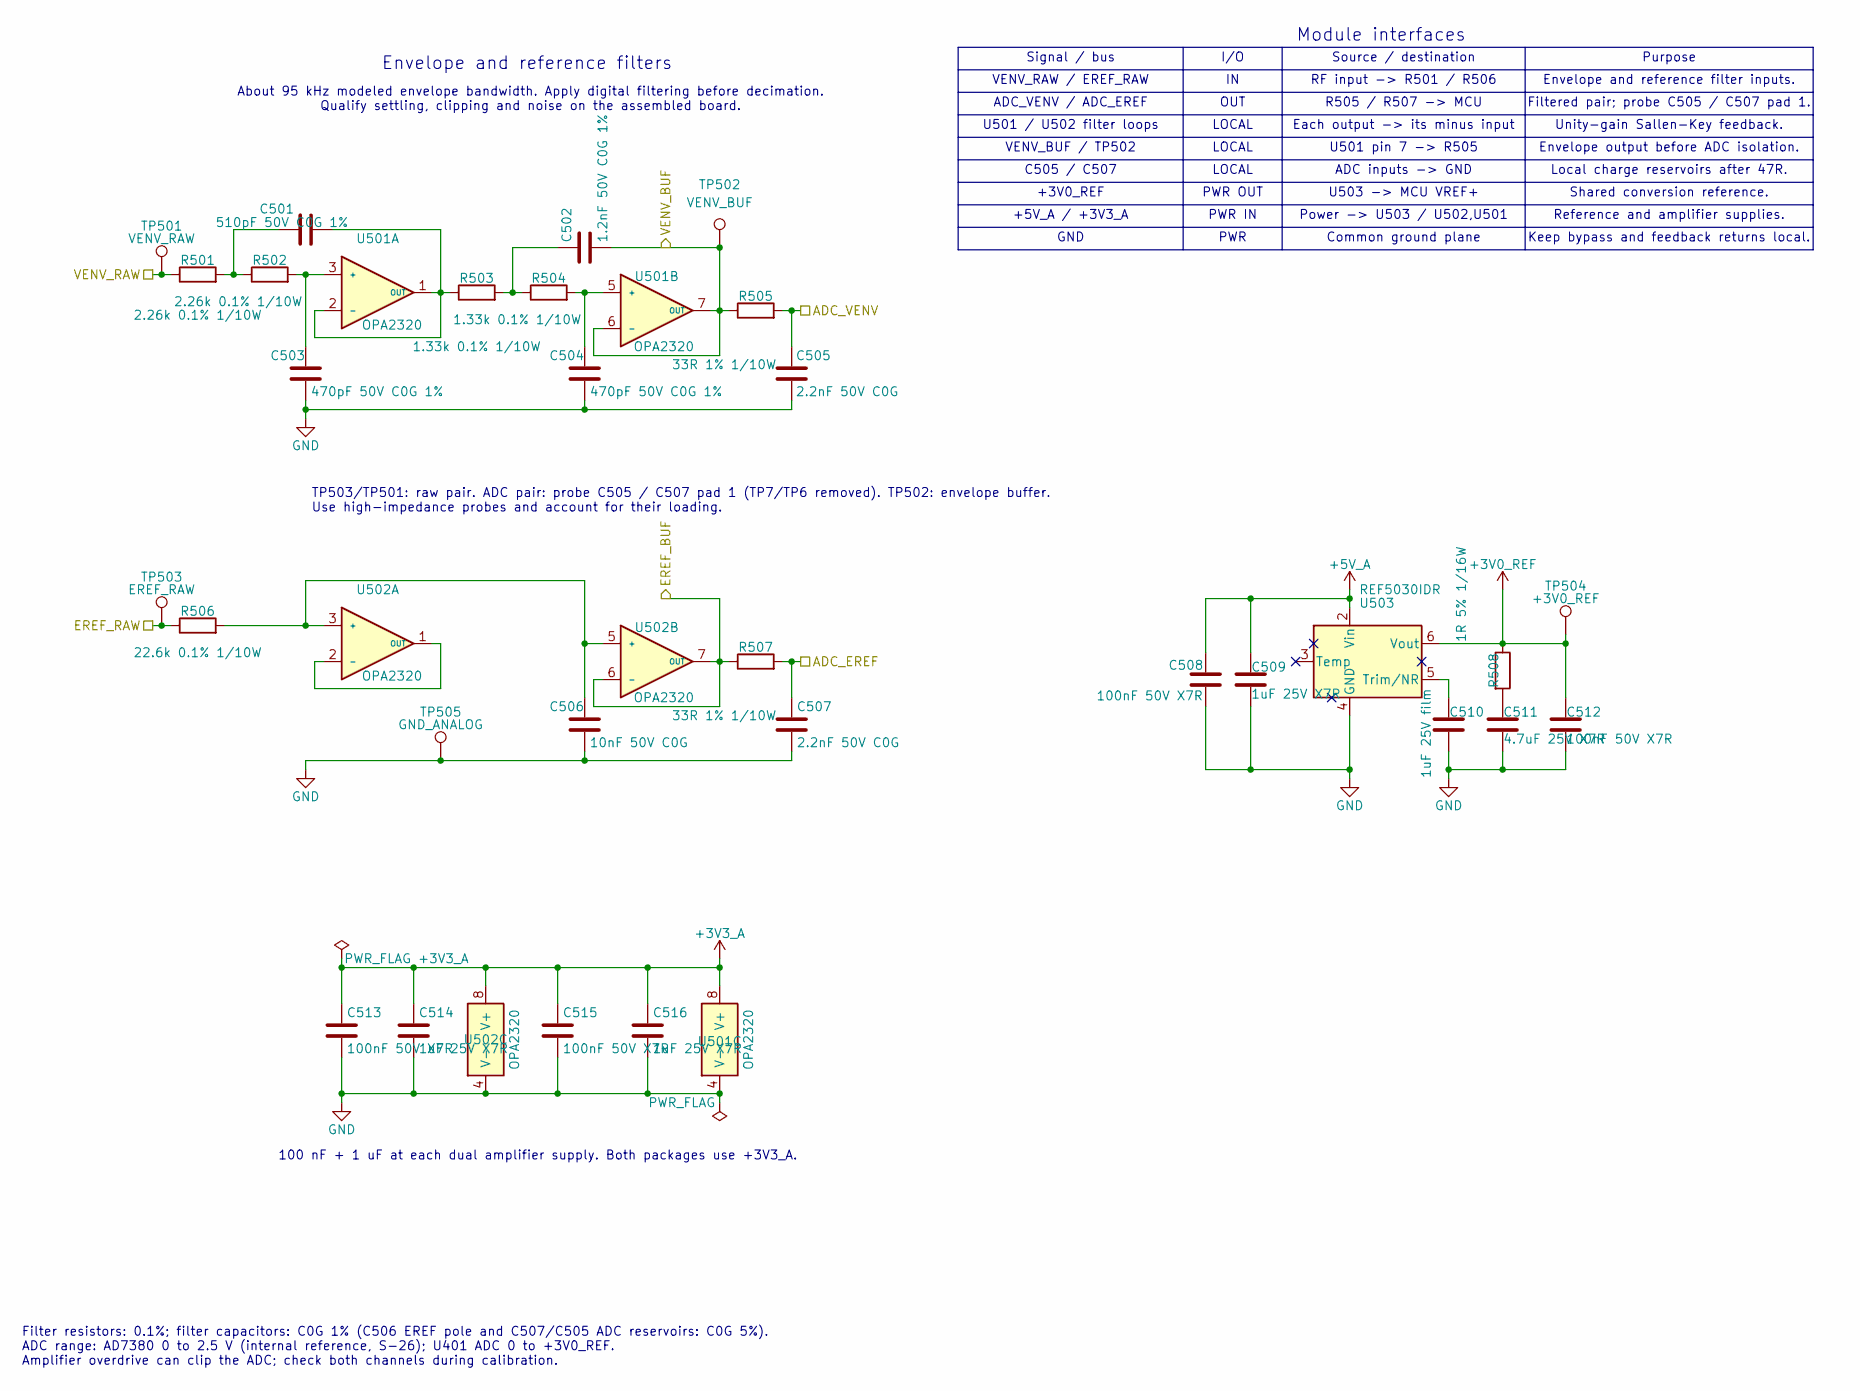
[picture p79: schematic Analog_Acquisition.kicad_sch, Analog acquisition]

Parts:
C501: 510pF 50V C0G 1%; C_0603_1608Metric; Tolerance 1%; Voltage Rating 50V; MPN CC0603FRNPO9BN511; JLCPCB_PN C519572
C502: 1.2nF 50V C0G 1%; C_0603_1608Metric; Tolerance 1%; Voltage Rating 50V; MPN GCM1885C1H122FA16D; JLCPCB_PN C1517816
C503, C504: 470pF 50V C0G 1%; C_0603_1608Metric; Tolerance 1%; Voltage Rating 50V; MPN CC0603FRNPO9BN471; JLCPCB_PN C519564
C505, C507: 2.2nF 50V C0G; C_0402_1005Metric; Tolerance 5%; Voltage Rating 50V; MPN GRM1555C1H222JA01D; JLCPCB_PN C385029
C506: 10nF 50V C0G; C_0603_1608Metric; Tolerance 1%; Voltage Rating 50V; MPN GRM1885C1H103JA01D; JLCPCB_PN C85973
C508, C512, C513: 100nF 50V X7R; C_0402_1005Metric; MPN CL05B104KB54PNC; LCSC C307331
C509: 1uF 25V X7R; C_0603_1608Metric; MPN CL10B105KA8NNNC; LCSC C29936
C510: 1uF 25V film; C_1206_3216Metric; MPN 25MU105MA23216; LCSC C3776619
C511: 4.7uF 25V X7R; C_0805_2012Metric; MPN C2012X7R1E475KT000N; LCSC C76642
C514, C516: 1uF 25V X7R; C_0603_1608Metric; Tolerance 10%; Voltage Rating 25V; MPN CL10B105KA8NNNC; JLCPCB_PN C29936
C515: 100nF 50V X7R; C_0402_1005Metric; Tolerance 10%; Voltage Rating 50V; MPN CL05B104KB54PNC; JLCPCB_PN C307331
R501, R502: 2.26k 0.1% 1/10W; R_0603_1608Metric; Power Rating 0.1W at 70C; Tolerance 0.1%; MPN PTFR0603B2K26P9; JLCPCB_PN C47115856
R503, R504: 1.33k 0.1% 1/10W; R_0603_1608Metric; Power Rating 0.1W at 70C; Tolerance 0.1%; MPN RT0603BRD071K33L; JLCPCB_PN C861196
R505: 33R 1% 1/10W; R_0603_1608Metric; Power Rating 0.1W at 70C; Tolerance 1%; MPN 0603WAF330JT5E; JLCPCB_PN C23140
R506: 22.6k 0.1% 1/10W; R_0603_1608Metric; Tolerance 0.1%; Power Rating 0.1W at 70C; MPN RT0603BRD0722K6L; JLCPCB_PN C861236
R507: 33R 1% 1/10W; R_0603_1608Metric; Tolerance 1%; Power Rating 0.1W at 70C; MPN 0603WAF330JT5E; JLCPCB_PN C23140
R508: 1R 5% 1/16W; R_0402_1005Metric; MPN FRC0402J1R0 TS; LCSC C2906901
TP501: VENV_RAW; TestPoint_Pad_D1.0mm; MPN DNP-NO-COMPONENT; LCSC N/A
TP502: VENV_BUF; TestPoint_Pad_D1.0mm; MPN PCB_PAD
TP503: EREF_RAW; TestPoint_Pad_D1.0mm; MPN DNP-NO-COMPONENT; LCSC N/A
TP504: +3V0_REF; TestPoint_Pad_D1.0mm; MPN DNP-NO-COMPONENT; LCSC N/A
TP505: GND_ANALOG; TestPoint_Pad_D1.0mm; MPN PCB_PAD
U501, U502: OPA2320; VSSOP-8_3x3mm_P0.65mm; MPN OPA2320AIDGKR; LCSC C545235
U503: REF5030IDR; SOIC-8_3.9x4.9mm_P1.27mm; MPN REF5030IDR; LCSC C2878155

Connections:
+3V0_REF: C512.1, R508.1, TP504.1 (1_1), U503.6 (Vout); also elsewhere on the board
+3V3_A: C513.1, C514.1, C515.1, C516.1, U501.8 (V+), U502.8 (V+); also elsewhere on the board
+5V_A: C508.1, C509.1, U503.2 (Vin); also elsewhere on the board
/Analog acquisition/ADC_EREF: C507.1, R507.2; also elsewhere on the board
/Analog acquisition/ADC_VENV: C505.1, R505.2; also elsewhere on the board
/Analog acquisition/EREF_BUF: R507.1, U502.6 (-), U502.7 (OUT); also elsewhere on the board
/Analog acquisition/EREF_RAW: R506.1, TP503.1 (1_1); also elsewhere on the board
/Analog acquisition/VENV_BUF: C502.2, R505.1, TP502.1 (1_1), U501.6 (-), U501.7 (OUT); also elsewhere on the board
/Analog acquisition/VENV_RAW: R501.1, TP501.1 (1_1); also elsewhere on the board
GND: C503.2, C504.2, C505.2, C506.2, C507.2, C508.2, C509.2, C510.2, C511.2, C512.2, C513.2, C514.2, C515.2, C516.2, TP505.1 (1_1), U501.4 (V-), U502.4 (V-), U503.4 (GND); also elsewhere on the board
unnamed: C501.1, R501.2, R502.1
unnamed: C502.1, R503.2, R504.1
unnamed: C511.1, R508.2
unnamed: C503.1, R502.2, U501.3 (+)
unnamed: C501.2, R503.1, U501.1 (OUT), U501.2 (-)
unnamed: C504.1, R504.2, U501.5 (+)
unnamed: C506.1, R506.2, U502.3 (+), U502.5 (+)
unnamed: U502.1 (OUT), U502.2 (-)
unnamed: C510.1, U503.5 (Trim/NR)

Notes on the sheet:
TP503/TP501: raw pair. ADC pair: probe C505 / C507 pad 1 (TP7/TP6 removed). TP502: envelope buffer. Use high-impedance probes and account for their loading.
Purpose
Power -> U503 / U502,U501
LOCAL
Filtered pair; probe C505 / C507 pad 1.
Reference and amplifier supplies.
R505 / R507 -> MCU
PWR
RF input -> R501 / R506
VENV_RAW / EREF_RAW
Envelope and reference filter inputs.
+3V0_REF
Signal / bus
PWR IN
Shared conversion reference.
Common ground plane
GND
Envelope output before ADC isolation.
U503 -> MCU VREF+
I/O
Module interfaces
ADC_VENV / ADC_EREF
Filter resistors: 0.1%; filter capacitors: C0G 1% (C506 EREF pole and C507/C505 ADC reservoirs: C0G 5%). ADC range: AD7380 0 to 2.5 V (internal reference, S-26); U401 ADC 0 to +3V0_REF. Amplifier overdrive can clip the ADC; check both channels during calibration.
U501 / U502 filter loops
Envelope and reference filters
VENV_BUF / TP502
Unity-gain Sallen-Key feedback.
ADC inputs -> GND
About 95 kHz modeled envelope bandwidth. Apply digital filtering before decimation. Qualify settling, clipping and noise on the assembled board.
Each output -> its minus input
PWR OUT
U501 pin 7 -> R505
C505 / C507
Local charge reservoirs after 47R.
OUT
Keep bypass and feedback returns local.
100 nF + 1 uF at each dual amplifier supply. Both packages use +3V3_A.
Source / destination
+5V_A / +3V3_A

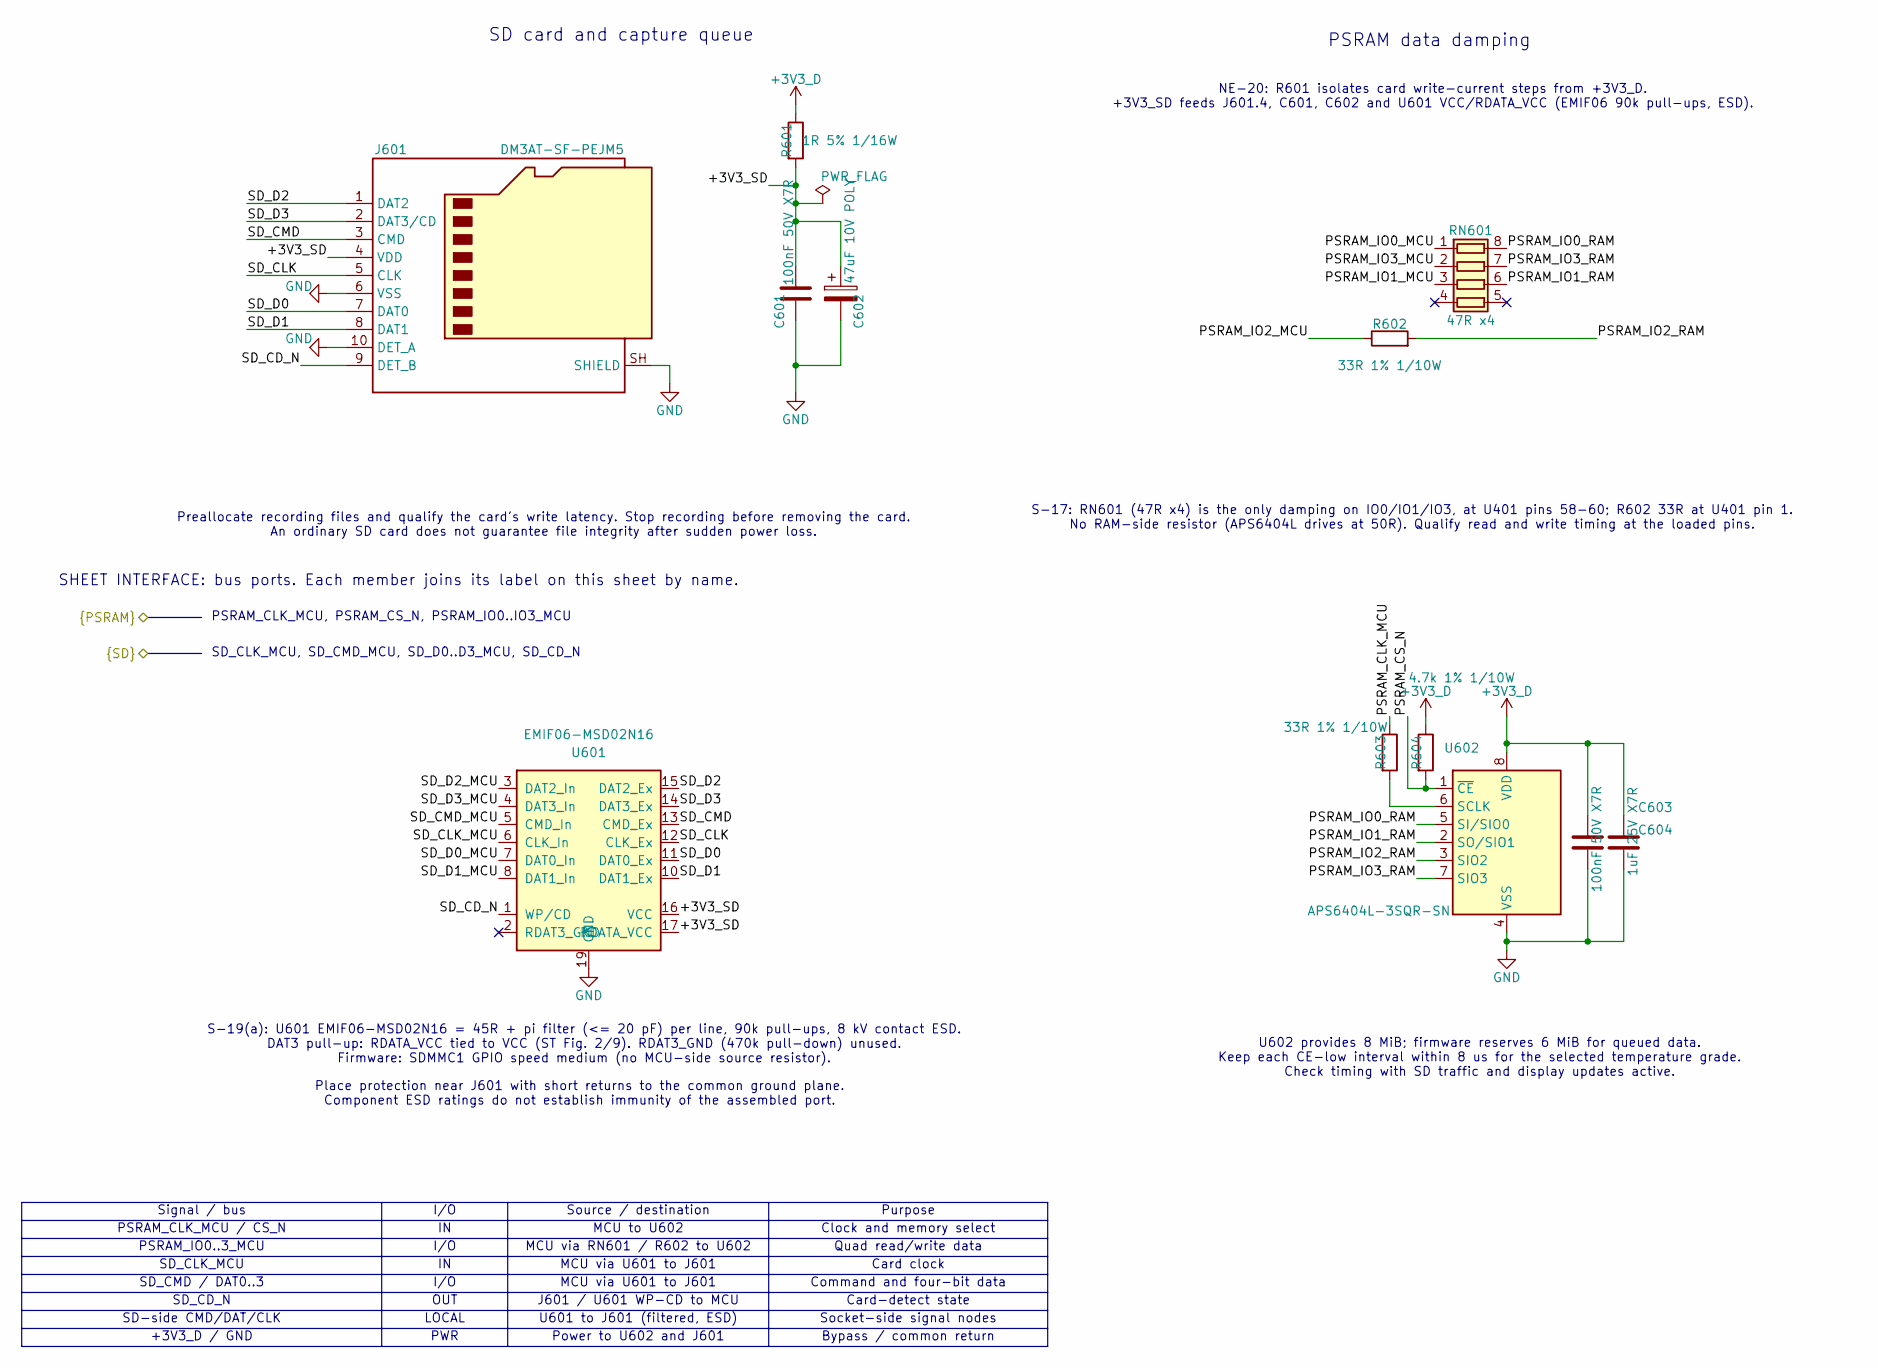
[picture p80: schematic Storage.kicad_sch, SD and capture memory]

Parts:
C601: 100nF 50V X7R; C_0402_1005Metric; MPN CL05B104KB54PNC; LCSC C307331
C602: 47uF 10V POLY; CP_EIA-3528-21_Kemet-B; MPN T520B476M010ATE035; LCSC C141441
C603: 100nF 50V X7R; C_0402_1005Metric; MPN CL05B104KB54PNC; JLCPCB_PN C307331
C604: 1uF 25V X7R; C_0603_1608Metric; MPN CL10B105KA8NNNC; JLCPCB_PN C29936
J601: DM3AT-SF-PEJM5; microSD_HC_Hirose_DM3AT-SF-PEJM5; MPN DM3AT-SF-PEJM5; JLCPCB_PN C114218
R601: 1R 5% 1/16W; R_0402_1005Metric; MPN FRC0402J1R0 TS; JLCPCB_PN C2906901
R602, R603: 33R 1% 1/10W; R_0603_1608Metric; MPN 0603WAF330JT5E; JLCPCB_PN C23140
R604: 4.7k 1% 1/10W; R_0603_1608Metric; MPN 0603WAF4701T5E; JLCPCB_PN C23162
RN601: 47R x4; R_Array_Convex_4x0402; MPN 4D02WGJ0470TCE; JLCPCB_PN C55183
U601: EMIF06-MSD02N16; ST_EMIF06-MSD02N16_uQFN-16_3.5x1.2mm_P0.4mm; MPN EMIF06-MSD02N16; JLCPCB_PN C5267594
U602: APS6404L-3SQR-SN; SOIC-8_3.9x4.9mm_P1.27mm; MPN APS6404L-3SQR-SN; JLCPCB_PN C5333729

Connections:
+3V3_D: C603.1, C604.1, R601.1, R604.1, U602.8 (VDD); also elsewhere on the board
/SD and capture memory/+3V3_SD: C601.1, C602.1, J601.4 (VDD), R601.2, U601.16 (VCC), U601.17 (RDATA_VCC)
/SD and capture memory/PSRAM_CLK_MCU: R603.1; also elsewhere on the board
/SD and capture memory/PSRAM_CS_N: R604.2, U602.1 (~CE); also elsewhere on the board
/SD and capture memory/PSRAM_IO0_MCU: RN601.1 (R1.1); also elsewhere on the board
/SD and capture memory/PSRAM_IO0_RAM: RN601.8 (R1.2), U602.5 (SI/SIO0)
/SD and capture memory/PSRAM_IO1_MCU: RN601.3 (R3.1); also elsewhere on the board
/SD and capture memory/PSRAM_IO1_RAM: RN601.6 (R3.2), U602.2 (SO/SIO1)
/SD and capture memory/PSRAM_IO2_MCU: R602.1; also elsewhere on the board
/SD and capture memory/PSRAM_IO2_RAM: R602.2, U602.3 (SIO2)
/SD and capture memory/PSRAM_IO3_MCU: RN601.2 (R2.1); also elsewhere on the board
/SD and capture memory/PSRAM_IO3_RAM: RN601.7 (R2.2), U602.7 (SIO3)
/SD and capture memory/SD_CD_N: J601.9 (DET_B), U601.1 (WP/CD); also elsewhere on the board
/SD and capture memory/SD_CLK: J601.5 (CLK), U601.12 (CLK_Ex)
/SD and capture memory/SD_CLK_MCU: U601.6 (CLK_In); also elsewhere on the board
/SD and capture memory/SD_CMD: J601.3 (CMD), U601.13 (CMD_Ex)
/SD and capture memory/SD_CMD_MCU: U601.5 (CMD_In); also elsewhere on the board
/SD and capture memory/SD_D0: J601.7 (DAT0), U601.11 (DAT0_Ex)
/SD and capture memory/SD_D0_MCU: U601.7 (DAT0_In); also elsewhere on the board
/SD and capture memory/SD_D1: J601.8 (DAT1), U601.10 (DAT1_Ex)
/SD and capture memory/SD_D1_MCU: U601.8 (DAT1_In); also elsewhere on the board
/SD and capture memory/SD_D2: J601.1 (DAT2), U601.15 (DAT2_Ex)
/SD and capture memory/SD_D2_MCU: U601.3 (DAT2_In); also elsewhere on the board
/SD and capture memory/SD_D3: J601.2 (DAT3/CD), U601.14 (DAT3_Ex)
/SD and capture memory/SD_D3_MCU: U601.4 (DAT3_In); also elsewhere on the board
GND: C601.2, C602.2, C603.2, C604.2, J601.6 (VSS), J601.10 (DET_A), J601.SH (SHIELD), U601.19 (GND), U602.4 (VSS); also elsewhere on the board
unnamed: R603.2, U602.6 (SCLK)

Notes on the sheet:
OUT
I/O
MCU via U601 to J601
SD-side CMD/DAT/CLK
Preallocate recording files and qualify the card's write latency. Stop recording before removing the card. An ordinary SD card does not guarantee file integrity after sudden power loss.
PWR
Socket-side signal nodes
Clock and memory select
PSRAM_CLK_MCU / CS_N
Quad read/write data
Bypass / common return
Card clock
LOCAL
SD_CLK_MCU, SD_CMD_MCU, SD_D0..D3_MCU, SD_CD_N
U602 provides 8 MiB; firmware reserves 6 MiB for queued data. Keep each CE-low interval within 8 us for the selected temperature grade. Check timing with SD traffic and display updates active.
NE-20: R601 isolates card write-current steps from +3V3_D. +3V3_SD feeds J601.4, C601, C602 and U601 VCC/RDATA_VCC (EMIF06 90k pull-ups, ESD).
PSRAM_IO0..3_MCU
Purpose
Command and four-bit data
Place protection near J601 with short returns to the common ground plane. Component ESD ratings do not establish immunity of the assembled port.
MCU to U602
J601 / U601 WP-CD to MCU
SHEET INTERFACE: bus ports. Each member joins its label on this sheet by name.
Card-detect state
SD_CLK_MCU
PSRAM data damping
Source / destination
Signal / bus
SD card and capture queue
S-17: RN601 (47R x4) is the only damping on IO0/IO1/IO3, at U401 pins 58-60; R602 33R at U401 pin 1. No RAM-side resistor (APS6404L drives at 50R). Qualify read and write timing at the loaded pins.
PSRAM_CLK_MCU, PSRAM_CS_N, PSRAM_IO0..IO3_MCU
Power to U602 and J601
SD_CD_N
SD_CMD / DAT0..3
MCU via RN601 / R602 to U602
S-19(a): U601 EMIF06-MSD02N16 = 45R + pi filter (<= 20 pF) per line, 90k pull-ups, 8 kV contact ESD. DAT3 pull-up: RDATA_VCC tied to VCC (ST Fig. 2/9). RDAT3_GND (470k pull-down) unused. Firmware: SDMMC1 GPIO speed medium (no MCU-side source resistor).
+3V3_D / GND
U601 to J601 (filtered, ESD)

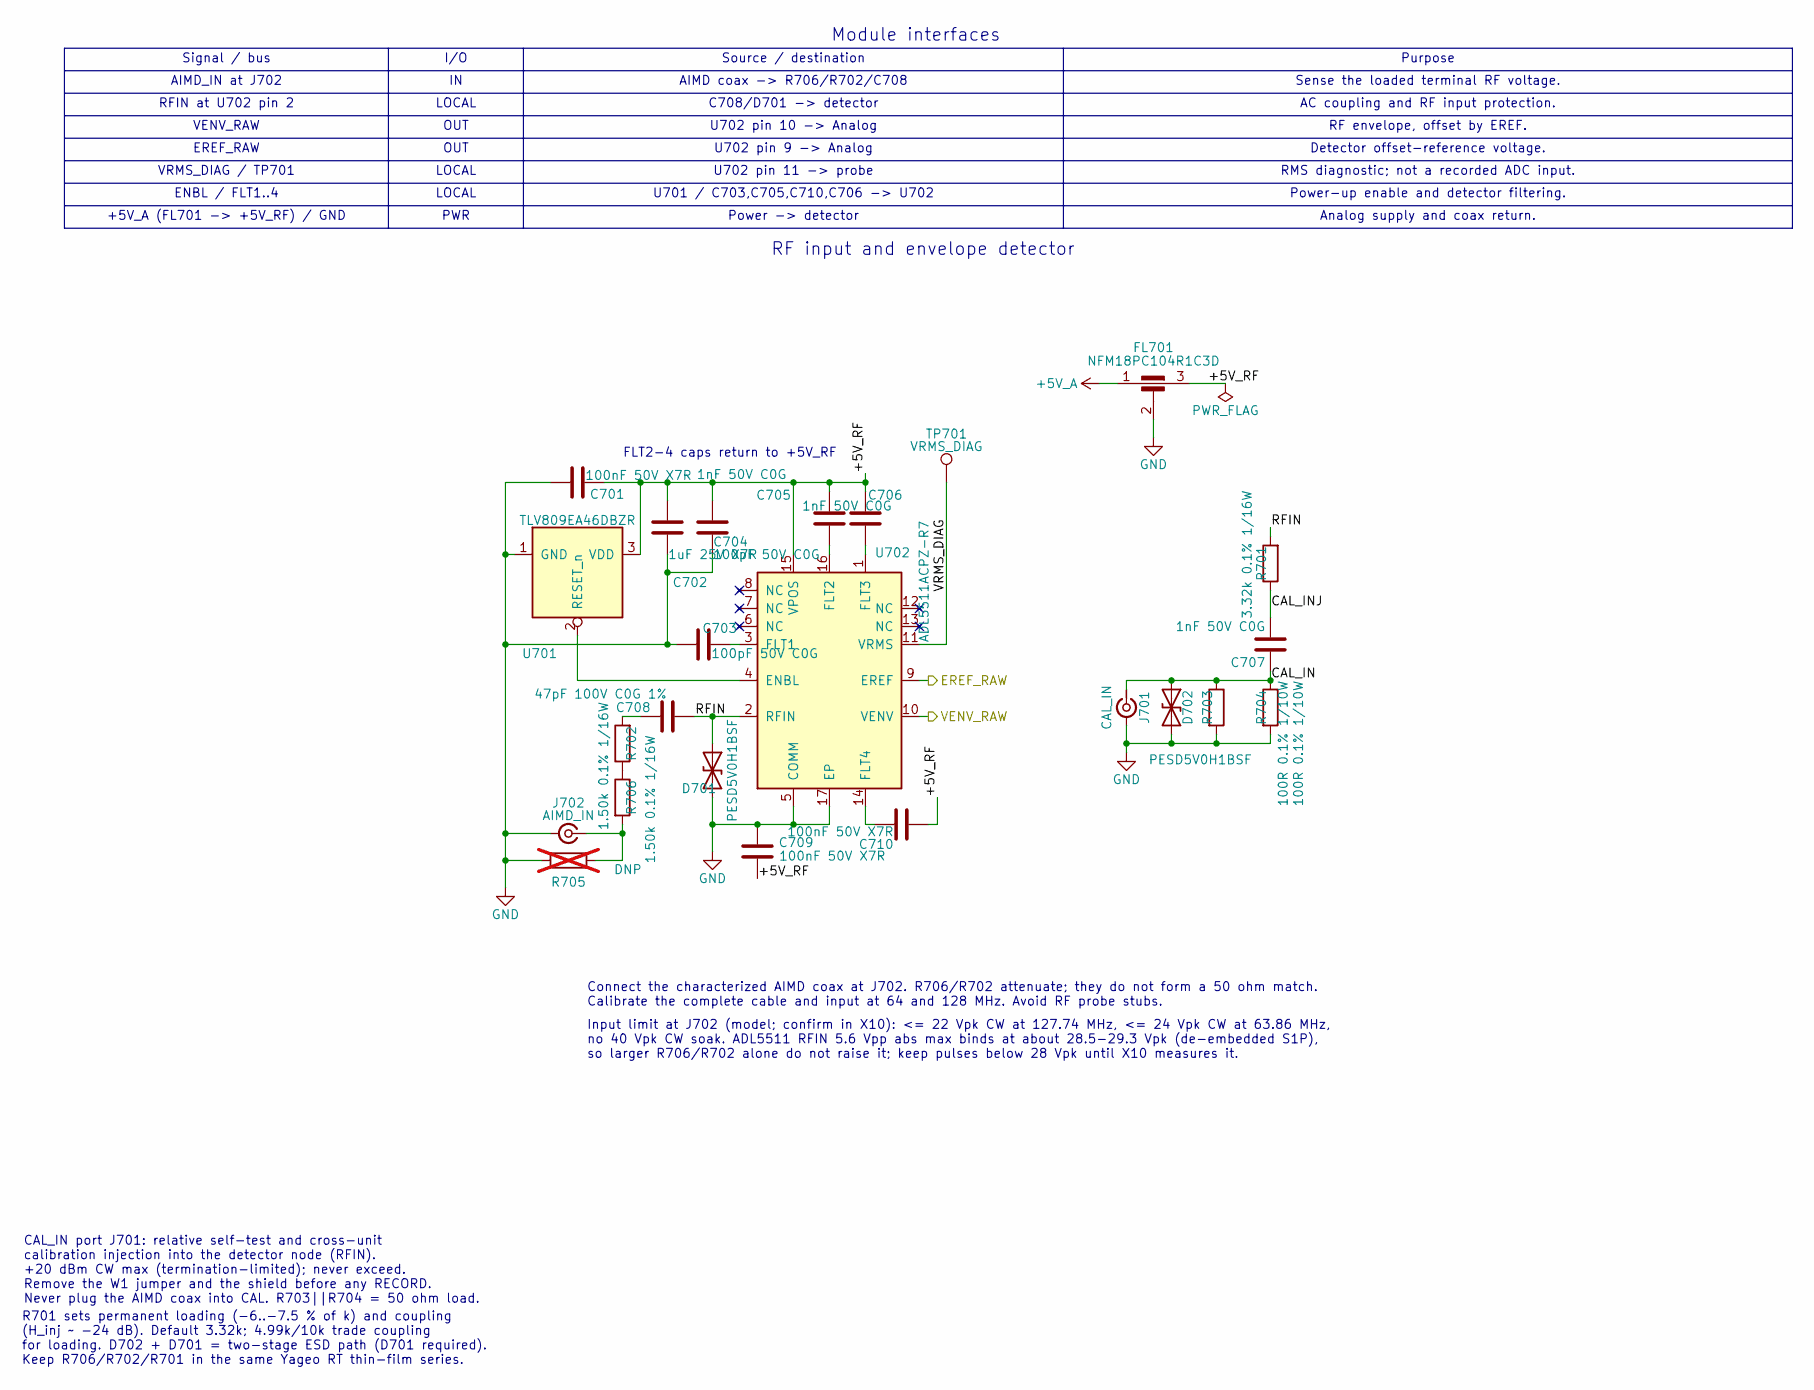
[picture p81: schematic RF_Input.kicad_sch, RF input and detector]

Parts:
C701: 100nF 50V X7R; C_0603_1608Metric; MPN CC0603KRX7R9BB104; LCSC C14663
C702: 1uF 25V X7R; C_0603_1608Metric; MPN CL10B105KA8NNNC; LCSC C29936
C703, C704: 100pF 50V C0G; C_0402_1005Metric; MPN GRM1555C1H101JA01D; LCSC C77177
C705, C706: 1nF 50V C0G; C_0402_1005Metric; MPN GRM1555C1H102JA01D; LCSC C76947
C707: 1nF 50V C0G; C_0402_1005Metric; MPN GRM1555C1H102JA01D; JLCPCB_PN C76947
C708: 47pF 100V C0G 1%; C_0603_1608Metric; MPN GCM1885C2A470FA16D; JLCPCB_PN C882574
C709: 100nF 50V X7R; C_0402_1005Metric; MPN CL05B104KB54PNC; JLCPCB_PN C307331
C710: 100nF 50V X7R; C_0402_1005Metric; MPN CL05B104KB54PNC; LCSC C307331
D701, D702: PESD5V0H1BSF; PESD2V5Y1BSF_SOD962-2_ManufacturerLand; MPN PESD5V0H1BSFYL; JLCPCB_PN C478002
FL701: NFM18PC104R1C3D; Murata_NFM18PC_0603_3T; MPN NFM18PC104R1C3D; JLCPCB_PN C111493
J701: CAL_IN; U.FL_Hirose_U.FL-R-SMT-1_Vertical; MPN U.FL-R-SMT-1(80); JLCPCB_PN C88374
J702: AIMD_IN; U.FL_Hirose_U.FL-R-SMT-1_Vertical; MPN U.FL-R-SMT-1(80); LCSC C88374
R701: 3.32k 0.1% 1/16W; R_0402_1005Metric; MPN RT0402BRD073K32L; JLCPCB_PN C852762
R702, R706: 1.50k 0.1% 1/16W; R_0402_1005Metric; MPN RT0402BRD071K5L; JLCPCB_PN C281775
R703, R704: 100R 0.1% 1/10W; R_0603_1608Metric; MPN RT0603BRD07100RL; JLCPCB_PN C122970
R705: DNP; R_0603_1608Metric; not fitted
TP701: VRMS_DIAG; TestPoint_Pad_D1.0mm; MPN DNP-NO-COMPONENT; LCSC N/A
U701: TLV809EA46DBZR; SOT-23-3; MPN TLV809EA46DBZR; LCSC C1852111
U702: ADL5511ACPZ-R7; LFCSP-16-1EP_3x3mm_P0.5mm_EP1.6x1.6mm; MPN ADL5511ACPZ-R7; JLCPCB_PN C579159

Connections:
+5V_A: FL701.1; also elsewhere on the board
/Analog acquisition/EREF_RAW: U702.9 (EREF); also elsewhere on the board
/Analog acquisition/VENV_RAW: U702.10 (VENV); also elsewhere on the board
/RF input and detector/+5V_RF: C701.1, C702.1, C704.1, C705.2, C706.2, C709.1, C710.2, FL701.3, U701.3 (VDD), U702.15 (VPOS)
/RF input and detector/CAL_IN: C707.1, D702.1 (A1), J701.1 (In), R703.1, R704.1
/RF input and detector/CAL_INJ: C707.2, R701.1
/RF input and detector/RFIN: C708.2, D701.1 (A1), R701.2, U702.2 (RFIN)
/RF input and detector/VRMS_DIAG: TP701.1 (1_1), U702.11 (VRMS)
GND: C701.2, C702.2, C703.2, C704.2, C709.2, D701.2 (A2), D702.2 (A2), FL701.2, J701.2 (Ext), J702.2 (Ext), R703.2, R704.2, R705.2, U701.1 (GND), U702.5 (COMM), U702.17 (EP); also elsewhere on the board
unnamed: C708.1, R702.2
unnamed: J702.1 (In), R705.1, R706.2
unnamed: R702.1, R706.1
unnamed: U701.2 (RESET_n), U702.4 (ENBL)
unnamed: C703.1, U702.3 (FLT1)
unnamed: C705.1, U702.16 (FLT2)
unnamed: C706.1, U702.1 (FLT3)
unnamed: C710.1, U702.14 (FLT4)

Notes on the sheet:
LOCAL
OUT
AIMD coax -> R706/R702/C708
FLT2-4 caps return to +5V_RF
+5V_A (FL701 -> +5V_RF) / GND
U701 / C703,C705,C710,C706 -> U702
R701 sets permanent loading (-6..-7.5 % of k) and coupling (H_inj ~ -24 dB). Default 3.32k; 4.99k/10k trade coupling for loading. D702 + D701 = two-stage ESD path (D701 required). Keep R706/R702/R701 in the same Yageo RT thin-film series.
Sense the loaded terminal RF voltage.
Analog supply and coax return.
Power-up enable and detector filtering.
Source / destination
AC coupling and RF input protection.
C708/D701 -> detector
RF input and envelope detector
ENBL / FLT1..4
RF envelope, offset by EREF.
CAL_IN port J701: relative self-test and cross-unit calibration injection into the detector node (RFIN). +20 dBm CW max (termination-limited); never exceed. Remove the W1 jumper and the shield before any RECORD. Never plug the AIMD coax into CAL. R703||R704 = 50 ohm load.
Module interfaces
VRMS_DIAG / TP701
Purpose
PWR
Detector offset-reference voltage.
Power -> detector
U702 pin 9 -> Analog
U702 pin 11 -> probe
U702 pin 10 -> Analog
AIMD_IN at J702
Input limit at J702 (model; confirm in X10): <= 22 Vpk CW at 127.74 MHz, <= 24 Vpk CW at 63.86 MHz, no 40 Vpk CW soak. ADL5511 RFIN 5.6 Vpp abs max binds at about 28.5-29.3 Vpk (de-embedded S1P), so larger R706/R702 alone do not raise it; keep pulses below 28 Vpk until X10 measures it.
VENV_RAW
Connect the characterized AIMD coax at J702. R706/R702 attenuate; they do not form a 50 ohm match. Calibrate the complete cable and input at 64 and 128 MHz. Avoid RF probe stubs.
I/O
RFIN at U702 pin 2
RMS diagnostic; not a recorded ADC input.
Signal / bus
EREF_RAW

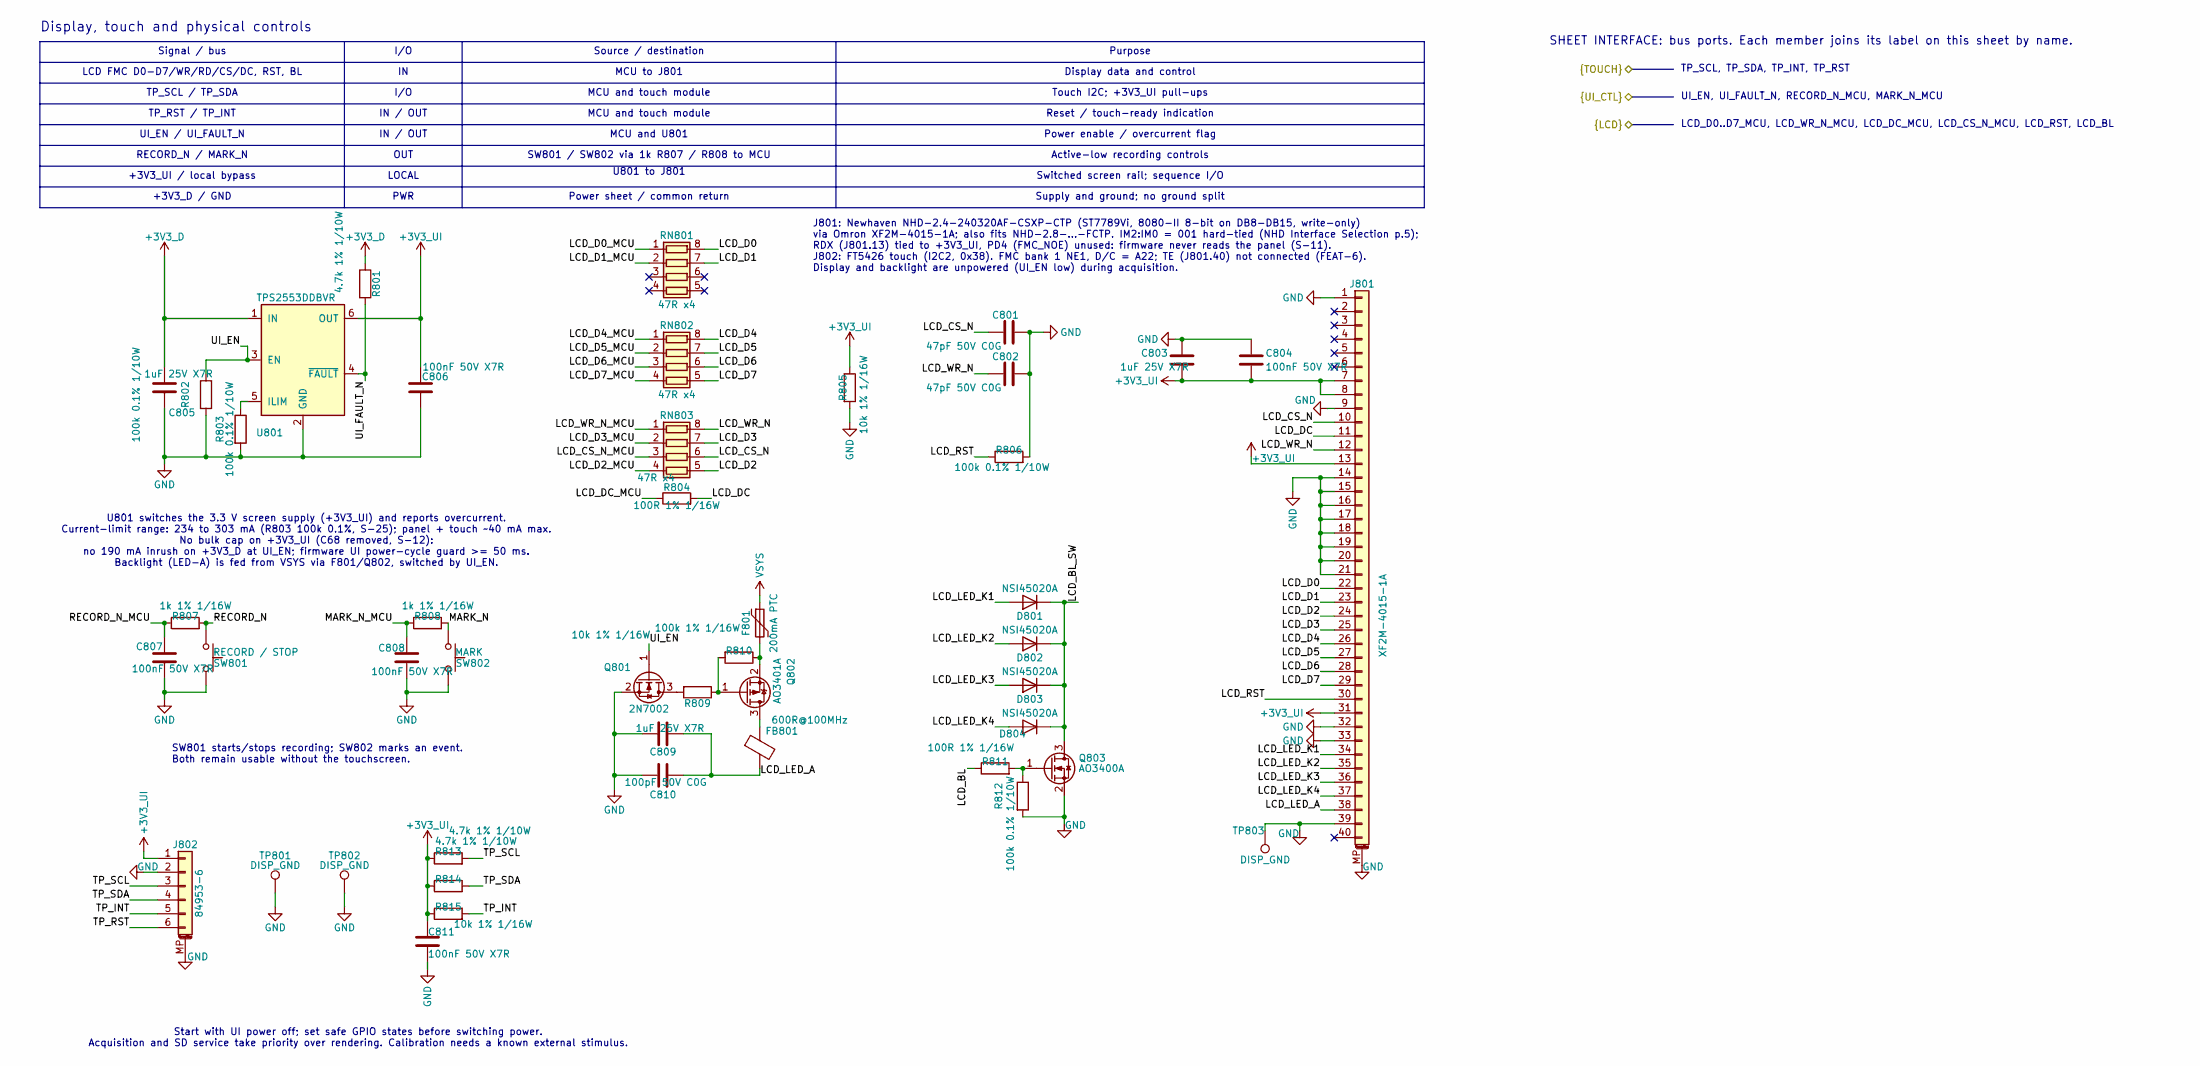
[picture p82: schematic Display.kicad_sch, Screen and controls]

Parts:
C801, C802: 47pF 50V C0G; C_0402_1005Metric; MPN 0402CG470J500NT; JLCPCB_PN C1567
C803, C805, C809: 1uF 25V X7R; C_0603_1608Metric; MPN CL10B105KA8NNNC; JLCPCB_PN C29936
C804, C806, C807, C808, C811: 100nF 50V X7R; C_0402_1005Metric; MPN CL05B104KB54PNC; JLCPCB_PN C307331
C810: 100pF 50V C0G; C_0402_1005Metric; MPN GRM1555C1H101JA01D; JLCPCB_PN C77177
D801, D802, D803, D804: NSI45020A; D_SOD-123; MPN NSI45020AT1G; JLCPCB_PN C128367
F801: 200mA PTC; Fuse_0603_1608Metric; MPN BSMD0603-020-16V; JLCPCB_PN C883092
FB801: 600R@100MHz; L_0603_1608Metric; MPN BLM18AG601SN1D; JLCPCB_PN C19330
J801: XF2M-4015-1A; Omron_XF2M-4015-1A_1x40-1MP_P0.5mm_Horizontal; MPN XF2M-4015-1A; JLCPCB_PN C225713
J802: 84953-6; TE_84953-6_1x06-1MP_P1.0mm_Horizontal; MPN 84953-6; JLCPCB_PN C408826
Q801: 2N7002; SOT-23; MPN 2N7002; JLCPCB_PN C8545
Q802: AO3401A; SOT-23; MPN AO3401A; JLCPCB_PN C15127
Q803: AO3400A; SOT-23; MPN AO3400A; JLCPCB_PN C20917
R801, R813, R814: 4.7k 1% 1/10W; R_0603_1608Metric; MPN 0603WAF4701T5E; JLCPCB_PN C23162
R802, R803, R806, R812: 100k 0.1% 1/10W; R_0603_1608Metric; MPN RT0603BRD07100KL; JLCPCB_PN C122538
R804, R811: 100R 1% 1/16W; R_0402_1005Metric; MPN 0402WGF1000TCE; JLCPCB_PN C25076
R805, R809, R815: 10k 1% 1/16W; R_0402_1005Metric; MPN 0402WGF1002TCE; JLCPCB_PN C25744
R807, R808: 1k 1% 1/16W; R_0402_1005Metric; MPN 0402WGF1001TCE; JLCPCB_PN C11702
R810: 100k 1% 1/16W; R_0402_1005Metric; MPN 0402WGF1003TCE; JLCPCB_PN C25741
RN801, RN802, RN803: 47R x4; R_Array_Convex_4x0402; MPN 4D02WGJ0470TCE; JLCPCB_PN C55183
SW801: RECORD / STOP; SW_SPST_B3U-1000P; MPN B3U-1000P; JLCPCB_PN C231329
SW802: MARK; SW_SPST_B3U-1000P; MPN B3U-1000P; JLCPCB_PN C231329
TP801, TP802, TP803: DISP_GND; TestPoint_Pad_3.0x3.0mm; MPN PCB pad (no part)
U801: TPS2553DDBVR; SOT-23-6; MPN TPS2553DDBVR; JLCPCB_PN C521201

Connections:
+3V3_D: C805.1, R801.1, U801.1 (IN); also elsewhere on the board
+3V3_UI: C803.2, C804.2, C806.1, C811.1, J801.7, J801.8, J801.13, J801.31, J802.1, R805.1, R813.1, R814.1, R815.1, U801.6 (OUT)
/STM32H743 controller/LCD_BL: R811.1; also elsewhere on the board
/STM32H743 controller/LCD_CS_N_MCU: RN803.3 (R3.1); also elsewhere on the board
/STM32H743 controller/LCD_D0_MCU: RN801.1 (R1.1); also elsewhere on the board
/STM32H743 controller/LCD_D1_MCU: RN801.2 (R2.1); also elsewhere on the board
/STM32H743 controller/LCD_D2_MCU: RN803.4 (R4.1); also elsewhere on the board
/STM32H743 controller/LCD_D3_MCU: RN803.2 (R2.1); also elsewhere on the board
/STM32H743 controller/LCD_D4_MCU: RN802.1 (R1.1); also elsewhere on the board
/STM32H743 controller/LCD_D5_MCU: RN802.2 (R2.1); also elsewhere on the board
/STM32H743 controller/LCD_D6_MCU: RN802.3 (R3.1); also elsewhere on the board
/STM32H743 controller/LCD_D7_MCU: RN802.4 (R4.1); also elsewhere on the board
/STM32H743 controller/LCD_DC_MCU: R804.1; also elsewhere on the board
/STM32H743 controller/LCD_RST: J801.30, R806.1; also elsewhere on the board
/STM32H743 controller/LCD_WR_N_MCU: RN803.1 (R1.1); also elsewhere on the board
/STM32H743 controller/MARK_N_MCU: C808.1, R808.1; also elsewhere on the board
/STM32H743 controller/RECORD_N_MCU: C807.1, R807.1; also elsewhere on the board
/STM32H743 controller/TP_INT: J802.5, R815.2; also elsewhere on the board
/STM32H743 controller/TP_RST: J802.6; also elsewhere on the board
/STM32H743 controller/TP_SCL: J802.3, R813.2; also elsewhere on the board
/STM32H743 controller/TP_SDA: J802.4, R814.2; also elsewhere on the board
/STM32H743 controller/UI_EN: Q801.1 (G), R802.1, U801.3 (EN); also elsewhere on the board
/STM32H743 controller/UI_FAULT_N: R801.2, U801.4 (~FAULT); also elsewhere on the board
/Screen and controls/LCD_BL_SW: D801.1 (K), D802.1 (K), D803.1 (K), D804.1 (K), Q803.3 (D)
/Screen and controls/LCD_CS_N: C801.1, J801.10, RN803.6 (R3.2)
/Screen and controls/LCD_D0: J801.22, RN801.8 (R1.2)
/Screen and controls/LCD_D1: J801.23, RN801.7 (R2.2)
/Screen and controls/LCD_D2: J801.24, RN803.5 (R4.2)
/Screen and controls/LCD_D3: J801.25, RN803.7 (R2.2)
/Screen and controls/LCD_D4: J801.26, RN802.8 (R1.2)
/Screen and controls/LCD_D5: J801.27, RN802.7 (R2.2)
/Screen and controls/LCD_D6: J801.28, RN802.6 (R3.2)
/Screen and controls/LCD_D7: J801.29, RN802.5 (R4.2)
/Screen and controls/LCD_DC: J801.11, R804.2
/Screen and controls/LCD_LED_A: C809.1, C810.1, FB801.2, J801.38
/Screen and controls/LCD_LED_K1: D801.2 (A), J801.34
/Screen and controls/LCD_LED_K2: D802.2 (A), J801.35
/Screen and controls/LCD_LED_K3: D803.2 (A), J801.36
/Screen and controls/LCD_LED_K4: D804.2 (A), J801.37
/Screen and controls/LCD_WR_N: C802.1, J801.12, RN803.8 (R1.2)
/Screen and controls/MARK_N: R808.2, SW802.1
/Screen and controls/RECORD_N: R807.2, SW801.1
GND: C801.2, C802.2, C803.1, C804.1, C805.2, C806.2, C807.2, C808.2, C809.2, C810.2, C811.2, J801.1, J801.9, J801.14, J801.15, J801.16, J801.17, J801.18, J801.19, J801.20, J801.21, J801.32, J801.33, J801.39, J801.MP (MountPin), J802.2, J802.MP (MountPin), Q801.2 (S), Q803.2 (S), R802.2, R803.2, R805.2, R806.2, R812.2, SW801.2, SW802.2, TP801.1 (1_1), TP802.1 (1_1), TP803.1 (1_1), U801.2 (GND); also elsewhere on the board
unnamed: Q801.3 (D), R809.2
unnamed: FB801.1, Q802.3 (D)
unnamed: Q802.1 (G), R809.1, R810.2
unnamed: F801.2, Q802.2 (S), R810.1
unnamed: Q803.1 (G), R811.2, R812.1
unnamed: R803.1, U801.5 (ILIM)
VSYS: F801.1; also elsewhere on the board

Notes on the sheet:
IN / OUT
OUT
Signal / bus
Power enable / overcurrent flag
MCU and touch module
Supply and ground; no ground split
U801 to J801
Display, touch and physical controls
+3V3_UI / local bypass
U801 switches the 3.3 V screen supply (+3V3_UI) and reports overcurrent. Current-limit range: 234 to 303 mA (R803 100k 0.1%, S-25); panel + touch ~40 mA max. No bulk cap on +3V3_UI (C68 removed, S-12): no 190 mA inrush on +3V3_D at UI_EN; firmware UI power-cycle guard >= 50 ms. Backlight (LED-A) is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
MCU and U801
Display data and control
Active-low recording controls
I/O
PWR
MCU to J801
Power sheet / common return
Source / destination
J801: Newhaven NHD-2.4-240320AF-CSXP-CTP (ST7789Vi, 8080-II 8-bit on DB8-DB15, write-only) via Omron XF2M-4015-1A; also fits NHD-2.8-...-FCTP. IM2:IM0 = 001 hard-tied (NHD Interface Selection p.5); RDX (J801.13) tied to +3V3_UI, PD4 (FMC_NOE) unused: firmware never reads the panel (S-11). J802: FT5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
RECORD_N / MARK_N
UI_EN / UI_FAULT_N
TP_RST / TP_INT
Reset / touch-ready indication
SHEET INTERFACE: bus ports. Each member joins its label on this sheet by name.
Touch I2C; +3V3_UI pull-ups
LCD FMC D0-D7/WR/RD/CS/DC, RST, BL
Switched screen rail; sequence I/O
UI_EN, UI_FAULT_N, RECORD_N_MCU, MARK_N_MCU
LOCAL
SW801 / SW802 via 1k R807 / R808 to MCU
Purpose
TP_SCL, TP_SDA, TP_INT, TP_RST
LCD_D0..D7_MCU, LCD_WR_N_MCU, LCD_DC_MCU, LCD_CS_N_MCU, LCD_RST, LCD_BL
SW801 starts/stops recording; SW802 marks an event. Both remain usable without the touchscreen.
+3V3_D / GND
TP_SCL / TP_SDA
Start with UI power off; set safe GPIO states before switching power. Acquisition and SD service take priority over rendering. Calibration needs a known external stimulus.
