Able-Digital-Logic/UnintendedAntennaClub3/Hardware/RFVD_SENSOR_BOARD_Rev6/RFVD_SENSOR_BOARD.kicad_pcb

## KiCad design Hardware/RFVD_SENSOR_BOARD_Rev6/RFVD_SENSOR_BOARD.kicad_pcb (continued)

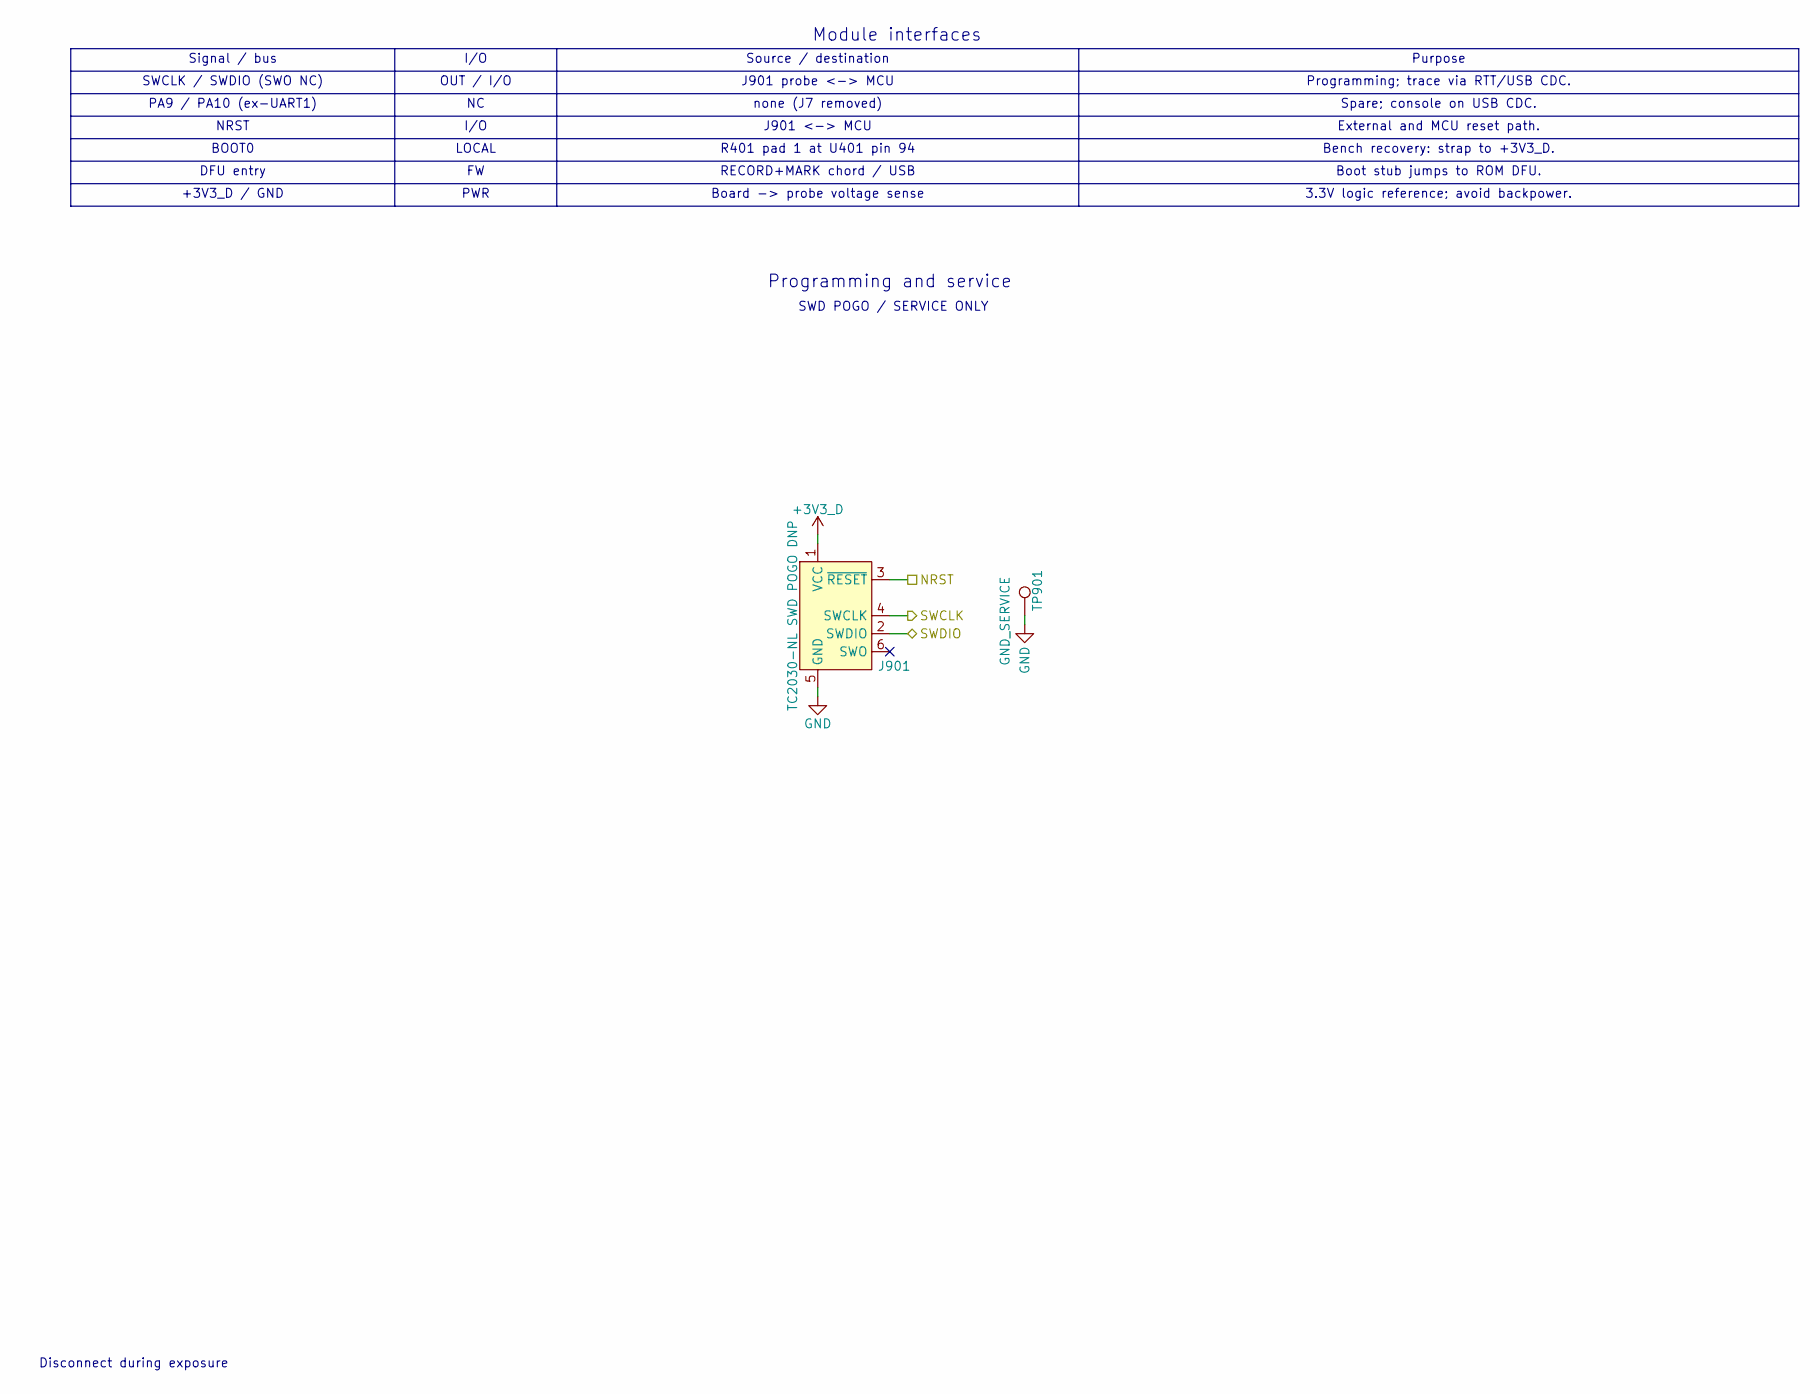
[picture p83: schematic Service.kicad_sch, Programming and service]

Parts:
J901: TC2030-NL SWD POGO DNP; Tag-Connect_TC2030-IDC-NL_2x03_P1.27mm_Vertical; MPN DNP-NO-COMPONENT; LCSC N/A
TP901: GND_SERVICE; TestPoint_Pad_D1.0mm; MPN PCB_PAD

Connections:
+3V3_D: J901.1 (VCC); also elsewhere on the board
/Programming and service/NRST: J901.3 (~RESET); also elsewhere on the board
/Programming and service/SWCLK: J901.4 (SWCLK); also elsewhere on the board
/Programming and service/SWDIO: J901.2 (SWDIO); also elsewhere on the board
GND: J901.5 (GND), TP901.1 (1_1); also elsewhere on the board

Notes on the sheet:
Programming; trace via RTT/USB CDC.
J901 probe <-> MCU
External and MCU reset path.
Spare; console on USB CDC.
R401 pad 1 at U401 pin 94
Purpose
PWR
RECORD+MARK chord / USB
LOCAL
Board -> probe voltage sense
NRST
Programming and service
+3V3_D / GND
SWD POGO / SERVICE ONLY
3.3V logic reference; avoid backpower.
Disconnect during exposure
DFU entry
PA9 / PA10 (ex-UART1)
I/O
Module interfaces
SWCLK / SWDIO (SWO NC)
OUT / I/O
Source / destination
J901 <-> MCU
Signal / bus
BOOT0
Bench recovery: strap to +3V3_D.
none (J7 removed)
Boot stub jumps to ROM DFU.

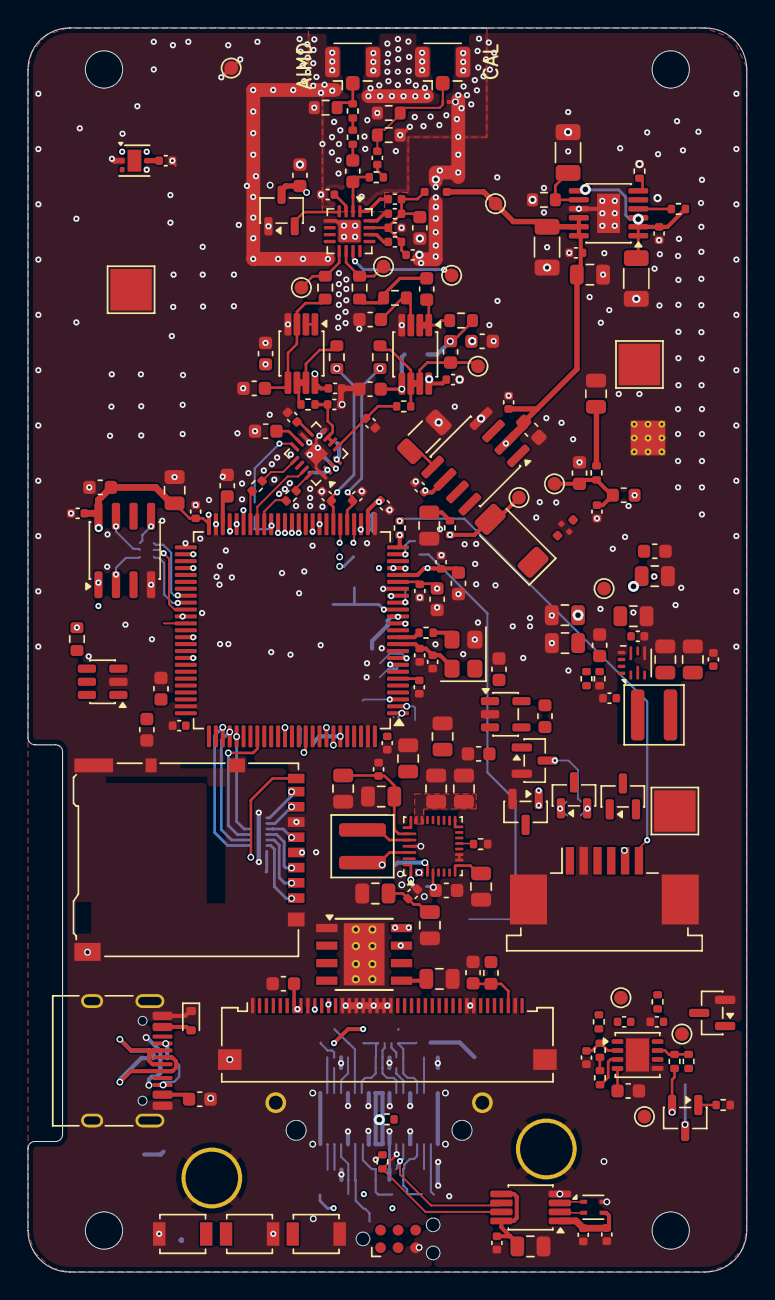
[picture p84: board Hardware/RFVD_SENSOR_BOARD_Rev6/RFVD_SENSOR_BOARD.kicad_pcb from above]

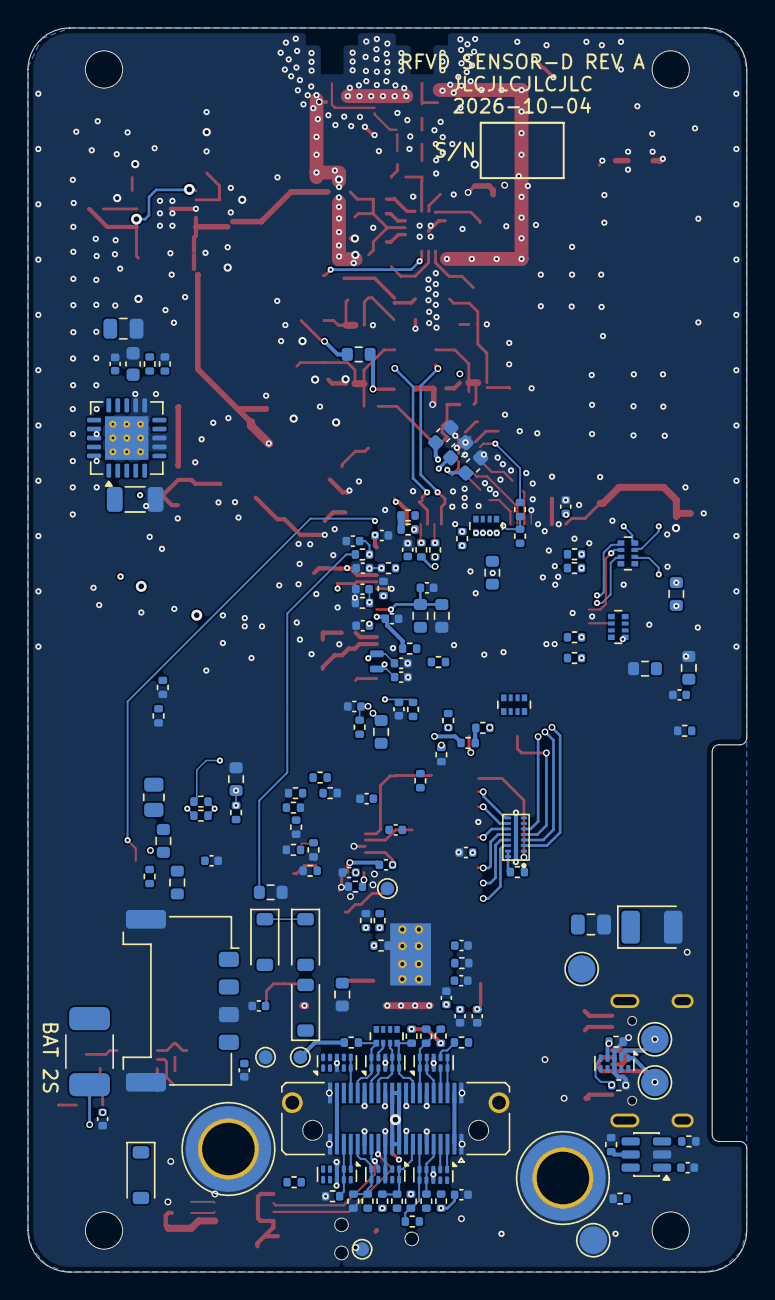
[picture p85: board Hardware/RFVD_SENSOR_BOARD_Rev6/RFVD_SENSOR_BOARD.kicad_pcb from below]

Board: 6 copper layers, 52.0 x 90.0 mm, 348 parts (153 on the bottom side), 230 nets.

Other parts of the board:
H1, H2, H3, H4: MountingHole_2.7mm
