Able-Digital-Logic/UnintendedAntennaClub3/Hardware/RFVD_SENSOR_BOARD_Rev3/RFVD_SENSOR_BOARD.kicad_pcb

## KiCad design Hardware/RFVD_SENSOR_BOARD_Rev3/RFVD_SENSOR_BOARD.kicad_pcb (2026-09-29, an earlier design)

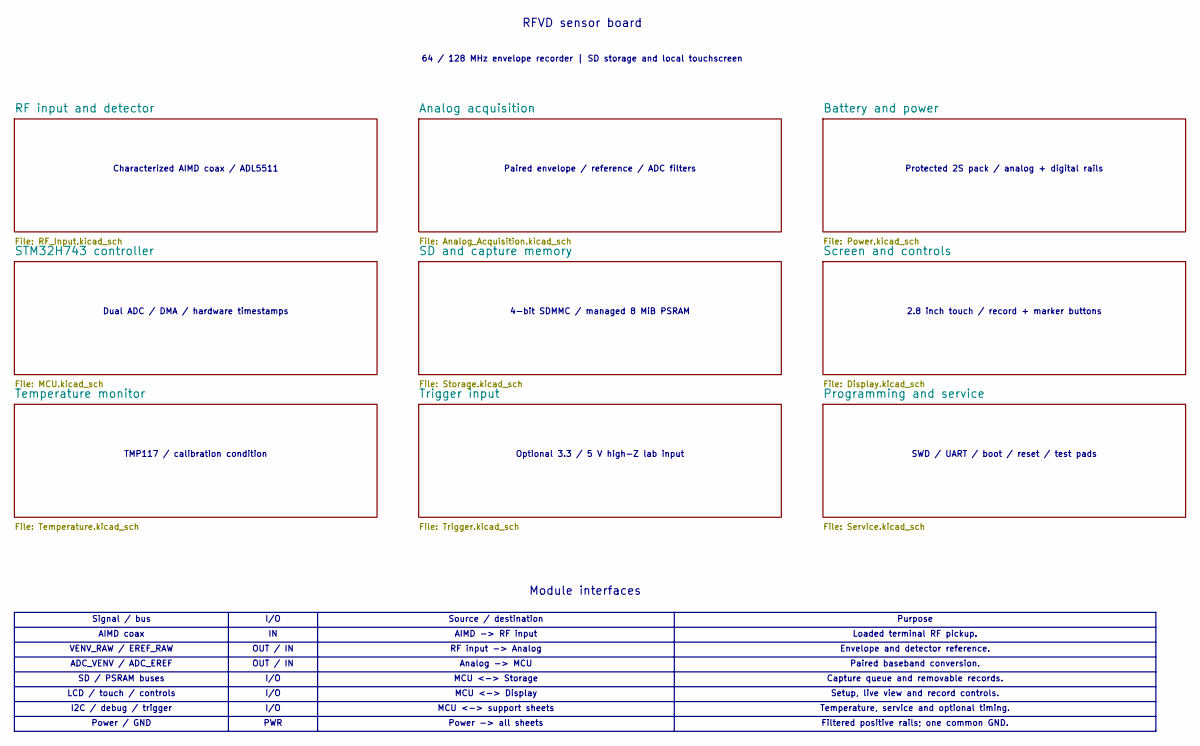
[picture p86: schematic RFVD_SENSOR_BOARD.kicad_sch, RFVD sensor board]

Notes on the sheet:
I/O
RFVD sensor board
MCU <-> Storage
AIMD coax
4-bit SDMMC / managed 8 MiB PSRAM
AIMD -> RF input
64 / 128 MHz envelope recorder | SD storage and local touchscreen
Source / destination
SD / PSRAM buses
Dual ADC / DMA / hardware timestamps
Loaded terminal RF pickup.
Temperature, service and optional timing.
VENV_RAW / EREF_RAW
TMP117 / calibration condition
Optional 3.3 / 5 V high-Z lab input
Characterized AIMD coax / ADL5511
Filtered positive rails; one common GND.
MCU <-> support sheets
Power / GND
2.8 inch touch / record + marker buttons
Protected 2S pack / analog + digital rails
I2C / debug / trigger
Purpose
Paired envelope / reference / ADC filters
Envelope and detector reference.
MCU <-> Display
OUT / IN
ADC_VENV / ADC_EREF
Capture queue and removable records.
Analog -> MCU
Setup, live view and record controls.
Paired baseband conversion.
PWR
Signal / bus
LCD / touch / controls
SWD / UART / boot / reset / test pads
Module interfaces
RF input -> Analog
Power -> all sheets

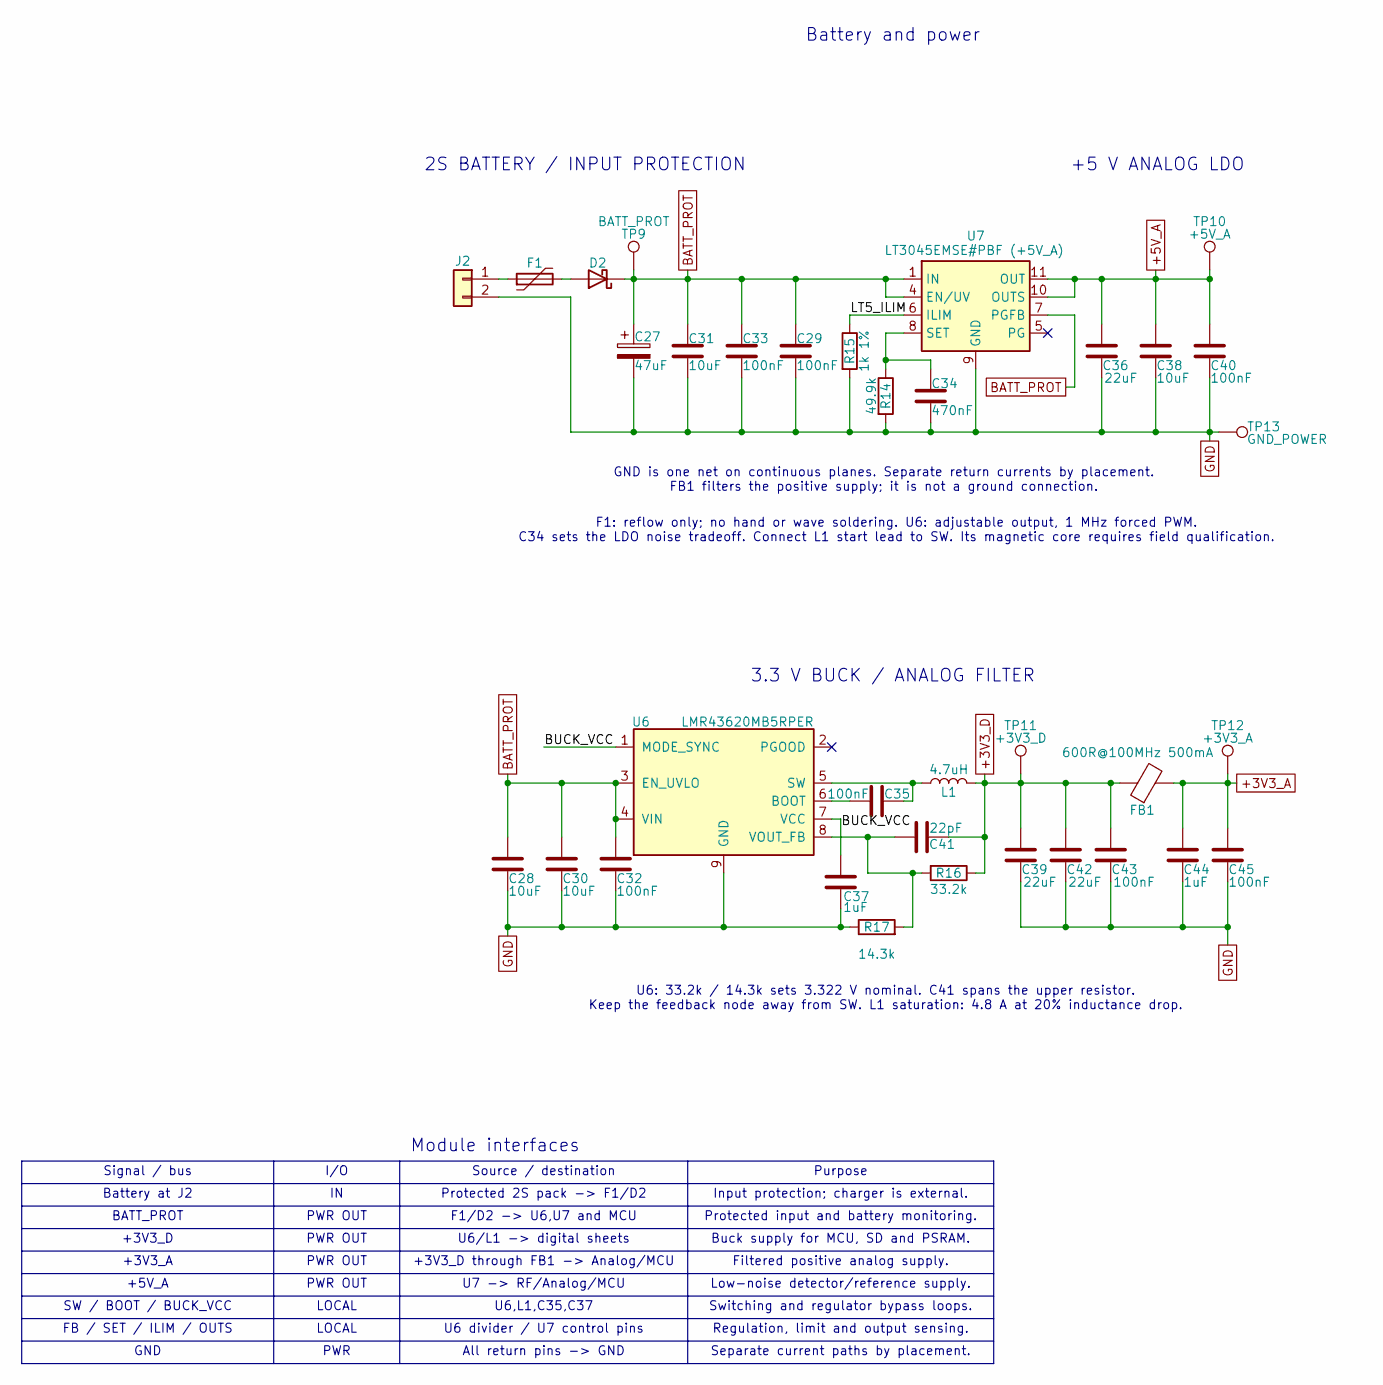
[picture p87: schematic Power.kicad_sch, Battery and power]

Parts:
C27: 47uF; CP_EIA-6032-28_Kemet-C; MPN TAJC476K020RNJ; LCSC C145123
C28, C30, C38: 10uF; C_0805_2012Metric; MPN CL21B106KOQNNNE; LCSC C95841
C29, C40, C45: 100nF; C_0402_1005Metric; MPN GRM155R71E104KE14D; LCSC C77014
C31: 10uF; C_1206_3216Metric; MPN CL31B106KOHNNNE; LCSC C47971
C32, C33, C35, C43: 100nF; C_0603_1608Metric; MPN CC0603KRX7R9BB104; LCSC C14663
C34: 470nF; C_1206_3216Metric; MPN 35MU474KA13216; LCSC C3773390
C36: 22uF; C_1206_3216Metric; MPN CL31A226KAHNNNE; LCSC C12891
C37, C44: 1uF; C_0603_1608Metric; MPN CL10B105KA8NNNC; LCSC C29936
C39, C42: 22uF; C_0805_2012Metric; MPN CL21A226MPQNNNE; LCSC C29277
C41: 22pF; C_0402_1005Metric; MPN GRM1555C1H220JA01D; JLCPCB_PN C76960
D2: 60V 3A Schottky; D_SOD-128; MPN PMEG6030EP,115; JLCPCB_PN C456127
F1: 1.1A hold 16V PTC; Fuse_1812_4532Metric; MPN MF-MSMF110/16-2; JLCPCB_PN C210834
FB1: 600R@100MHz 500mA; L_0603_1608Metric; MPN BLM18AG601SN1D; LCSC C19330
J2: B2B-PH-K-S(LF)(SN) 2S BATTERY; JST_PH_B2B-PH-K_1x02_P2.00mm_Vertical; MPN B2B-PH-K-S(LF)(SN); LCSC C131337
L1: 4.7uH; L_Coilcraft_XAL5030-XXX; MPN XGL5030-472MEC; LCSC C3911503
R14: 49.9k; R_0603_1608Metric; MPN ERA3AEB4992V; LCSC C491136
R15: 1k 1%; R_0402_1005Metric; MPN RC0402FR-071KL; LCSC C106235
R16: 33.2k; R_0402_1005Metric; MPN RC0402FR-0733K2L; JLCPCB_PN C130276
R17: 14.3k; R_0402_1005Metric; MPN RC0402FR-0714K3L; JLCPCB_PN C185465
TP9: BATT_PROT; TestPoint_Pad_D1.0mm; MPN PCB_PAD
TP10: +5V_A; TestPoint_Pad_D1.0mm; MPN DNP-NO-COMPONENT; LCSC N/A
TP11: +3V3_D; TestPoint_Pad_D1.0mm; MPN DNP-NO-COMPONENT; LCSC N/A
TP12: +3V3_A; TestPoint_Pad_D1.0mm; MPN DNP-NO-COMPONENT; LCSC N/A
TP13: GND_POWER; TestPoint_Pad_D1.0mm; MPN PCB_PAD
U6: LMR43620MB5RPER; TI_RPE0009B_VQFN-HR-9_2x2mm_Stencil; MPN LMR43620MB5RPER; JLCPCB_PN C22438086
U7: LT3045EMSE#PBF (+5V_A); MSOP-12-1EP_3x4.039mm_P0.65mm_EP1.651x2.845mm; MPN LT3045EMSE#PBF; JLCPCB_PN C580012

Connections:
+3V3_A: C44.1, C45.1, FB1.2, TP12.1; also elsewhere on the board
+3V3_D: C39.1, C41.2, C42.1, C43.1, FB1.1, L1.2, R16.1, TP11.1; also elsewhere on the board
+5V_A: C36.1, C38.1, C40.1, TP10.1, U7.10 (OUTS), U7.11 (OUT), U7.12 (OUT); also elsewhere on the board
/Battery and power/BUCK_VCC: C37.1, U6.1 (MODE_SYNC), U6.7 (VCC)
/Battery and power/LT5_ILIM: R15.1, U7.6 (ILIM)
BATT_PROT: C27.1, C28.1, C29.1, C30.1, C31.1, C32.1, C33.1, D2.1 (K), TP9.1, U6.3 (EN_UVLO), U6.4 (VIN), U7.1 (IN), U7.2 (IN), U7.3 (IN), U7.4 (EN/UV), U7.7 (PGFB); also elsewhere on the board
GND: C27.2, C28.2, C29.2, C30.2, C31.2, C32.2, C33.2, C34.2, C36.2, C37.2, C38.2, C39.2, C40.2, C42.2, C43.2, C44.2, C45.2, J2.2, R14.2, R15.2, R17.1, TP13.1, U6.9 (GND), U7.9 (GND), U7.13 (GND); also elsewhere on the board
unnamed: D2.2 (A), F1.2
unnamed: F1.1, J2.1
unnamed: C35.1, U6.6 (BOOT)
unnamed: C35.2, L1.1, U6.5 (SW)
unnamed: C41.1, R16.2, R17.2, U6.8 (VOUT_FB)
unnamed: C34.1, R14.1, U7.8 (SET)

Notes on the sheet:
+3V3_A
Input protection; charger is external.
2S BATTERY / INPUT PROTECTION
+3V3_D
GND
Buck supply for MCU, SD and PSRAM.
I/O
Battery and power
Battery at J2
LOCAL
BATT_PROT
U6 divider / U7 control pins
U7 -> RF/Analog/MCU
+3V3_D through FB1 -> Analog/MCU
F1: reflow only; no hand or wave soldering. U6: adjustable output, 1 MHz forced PWM. C34 sets the LDO noise tradeoff. Connect L1 start lead to SW. Its magnetic core requires field qualification.
Switching and regulator bypass loops.
Signal / bus
Module interfaces
All return pins -> GND
3.3 V BUCK / ANALOG FILTER
+5V_A
FB / SET / ILIM / OUTS
Separate current paths by placement.
SW / BOOT / BUCK_VCC
U6: 33.2k / 14.3k sets 3.322 V nominal. C41 spans the upper resistor. Keep the feedback node away from SW. L1 saturation: 4.8 A at 20% inductance drop.
PWR OUT
+5 V ANALOG LDO
U6,L1,C35,C37
Protected input and battery monitoring.
GND is one net on continuous planes. Separate return currents by placement. FB1 filters the positive supply; it is not a ground connection.
Source / destination
F1/D2 -> U6,U7 and MCU
Low-noise detector/reference supply.
Regulation, limit and output sensing.
Filtered positive analog supply.
U6/L1 -> digital sheets
Protected 2S pack -> F1/D2
PWR
Purpose

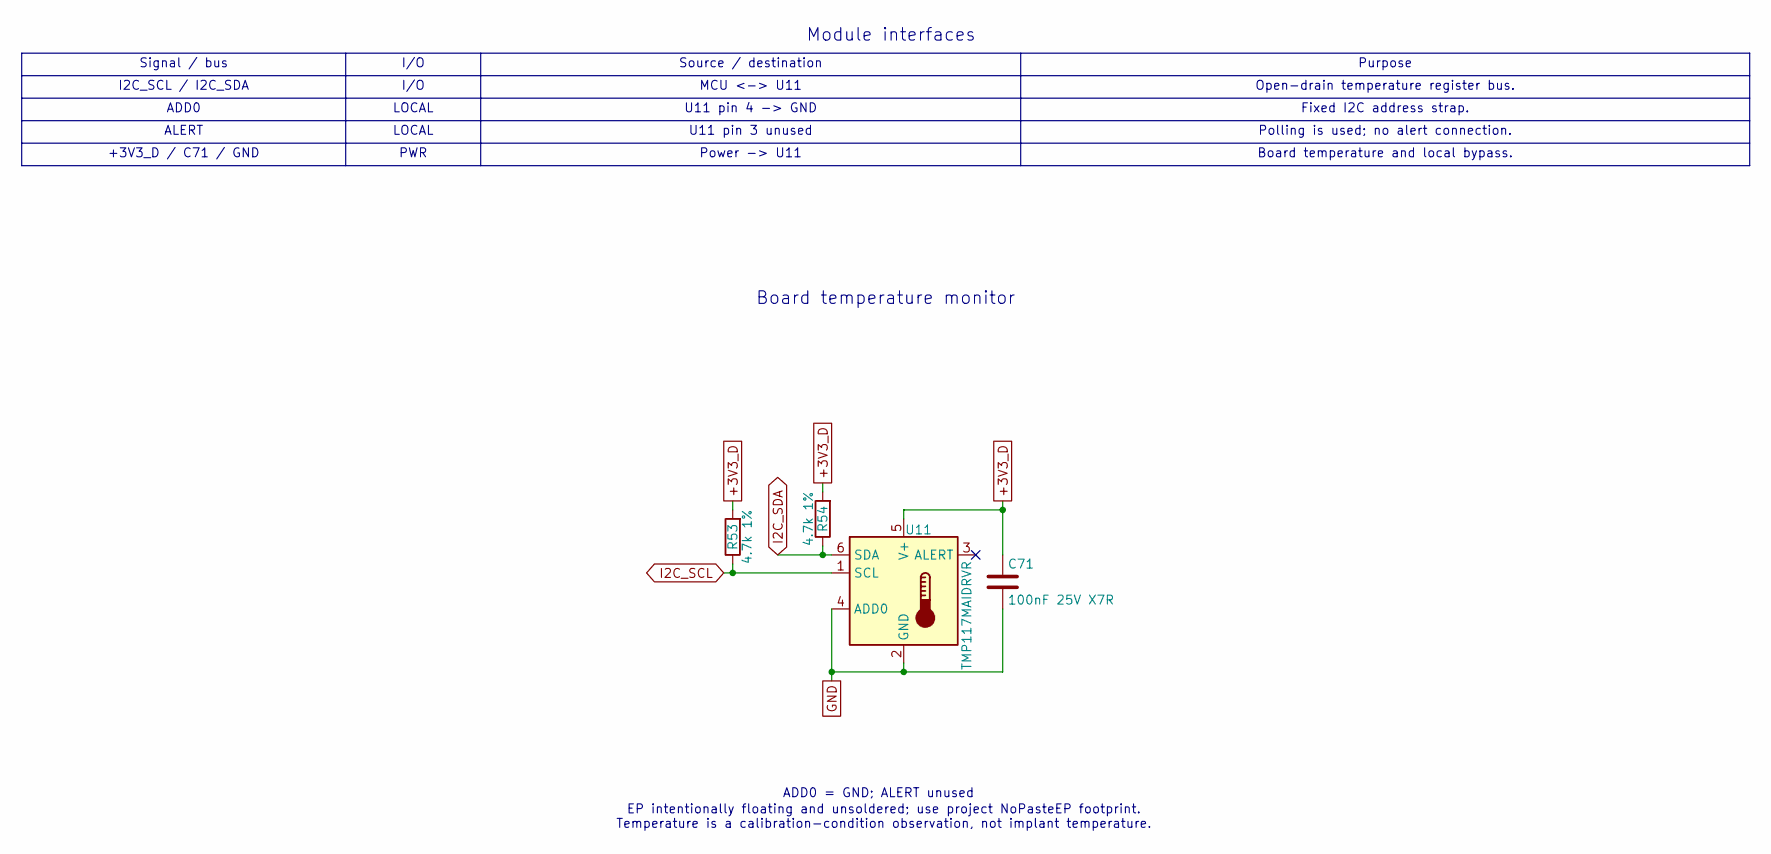
[picture p88: schematic Temperature.kicad_sch, Board temperature monitor]

Parts:
C71: 100nF 25V X7R; C_0402_1005Metric; MPN GRM155R71E104KE14D; LCSC C77014
R53, R54: 4.7k 1%; R_0402_1005Metric; MPN RC0402FR-074K7L; LCSC C105871
U11: TMP117MAIDRVR; TMP117_DRV_WSON6_NoPasteEP; MPN TMP117MAIDRVR; JLCPCB_PN C2803242

Connections:
+3V3_D: C71.1, R53.2, R54.2, U11.5 (V+); also elsewhere on the board
GND: C71.2, U11.2 (GND), U11.4 (ADD0); also elsewhere on the board
I2C_SCL: R53.1, U11.1 (SCL); also elsewhere on the board
I2C_SDA: R54.1, U11.6 (SDA); also elsewhere on the board

Notes on the sheet:
I2C_SCL / I2C_SDA
Fixed I2C address strap.
MCU <-> U11
Board temperature and local bypass.
LOCAL
U11 pin 3 unused
Board temperature monitor
ADD0 = GND; ALERT unused
Source / destination
ALERT
U11 pin 4 -> GND
PWR
Open-drain temperature register bus.
+3V3_D / C71 / GND
ADD0
EP intentionally floating and unsoldered; use project NoPasteEP footprint. Temperature is a calibration-condition observation, not implant temperature.
Module interfaces
Purpose
Signal / bus
Polling is used; no alert connection.
I/O
Power -> U11

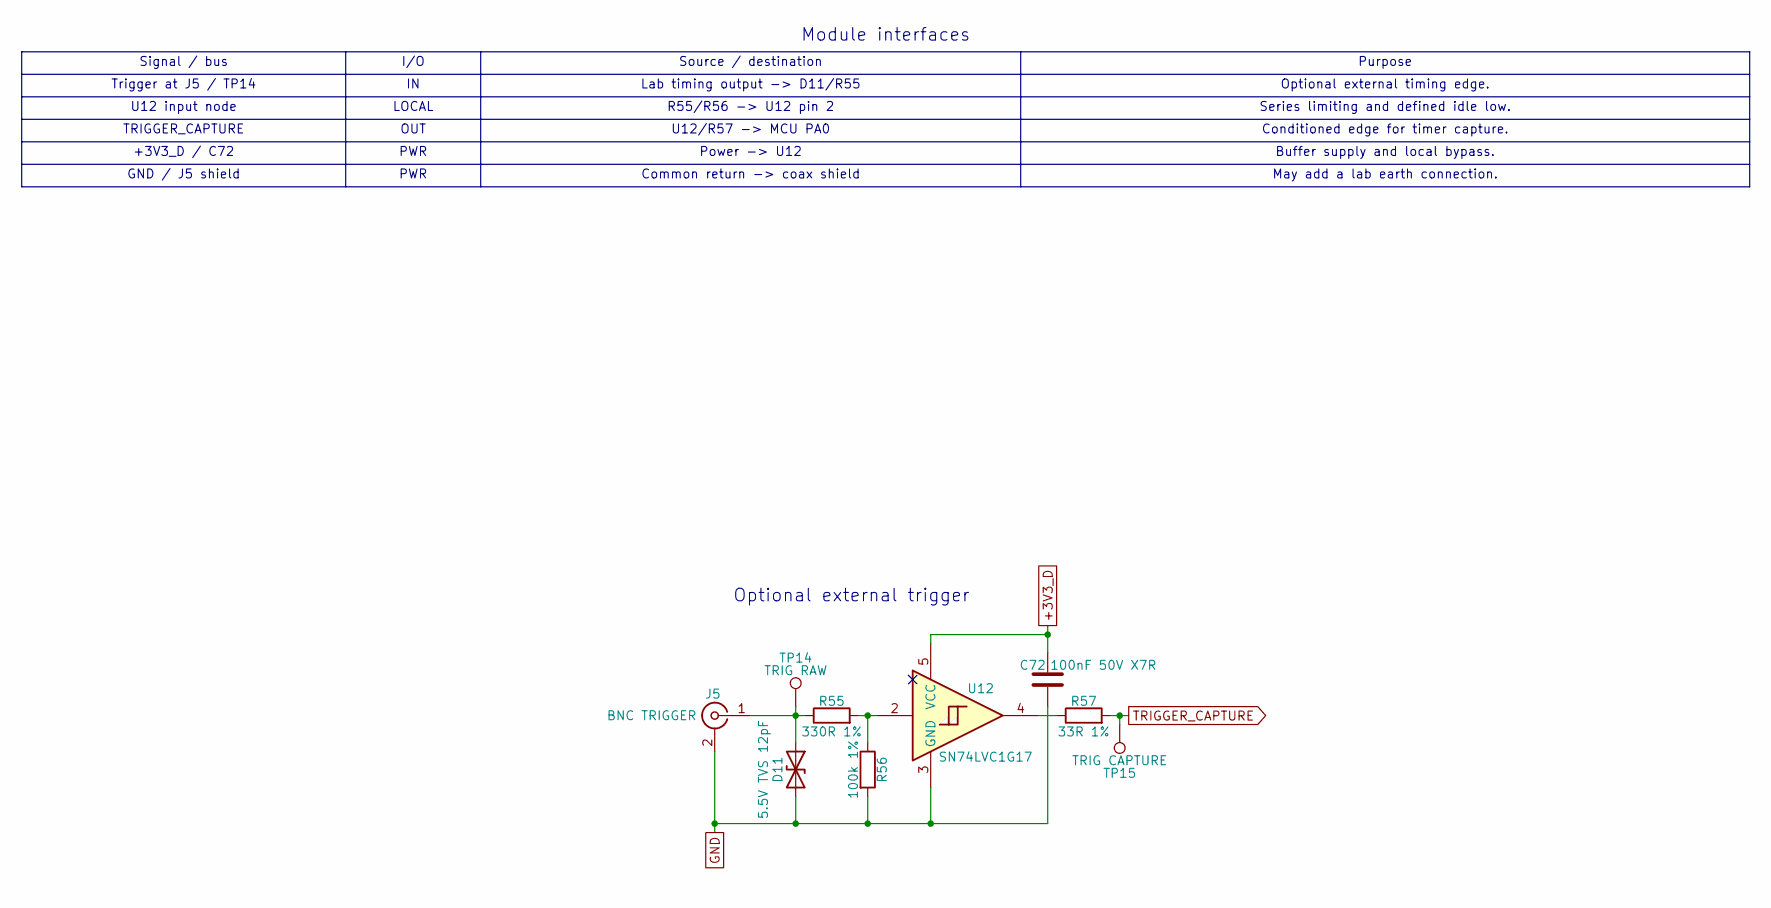
[picture p89: schematic Trigger.kicad_sch, Optional external trigger]

Parts:
C72: 100nF 50V X7R; C_0603_1608Metric; MPN CC0603KRX7R9BB104; LCSC C14663
D11: 5.5V TVS 12pF; D_SOD-523; MPN TPD1E10B06DYAR; JLCPCB_PN C3712135
J5: BNC TRIGGER; BNC_Amphenol_031-5539_Vertical; MPN 031-5539
R55: 330R 1%; R_0402_1005Metric; MPN RC0402FR-07330RL; JLCPCB_PN C105875
R56: 100k 1%; R_0402_1005Metric; MPN RC0402FR-07100KL; JLCPCB_PN C60491
R57: 33R 1%; R_0402_1005Metric; MPN RC0402FR-0733RL; JLCPCB_PN C138002
TP14: TRIG RAW; TestPoint_Pad_D1.0mm; MPN DNP-NO-COMPONENT; LCSC N/A
TP15: TRIG CAPTURE; TestPoint_Pad_D1.0mm; MPN DNP-NO-COMPONENT; LCSC N/A
U12: SN74LVC1G17; SOT-23-5; MPN SN74LVC1G17DBVR; JLCPCB_PN C19829662

Connections:
unnamed: C72.1, U12.5 (VCC)
unnamed: C72.2, D11.2 (A2), J5.2 (Ext), R56.2, U12.3 (GND)
unnamed: D11.1 (A1), J5.1 (In), R55.1, TP14.1
unnamed: R55.2, R56.1, U12.2
unnamed: R57.1, U12.4
unnamed: R57.2, TP15.1

Notes on the sheet:
Module interfaces
Optional external timing edge.
U12/R57 -> MCU PA0
Common return -> coax shield
Optional external trigger
I/O
Conditioned edge for timer capture.
LOCAL
TRIGGER_CAPTURE
U12 input node
Purpose
Buffer supply and local bypass.
PWR
R55/R56 -> U12 pin 2
Signal / bus
Trigger at J5 / TP14
Source / destination
GND / J5 shield
Lab timing output -> D11/R55
May add a lab earth connection.
Power -> U12
OUT
Series limiting and defined idle low.
+3V3_D / C72

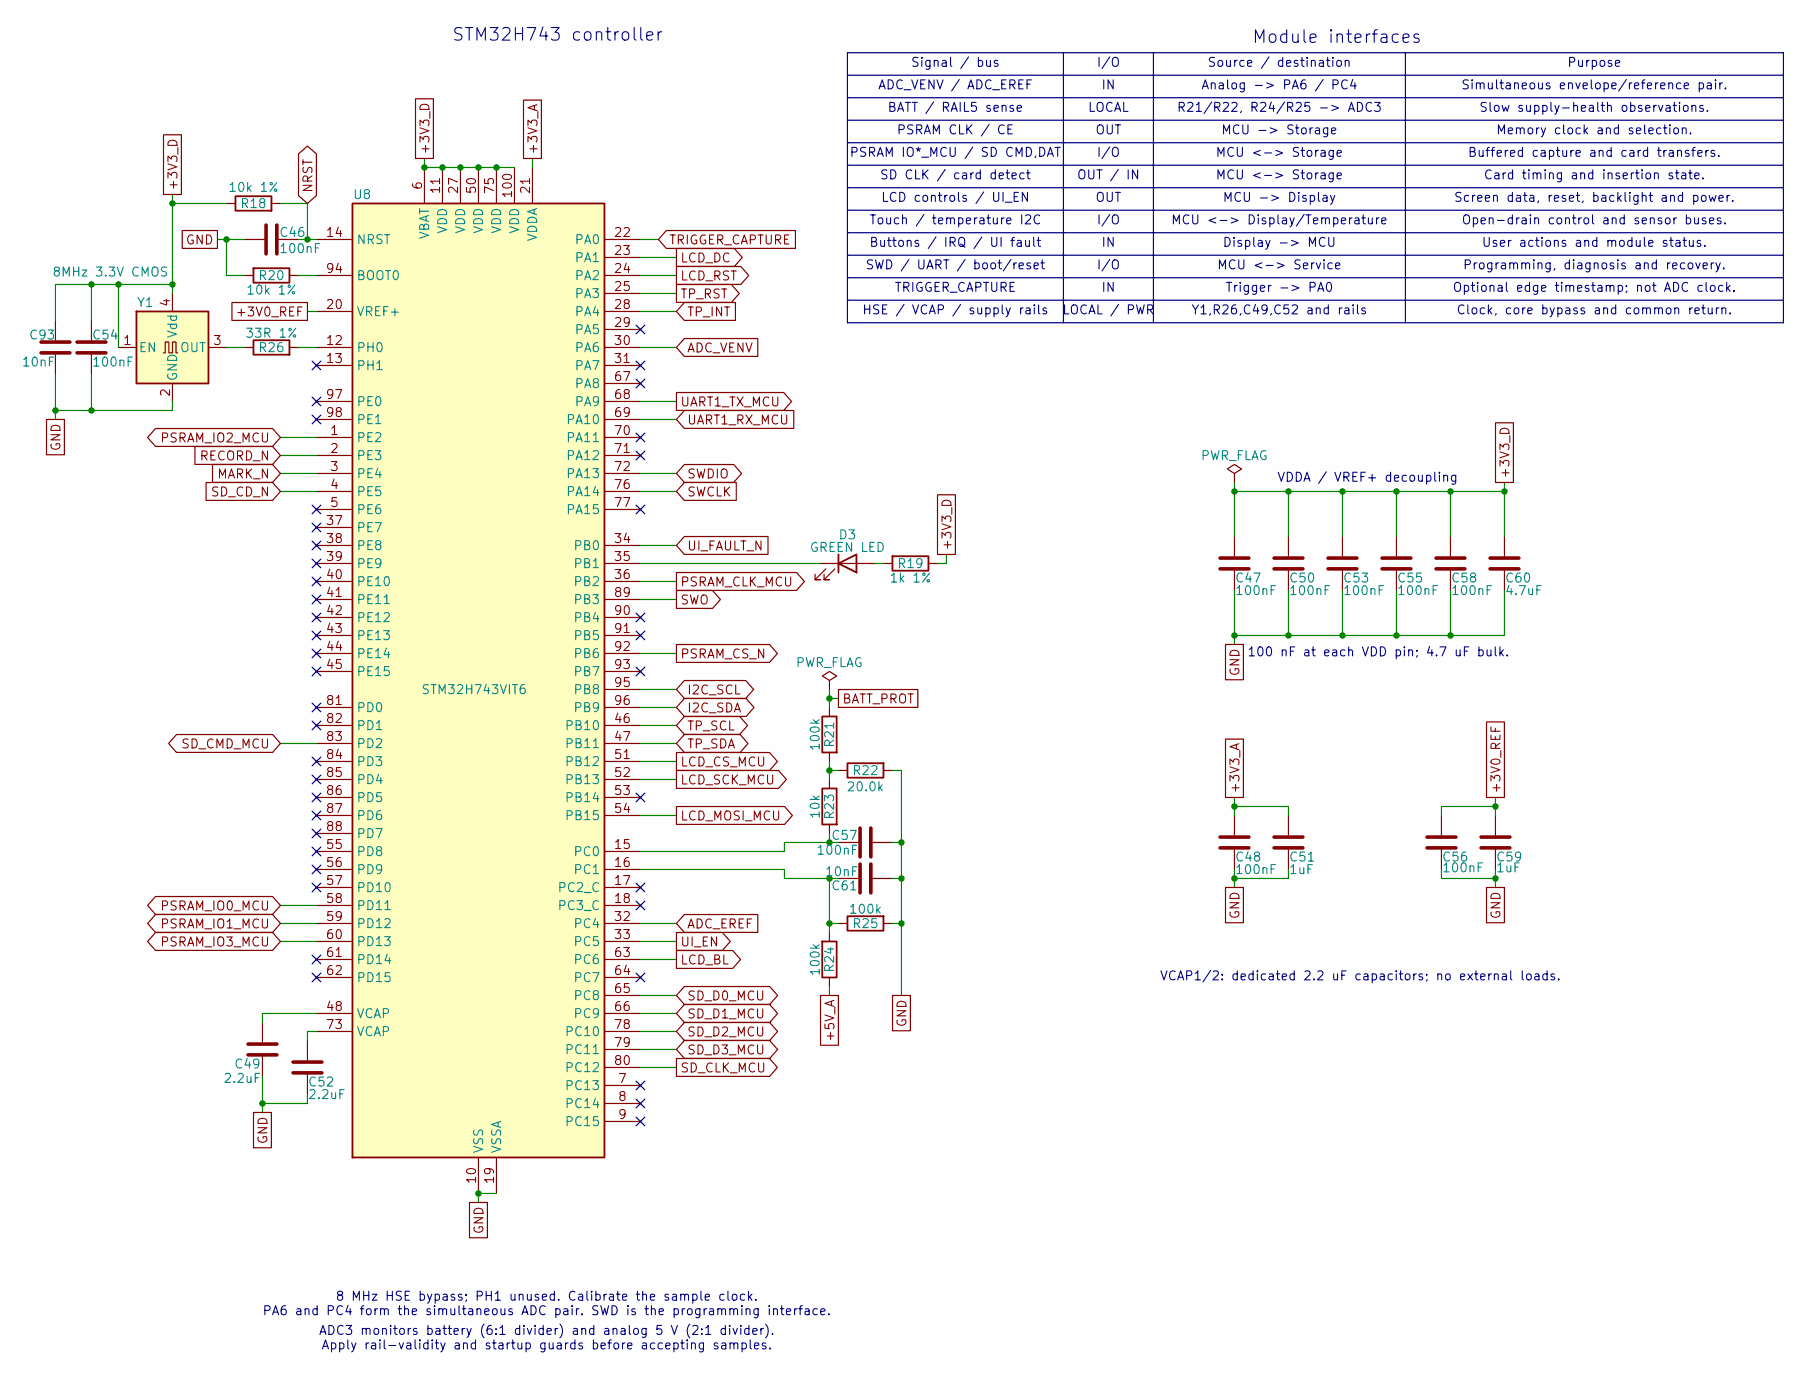
[picture p90: schematic MCU.kicad_sch, STM32H743 controller]

Parts:
C46, C47, C48, C50, C53, C55, C56: 100nF; C_0402_1005Metric; MPN GRM155R71E104KE14D; LCSC C77014
C49, C52: 2.2uF; C_0603_1608Metric; MPN GRM188R61A225KE34D; JLCPCB_PN C86013
C51, C59: 1uF; C_0603_1608Metric; MPN CL10B105KA8NNNC; LCSC C29936
C54, C58: 100nF; C_0402_1005Metric; MPN GRM155R71E104KE14D; JLCPCB_PN C77014
C57: 100nF; C_0603_1608Metric; MPN CC0603KRX7R9BB104; LCSC C14663
C60: 4.7uF; C_0603_1608Metric; MPN GRM188Z71C475KE21D; LCSC C389010
C61, C93: 10nF; C_0603_1608Metric; MPN GRM188R71H103KA01D; JLCPCB_PN C77053
D3: GREEN LED; LED_0603_1608Metric; MPN LTST-C190KGKT; LCSC C125094
R18, R20: 10k 1%; R_0402_1005Metric; MPN RC0402FR-0710KL; LCSC C60490
R19: 1k 1%; R_0402_1005Metric; MPN RC0402FR-071KL; LCSC C106235
R21: 100k; R_0603_1608Metric; MPN ERA-3AEB104V; LCSC_PN C190609
R22: 20.0k; R_0603_1608Metric; MPN ERA3AEB203V; JLCPCB_PN C190611
R23: 10k; R_0603_1608Metric; MPN RC0603FR-0710KL; JLCPCB_PN C98220
R24, R25: 100k; R_0603_1608Metric; MPN RC0603FR-07100KL; JLCPCB_PN C14675
R26: 33R 1%; R_0603_1608Metric; MPN RC0603FR-0733RL; JLCPCB_PN C108661
U8: STM32H743VIT6; LQFP-100_14x14mm_P0.5mm; MPN STM32H743VIT6; JLCPCB_PN C114409
Y1: 8MHz 3.3V CMOS; Oscillator_SMD_Abracon_ASE-4Pin_3.2x2.5mm; MPN ASE-8.000MHZ-L-C-T

Connections:
+3V0_REF: C56.1, C59.1, U8.20 (VREF+); also elsewhere on the board
+3V3_A: C48.1, C51.1, U8.21 (VDDA); also elsewhere on the board
+3V3_D: C47.1, C50.1, C53.1, C54.1, C55.1, C58.1, C60.1, C93.1, R18.1, R19.1, U8.6 (VBAT), U8.11 (VDD), U8.27 (VDD), U8.50 (VDD), U8.75 (VDD), U8.100 (VDD), Y1.1 (EN), Y1.4 (Vdd); also elsewhere on the board
+5V_A: R24.1; also elsewhere on the board
BATT_PROT: R21.1; also elsewhere on the board
GND: C46.2, C47.2, C48.2, C49.2, C50.2, C51.2, C52.2, C53.2, C54.2, C55.2, C56.2, C57.2, C58.2, C59.2, C60.2, C61.2, C93.2, R20.2, R22.2, R25.2, U8.10 (VSS), U8.19 (VSSA), U8.26 (VSS), U8.49 (VSS), U8.74 (VSS), U8.99 (VSS), Y1.2 (GND); also elsewhere on the board
I2C_SCL: U8.95 (PB8); also elsewhere on the board
I2C_SDA: U8.96 (PB9); also elsewhere on the board
LCD_BL: U8.63 (PC6); also elsewhere on the board
LCD_CS_MCU: U8.51 (PB12); also elsewhere on the board
LCD_DC: U8.23 (PA1); also elsewhere on the board
LCD_MOSI_MCU: U8.54 (PB15); also elsewhere on the board
LCD_RST: U8.24 (PA2); also elsewhere on the board
LCD_SCK_MCU: U8.52 (PB13); also elsewhere on the board
MARK_N: U8.3 (PE4); also elsewhere on the board
NRST: C46.1, R18.2, U8.14 (NRST); also elsewhere on the board
unnamed: C49.1, U8.48 (VCAP)
unnamed: C52.1, U8.73 (VCAP)
unnamed: D3.2 (A), R19.2
unnamed: D3.1 (K), U8.35 (PB1)
unnamed: R21.2, R22.1, R23.1
unnamed: C57.1, R23.2, U8.15 (PC0)
unnamed: C61.1, R24.2, R25.1, U8.16 (PC1)
unnamed: R26.2, U8.12 (PH0)
unnamed: R26.1, Y1.3 (OUT)
PSRAM_CLK_MCU: U8.36 (PB2); also elsewhere on the board
PSRAM_CS_N: U8.92 (PB6); also elsewhere on the board
PSRAM_IO0_MCU: U8.58 (PD11); also elsewhere on the board
PSRAM_IO1_MCU: U8.59 (PD12); also elsewhere on the board
PSRAM_IO2_MCU: U8.1 (PE2); also elsewhere on the board
PSRAM_IO3_MCU: U8.60 (PD13); also elsewhere on the board
RECORD_N: U8.2 (PE3); also elsewhere on the board
SD_CD_N: U8.4 (PE5); also elsewhere on the board
SD_CLK_MCU: U8.80 (PC12); also elsewhere on the board
SD_CMD_MCU: U8.83 (PD2); also elsewhere on the board
SD_D0_MCU: U8.65 (PC8); also elsewhere on the board
SD_D1_MCU: U8.66 (PC9); also elsewhere on the board
SD_D2_MCU: U8.78 (PC10); also elsewhere on the board
SD_D3_MCU: U8.79 (PC11); also elsewhere on the board
SWCLK: U8.76 (PA14); also elsewhere on the board
SWDIO: U8.72 (PA13); also elsewhere on the board
SWO: U8.89 (PB3); also elsewhere on the board
TP_INT: U8.28 (PA4); also elsewhere on the board
TP_RST: U8.25 (PA3); also elsewhere on the board
TP_SCL: U8.46 (PB10); also elsewhere on the board
TP_SDA: U8.47 (PB11); also elsewhere on the board
TRIGGER_CAPTURE: U8.22 (PA0)
UART1_RX_MCU: U8.69 (PA10); also elsewhere on the board
UART1_TX_MCU: U8.68 (PA9); also elsewhere on the board
UI_EN: U8.33 (PC5); also elsewhere on the board
UI_FAULT_N: U8.34 (PB0); also elsewhere on the board

Notes on the sheet:
MCU <-> Service
I/O
Signal / bus
Memory clock and selection.
Optional edge timestamp; not ADC clock.
SWD / UART / boot/reset
Y1,R26,C49,C52 and rails
MCU <-> Storage
Purpose
Source / destination
ADC_VENV / ADC_EREF
MCU -> Storage
Analog -> PA6 / PC4
OUT
ADC3 monitors battery (6:1 divider) and analog 5 V (2:1 divider). Apply rail-validity and startup guards before accepting samples.
Module interfaces
User actions and module status.
VDDA / VREF+ decoupling
LOCAL / PWR
PSRAM IO*_MCU / SD CMD,DAT
R21/R22, R24/R25 -> ADC3
Open-drain control and sensor buses.
Programming, diagnosis and recovery.
8 MHz HSE bypass; PH1 unused. Calibrate the sample clock. PA6 and PC4 form the simultaneous ADC pair. SWD is the programming interface.
TRIGGER_CAPTURE
Screen data, reset, backlight and power.
SD CLK / card detect
LCD controls / UI_EN
Buffered capture and card transfers.
OUT / IN
PSRAM CLK / CE
VCAP1/2: dedicated 2.2 uF capacitors; no external loads.
Buttons / IRQ / UI fault
BATT / RAIL5 sense
Slow supply-health observations.
HSE / VCAP / supply rails
Clock, core bypass and common return.
LOCAL
MCU <-> Display/Temperature
MCU -> Display
Trigger -> PA0
Touch / temperature I2C
Card timing and insertion state.
Display -> MCU
STM32H743 controller
Simultaneous envelope/reference pair.
100 nF at each VDD pin; 4.7 uF bulk.
