Able-Digital-Logic/UnintendedAntennaClub3/Hardware/RFVD_SENSOR_BOARD_Rev3/RFVD_SENSOR_BOARD.kicad_pcb

## KiCad design Hardware/RFVD_SENSOR_BOARD_Rev3/RFVD_SENSOR_BOARD.kicad_pcb (continued)

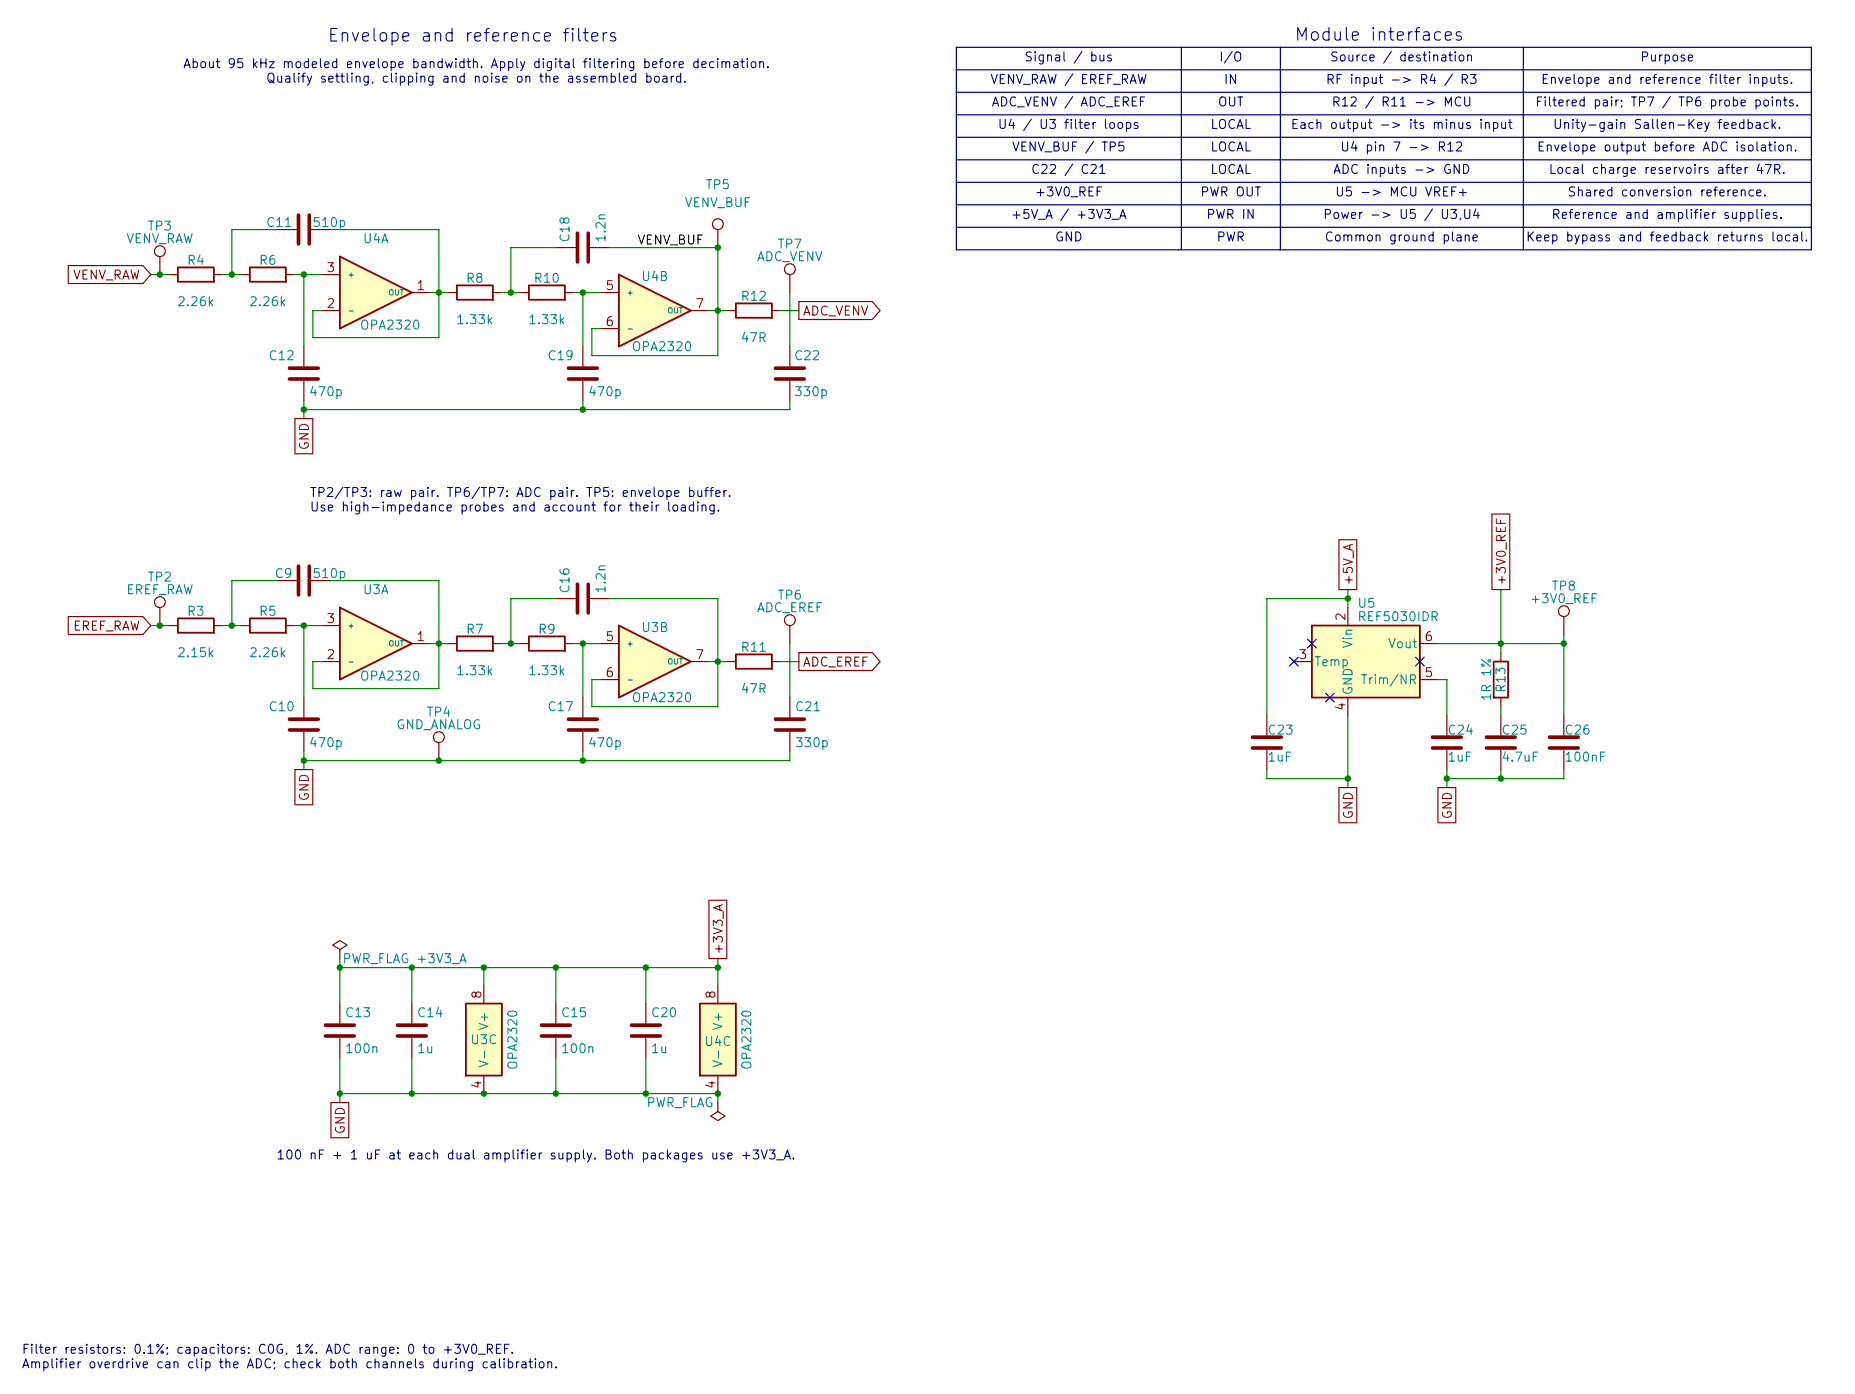
[picture p91: schematic Analog_Acquisition.kicad_sch, Envelope and reference filters]

Parts:
C9, C11: 510p; C_0603_1608Metric; Tolerance 1%; Voltage Rating 50V; MPN CC0603FRNPO9BN511; JLCPCB_PN C519572
C10, C12, C17, C19: 470p; C_0603_1608Metric; Tolerance 1%; Voltage Rating 50V; MPN CC0603FRNPO9BN471; JLCPCB_PN C519564
C13: 100n; C_0402_1005Metric; MPN GRM155R71E104KE14D; LCSC C77014
C14, C20: 1u; C_0603_1608Metric; Tolerance 10%; Voltage Rating 25V; MPN CL10B105KA8NNNC; JLCPCB_PN C29936
C15: 100n; C_0603_1608Metric; Tolerance 10%; Voltage Rating 50V; MPN CC0603KRX7R9BB104; JLCPCB_PN C14663
C16, C18: 1.2n; C_0603_1608Metric; Tolerance 1%; Voltage Rating 50V; MPN GCM1885C1H122FA16D; JLCPCB_PN C1517816
C21, C22: 330p; C_0603_1608Metric; Tolerance 1%; Voltage Rating 50V; MPN CC0603FRNPO9BN331; JLCPCB_PN C519562
C23, C24: 1uF; C_0603_1608Metric; MPN CL10B105KA8NNNC; LCSC C29936
C25: 4.7uF; C_0805_2012Metric; MPN C2012X7R1E475KT000N; LCSC C76642
C26: 100nF; C_0402_1005Metric; MPN GRM155R71E104KE14D; LCSC C77014
R3: 2.15k; R_0603_1608Metric; Tolerance 0.1%; Power Rating 0.1W at 70C; MPN RT0603BRD072K15L; JLCPCB_PN C861292
R4, R5, R6: 2.26k; R_0603_1608Metric; Tolerance 0.1%; Power Rating 0.1W at 70C; MPN RT0603BRD072K26L; JLCPCB_PN C861294
R7, R8, R9, R10: 1.33k; R_0603_1608Metric; Tolerance 0.1%; Power Rating 0.1W at 70C; MPN RT0603BRD071K33L; JLCPCB_PN C861196
R11, R12: 47R; R_0603_1608Metric; Tolerance 0.1%; Power Rating 0.1W at 70C; MPN RT0603BRD0747RL; JLCPCB_PN C326724
R13: 1R 1%; R_0402_1005Metric; MPN RC0402FR-071RL; LCSC C185446
TP2: EREF_RAW; TestPoint_Pad_D1.0mm; MPN DNP-NO-COMPONENT; LCSC N/A
TP3: VENV_RAW; TestPoint_Pad_D1.0mm; MPN DNP-NO-COMPONENT; LCSC N/A
TP4: GND_ANALOG; TestPoint_Pad_D1.0mm; MPN PCB_PAD
TP5: VENV_BUF; TestPoint_Pad_D1.0mm; MPN PCB_PAD
TP6: ADC_EREF; TestPoint_Pad_D1.0mm; MPN PCB_PAD
TP7: ADC_VENV; TestPoint_Pad_D1.0mm; MPN PCB_PAD
TP8: +3V0_REF; TestPoint_Pad_D1.0mm; MPN DNP-NO-COMPONENT; LCSC N/A
U3, U4: OPA2320; VSSOP-8_3x3mm_P0.65mm; MPN OPA2320AQDGKRQ1; LCSC C189188
U5: REF5030IDR; SOIC-8_3.9x4.9mm_P1.27mm; MPN REF5030IDR; LCSC C2878155

Connections:
+3V0_REF: C26.1, R13.1, TP8.1, U5.6 (Vout); also elsewhere on the board
+3V3_A: C13.1, C14.1, C15.1, C20.1, U3.8 (V+), U4.8 (V+); also elsewhere on the board
+5V_A: C23.1, U5.2 (Vin); also elsewhere on the board
/Analog acquisition/VENV_BUF: C18.2, R12.1, TP5.1, U4.6 (-), U4.7 (OUT)
EREF_RAW: R3.1, TP2.1; also elsewhere on the board
GND: C10.2, C12.2, C13.2, C14.2, C15.2, C17.2, C19.2, C20.2, C21.2, C22.2, C23.2, C24.2, C25.2, C26.2, TP4.1, U3.4 (V-), U4.4 (V-), U5.4 (GND); also elsewhere on the board
unnamed: C9.1, R3.2, R5.1
unnamed: C11.1, R4.2, R6.1
unnamed: C16.1, R7.2, R9.1
unnamed: C18.1, R8.2, R10.1
unnamed: C25.1, R13.2
unnamed: C10.1, R5.2, U3.3 (+)
unnamed: C9.2, R7.1, U3.1 (OUT), U3.2 (-)
unnamed: C17.1, R9.2, U3.5 (+)
unnamed: C16.2, R11.1, U3.6 (-), U3.7 (OUT)
unnamed: C12.1, R6.2, U4.3 (+)
unnamed: C11.2, R8.1, U4.1 (OUT), U4.2 (-)
unnamed: C19.1, R10.2, U4.5 (+)
unnamed: C24.1, U5.5 (Trim/NR)
VENV_RAW: R4.1, TP3.1; also elsewhere on the board

Notes on the sheet:
Filter resistors: 0.1%; capacitors: C0G, 1%. ADC range: 0 to +3V0_REF. Amplifier overdrive can clip the ADC; check both channels during calibration.
Purpose
C22 / C21
VENV_BUF / TP5
LOCAL
Reference and amplifier supplies.
U5 -> MCU VREF+
R12 / R11 -> MCU
PWR
VENV_RAW / EREF_RAW
Envelope and reference filter inputs.
+3V0_REF
Signal / bus
Power -> U5 / U3,U4
PWR IN
Shared conversion reference.
Common ground plane
U4 pin 7 -> R12
GND
Envelope output before ADC isolation.
I/O
TP2/TP3: raw pair. TP6/TP7: ADC pair. TP5: envelope buffer. Use high-impedance probes and account for their loading.
Filtered pair; TP7 / TP6 probe points.
Module interfaces
ADC_VENV / ADC_EREF
RF input -> R4 / R3
Envelope and reference filters
Unity-gain Sallen-Key feedback.
ADC inputs -> GND
About 95 kHz modeled envelope bandwidth. Apply digital filtering before decimation. Qualify settling, clipping and noise on the assembled board.
Each output -> its minus input
PWR OUT
U4 / U3 filter loops
Local charge reservoirs after 47R.
OUT
Keep bypass and feedback returns local.
100 nF + 1 uF at each dual amplifier supply. Both packages use +3V3_A.
Source / destination
+5V_A / +3V3_A

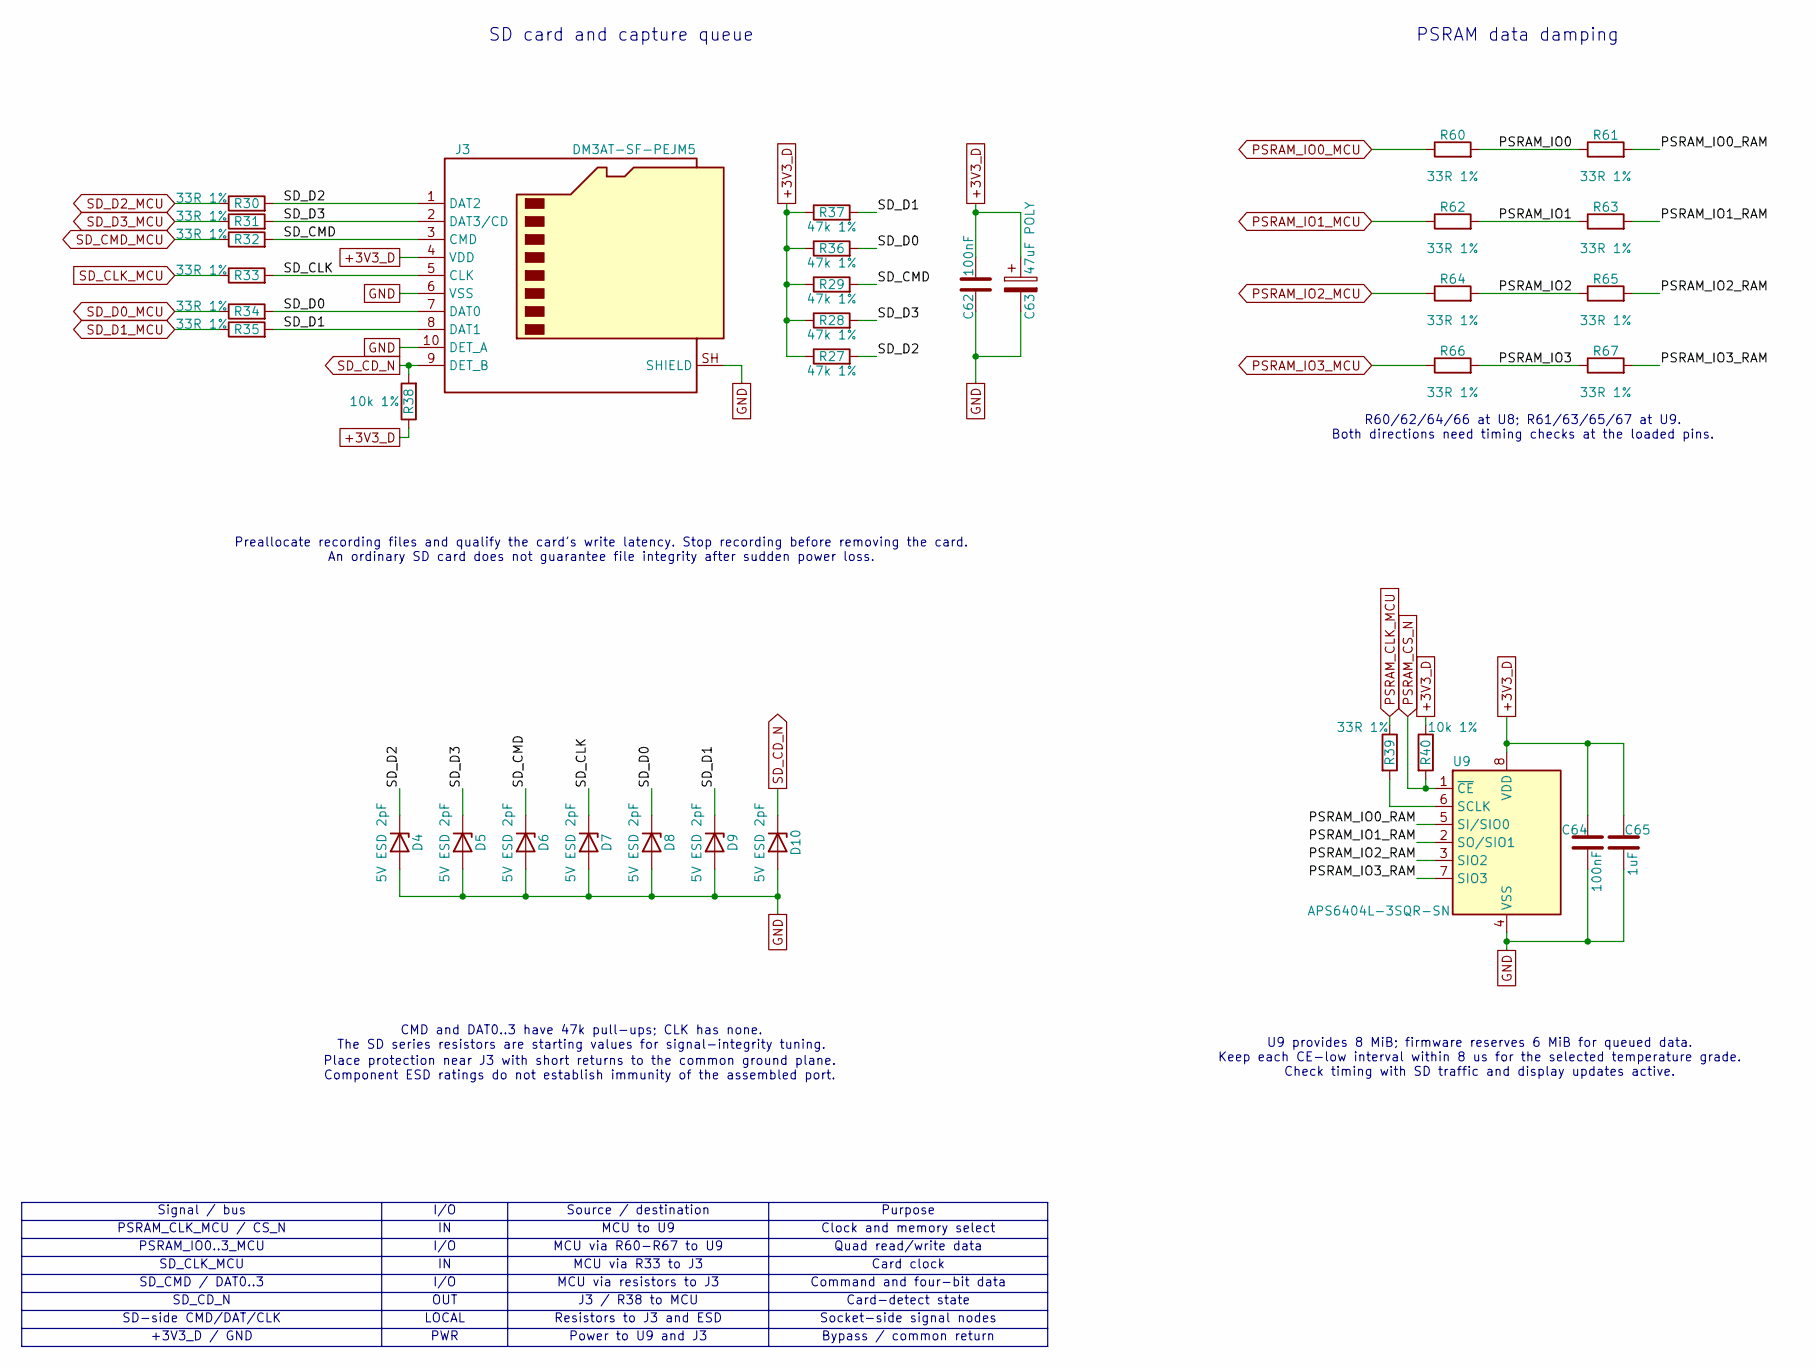
[picture p92: schematic Storage.kicad_sch, SD card and capture queue]

Parts:
C62: 100nF; C_0402_1005Metric; MPN GRM155R71E104KE14D; LCSC C77014
C63: 47uF POLY; CP_EIA-3528-21_Kemet-B; MPN T520B476M010ATE035; LCSC C141441
C64: 100nF; C_0402_1005Metric; MPN GRM155R71E104KE14D; JLCPCB_PN C77014
C65: 1uF; C_0603_1608Metric; MPN GRM188R71E105KA12D; JLCPCB_PN C86020
D4, D5, D6, D7, D8, D9, D10: 5V ESD 2pF; D_SOD-882; MPN PESD5V0U1UL,315; JLCPCB_PN C85401
J3: DM3AT-SF-PEJM5; microSD_HC_Hirose_DM3AT-SF-PEJM5; MPN DM3AT-SF-PEJM5; JLCPCB_PN C114218
R27, R28, R29, R36, R37: 47k 1%; R_0402_1005Metric; MPN RC0402FR-0747KL; LCSC C93943
R30, R31, R32, R33, R34, R35, R39, R60, R61, R62, R63, R64, R65, R66, R67: 33R 1%; R_0603_1608Metric; MPN RC0603FR-0733RL; JLCPCB_PN C108661
R38: 10k 1%; R_0402_1005Metric; MPN RC0402FR-0710KL; LCSC C60490
R40: 10k 1%; R_0603_1608Metric; MPN RC0603FR-0710KL; JLCPCB_PN C98220
U9: APS6404L-3SQR-SN; SOIC-8_3.9x4.9mm_P1.27mm; MPN APS6404L-3SQR-SN; JLCPCB_PN C5333729

Connections:
+3V3_D: C62.1, C63.1, C64.1, C65.1, J3.4 (VDD), R27.1, R28.1, R29.1, R36.1, R37.1, R38.1, R40.1, U9.8 (VDD); also elsewhere on the board
/SD and capture memory/PSRAM_IO0: R60.2, R61.1
/SD and capture memory/PSRAM_IO0_RAM: R61.2, U9.5 (SI/SIO0)
/SD and capture memory/PSRAM_IO1: R62.2, R63.1
/SD and capture memory/PSRAM_IO1_RAM: R63.2, U9.2 (SO/SIO1)
/SD and capture memory/PSRAM_IO2: R64.2, R65.1
/SD and capture memory/PSRAM_IO2_RAM: R65.2, U9.3 (SIO2)
/SD and capture memory/PSRAM_IO3: R66.2, R67.1
/SD and capture memory/PSRAM_IO3_RAM: R67.2, U9.7 (SIO3)
/SD and capture memory/SD_CLK: D7.1 (K), J3.5 (CLK), R33.2
/SD and capture memory/SD_CMD: D6.1 (K), J3.3 (CMD), R29.2, R32.2
/SD and capture memory/SD_D0: D8.1 (K), J3.7 (DAT0), R34.2, R36.2
/SD and capture memory/SD_D1: D9.1 (K), J3.8 (DAT1), R35.2, R37.2
/SD and capture memory/SD_D2: D4.1 (K), J3.1 (DAT2), R27.2, R30.2
/SD and capture memory/SD_D3: D5.1 (K), J3.2 (DAT3/CD), R28.2, R31.2
GND: C62.2, C63.2, C64.2, C65.2, D4.2 (A), D5.2 (A), D6.2 (A), D7.2 (A), D8.2 (A), D9.2 (A), D10.2 (A), J3.6 (VSS), J3.10 (DET_A), J3.SH (SHIELD), U9.4 (VSS); also elsewhere on the board
unnamed: R39.2, U9.6 (SCLK)
PSRAM_CLK_MCU: R39.1; also elsewhere on the board
PSRAM_CS_N: R40.2, U9.1 (~CE); also elsewhere on the board
PSRAM_IO0_MCU: R60.1; also elsewhere on the board
PSRAM_IO1_MCU: R62.1; also elsewhere on the board
PSRAM_IO2_MCU: R64.1; also elsewhere on the board
PSRAM_IO3_MCU: R66.1; also elsewhere on the board
SD_CD_N: D10.1 (K), J3.9 (DET_B), R38.2; also elsewhere on the board
SD_CLK_MCU: R33.1; also elsewhere on the board
SD_CMD_MCU: R32.1; also elsewhere on the board
SD_D0_MCU: R34.1; also elsewhere on the board
SD_D1_MCU: R35.1; also elsewhere on the board
SD_D2_MCU: R30.1; also elsewhere on the board
SD_D3_MCU: R31.1; also elsewhere on the board

Notes on the sheet:
OUT
I/O
MCU via resistors to J3
SD-side CMD/DAT/CLK
Preallocate recording files and qualify the card's write latency. Stop recording before removing the card. An ordinary SD card does not guarantee file integrity after sudden power loss.
PWR
Socket-side signal nodes
Clock and memory select
PSRAM_CLK_MCU / CS_N
MCU via R33 to J3
Quad read/write data
Bypass / common return
Card clock
U9 provides 8 MiB; firmware reserves 6 MiB for queued data. Keep each CE-low interval within 8 us for the selected temperature grade. Check timing with SD traffic and display updates active.
LOCAL
Power to U9 and J3
PSRAM_IO0..3_MCU
MCU via R60-R67 to U9
Purpose
Command and four-bit data
R60/62/64/66 at U8; R61/63/65/67 at U9. Both directions need timing checks at the loaded pins.
Resistors to J3 and ESD
Card-detect state
SD_CLK_MCU
PSRAM data damping
Source / destination
Signal / bus
SD card and capture queue
MCU to U9
SD_CD_N
CMD and DAT0..3 have 47k pull-ups; CLK has none. The SD series resistors are starting values for signal-integrity tuning.
SD_CMD / DAT0..3
Place protection near J3 with short returns to the common ground plane. Component ESD ratings do not establish immunity of the assembled port.
+3V3_D / GND
J3 / R38 to MCU

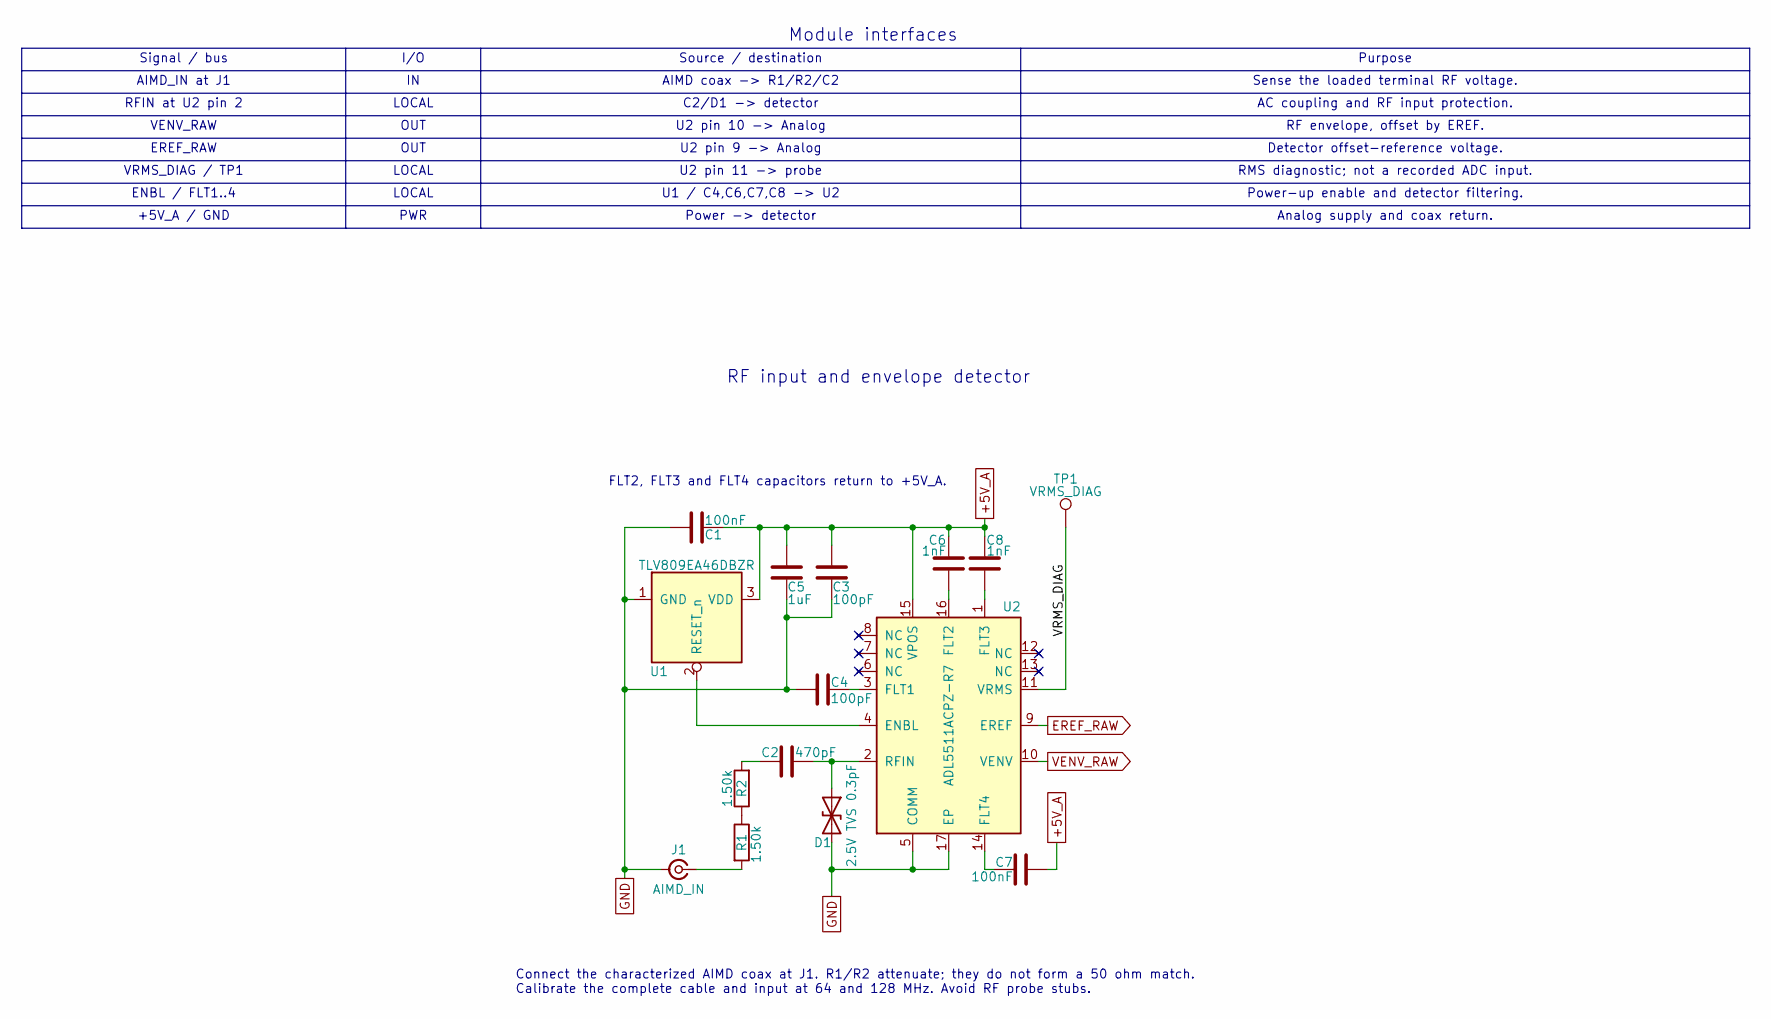
[picture p93: schematic RF_Input.kicad_sch, RF input and envelope detector]

Parts:
C1: 100nF; C_0603_1608Metric; MPN CC0603KRX7R9BB104; LCSC C14663
C2: 470pF; C_0603_1608Metric; MPN CGA3E2C0G2A471J080AE; JLCPCB_PN C3843989
C3, C4: 100pF; C_0402_1005Metric; MPN GRM1555C1H101JA01D; LCSC C77177
C5: 1uF; C_0603_1608Metric; MPN CL10B105KA8NNNC; LCSC C29936
C6, C8: 1nF; C_0402_1005Metric; MPN GRM1555C1H102JA01D; LCSC C76947
C7: 100nF; C_0402_1005Metric; MPN GRM155R71E104KE14D; LCSC C77014
D1: 2.5V TVS 0.3pF; PESD2V5Y1BSF_SOD962-2_ManufacturerLand; MPN PESD2V5Y1BSFYL; JLCPCB_PN C552507
J1: AIMD_IN; U.FL_Hirose_U.FL-R-SMT-1_Vertical; MPN U.FL-R-SMT-1(01); LCSC C598199
R1, R2: 1.50k; R_0402_1005Metric; MPN ERA-2AEB152X
TP1: VRMS_DIAG; TestPoint_Pad_D1.0mm; MPN DNP-NO-COMPONENT; LCSC N/A
U1: TLV809EA46DBZR; SOT-23-3; MPN TLV809EA46DBZR; LCSC C1852111
U2: ADL5511ACPZ-R7; LFCSP-16-1EP_3x3mm_P0.5mm_EP1.6x1.6mm; MPN ADL5511ACPZ-R7; JLCPCB_PN C579159

Connections:
+5V_A: C1.1, C3.1, C5.1, C6.2, C7.2, C8.2, U1.3 (VDD), U2.15 (VPOS); also elsewhere on the board
/RF input and detector/VRMS_DIAG: TP1.1, U2.11 (VRMS)
EREF_RAW: U2.9 (EREF); also elsewhere on the board
GND: C1.2, C3.2, C4.2, C5.2, D1.2 (A2), J1.2 (Ext), U1.1 (GND), U2.5 (COMM), U2.17 (EP); also elsewhere on the board
unnamed: C2.1, R2.2
unnamed: C2.2, D1.1 (A1), U2.2 (RFIN)
unnamed: J1.1 (In), R1.2
unnamed: R1.1, R2.1
unnamed: U1.2 (RESET_n), U2.4 (ENBL)
unnamed: C4.1, U2.3 (FLT1)
unnamed: C6.1, U2.16 (FLT2)
unnamed: C8.1, U2.1 (FLT3)
unnamed: C7.1, U2.14 (FLT4)
VENV_RAW: U2.10 (VENV); also elsewhere on the board

Notes on the sheet:
LOCAL
OUT
RFIN at U2 pin 2
AIMD_IN at J1
Sense the loaded terminal RF voltage.
Analog supply and coax return.
Power-up enable and detector filtering.
AIMD coax -> R1/R2/C2
U2 pin 11 -> probe
Source / destination
U2 pin 9 -> Analog
AC coupling and RF input protection.
VRMS_DIAG / TP1
RF input and envelope detector
ENBL / FLT1..4
RF envelope, offset by EREF.
FLT2, FLT3 and FLT4 capacitors return to +5V_A.
Module interfaces
U2 pin 10 -> Analog
+5V_A / GND
Purpose
C2/D1 -> detector
PWR
Detector offset-reference voltage.
Power -> detector
VENV_RAW
Connect the characterized AIMD coax at J1. R1/R2 attenuate; they do not form a 50 ohm match. Calibrate the complete cable and input at 64 and 128 MHz. Avoid RF probe stubs.
I/O
U1 / C4,C6,C7,C8 -> U2
RMS diagnostic; not a recorded ADC input.
Signal / bus
EREF_RAW

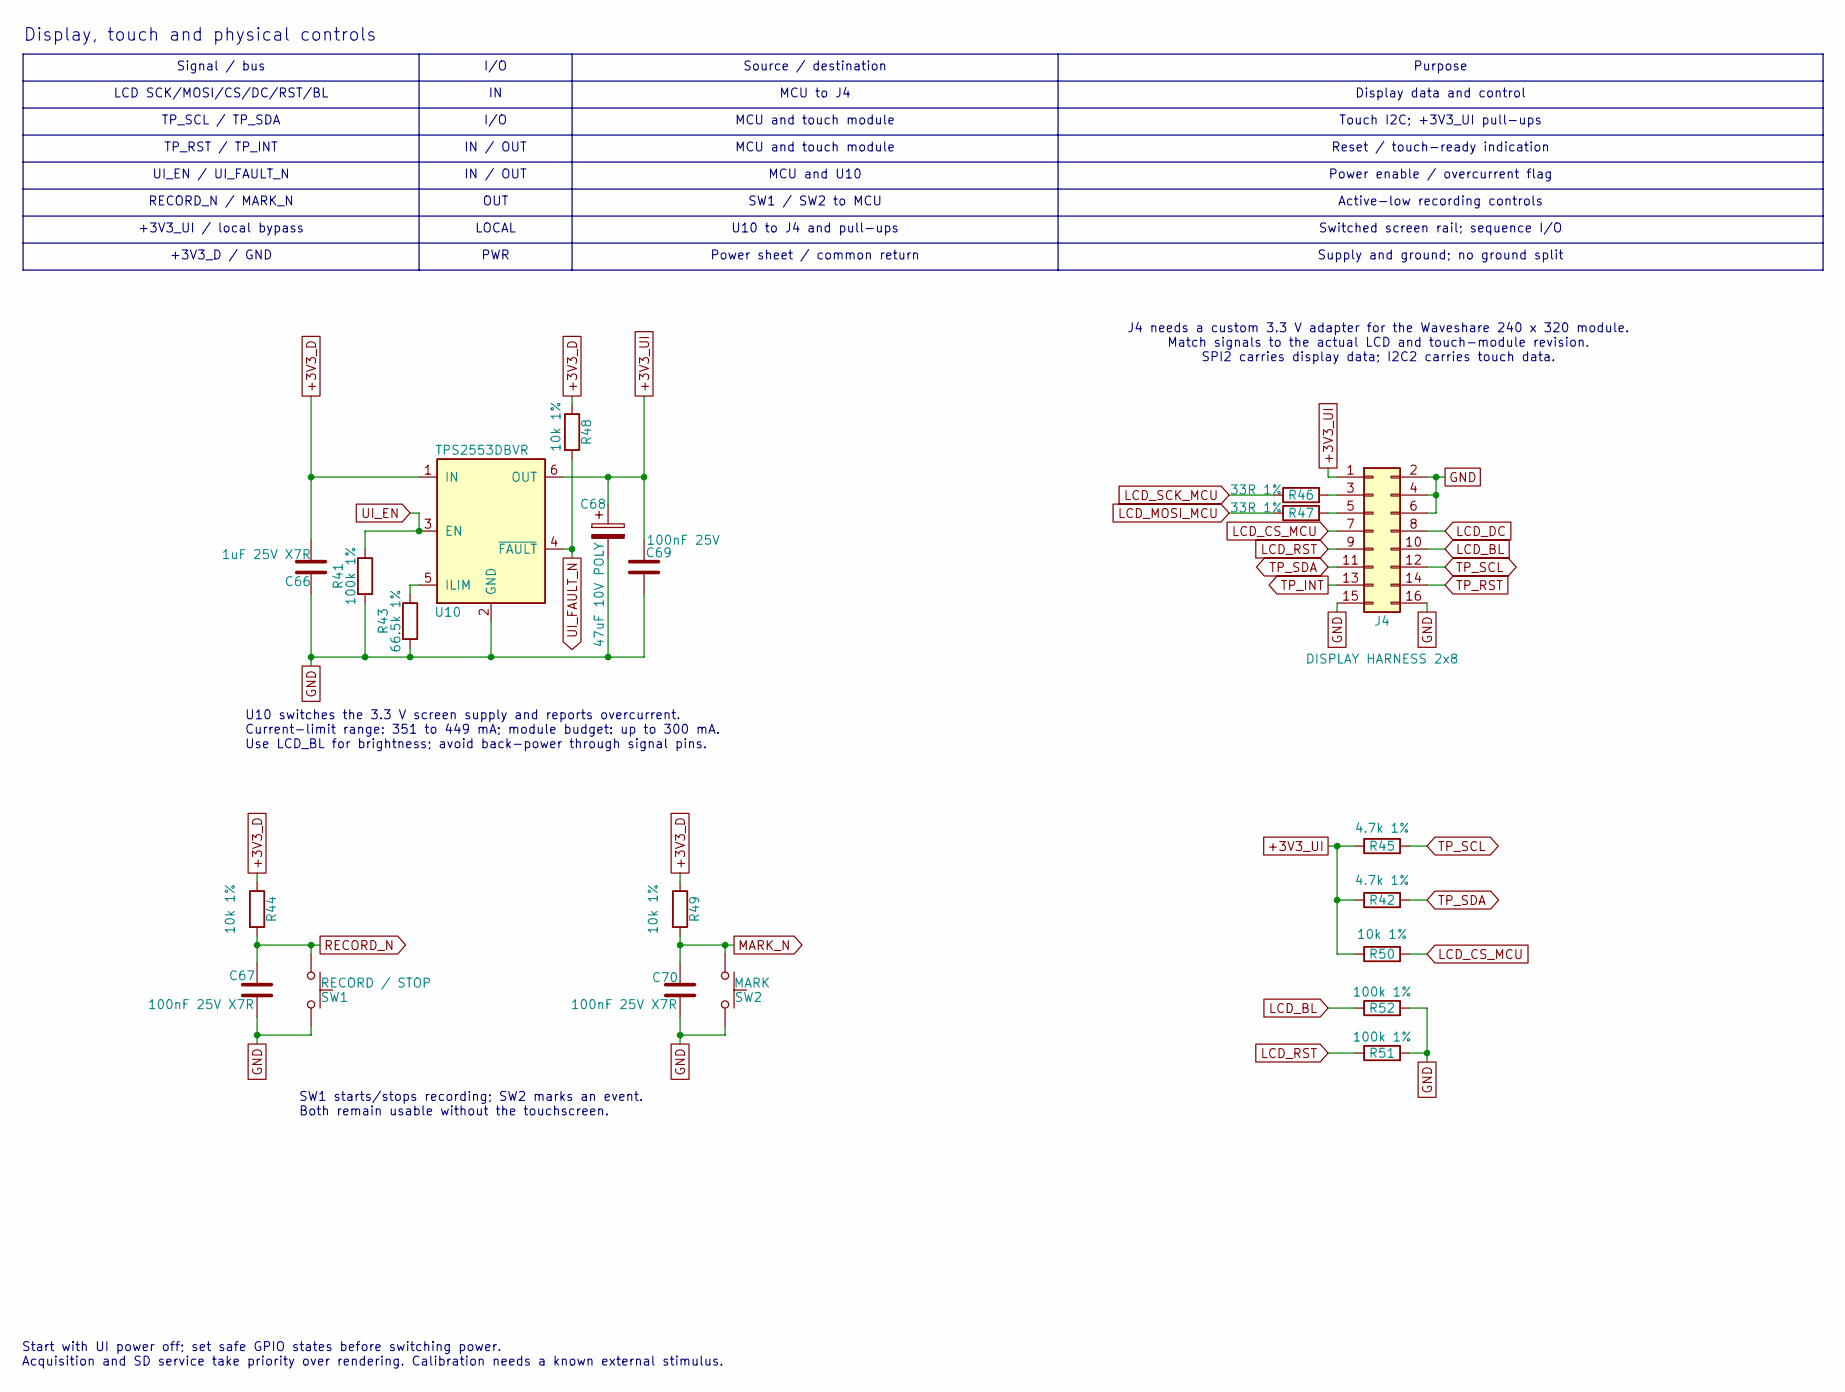
[picture p94: schematic Display.kicad_sch, Display and controls]

Parts:
C66: 1uF 25V X7R; C_0603_1608Metric; MPN GRM188R71E105KA12D; JLCPCB_PN C86020
C67, C70: 100nF 25V X7R; C_0402_1005Metric; MPN GRM155R71E104KE14D; JLCPCB_PN C77014
C68: 47uF 10V POLY; CP_EIA-3528-21_Kemet-B; MPN T520B476M010ATE035; LCSC C141441
C69: 100nF 25V; C_0402_1005Metric; MPN GRM155R71E104KE14D; JLCPCB_PN C77014
J4: DISPLAY HARNESS 2x8; PinHeader_2x08_P2.54mm_Vertical; MPN TSW-108-07-G-D; Mouser_PN 200-TSW10807GD
R41, R51, R52: 100k 1%; R_0603_1608Metric; MPN RC0603FR-07100KL; JLCPCB_PN C14675
R42, R45: 4.7k 1%; R_0603_1608Metric; MPN RC0603FR-074K7L; JLCPCB_PN C99782
R43: 66.5k 1%; R_0603_1608Metric; MPN RC0603FR-0766K5L; JLCPCB_PN C137691
R44, R48, R49, R50: 10k 1%; R_0603_1608Metric; MPN RC0603FR-0710KL; JLCPCB_PN C98220
R46, R47: 33R 1%; R_0603_1608Metric; MPN RC0603FR-0733RL; JLCPCB_PN C108661
SW1: RECORD / STOP; SW_SPST_B3U-1000P; MPN B3U-1000P; JLCPCB_PN C231329
SW2: MARK; SW_SPST_B3U-1000P; MPN B3U-1000P; JLCPCB_PN C231329
U10: TPS2553DBVR; SOT-23-6; MPN TPS2553DBVR; JLCPCB_PN C55266

Connections:
+3V3_D: C66.1, R44.1, R48.1, R49.1, U10.1 (IN); also elsewhere on the board
+3V3_UI: C68.1, C69.1, J4.1, R42.1, R45.1, R50.1, U10.6 (OUT)
GND: C66.2, C67.2, C68.2, C69.2, C70.2, J4.2, J4.4, J4.6, J4.15, J4.16, R41.2, R43.2, R51.2, R52.2, SW1.2, SW2.2, U10.2 (GND); also elsewhere on the board
LCD_BL: J4.10, R52.1; also elsewhere on the board
LCD_CS_MCU: J4.7, R50.2; also elsewhere on the board
LCD_DC: J4.8; also elsewhere on the board
LCD_MOSI_MCU: R47.1; also elsewhere on the board
LCD_RST: J4.9, R51.1; also elsewhere on the board
LCD_SCK_MCU: R46.1; also elsewhere on the board
MARK_N: C70.1, R49.2, SW2.1; also elsewhere on the board
unnamed: J4.3, R46.2
unnamed: J4.5, R47.2
unnamed: R43.1, U10.5 (ILIM)
RECORD_N: C67.1, R44.2, SW1.1; also elsewhere on the board
TP_INT: J4.13; also elsewhere on the board
TP_RST: J4.14; also elsewhere on the board
TP_SCL: J4.12, R45.2; also elsewhere on the board
TP_SDA: J4.11, R42.2; also elsewhere on the board
UI_EN: R41.1, U10.3 (EN); also elsewhere on the board
UI_FAULT_N: R48.2, U10.4 (~FAULT); also elsewhere on the board

Notes on the sheet:
IN / OUT
OUT
Signal / bus
Power enable / overcurrent flag
MCU and touch module
J4 needs a custom 3.3 V adapter for the Waveshare 240 x 320 module. Match signals to the actual LCD and touch-module revision. SPI2 carries display data; I2C2 carries touch data.
SW1 / SW2 to MCU
Supply and ground; no ground split
LCD SCK/MOSI/CS/DC/RST/BL
MCU to J4
Display, touch and physical controls
+3V3_UI / local bypass
Display data and control
Active-low recording controls
I/O
PWR
Start with UI power off; set safe GPIO states before switching power. Acquisition and SD service take priority over rendering. Calibration needs a known external stimulus.
Power sheet / common return
Source / destination
RECORD_N / MARK_N
U10 to J4 and pull-ups
UI_EN / UI_FAULT_N
TP_RST / TP_INT
Reset / touch-ready indication
Touch I2C; +3V3_UI pull-ups
Switched screen rail; sequence I/O
LOCAL
U10 switches the 3.3 V screen supply and reports overcurrent. Current-limit range: 351 to 449 mA; module budget: up to 300 mA. Use LCD_BL for brightness; avoid back-power through signal pins.
Purpose
MCU and U10
+3V3_D / GND
SW1 starts/stops recording; SW2 marks an event. Both remain usable without the touchscreen.
TP_SCL / TP_SDA

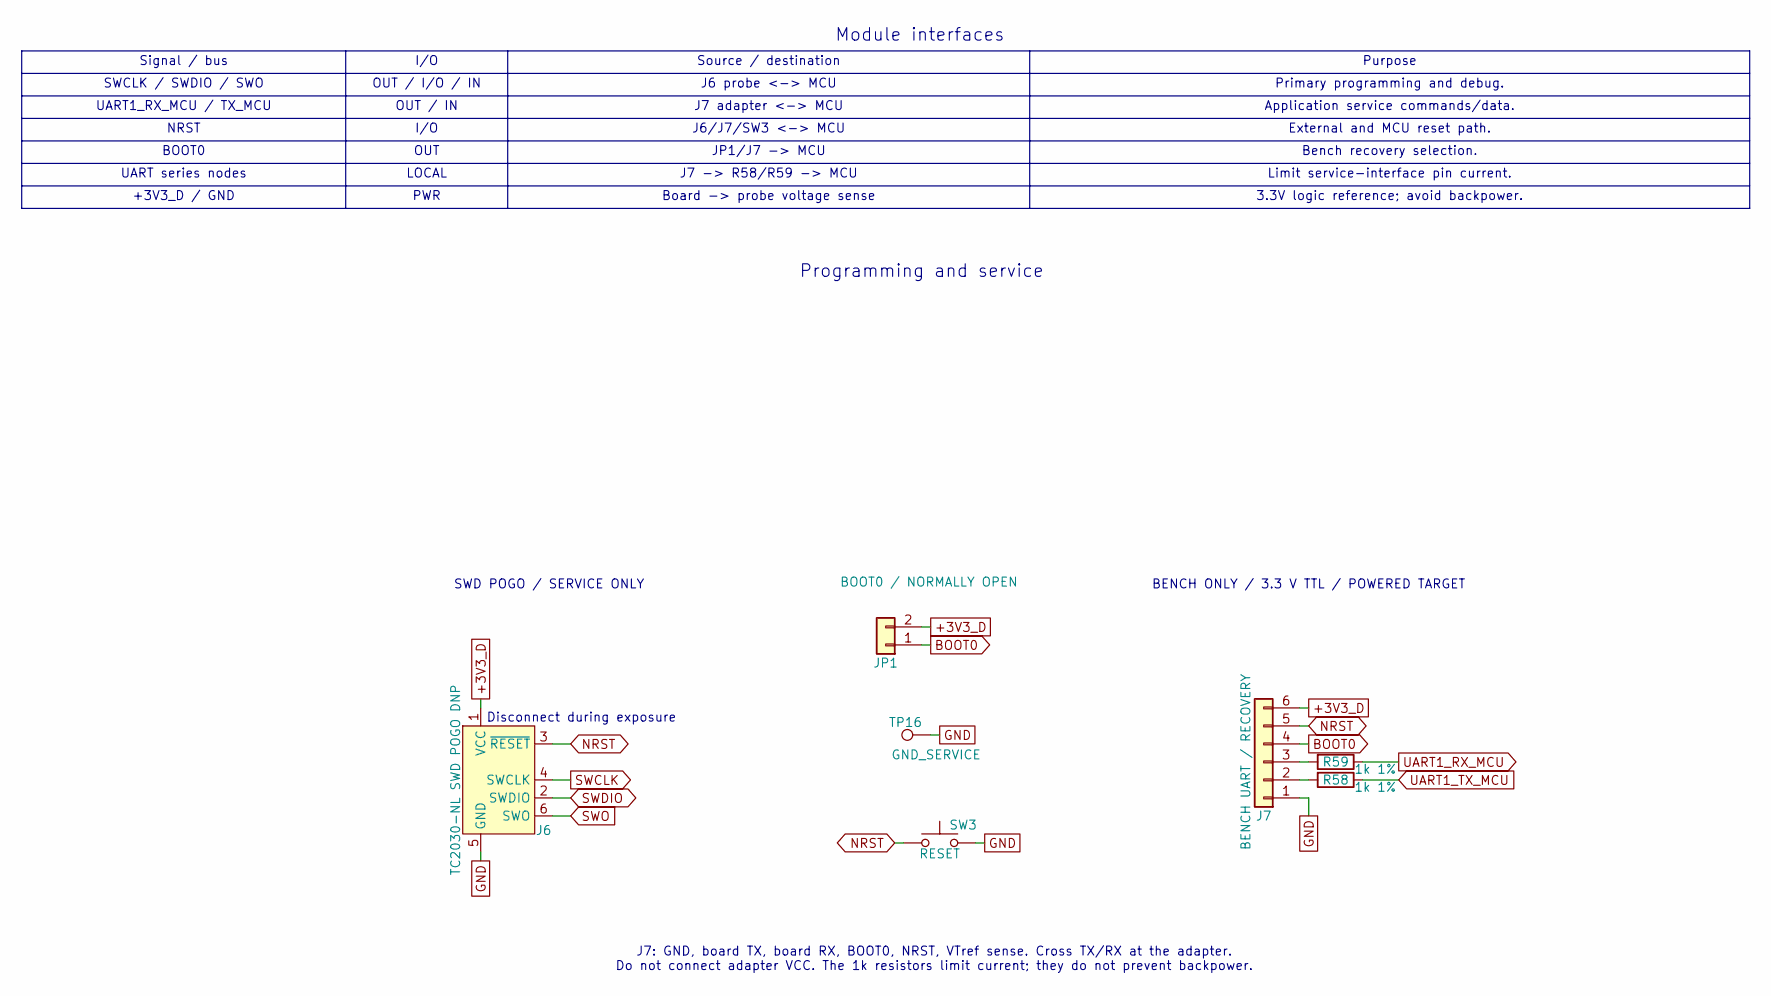
[picture p95: schematic Service.kicad_sch, Programming and service]

Parts:
J6: TC2030-NL SWD POGO DNP; Tag-Connect_TC2030-IDC-NL_2x03_P1.27mm_Vertical; MPN DNP-NO-COMPONENT; LCSC N/A
J7: BENCH UART / RECOVERY; PinHeader_1x06_P2.54mm_Vertical; MPN TSW-106-07-G-S
JP1: BOOT0 / NORMALLY OPEN; PinHeader_1x02_P2.54mm_Vertical; MPN TSW-102-07-G-S; JLCPCB_PN C7402729
R58, R59: 1k 1%; R_0603_1608Metric; MPN RC0603FR-071KL; Mouser 603-RC0603FR-071KL
SW3: RESET; SW_SPST_B3U-1000P; MPN B3U-1000P; JLCPCB_PN C231329
TP16: GND_SERVICE; TestPoint_Pad_D1.0mm; MPN PCB_PAD

Connections:
+3V3_D: J6.1 (VCC), J7.6, JP1.2; also elsewhere on the board
GND: J6.5 (GND), J7.1, SW3.2, TP16.1; also elsewhere on the board
NRST: J6.3 (~RESET), J7.5, SW3.1; also elsewhere on the board
unnamed: J7.2, R58.2
unnamed: J7.3, R59.2
SWCLK: J6.4 (SWCLK); also elsewhere on the board
SWDIO: J6.2 (SWDIO); also elsewhere on the board
SWO: J6.6 (SWO); also elsewhere on the board
UART1_RX_MCU: R59.1; also elsewhere on the board
UART1_TX_MCU: R58.1; also elsewhere on the board

Notes on the sheet:
J6 probe <-> MCU
External and MCU reset path.
J7 adapter <-> MCU
JP1/J7 -> MCU
Purpose
LOCAL
PWR
OUT
Board -> probe voltage sense
NRST
Programming and service
+3V3_D / GND
SWCLK / SWDIO / SWO
SWD POGO / SERVICE ONLY
3.3V logic reference; avoid backpower.
Disconnect during exposure
UART series nodes
OUT / I/O / IN
J7 -> R58/R59 -> MCU
Primary programming and debug.
I/O
Module interfaces
OUT / IN
J6/J7/SW3 <-> MCU
Limit service-interface pin current.
Bench recovery selection.
Source / destination
Application service commands/data.
BENCH ONLY / 3.3 V TTL / POWERED TARGET
Signal / bus
BOOT0
J7: GND, board TX, board RX, BOOT0, NRST, VTref sense. Cross TX/RX at the adapter. Do not connect adapter VCC. The 1k resistors limit current; they do not prevent backpower.
UART1_RX_MCU / TX_MCU

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
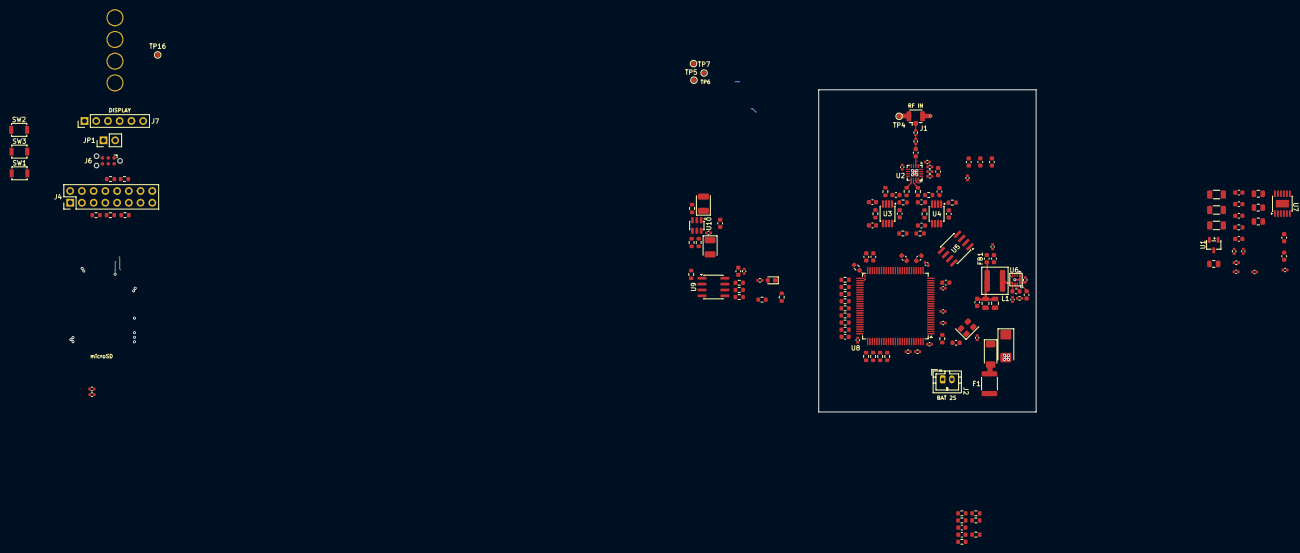
[picture p96: board Hardware/RFVD_SENSOR_BOARD_Rev3/RFVD_SENSOR_BOARD.kicad_pcb from above]

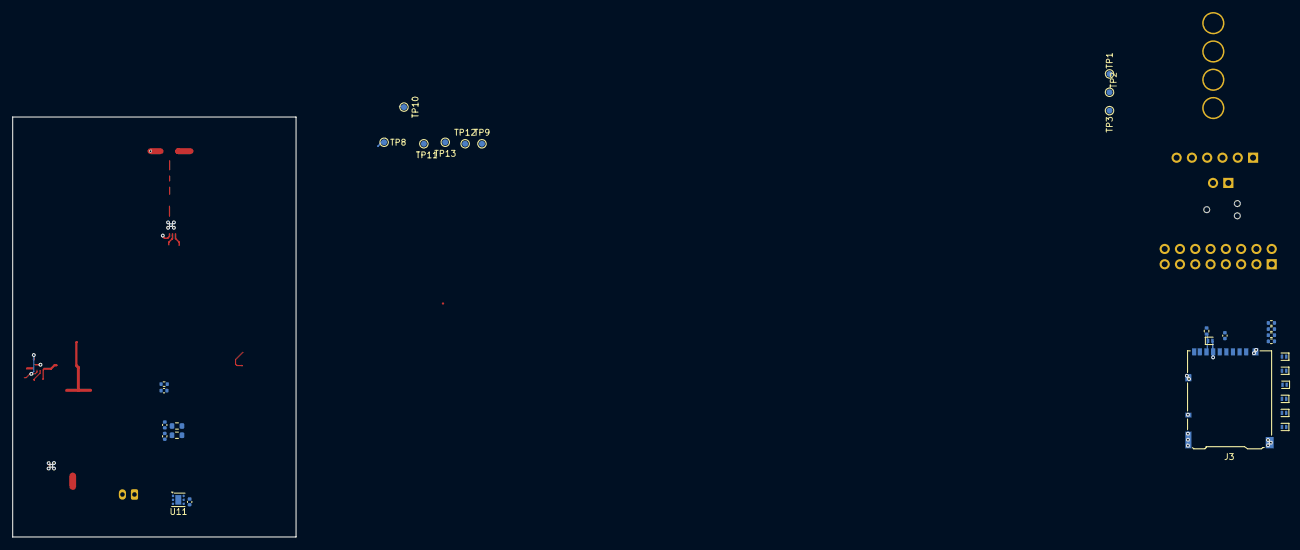
[picture p97: board Hardware/RFVD_SENSOR_BOARD_Rev3/RFVD_SENSOR_BOARD.kicad_pcb from below]

Board: 4 copper layers, 47.1 x 69.8 mm, 189 parts (31 on the bottom side), 108 nets.

Other parts of the board:
H1, H2, H3, H4: MountingHole; MountingHole_3.2mm
