Able-Digital-Logic/UnintendedAntennaClub3/Hardware/RFVD_SENSOR_BOARD_Rev1/RFVD_SENSOR_BOARD.kicad_pcb

## KiCad design Hardware/RFVD_SENSOR_BOARD_Rev1/RFVD_SENSOR_BOARD.kicad_pcb (2026-09-06, an earlier design)

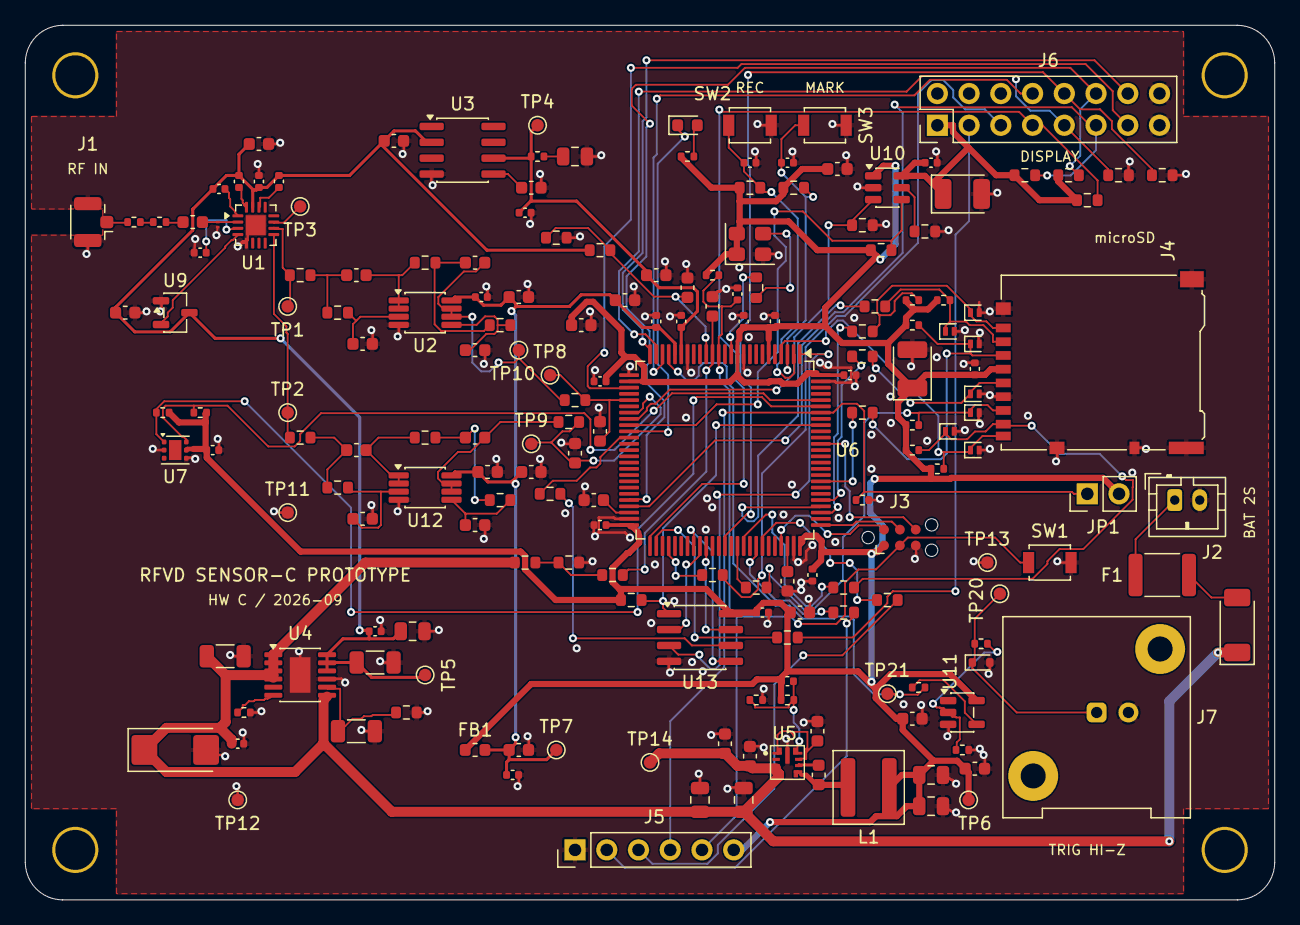
[picture p98: board Hardware/RFVD_SENSOR_BOARD_Rev1/RFVD_SENSOR_BOARD.kicad_pcb from above]

Board: 4 copper layers, 100.0 x 70.0 mm, 189 parts (0 on the bottom side), 104 nets.

Parts:
C1: 470pF C0G 100V; C_0603_1608Metric
C2, C6: 100pF 50V C0G; C_0402_1005Metric
C3, C4: 1nF 50V C0G; C_0402_1005Metric
C5, C14, C20, C26, C27, C28, C29, C31, C32, C34, C36, C37, C38, C54, C55, C56, C57, C63, C70: 100nF 25V X7R; C_0402_1005Metric
C7, C11, C12, C25, C33, C35, C43, C61, C71: 1uF 25V X7R; C_0603_1608Metric
C13: 4.7uF 25V X7R; C_0805_2012Metric
C15: 47uF 20V; CP_EIA-6032-28_Kemet-C
C16: 100nF 25V; C_0402_1005Metric
C17: 10uF 16V X7R; C_1206_3216Metric
C18: 22uF 25V X5R; C_1206_3216Metric
C19: 470nF 35V 10% PMLCAP film; C_1206_3216Metric
C21, C42: 10uF 16V; C_0805_2012Metric
C22, C23: 22uF 10V X5R; C_0805_2012Metric
C24, C41, C44, C46, C47, C51, C60: 100nF 50V X7R; C_0603_1608Metric
C30: 4.7uF 16V X7R; C_0603_1608Metric
C39, C62: 47uF 10V 35mR POLYMER; CP_EIA-3528-21_Kemet-B
C40: 100n; C_0402_1005Metric
C45: 10uF 16V X7R; C_0805_2012Metric
C52, C53: 2.2uF 10V X5R; C_0603_1608Metric
C64: 22pF 50V C0G; C_0402_1005Metric
C65: 10nF 50V X7R; C_0603_1608Metric
C80, C85: 510p; C_0603_1608Metric
C81, C83, C86, C88: 470p; C_0603_1608Metric
C82, C87: 1.2n; C_0603_1608Metric
C84, C89: 330p; C_0603_1608Metric
C90, C92: 1u; C_0603_1608Metric
C91: 100n; C_0603_1608Metric
D1: 2.5V TVS 0.3pF max; PESD2V5Y1BSF_SOD962-2_ManufacturerLand
D2: 60V 3A Schottky; D_SOD-128
D3: GREEN LED; LED_0603_1608Metric
D7: 5.5V TVS 12pF; D_SOD-523
D8, D9, D10, D11, D12, D13, D14: 5V ESD 2pF; D_SOD-882
F1: 1.1A hold 16V PTC; Fuse_1812_4532Metric
FB1: 600R@100MHz 500mA; L_0603_1608Metric
H1, H2, H3, H4: MountingHole; MountingHole_3.2mm
J1: U.FL AIMD SENSE; U.FL_Hirose_U.FL-R-SMT-1_Vertical
J2: B2B-PH-K-S(LF)(SN) 2S BATTERY; JST_PH_B2B-PH-K_1x02_P2.00mm_Vertical
J3: TC2030-NL SWD POGO DNP; Tag-Connect_TC2030-IDC-NL_2x03_P1.27mm_Vertical
J4: DM3AT-SF-PEJM5; microSD_HC_Hirose_DM3AT-SF-PEJM5
J5: BENCH UART / RECOVERY; PinHeader_1x06_P2.54mm_Vertical
J6: DISPLAY HARNESS 2x8; PinHeader_2x08_P2.54mm_Vertical
J7: BNC TRIGGER; BNC_Amphenol_031-5539_Vertical
JP1: BOOT0 / NORMALLY OPEN; PinHeader_1x02_P2.54mm_Vertical
L1: 4.7uH; L_Coilcraft_XAL5030-XXX
R1, R2: 1.50k 0.1% 25ppm; R_0402_1005Metric
R15: 1R 1%; R_0402_1005Metric
R16: 49.9k 0.1% 25ppm; R_0603_1608Metric
R17, R22: 1k 1%; R_0402_1005Metric
R20, R21, R31: 10k 1%; R_0402_1005Metric
R23, R24: 4.7k 1%; R_0402_1005Metric
R25, R26, R27, R28, R29: 47k 1%; R_0402_1005Metric
R30, R34, R42, R43, R44, R45, R46, R48, R49, R50: 33R 1%; R_0603_1608Metric
R35: 100k 0.1%; R_0603_1608Metric
R36: 20.0k 0.1%; R_0603_1608Metric
R39: 10k; R_0603_1608Metric
R40, R41: 1k 1%; R_0603_1608Metric
R47, R53, R56, R57, R58: 10k 1%; R_0603_1608Metric
R51: 66.5k 1%; R_0603_1608Metric
R52, R59, R63, R66, R67: 100k 1%; R_0603_1608Metric
R54, R55: 4.7k 1%; R_0603_1608Metric
R60: 330R 1%; R_0402_1005Metric
R61: 100k 1%; R_0402_1005Metric
R62: 33R 1%; R_0402_1005Metric
R64: 33.2k 1%; R_0402_1005Metric
R65: 14.3k 1%; R_0402_1005Metric
R80, R81, R86: 2.26k; R_0603_1608Metric
R82, R83, R87, R88: 1.33k; R_0603_1608Metric
R84, R89: 47R; R_0603_1608Metric
R85: 2.15k; R_0603_1608Metric
SW1: RESET; SW_SPST_B3U-1000P
SW2: RECORD / STOP; SW_SPST_B3U-1000P
SW3: MARK; SW_SPST_B3U-1000P
TP1: VENV_RAW; TestPoint_Pad_D1.0mm
TP2: EREF_RAW; TestPoint_Pad_D1.0mm
TP3: VRMS_DIAG; TestPoint_Pad_D1.0mm
TP4: +3V0_REF; TestPoint_Pad_D1.0mm
TP5: +5V_A; TestPoint_Pad_D1.0mm
TP6: +3V3_D; TestPoint_Pad_D1.0mm
TP7: +3V3_A; TestPoint_Pad_D1.0mm
TP8: ADC_VENV; TestPoint_Pad_D1.0mm
TP9: ADC_EREF; TestPoint_Pad_D1.0mm
TP10: VENV_BUF; TestPoint_Pad_D1.0mm
TP11: GND_ANALOG; TestPoint_Pad_D1.0mm
TP12: GND_POWER; TestPoint_Pad_D1.0mm
TP13: GND_SERVICE; TestPoint_Pad_D1.0mm
TP14: BATT_PROT; TestPoint_Pad_D1.0mm
TP20: TRIG RAW; TestPoint_Pad_D1.0mm
TP21: TRIG CAPTURE; TestPoint_Pad_D1.0mm
U1: ADL5511ACPZ-R7; LFCSP-16-1EP_3x3mm_P0.5mm_EP1.6x1.6mm
U2, U12: OPA2320; VSSOP-8_3x3mm_P0.65mm
U3: REF5030IDR; SOIC-8_3.9x4.9mm_P1.27mm
U4: LT3045EMSE#PBF (+5V_A); MSOP-12-1EP_3x4.039mm_P0.65mm_EP1.651x2.845mm
U5: LMR43620MB5RPER; TI_RPE0009B_VQFN-HR-9_2x2mm_Stencil
U6: STM32H743VIT6; LQFP-100_14x14mm_P0.5mm
U7: TMP117MAIDRVR; TMP117_DRV_WSON6_NoPasteEP
U9: TLV809EA46DBZR; SOT-23-3
U10: TPS2553DBVR; SOT-23-6
U11: SN74LVC1G17; SOT-23-5
U13: APS6404L-3SQR-SN; SOIC-8_3.9x4.9mm_P1.27mm
Y1: 8MHz 3.3V CMOS; Oscillator_SMD_Abracon_ASE-4Pin_3.2x2.5mm

Connections:
+3V0_REF: C14.1, C34.1, C35.1, R15.1, TP4.1, U3.6, U6.20
+3V3_A: C25.1, C26.1, C32.1, C33.1, C40.1, C90.1, C91.1, C92.1, FB1.2, TP7.1, U2.8, U6.21, U12.8
+3V3_D: C22.1, C23.1, C27.1, C28.1, C29.1, C30.1, C31.1, C37.1, C38.1, C39.1, C44.1, C54.1, C55.1, C60.1, C61.1, C64.1, C70.1, C71.1, FB1.1, J3.1, J4.4, J5.6, JP1.2, L1.2, R20.1, R22.1, R23.2, R24.2, R25.1, R26.1, R27.1, R28.1, R29.1, R31.1, R47.1, R53.1, R56.1, R57.1, R64.1, TP6.1, U6.6, U6.11, U6.27, U6.50, U6.75, U6.100, U7.5, U10.1, U11.5, U13.8, Y1.1, Y1.4
+3V3_UI: C62.1, C63.1, J6.1, R54.1, R55.1, R58.1, U10.6
+5V_A: C3.2, C4.2, C5.2, C6.1, C7.1, C11.1, C18.1, C20.1, C45.1, C51.1, R66.1, TP5.1, U1.15, U3.2, U4.10, U4.11, U4.12, U9.3
/Analog acquisition/REF_NR: C12.1, U3.5
/Analog acquisition/VENV_BUF: C82.2, R84.1, TP10.1, U2.6, U2.7
/Analog acquisition/VREF_ESR: C13.1, R15.2
/Battery and power/BUCK_BOOT: C41.1, U5.6
/Battery and power/BUCK_FB: C64.2, R64.2, R65.1, U5.8
/Battery and power/BUCK_SW: C41.2, L1.1, U5.5
/Battery and power/BUCK_VCC: C43.1, U5.1, U5.7
/Battery and power/LT5_ILIM: R17.1, U4.6
/Battery and power/LT5_SET: C19.1, R16.1, U4.8
/RF input and detector/ADL_EN: U1.4, U9.2
/RF input and detector/ADL_FLT1: C2.1, U1.3
/RF input and detector/ADL_FLT2: C3.1, U1.16
/RF input and detector/ADL_FLT3: C4.1, U1.1
/RF input and detector/ADL_FLT4: C5.1, U1.14
/RF input and detector/RFIN_PROTECTED: C1.2, D1.1, U1.2
/RF input and detector/RF_TAP_OUT: C1.1, R2.2
/RF input and detector/VRMS_DIAG: TP3.1, U1.11
/SD and capture memory/PSRAM_CLK: R48.2, U13.6
/SD and capture memory/SD_CLK: D11.1, J4.5, R30.2
/SD and capture memory/SD_CMD: D10.1, J4.3, R27.2, R34.2
/SD and capture memory/SD_D0: D12.1, J4.7, R28.2, R45.2
/SD and capture memory/SD_D1: D13.1, J4.8, R29.2, R46.2
/SD and capture memory/SD_D2: D8.1, J4.1, R25.2, R43.2
/SD and capture memory/SD_D3: D9.1, J4.2, R26.2, R44.2
/STM32H743 controller/BATT_SENSE: C47.1, R39.2, U6.15
/STM32H743 controller/HSE_IN: R42.2, U6.12
/STM32H743 controller/LED_STATUS_N: D3.1, U6.35
/STM32H743 controller/RAIL5_SENSE: C65.1, R66.2, R67.1, U6.16
/STM32H743 controller/VCAP1: C52.1, U6.48
/STM32H743 controller/VCAP2: C53.1, U6.73
/Screen and controls/LCD_MOSI: J6.5, R50.2
/Screen and controls/LCD_SCK: J6.3, R49.2
ADC_EREF: C89.1, R89.2, TP9.1, U6.32
ADC_VENV: C84.1, R84.2, TP8.1, U6.30
BATT_PROT: C15.1, C16.1, C17.1, C21.1, C24.1, C42.1, C46.1, D2.1, R35.1, TP14.1, U4.1, U4.2, U4.3, U4.4, U4.7, U5.3, U5.4
BOOT0: J5.4, JP1.1, R21.1, U6.94
EREF_RAW: R85.1, TP2.1, U1.9
GND: C2.2, C6.2, C7.2, C11.2, C12.2, C13.2, C14.2, C15.2, C16.2, C17.2, C18.2, C19.2, C20.2, C21.2, C22.2, C23.2, C24.2, C25.2, C26.2, C27.2, C28.2, C29.2, C30.2, C31.2, C32.2, C33.2, C34.2, C35.2, C36.2, C37.2, C38.2, C39.2, C40.2, C42.2, C43.2, C44.2, C45.2, C46.2, C47.2, C51.2, C52.2, C53.2, C54.2, C55.2, C56.2, C57.2, C60.2, C61.2, C62.2, C63.2, C65.2, C70.2, C71.2, C81.2, C83.2, C84.2, C86.2, C88.2, C89.2, C90.2, C91.2, C92.2, D1.2, D7.2, D8.2, D9.2, D10.2, D11.2, D12.2, D13.2, D14.2, J1.2, J2.2, J3.5, J4.6, J4.10, J4.SH, J5.1, J6.2, J6.4, J6.6, J6.15, J6.16, J7.2, R16.2, R17.2, R21.2, R36.2, R51.2, R52.2, R59.2, R61.2, R63.2, R65.2, R67.2, SW1.2, SW2.2, SW3.2, TP11.1, TP12.1, TP13.1, U1.5, U1.17, U2.4, U3.4, U4.9, U4.13, U5.9, U6.10, U6.19, U6.26, U6.49, U6.74, U6.99, U7.2, U7.4, U9.1, U10.2, U11.3, U12.4, U13.4, Y1.2
I2C_SCL: R23.1, U6.95, U7.1
I2C_SDA: R24.1, U6.96, U7.6
LCD_BL: J6.10, R63.1, U6.63
LCD_CS_MCU: J6.7, R58.2, U6.51
LCD_DC: J6.8, U6.23
LCD_MOSI_MCU: R50.1, U6.54
LCD_RST: J6.9, R59.1, U6.24
LCD_SCK_MCU: R49.1, U6.52
MARK_N: C57.1, R57.2, SW3.1, U6.3
NRST: C36.1, J3.3, J5.5, R20.2, SW1.1, U6.14
unnamed: C80.1, R80.2, R81.1
unnamed: C82.1, R82.2, R83.1
unnamed: C85.1, R85.2, R86.1
unnamed: C87.1, R87.2, R88.1
unnamed: D2.2, F1.2
unnamed: D3.2, R22.2
unnamed: D7.1, J7.1, R60.1, TP20.1
unnamed: J1.1, R1.1
unnamed: F1.1, J2.1
unnamed: J5.2, R40.2
unnamed: J5.3, R41.2
unnamed: R1.2, R2.1
unnamed: R35.2, R36.1, R39.1
unnamed: R60.2, R61.1, U11.2
unnamed: R62.1, U11.4
unnamed: C81.1, R81.2, U2.3
unnamed: C80.2, R82.1, U2.1, U2.2
unnamed: C83.1, R83.2, U2.5
unnamed: R51.1, U10.5
unnamed: C86.1, R86.2, U12.3
unnamed: C85.2, R87.1, U12.1, U12.2
unnamed: C88.1, R88.2, U12.5
unnamed: C87.2, R89.1, U12.6, U12.7
unnamed: R42.1, Y1.3
PSRAM_CLK_MCU: R48.1, U6.36
PSRAM_CS_N: R47.2, U6.92, U13.1
PSRAM_IO0: U6.58, U13.5
PSRAM_IO1: U6.59, U13.2
PSRAM_IO2: U6.1, U13.3
PSRAM_IO3: U6.60, U13.7
RECORD_N: C56.1, R56.2, SW2.1, U6.2
SD_CD_N: D14.1, J4.9, R31.2, U6.4
SD_CLK_MCU: R30.1, U6.80
SD_CMD_MCU: R34.1, U6.83
SD_D0_MCU: R45.1, U6.65
SD_D1_MCU: R46.1, U6.66
SD_D2_MCU: R43.1, U6.78
SD_D3_MCU: R44.1, U6.79
SWCLK: J3.4, U6.76
SWDIO: J3.2, U6.72
SWO: J3.6, U6.89
TP_INT: J6.13, U6.28
TP_RST: J6.14, U6.25
TP_SCL: J6.12, R55.2, U6.46
TP_SDA: J6.11, R54.2, U6.47
TRIGGER_CAPTURE: R62.2, TP21.1, U6.22
UART1_RX_MCU: R41.1, U6.69
UART1_TX_MCU: R40.1, U6.68
UI_EN: R52.1, U6.33, U10.3
UI_FAULT_N: R53.2, U6.34, U10.4
VENV_RAW: R80.1, TP1.1, U1.10
