Able-Digital-Logic/UnintendedAntennaClub3/Hardware/RFVD_SENSOR_BOARD_Rev6/docs/RFVD_SENSOR_BOARD.kicad_pcb

## KiCad design Hardware/RFVD_SENSOR_BOARD_Rev6/docs/RFVD_SENSOR_BOARD.kicad_pcb (2026-10-06)

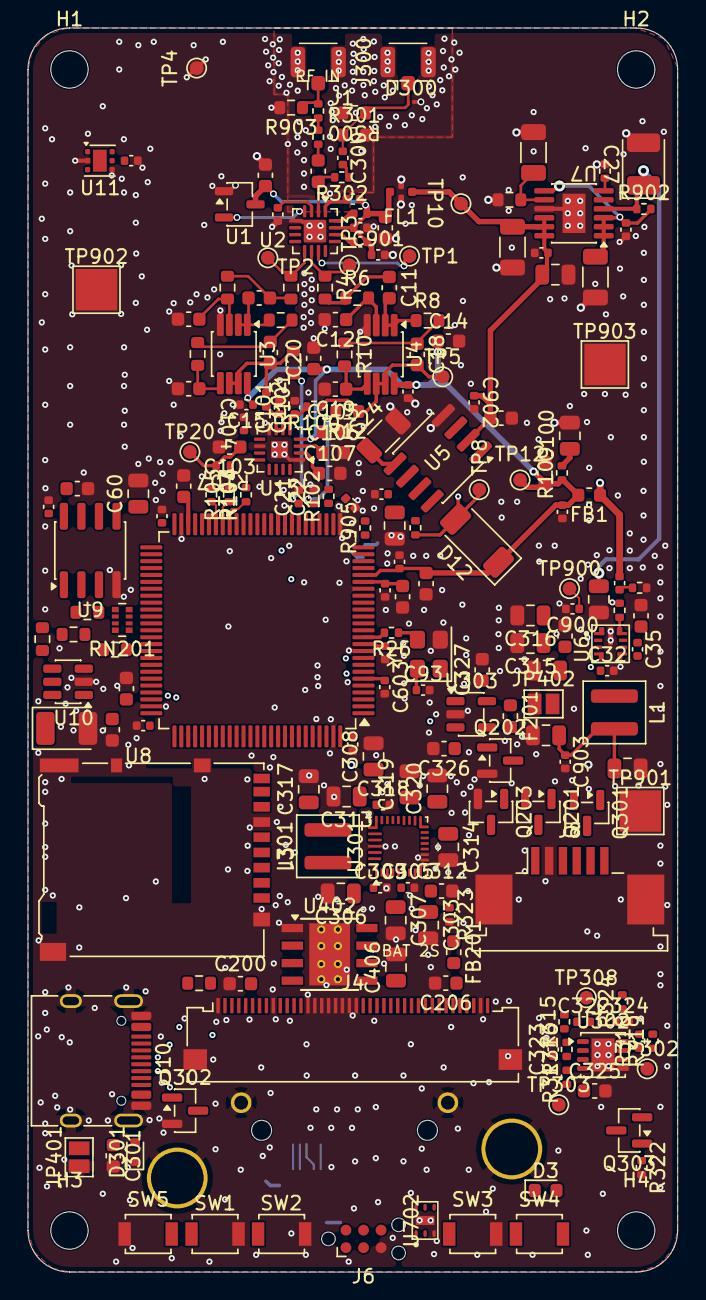
[picture p99: board Hardware/RFVD_SENSOR_BOARD_Rev6/docs/RFVD_SENSOR_BOARD.kicad_pcb from above]

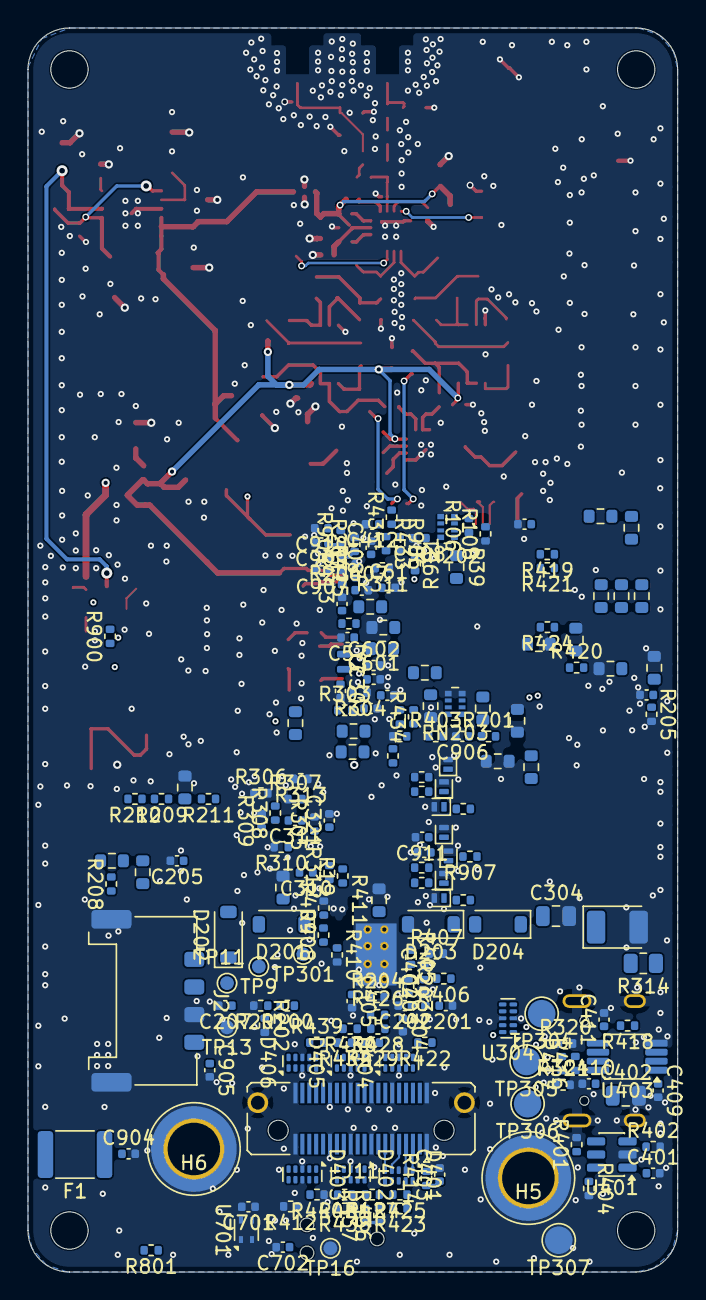
[picture p100: board Hardware/RFVD_SENSOR_BOARD_Rev6/docs/RFVD_SENSOR_BOARD.kicad_pcb from below]

Board: 6 copper layers, 47.0 x 90.0 mm, 409 parts (193 on the bottom side), 247 nets.

Parts:
C1, C33: 100nF; C_0603_1608Metric
C2: 47pF C0G 1% 100V; C_0603_1608Metric
C3, C4: 100pF; C_0402_1005Metric
C5, C23, C37, C44, C51, C59, C65, C103, C105, C106, C107, C301, C326: 1uF; C_0603_1608Metric
C6, C8, C321, C412: 1nF; C_0402_1005Metric
C7, C26, C29, C35, C40, C45, C46, C47, C48, C50, C53, C54, C55, C56, C57, C58, C61, C62, C64, C93, C104, C302, C305, C309, C318, C322, C323, C324, C401, C403, C404, C407, C408, C409, C410, C411, C603, C701, C702: 100nF; C_0402_1005Metric
C9, C11: 510p; C_0603_1608Metric
C10, C12, C17, C19: 470p; C_0603_1608Metric
C13, C15: 100n; C_0402_1005Metric
C14, C20: 1u; C_0603_1608Metric
C16, C18: 1.2n; C_0603_1608Metric
C21, C22: 1.5nF C0G 2% 50V; C_0402_1005Metric
C24: 1uF 25V film; C_1206_3216Metric
C25: 4.7uF; C_0805_2012Metric
C27: 22uF 25V polymer; CP_EIA-3528-21_Kemet-B
C28, C30, C38, C303, C304, C306, C307, C308, C313, C314, C315, C316, C317, C319, C320, C402, C406: 10uF; C_0805_2012Metric
C31: 10uF; C_1206_3216Metric
C32, C67, C70, C71, C205, C901, C902, C903, C904: 100nF 25V X7R; C_0402_1005Metric
C34: 470nF; C_1206_3216Metric
C36: 22uF; C_1206_3216Metric
C39, C42, C100: 22uF; C_0805_2012Metric
C41: 22pF; C_0402_1005Metric
C49, C52: 2.2uF; C_0603_1608Metric
C60: 10uF 16V X7R; C_0805_2012Metric
C63: 47uF POLY; CP_EIA-3528-21_Kemet-B
C66: 1uF 25V X7R; C_0603_1608Metric
C68: 47uF 10V POLY; CP_EIA-3528-21_Kemet-B
C69, C201: 100nF 25V; C_0402_1005Metric
C101, C102: 2.2nF C0G; C_0402_1005Metric
C200, C206: 1uF 25V; C_0603_1608Metric
C202, C203, C900: 47pF 50V C0G; C_0402_1005Metric
C204: DNP 47pF C0G; C_0402_1005Metric
C207: 100pF 50V C0G; C_0402_1005Metric
C300, C905, C906, C907: 1nF C0G 50V; C_0402_1005Metric
C310, C311, C405: 47nF; C_0402_1005Metric
C312, C327: 4.7uF; C_0603_1608Metric
C325: 330nF; C_0603_1608Metric
C601, C602: 10pF C0G; C_0402_1005Metric
C908, C909, C910: 100pF C0G 50V; C_0402_1005Metric
C911: 15pF C0G 50V; C_0402_1005Metric
D1, D300: PESD5V0H1BSF; PESD2V5Y1BSF_SOD962-2_ManufacturerLand
D3: GREEN LED; LED_0603_1608Metric
D4, D5, D6, D7, D8, D9, D10: 5V ESD 2pF; D_SOD-882
D12: PMEG6030EP; D_SOD-128
D201, D202, D203, D204: NSI45020A; D_SOD-123
D301: TPD1E10B06DYAR; D_SOD-523
D401, D402, D403, D404, D405, D406: TPD4E05U06DQAR; USON-10_2.5x1.0mm_P0.5mm
F1: MF-MSMF150/24X-2; Fuse_1812_4532Metric
F201: 200mA PTC; Fuse_0603_1608Metric
FB1: 600R@100MHz 500mA; L_0603_1608Metric
FB201: 600R@100MHz; L_0603_1608Metric
FL1: NFM18PC104R1C3D; Murata_NFM18PC_0603_3T
H1, H2, H3, H4: MountingHole_2.7mm
H5, H6: BSMTSOM250BTR; Standoff_SMT_M2_BZXC_BSMTSOM2_Hole3.8mm_Pad6.2mm
J1: AIMD_IN; U.FL_Hirose_U.FL-R-SMT-1_Vertical
J2: 2053380004; Molex_Pico-Lock_205338-0004_1x04-1MP_P2.00mm_Horizontal
J3: DM3AT-SF-PEJM5; microSD_HC_Hirose_DM3AT-SF-PEJM5
J4: XF2M-4015-1A; Omron_XF2M-4015-1A_1x40-1MP_P0.5mm_Horizontal
J6: TC2030-NL SWD POGO DNP; Tag-Connect_TC2030-IDC-NL_2x03_P1.27mm_Vertical
J8: 84953-6; TE_84953-6_1x06-1MP_P1.0mm_Horizontal
J10: TYPE-C-31-M-12; USB_C_Receptacle_HRO_TYPE-C-31-M-12
J11: LSHM-120-02.5-L-DV-A-N-K-TR; Samtec_LSHM-120-xx.x-x-DV-S_2x20-1SH_P0.50mm_Vertical
J300: CAL_IN; U.FL_Hirose_U.FL-R-SMT-1_Vertical
JP401, JP402: SJ open; SolderJumper-2_P1.3mm_Open_Pad1.0x1.5mm
L1: 4.7uH; L_Coilcraft_XAL4020-XXX
L301: 1uH; L_Coilcraft_XAL4020-XXX
Q201, Q303: AO3401A; SOT-23
Q202, Q302: 2N7002; SOT-23
Q203, Q301: AO3400A; SOT-23
R1, R2, R410: 1.50k; R_0402_1005Metric
R3, R4, R5, R6: 2.26k; R_0603_1608Metric
R7, R8, R9, R10: 1.33k; R_0603_1608Metric
R11, R12: 47R; R_0603_1608Metric
R13, R902, R907: 1R 1%; R_0402_1005Metric
R14: 49.9k; R_0603_1608Metric
R15, R19, R206, R801, R901: 1k 1%; R_0402_1005Metric
R16, R413: 33.2k; R_0402_1005Metric
R17: 14.3k; R_0402_1005Metric
R18, R20, R38, R203, R204, R205, R208, R210: 10k 1%; R_0402_1005Metric
R21, R24, R25, R41, R51, R52: 100k 0.1%; R_0603_1608Metric
R22: 20.0k 0.1%; R_0603_1608Metric
R23: 10k; R_0603_1608Metric
R26: 33R 1%; R_0402_1005Metric
R27, R28, R29, R36, R37: 47k 1%; R_0402_1005Metric
R30, R31, R32, R33, R34, R35, R39, R60, R61, R62, R63, R64, R65, R66, R67: 33R 1%; R_0603_1608Metric
R40, R44, R48, R49, R50: 10k 1%; R_0603_1608Metric
R42, R45: 4.7k 1%; R_0603_1608Metric
R43: 66.5k 1%; R_0603_1608Metric
R53, R54: 4.7k 1%; R_0402_1005Metric
R100, R101, R104, R105, R106, R107, R419, R420, R421, R423, R424, R433: 33R; R_0402_1005Metric
R102, R109: 1R; R_0402_1005Metric
R103, R313, R317, R318, R434: 100R; R_0402_1005Metric
R108, R310, R311, R312, R403, R416, R701: 10k; R_0402_1005Metric
R200, R201, R202, R405: 0R; R_0402_1005Metric
R207, R209, R322, R323, R324: 100k 1%; R_0402_1005Metric
R211: 100R 1%; R_0402_1005Metric
R300, R301: 100R; R_0603_1608Metric
R302: 3.32k; R_0402_1005Metric
R303, R304, R402, R407, R412, R414, R415, R436, R437, R438, R439, R440, R900: 100k; R_0402_1005Metric
R305: 6.04k; R_0402_1005Metric
R306: 51k; R_0402_1005Metric
R307: 20k; R_0402_1005Metric
R308, R320, R321: 5.23k; R_0402_1005Metric
R309: 30.1k; R_0402_1005Metric
R314: 0R; R_0805_2012Metric
R315: 160R; R_0402_1005Metric
R316: 261R; R_0402_1005Metric
R319, R408: 470k; R_0402_1005Metric
R401: 45.3k; R_0402_1005Metric
R404, R417, R418: 2.2k; R_0402_1005Metric
R406: 0R DNP; R_0402_1005Metric
R409: 73.2k; R_0402_1005Metric
R411: 1.5k; R_0603_1608Metric
R422, R435: 1k; R_0402_1005Metric
R425, R426, R427, R428, R429, R430, R431, R432: 330R; R_0402_1005Metric
R903: DNP; R_0603_1608Metric
R904, R905, R906: 330R 1%; R_0402_1005Metric
RN201, RN202, RN203: 47R x4; R_Array_Convex_4x0402
SW1: RECORD / STOP; SW_SPST_B3U-1000P
SW2: MARK; SW_SPST_B3U-1000P
SW3: RESET; SW_SPST_B3U-1000P
SW4: BOOT; SW_SPST_B3U-1000P
SW5: B3U-1000P; SW_SPST_B3U-1000P
TP1: VRMS_DIAG; TestPoint_Pad_D1.0mm
TP2: EREF_RAW; TestPoint_Pad_D1.0mm
TP3: VENV_RAW; TestPoint_Pad_D1.0mm
TP4: GND_ANALOG; TestPoint_Pad_D1.0mm
TP5: VENV_BUF; TestPoint_Pad_D1.0mm
TP8: +3V0_REF; TestPoint_Pad_D1.0mm
TP9: VSYS; TestPoint_Pad_D1.0mm
TP10: +5V_A; TestPoint_Pad_D1.0mm
TP11: +3V3_D; TestPoint_Pad_D1.0mm
TP12: +3V3_A; TestPoint_Pad_D1.0mm
TP13: GND_POWER; TestPoint_Pad_D1.0mm
TP16: GND_SERVICE; TestPoint_Pad_D1.0mm
TP20: EXTADC_REFIO; TestPoint_Pad_D1.0mm
TP301: CHG_STAT; TestPoint_Pad_D1.0mm
TP302: BAL_OVP; TestPoint_Pad_D1.0mm
TP303: VBAT_PACK; TestPoint_Pad_D1.0mm
TP304: POGO_VBUS; TestPoint_Pad_D2.0mm
TP305: POGO_D+; TestPoint_Pad_D2.0mm
TP306: POGO_D-; TestPoint_Pad_D2.0mm
TP307: POGO_GND; TestPoint_Pad_D2.0mm
TP308: BATT_MID; TestPoint_Pad_D1.0mm
TP900: BUCK_SYNC; TestPoint_Pad_D1.0mm
TP901, TP902, TP903: DISP_GND; TestPoint_Pad_3.0x3.0mm
U1: TLV809EA46DBZR; SOT-23-3
U2: ADL5511ACPZ-R7; LFCSP-16-1EP_3x3mm_P0.5mm_EP1.6x1.6mm
U3, U4: OPA2320; VSSOP-8_3x3mm_P0.65mm
U5: REF5030IDR; SOIC-8_3.9x4.9mm_P1.27mm
U6: LMR43620MB5RPER; TI_RPE0009B_VQFN-HR-9_2x2mm_Stencil
U7: LT3045EMSE#PBF (+5V_A); MSOP-12-1EP_3x4.039mm_P0.65mm_EP1.651x2.845mm
U8: STM32H743VIT6; LQFP-100_14x14mm_P0.5mm
U9: APS6404L-3SQR-SN; SOIC-8_3.9x4.9mm_P1.27mm
U10, U401: TPS2553DDBVR; SOT-23-6
U11: TMP117AIDRVR; TMP117_DRV_WSON6_NoPasteEP
U13: AD7380BCPZ-RL7; TQFN-16-1EP_3x3mm_P0.5mm_EP1.23x1.23mm
U301: BQ25798RQMR; Texas_RQM0029A_VQFN-29_4x4mm_P0.4mm
U302: BQ29209DRBR; VSON-8-1EP_3x3mm_P0.65mm_EP1.65x2.4mm
U303: TPS70933DBVR; SOT-23-5
U304: TPD4E05U06DQAR; USON-10_2.5x1.0mm_P0.5mm
U402: TPS259631DDAR; TI_SO-PowerPAD-8_ThermalVias
U403: TCA9517ADGKR; VSSOP-8_3x3mm_P0.65mm
U701: SHT40-AD1B-R2; Sensirion_DFN-4_1.5x1.5mm_P0.8mm_SHT4x_NoCentralPad
U702: OPT3004DNPR; TI_DNP0006A_USON-6-1EP_2x2mm_P0.65mm_EP0.65x1.35mm
Y1: 12MHz 3.3V CMOS; Oscillator_SMD_Abracon_ASE-4Pin_3.2x2.5mm
Y2: 32.768kHz 7pF; Crystal_SMD_Abracon_ABS05-2Pin_1.6x1.0mm

Connections:
+3V0_REF: C26.1, C56.1, C59.1, D12.2 (A), R13.1, R107.1, TP8.1 (1_1), U5.6 (Vout), U8.20 (VREF+)
+3V3_A: C13.1, C14.1, C15.1, C20.1, C44.1, C45.1, C48.1, C51.1, C105.1, D12.1 (K), FB1.2, R109.1, TP12.1 (1_1), U3.8 (V+), U4.8 (V+), U8.21 (VDDA), U13.4 (VCC)
+3V3_D: C39.1, C41.2, C42.1, C47.1, C50.1, C53.1, C54.1, C55.1, C58.1, C60.1, C64.1, C65.1, C66.1, C71.1, C93.1, C401.1, C409.1, C701.1, C702.1, C903.1, FB1.1, J6.1 (VCC), L1.2, R16.1, R18.1, R27.1, R28.1, R29.1, R36.1, R37.1, R38.1, R40.1, R44.1, R48.1, R49.1, R53.2, R54.2, R102.1, R108.1, R311.1, R403.1, R439.1, R701.2, R801.1, R900.2, R907.1, TP11.1 (1_1), U8.11 (VDD), U8.27 (VDD), U8.50 (VDD), U8.75 (VDD), U8.100 (VDD), U9.8 (VDD), U10.1 (IN), U11.5 (V+), U401.1 (IN), U403.1 (VCCA), U701.3 (VDD), U702.1 (VDD), U702.2 (ADDR), Y1.1 (EN), Y1.4 (Vdd)
+3V3_EXP: C402.1, C403.1, C410.1, J11.3, J11.4, J11.37, J11.38, R404.1, R414.1, R416.1, R417.1, R418.1, R436.1, R437.1, U401.6 (OUT), U403.8 (VCCB)
+3V3_UI: C68.1, C69.1, C200.2, C201.2, C205.1, J4.7, J4.8, J8.1, R42.1, R45.1, R50.1, R200.1, R203.1, R204.1, R205.1, R208.1, U10.6 (OUT)
+5V_A: C23.1, C36.1, C38.1, C40.1, C902.1, FL1.1, R24.1, TP10.1 (1_1), U5.2 (Vin), U7.10 (OUTS), U7.11 (OUT), U7.12 (OUT)
/Battery and power/A3V3_DAMP: C100.1, R109.2
/Battery and power/BUCK_VCC: C37.1, U6.7 (VCC)
/Battery and power/LT5_ILIM: R15.1, U7.6 (ILIM)
/Battery and power/VSYS_LDO: C29.1, C31.1, R902.2, U7.1 (IN), U7.2 (IN), U7.3 (IN), U7.7 (PGFB)
/Battery, charger and USB-C/BAL_OVP: R324.1, TP302.1 (1_1), U302.8 (OUT)
/Battery, charger and USB-C/BATP: R313.2, U301.18 (BATP)
/Battery, charger and USB-C/BATT_MID: J2.2, R316.1, R317.1, TP308.1 (1_1)
/Battery, charger and USB-C/BATT_NTC: C905.1, J2.4, R308.2, R309.1, R310.1, U301.16 (TS)
/Battery, charger and USB-C/B_VC1: C322.2, C323.1, R316.2, U302.2 (VC1)
/Battery, charger and USB-C/B_VC2: C322.1, R315.2, U302.1 (VC2)
/Battery, charger and USB-C/B_VCB: R317.2, U302.3 (VC1_CB)
/Battery, charger and USB-C/B_VDD: C324.1, R318.2, R319.1, U302.7 (VDD)
/Battery, charger and USB-C/CC1: J10.A5 (CC1), R320.1, U304.4 (D2+)
/Battery, charger and USB-C/CC2: J10.B5 (CC2), R321.1, U304.5 (D2-)
/Battery, charger and USB-C/CHG_BAT: C319.1, C320.1, Q301.2 (S), R314.1, U301.22 (BAT), U301.23 (BAT)
/Battery, charger and USB-C/CHG_LED_A: D3.2 (A), R19.2
/Battery, charger and USB-C/CHG_STAT: D3.1 (K), R312.2, TP301.1 (1_1), U301.1 (STAT)
/Battery, charger and USB-C/ILIM_HIZ: R306.2, R307.1, U301.17 (ILIM_HIZ)
/Battery, charger and USB-C/PACK_FUSED: F1.1, Q303.3 (D)
/Battery, charger and USB-C/PROG: R305.1, U301.20 (PROG)
/Battery, charger and USB-C/QON_N: SW5.2, U301.12 (~QON)
/Battery, charger and USB-C/REGN: C312.1, R19.1, R306.1, R308.1, R312.1, U301.5 (REGN)
/Battery, charger and USB-C/SDRV: C321.1, Q301.1 (G), U301.24 (SDRV)
/Expansion mezzanine/EXP_ANA_MON: D406.5 (D2-), J11.34, R435.2
/Expansion mezzanine/EXP_DETECT_N: D405.1 (D1+), J11.32, R432.2, R439.2
/Expansion mezzanine/EXP_GATE: D403.1 (D1+), J11.33, R433.2
/Expansion mezzanine/EXP_I2C_SCL: D402.2 (D1-), J11.25, R417.2, U403.7 (SCLB)
/Expansion mezzanine/EXP_I2C_SDA: D402.4 (D2+), J11.27, R418.2, U403.6 (SDAB)
/Expansion mezzanine/EXP_INT0_N: D404.1 (D1+), J11.14, R426.2
/Expansion mezzanine/EXP_INT1_N: D405.5 (D2-), J11.16, R428.2
/Expansion mezzanine/EXP_IO0: D405.4 (D2+), J11.26, R429.2
/Expansion mezzanine/EXP_IO1: D405.2 (D1-), J11.28, R430.2
/Expansion mezzanine/EXP_RST_N: D402.5 (D2-), J11.31, R431.2, R438.2
/Expansion mezzanine/EXP_SPI_CS0_N: D401.5 (D2-), J11.13, R425.2, R436.2
/Expansion mezzanine/EXP_SPI_CS1_N: D402.1 (D1+), J11.15, R427.2, R437.2
/Expansion mezzanine/EXP_SPI_MISO: D401.4 (D2+), J11.9, R423.2
/Expansion mezzanine/EXP_SPI_MOSI: D401.2 (D1-), J11.7, R421.2
/Expansion mezzanine/EXP_SPI_SCK: D401.1 (D1+), J11.5, R419.2
/Expansion mezzanine/EXP_SYNC: D403.2 (D1-), J11.35, R434.2, R440.2
/Expansion mezzanine/EXP_TMR0: D404.5 (D2-), J11.6, R420.2
/Expansion mezzanine/EXP_TMR1: D404.2 (D1-), J11.10, R424.2
/Expansion mezzanine/EXP_TMR_IN: D404.4 (D2+), J11.8, R422.2
/Expansion mezzanine/EXP_VHP_IN: C404.1, R405.2, R406.2, R408.1, U402.4 (VIN)
/Expansion mezzanine/EXP_VHP_OVLO: R408.2, R409.1, U402.8 (OVLO/OVCSEL)
/External ADC/ADC_AIN_EREF: C101.1, R101.2, U13.6 (AINB+/AINB0), U13.7 (AINA-/AINA1)
/External ADC/ADC_AIN_VENV: C102.1, R100.2, U13.5 (AINB-/AINB1)
/External ADC/ADC_CS_N_U13: R106.2, U13.12 (~CS)
/External ADC/ADC_REFCAP: C104.1, U13.9 (REFCAP)
/External ADC/ADC_REFIO: C103.1, R107.2, TP20.1 (1_1), U13.11 (REFIO)
/External ADC/ADC_SCLK_U13: R104.2, U13.16 (SCLK)
/External ADC/ADC_SDI_U13: R105.2, U13.15 (SDI)
/External ADC/ADC_SDOA_U13: R103.1, U13.13 (SDOA)
/External ADC/ADC_VLOGIC: C107.1, R102.2, U13.2 (VLOGIC)
/RF input and detector/+5V_RF: C1.1, C3.1, C5.1, C6.2, C7.2, C8.2, C901.1, FL1.3, U1.3 (VDD), U2.15 (VPOS)
/RF input and detector/CAL_IN: C300.1, D300.1 (A1), J300.1 (In), R300.1, R301.1
/RF input and detector/CAL_INJ: C300.2, R302.1
/RF input and detector/RFIN: C2.2, D1.1 (A1), R302.2, U2.2 (RFIN)
/RF input and detector/VRMS_DIAG: TP1.1 (1_1), U2.11 (VRMS)
/SD and capture memory/+3V3_SD: C62.1, C63.1, J3.4 (VDD), R907.2
/SD and capture memory/PSRAM_IO0: R60.2, R61.1
/SD and capture memory/PSRAM_IO0_RAM: R61.2, U9.5 (SI/SIO0)
/SD and capture memory/PSRAM_IO1: R62.2, R63.1
/SD and capture memory/PSRAM_IO1_RAM: R63.2, U9.2 (SO/SIO1)
/SD and capture memory/PSRAM_IO2: R64.2, R65.1
/SD and capture memory/PSRAM_IO2_RAM: R65.2, U9.3 (SIO2)
/SD and capture memory/PSRAM_IO3: R66.2, R67.1
/SD and capture memory/PSRAM_IO3_RAM: R67.2, U9.7 (SIO3)
/SD and capture memory/SD_CLK: C911.1, D7.1 (K), J3.5 (CLK), R33.2
/SD and capture memory/SD_CMD: D6.1 (K), J3.3 (CMD), R29.2, R32.2
/SD and capture memory/SD_D0: D8.1 (K), J3.7 (DAT0), R34.2, R36.2
/SD and capture memory/SD_D1: D9.1 (K), J3.8 (DAT1), R35.2, R37.2
/SD and capture memory/SD_D2: D4.1 (K), J3.1 (DAT2), R27.2, R30.2
/SD and capture memory/SD_D3: D5.1 (K), J3.2 (DAT3/CD), R28.2, R31.2
/STM32H743 controller/BUCK_SYNC_MCU: R901.1, U8.35 (PB1)
/STM32H743 controller/LCD_RST_MCU: C909.1, R904.1, U8.24 (PA2)
/STM32H743 controller/TP_INT_MCU: C908.1, R906.1, U8.31 (PA7)
/STM32H743 controller/TP_RST_MCU: C910.1, R905.1, U8.25 (PA3)
/STM32H743 controller/VCAP: C49.1, C52.1, U8.48 (VCAP), U8.73 (VCAP)
/Screen and controls/LCD_BL_SW: D201.1 (K), D202.1 (K), D203.1 (K), D204.1 (K), Q203.3 (D)
/Screen and controls/LCD_CS_N: C203.1, J4.10, R50.2, RN203.6 (R3.2)
/Screen and controls/LCD_D0: J4.22, RN201.8 (R1.2)
/Screen and controls/LCD_D1: J4.23, RN201.7 (R2.2)
/Screen and controls/LCD_D2: J4.24, RN201.6 (R3.2)
/Screen and controls/LCD_D3: J4.25, RN201.5 (R4.2)
/Screen and controls/LCD_D4: J4.26, RN202.8 (R1.2)
/Screen and controls/LCD_D5: J4.27, RN202.7 (R2.2)
/Screen and controls/LCD_D6: J4.28, RN202.6 (R3.2)
/Screen and controls/LCD_D7: J4.29, RN202.5 (R4.2)
/Screen and controls/LCD_DC: J4.11, RN203.5 (R4.2)
/Screen and controls/LCD_IM0: J4.31, R200.2
/Screen and controls/LCD_IM1: J4.32, R201.1
/Screen and controls/LCD_IM2: J4.33, R202.1
/Screen and controls/LCD_LED_A: C206.1, C207.1, FB201.2, J4.38
/Screen and controls/LCD_LED_K1: D201.2 (A), J4.34
/Screen and controls/LCD_LED_K2: D202.2 (A), J4.35
/Screen and controls/LCD_LED_K3: D203.2 (A), J4.36
/Screen and controls/LCD_LED_K4: D204.2 (A), J4.37
/Screen and controls/LCD_RD_N: C204.1, J4.13, R204.2, RN203.7 (R2.2)
/Screen and controls/LCD_TE: J4.40, R206.2
/Screen and controls/LCD_WR_N: C202.1, J4.12, R203.2, RN203.8 (R1.2)
ADC_EREF: C21.1, R11.2, U8.32 (PC4)
ADC_VENV: C22.1, R12.2, U8.30 (PA6)
BOOT0: R20.1, SW4.1, U8.94 (BOOT0)
BUCK_SYNC: C900.1, R900.1, R901.2, TP900.1 (1_1), U6.1 (MODE_SYNC)
CHG_CE: R323.1, R324.2, U301.13 (~CE)
CHG_INT_N: C907.1, R311.2, U8.22 (PA0), U301.21 (~INT)
EREF_BUF: C16.2, R11.1, R101.1, U3.6 (-), U3.7 (OUT)
EREF_RAW: R3.1, TP2.1 (1_1), U2.9 (EREF)
EXP_3V3_EN: JP401.2 (B), R402.1, U8.45 (PE15), U401.3 (EN)
EXP_3V3_SNS: C408.1, R414.2, R415.1, U8.18 (PC3_C)
EXP_ANA_MON_MCU: C412.1, R435.1, U8.28 (PA4)
EXP_CS0_N_MCU: R425.1, U8.51 (PB12)
EXP_CS1_N_MCU: R427.1, U8.55 (PD8)
EXP_DETECT_N_MCU: R432.1, U8.90 (PB4)
EXP_FAULT_N: R403.2, U8.87 (PD6), U401.4 (~FAULT), U402.6 (~FLT)
EXP_GATE_MCU: R433.1, U8.29 (PA5)
EXP_INT0_N_MCU: R426.1, U8.56 (PD9)
EXP_INT1_N_MCU: R428.1, U8.57 (PD10)
EXP_IO0_MCU: R429.1, U8.98 (PE1)
EXP_IO1_MCU: R430.1, U8.97 (PE0)
EXP_MISO_MCU: R423.1, U8.53 (PB14)
EXP_MOSI_MCU: R421.1, U8.54 (PB15)
EXP_RST_N_MCU: R431.1, U8.91 (PB5)
EXP_SCK_MCU: R419.1, U8.52 (PB13)
EXP_SYNC_MCU: R434.1, U8.93 (PB7)
EXP_TMR0_MCU: R420.1, U8.67 (PA8)
EXP_TMR1_MCU: R424.1, U8.64 (PC7)
EXP_TMR_IN_MCU: R422.1, U8.77 (PA15)
EXP_VHP: C406.1, J11.19, J11.20, J11.21, J11.22, R411.1, R412.1, U402.5 (OUT)
EXP_VHP_EN: JP402.2 (B), R407.1, U8.13 (PH1), U402.3 (EN/UVLO)
EXP_VHP_SNS: C407.1, R412.2, R413.1, U8.17 (PC2_C)
EXTADC_CS_N: R106.1, R108.2, U8.41 (PE11)
EXTADC_SCLK: R104.1, U8.42 (PE12)
EXTADC_SDI: R105.1, U8.43 (PE13)
EXTADC_SDOA: R103.2, U8.44 (PE14)
GND: C1.2, C3.2, C4.2, C5.2, C10.2, C12.2, C13.2, C14.2, C15.2, C17.2, C19.2, C20.2, C21.2, C22.2, C23.2, C24.2, C25.2, C26.2, C27.2, C28.2, C29.2, C30.2, C31.2, C32.2, C33.2, C34.2, C36.2, C37.2, C38.2, C39.2, C40.2, C42.2, C44.2, C45.2, C46.2, C47.2, C48.2, C49.2, C50.2, C51.2, C52.2, C53.2, C54.2, C55.2, C56.2, C57.2, C58.2, C59.2, C60.2, C61.2, C62.2, C63.2, C64.2, C65.2, C66.2, C67.2, C68.2, C69.2, C70.2, C71.2, C93.2, C100.2, C101.2, C102.2, C103.2, C104.2, C105.2, C106.2, C107.2, C200.1, C201.1, C202.2, C203.2, C204.2, C205.2, C206.2, C207.2, C301.2, C302.1, C303.2, C304.2, C305.2, C306.2, C307.2, C308.2, C309.2, C312.2, C313.2, C314.2, C315.2, C316.2, C317.2, C318.2, C319.2, C320.2, C321.2, C323.2, C324.2, C325.2, C326.2, C327.2, C401.2, C402.2, C403.2, C404.2, C405.2, C406.2, C407.2, C408.2, C409.2, C410.2, C411.2, C412.2, C601.2, C602.2, C603.2, C701.2, C702.2, C900.2, C901.2, C902.2, C903.2, C904.2, C905.2, C906.2, C907.2, C908.2, C909.2, C910.2, C911.2, D1.2 (A2), D4.2 (A), D5.2 (A), D6.2 (A), D7.2 (A), D8.2 (A), D9.2 (A), D10.2 (A), D300.2 (A2), D301.1 (A1), D401.3 (GND), D401.8 (GND), D402.3 (GND), D402.8 (GND), D403.3 (GND), D403.8 (GND), D404.3 (GND), D404.8 (GND), D405.3 (GND), D405.8 (GND), D406.3 (GND), D406.8 (GND), FL1.2, H5.1 (1_1), H6.1 (1_1), J1.2 (Ext), J2.3, J2.MP (MountPin), J3.6 (VSS), J3.10 (DET_A), J3.SH (SHIELD), J4.1, J4.9, J4.14, J4.15, J4.16, J4.17, J4.18, J4.19, J4.20, J4.21, J4.39, J4.MP (MountPin), J6.5 (GND), J8.2, J8.MP (MountPin), J10.A1 (GND), J10.A12 (GND), J10.B1 (GND), J10.B12 (GND), J10.SH (SHIELD), J11.1, J11.2, J11.11, J11.12, J11.17, J11.18, J11.23, J11.24, J11.29, J11.30, J11.39, J11.40, J11.SH (Shield), J300.2 (Ext), JP401.1 (A), JP402.1 (A), Q202.2 (S), Q203.2 (S), Q302.2 (S), R14.2, R15.2, R17.1, R20.2, R22.2, R25.2, R41.2, R43.2, R51.2, R52.2, R201.2, R202.2, R205.2, R207.2, R300.2, R301.2, R304.1, R305.2, R307.2, R309.2, R310.2, R320.2, R321.2, R322.2, R323.2, R401.2, R402.2, R404.2, R407.2, R409.2, R410.2, R411.2, R413.2, R415.2, R438.1, R440.1, R903.2, SW1.2, SW2.2, SW3.2, SW5.1, TP4.1 (1_1), TP13.1 (1_1), TP16.1 (1_1), TP307.1 (1_1), TP901.1 (1_1), TP902.1 (1_1), TP903.1 (1_1), U1.1 (GND), U2.5 (COMM), U2.17 (EP), U3.4 (V-), U4.4 (V-), U5.4 (GND), U6.9 (GND), U7.9 (GND), U7.13 (GND), U8.10 (VSS), U8.19 (VSSA), U8.26 (VSS), U8.49 (VSS), U8.74 (VSS), U8.99 (VSS), U9.4 (VSS), U10.2 (GND), U11.2 (GND), U11.4 (ADD0), U13.1 (GND), U13.8 (AINA+/AINA0), U13.10 (GND), U13.17 (EP), U301.10 (ACDRV2), U301.11 (ACDRV1), U301.27 (GND), U302.5 (GND), U302.9 (PAD), U303.2 (GND), U304.3 (GND), U304.8 (GND), U401.2 (GND), U402.1 (GND), U402.9 (GND), U403.4 (GND), U701.4 (VSS), U702.3 (GND), U702.7 (EP), Y1.2 (GND)
I2C_SCL: R53.1, U8.95 (PB8), U11.1 (SCL), U301.14 (SCL), U403.2 (SCLA), U701.2 (SCL), U702.4 (SCL)
I2C_SDA: R54.1, U8.96 (PB9), U11.6 (SDA), U301.15 (SDA), U403.3 (SDAA), U701.1 (SDA), U702.6 (SDA)
LCD_BL: R211.1, U8.63 (PC6)
LCD_CS_N_MCU: RN203.3 (R3.1), U8.88 (PD7)
LCD_D0_MCU: RN201.1 (R1.1), U8.61 (PD14)
LCD_D1_MCU: RN201.2 (R2.1), U8.62 (PD15)
LCD_D2_MCU: RN201.3 (R3.1), U8.81 (PD0)
LCD_D3_MCU: RN201.4 (R4.1), U8.82 (PD1)
LCD_D4_MCU: RN202.1 (R1.1), U8.37 (PE7)
LCD_D5_MCU: RN202.2 (R2.1), U8.38 (PE8)
LCD_D6_MCU: RN202.3 (R3.1), U8.39 (PE9)
LCD_D7_MCU: RN202.4 (R4.1), U8.40 (PE10)
LCD_DC_MCU: RN203.4 (R4.1), U8.5 (PE6)
LCD_RD_N_MCU: RN203.2 (R2.1), U8.85 (PD4)
LCD_RST: J4.30, R51.1, R904.2
LCD_TE_MCU: R206.1, R207.1, U8.23 (PA1)
LCD_WR_N_MCU: RN203.1 (R1.1), U8.86 (PD5)
LID_INT: C906.1, R701.1, U8.84 (PD3), U702.5 (INT)
MARK_N: C70.1, R49.2, SW2.1, U8.3 (PE4)
NRST: C46.1, J6.3 (~RESET), R18.2, SW3.1, U8.14 (NRST)
unnamed: C2.1, R2.2
unnamed: C9.1, R3.2, R5.1
unnamed: C11.1, R4.2, R6.1
unnamed: C16.1, R7.2, R9.1
unnamed: C18.1, R8.2, R10.1
unnamed: C25.1, R13.2
unnamed: J1.1 (In), R1.2, R903.1
unnamed: F1.2, J2.1
unnamed: FB201.1, Q201.3 (D)
unnamed: Q201.1 (G), R209.2, R210.1
unnamed: F201.2, Q201.2 (S), R209.1
unnamed: Q202.3 (D), R210.2
unnamed: Q203.1 (G), R52.1, R211.2
unnamed: Q302.3 (D), R319.2, U302.6 (~CB_EN)
unnamed: Q303.1 (G), R322.1
unnamed: R1.1, R2.1
unnamed: R21.2, R22.1, R23.1
unnamed: R801.2, SW4.2
unnamed: U1.2 (RESET_n), U2.4 (ENBL)
unnamed: C4.1, U2.3 (FLT1)
unnamed: C6.1, U2.16 (FLT2)
unnamed: C8.1, U2.1 (FLT3)
unnamed: C7.1, U2.14 (FLT4)
unnamed: C10.1, R5.2, U3.3 (+)
unnamed: C9.2, R7.1, U3.1 (OUT), U3.2 (-)
unnamed: C17.1, R9.2, U3.5 (+)
unnamed: C12.1, R6.2, U4.3 (+)
unnamed: C11.2, R8.1, U4.1 (OUT), U4.2 (-)
unnamed: C19.1, R10.2, U4.5 (+)
unnamed: C24.1, U5.5 (Trim/NR)
unnamed: C35.1, U6.6 (BOOT)
unnamed: C35.2, L1.1, U6.5 (SW)
unnamed: C41.1, R16.2, R17.2, U6.8 (VOUT_FB)
unnamed: C34.1, R14.1, U7.8 (SET)
unnamed: C57.1, R23.2, U8.15 (PC0)
unnamed: C61.1, R24.2, R25.1, U8.16 (PC1)
unnamed: C601.1, U8.8 (PC14), Y2.2
unnamed: C602.1, U8.9 (PC15), Y2.1
unnamed: R26.2, U8.12 (PH0)
unnamed: R39.2, U9.6 (SCLK)
unnamed: R43.1, U10.5 (ILIM)
unnamed: C106.1, U13.3 (REGCAP)
unnamed: C310.1, U301.4 (BTST1)
unnamed: C311.1, U301.19 (BTST2)
unnamed: C306.1, C307.1, C308.1, C309.1, U301.29 (PMID)
unnamed: C310.2, L301.1, U301.28 (SW1)
unnamed: C311.2, L301.2, U301.26 (SW2)
unnamed: C325.1, U302.4 (CD)
unnamed: R401.1, U401.5 (ILIM)
unnamed: R410.1, U402.7 (ILM)
unnamed: C405.1, U402.2 (dV/dT)
unnamed: C411.1, R416.2, U403.5 (EN)
unnamed: R26.1, Y1.3 (OUT)
PSRAM_CLK_MCU: R39.1, U8.36 (PB2)
PSRAM_CS_N: R40.2, U8.92 (PB6), U9.1 (~CE)
PSRAM_IO0_MCU: R60.1, U8.58 (PD11)
PSRAM_IO1_MCU: R62.1, U8.59 (PD12)
PSRAM_IO2_MCU: R64.1, U8.1 (PE2)
PSRAM_IO3_MCU: R66.1, U8.60 (PD13)
RECORD_N: C67.1, R44.2, SW1.1, U8.2 (PE3)
SD_CD_N: D10.1 (K), J3.9 (DET_B), R38.2, U8.4 (PE5)
SD_CLK_MCU: R33.1, U8.80 (PC12)
SD_CMD_MCU: R32.1, U8.83 (PD2)
SD_D0_MCU: R34.1, U8.65 (PC8)
SD_D1_MCU: R35.1, U8.66 (PC9)
SD_D2_MCU: R30.1, U8.78 (PC10)
SD_D3_MCU: R31.1, U8.79 (PC11)
SWCLK: J6.4 (SWCLK), U8.76 (PA14)
SWDIO: J6.2 (SWDIO), U8.72 (PA13)
SWO: J6.6 (SWO), U8.89 (PB3)
TP_INT: J8.5, R208.2, R906.2
TP_RST: J8.6, R905.2
TP_SCL: J8.3, R45.2, U8.46 (PB10)
TP_SDA: J8.4, R42.2, U8.47 (PB11)
UI_EN: Q202.1 (G), R41.1, U8.33 (PC5), U10.3 (EN)
UI_FAULT_N: R48.2, U8.34 (PB0), U10.4 (~FAULT)
USB_DM: J10.A7 (D-), J10.B7 (D-), TP306.1 (1_1), U8.70 (PA11), U301.7 (D-), U304.2 (D1-)
USB_DP: J10.A6 (D+), J10.B6 (D+), TP305.1 (1_1), U8.71 (PA12), U301.6 (D+), U304.1 (D1+)
VBAT_PACK: C326.1, C904.1, Q301.3 (D), Q303.2 (S), R313.1, R314.2, R315.1, R318.1, TP303.1 (1_1), U303.1 (IN)
VBAT_RTC: C327.1, C603.1, U8.6 (VBAT), U303.5 (OUT)
VBUS: C301.1, C303.1, C304.1, C305.1, D301.2 (A2), J10.A4 (VBUS), J10.A9 (VBUS), J10.B4 (VBUS), J10.B9 (VBUS), Q302.1 (G), R303.2, R406.1, TP304.1 (1_1), U301.2 (VBUS), U301.3 (VBUS), U301.8 (VAC2), U301.9 (VAC1)
VBUS_DET: C302.2, R303.1, R304.2, U8.7 (PC13)
VENV_BUF: C18.2, R12.1, R100.1, TP5.1 (1_1), U4.6 (-), U4.7 (OUT)
VENV_RAW: R4.1, TP3.1 (1_1), U2.10 (VENV)
VSYS: C27.1, C28.1, C30.1, C32.1, C33.1, C313.1, C314.1, C315.1, C316.1, C317.1, C318.1, F201.1, R21.1, R405.1, R902.1, TP9.1 (1_1), U6.3 (EN_UVLO), U6.4 (VIN), U7.4 (EN/UV), U301.25 (SYS)
