Able-Digital-Logic/UnintendedAntennaClub3/Software/Core/Src/main.c

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
/* Includes ------------------------------------------------------------------*/
#include "main.h"

/* USER CODE BEGIN Includes */
#include "fonts.h"
#include "z_displ_ST7735.h"
#include "z_displ_ST7735_test.h"
#include "ui.h"
/* USER CODE END Includes */

/* USER CODE BEGIN PD */
#define BTN_A_READ() HAL_GPIO_ReadPin (GPIOA, GPIO_PIN_6)
#define BTN_B_READ() HAL_GPIO_ReadPin (GPIOA, GPIO_PIN_15)
#define BTN_C_READ() HAL_GPIO_ReadPin (GPIOB, GPIO_PIN_2)

/* Active-LOW buttons (pulled high, pressed = GPIO_PIN_RESET)?
 * Flip the comparison:  == GPIO_PIN_RESET  →  pressed           */
#define BTN_ACTIVE_STATE   GPIO_PIN_SET   /* change to RESET if needed */

/* UI tick interval in milliseconds */
#define UI_TICK_MS   20u

/* USER CODE END PD */

SPI_HandleTypeDef hspi1;
SPI_HandleTypeDef hspi3;

void SystemClock_Config(void);
static void MX_GPIO_Init(void);
static void MX_SPI1_Init(void);
static void MX_SPI3_Init(void);
/* USER CODE BEGIN PFP */
static uint8_t Read_Buttons(void);
/* USER CODE END PFP */

/**
  * @brief  The application entry point.
  * @retval int
  */
int main(void)
{

  /* MCU Configuration--------------------------------------------------------*/

  /* Reset of all peripherals, Initializes the Flash interface and the Systick. */
  HAL_Init();

  /* Configure the system clock */
  SystemClock_Config();

  /* Initialize all configured peripherals */
  MX_GPIO_Init();
  MX_SPI1_Init();
  MX_SPI3_Init();
  /* USER CODE BEGIN 2 */
  //Display Code from https://github.com/maudeve-it/ST7735S-STM32/tree/main
  Displ_Init(Displ_Orientat_0);		// initialize the display and set the initial display orientation (here is orientaton: 0°) - THIS FUNCTION MUST PRECEED ANY OTHER DISPLAY FUNCTION CALL.
  Displ_CLS(BLACK);			// after initialization (above) and before turning on backlight (below), you can draw the initial display appearance. (here I'm just clearing display with a black background)
  Displ_BackLight('1');  			// initialize backlight and turn it on at init level

  UI_Init();
  /* USER CODE END 2 */

  /* Infinite loop */
  /* USER CODE BEGIN WHILE */
  uint32_t lastTick = HAL_GetTick();
  while (1)
  {
    /* USER CODE END WHILE */

    /* USER CODE BEGIN 3 */
      uint32_t now = HAL_GetTick();

      if ((now - lastTick) >= UI_TICK_MS)
      {
          lastTick = now;

          /* Read buttons and let the UI state-machine decide what to do */
          uint8_t buttons = Read_Buttons();
          UI_Update(buttons);

          /* ── Add other periodic tasks here ──────────────────────
           * e.g. ADC sampling, SD-card writes, LED heartbeat, etc.
           * ──────────────────────────────────────────────────────── */
      }
  }
  /* USER CODE END 3 */
}

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
/* USER CODE BEGIN 4 */
static uint8_t Read_Buttons(void)
{
    uint8_t mask = BTN_NONE;

    if (BTN_A_READ() == BTN_ACTIVE_STATE) mask |= BTN_A;
    if (BTN_B_READ() == BTN_ACTIVE_STATE) mask |= BTN_B;
    if (BTN_C_READ() == BTN_ACTIVE_STATE) mask |= BTN_C;

    return mask;
}
/* USER CODE END 4 */
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
