Able-Digital-Logic/UnintendedAntennaClub3/(commit log)

2026-09-06 PCB Upload
    [031-5539.igs, ASE.STEP, Analog_Acquisition.kicad_sch, D1_SOD962_DIMENSIONAL_ENVELOPE.step, Display.kicad_sch, F1_MF_MSMF110_16_DIMENSIONAL_ENVELOPE.step, FUSE_MF-MSMF11016_BRN.step, J7_031_5539_CONSERVATIVE_ENVELOPE.step]
2026-09-11 (Ongoing)Rev2 New EMC Layout
    [Analog_Acquisition.kicad_sch, Display.kicad_sch, MCU.kicad_sch, Power.kicad_sch, RFVD_SENSOR_BOARD.kicad_pcb, RFVD_SENSOR_BOARD.kicad_sch, RFVD_SENSOR_BOARD_Prev.kicad_pcb, RF_Input.kicad_sch]
2026-09-24 Rev3 Commit - EMC Design
    [Analog_Acquisition.kicad_sch, Display.kicad_sch, MCU.kicad_sch, Power.kicad_sch, RFVD_SENSOR_BOARD.kicad_pcb, RFVD_SENSOR_BOARD.kicad_sch, RFVD_SENSOR_BOARD_Prev.kicad_pcb, RF_Input.kicad_sch]
2026-10-05 Rev4 Initital Commit
    [Analog_Acquisition.kicad_sch, Display.kicad_sch, Expansion.kicad_sch, External_ADC.kicad_sch, MCU.kicad_sch, Power.kicad_sch, Power_USB.kicad_sch, RFVD_BOM_grouped.csv]
